MolecularNeurobiology/LOOPER/doc/source/Images/1_Frame/1_rod_holder_ex.png

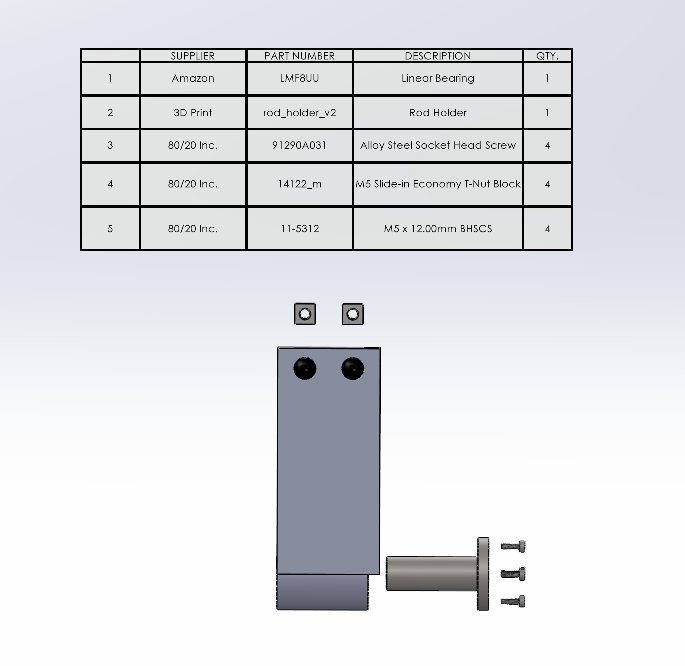
doc/source/Images/1_Frame/1_rod_holder_ex.png
