MolecularNeurobiology/LOOPER/doc/source/Images/1_Frame/2_28IN.png

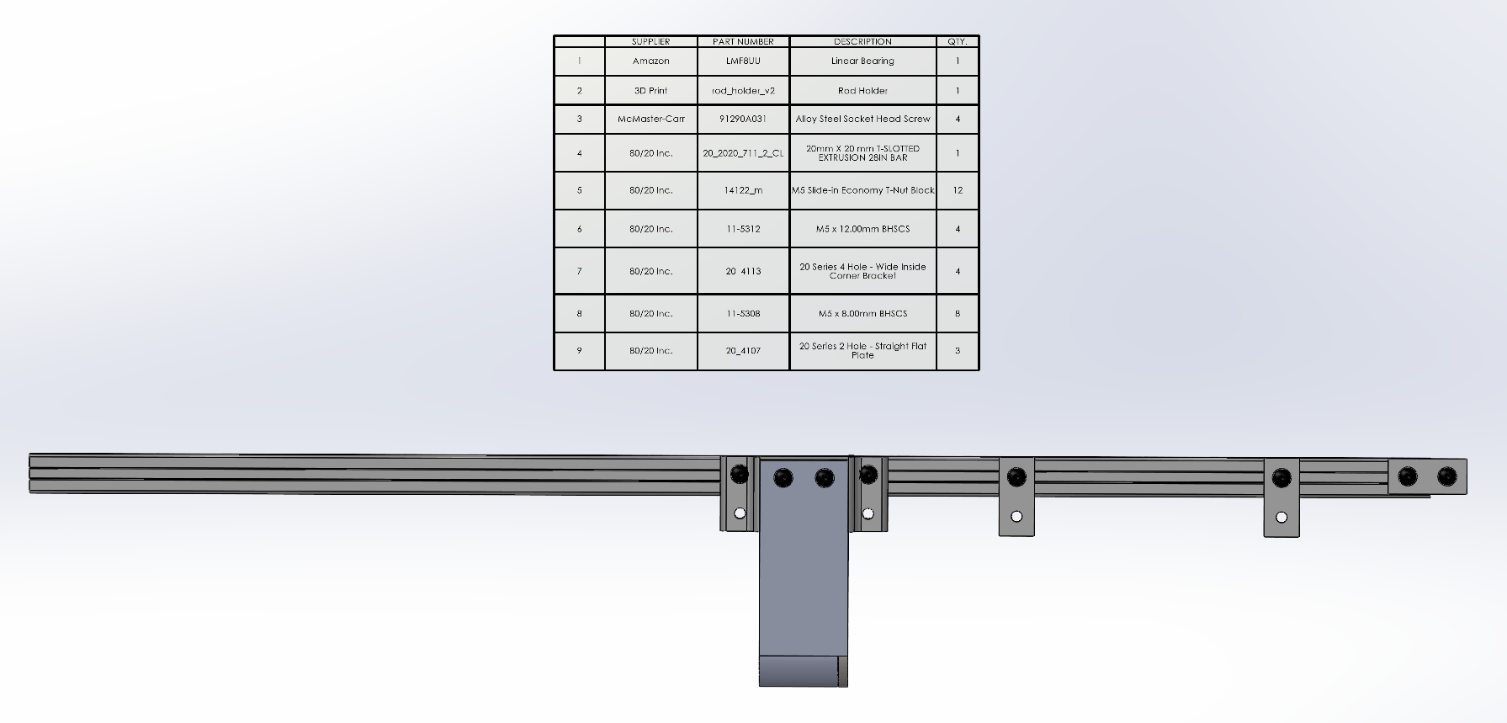
doc/source/Images/1_Frame/2_28IN.png
