MolecularNeurobiology/LOOPER/doc/source/Images/1_Frame/3_Completed_Rig_Technical_Drawing_14IN.PNG

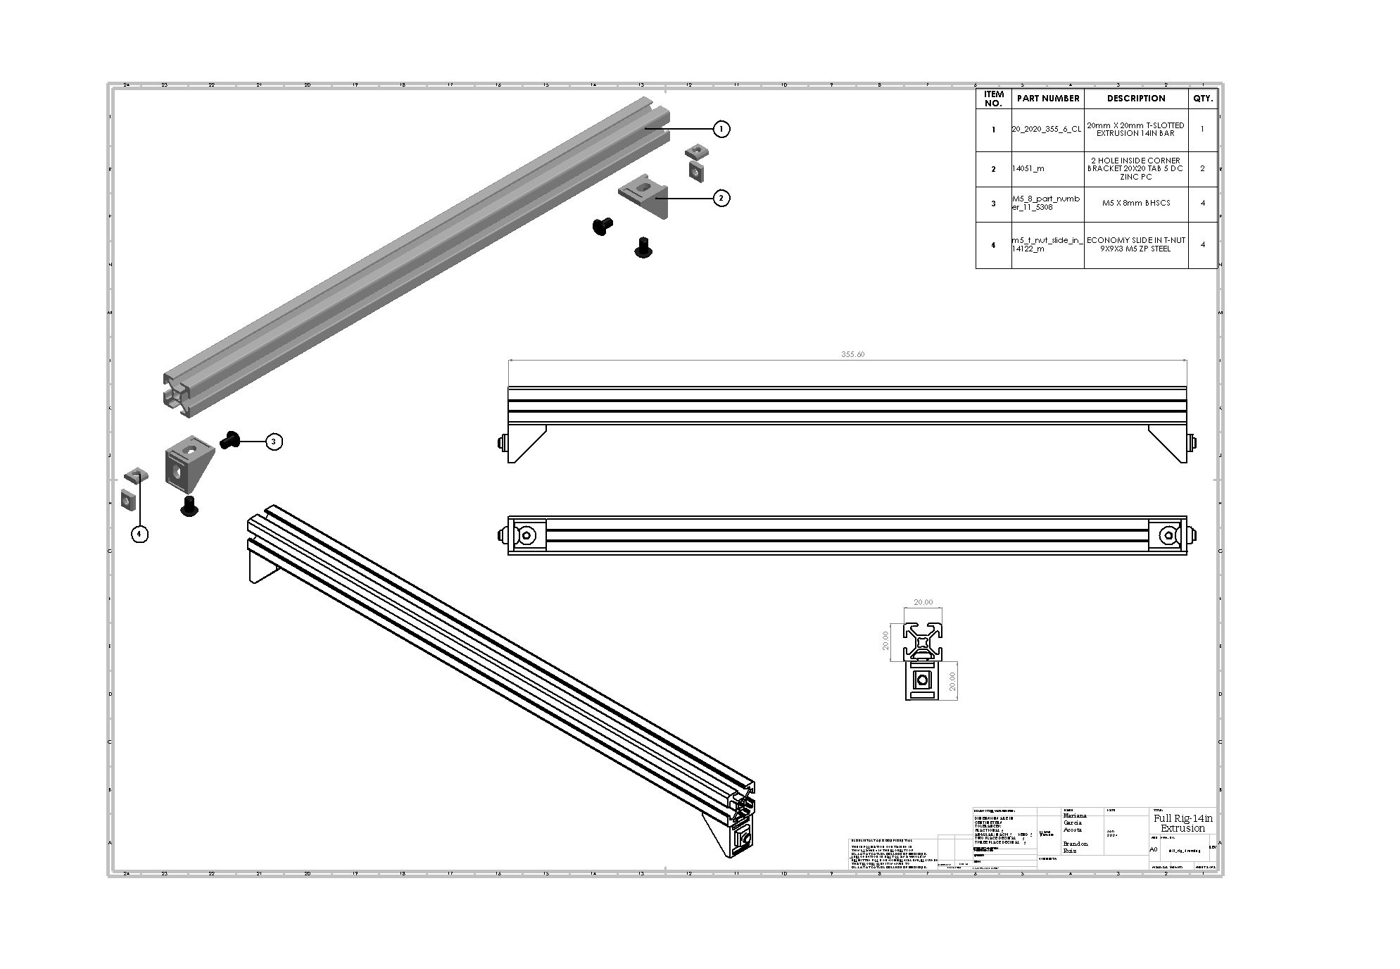
doc/source/Images/1_Frame/3_Completed_Rig_Technical_Drawing_14IN.PNG
