MolecularNeurobiology/LOOPER/doc/source/Images/1_Frame/5_Full_Rig_1_ex.png

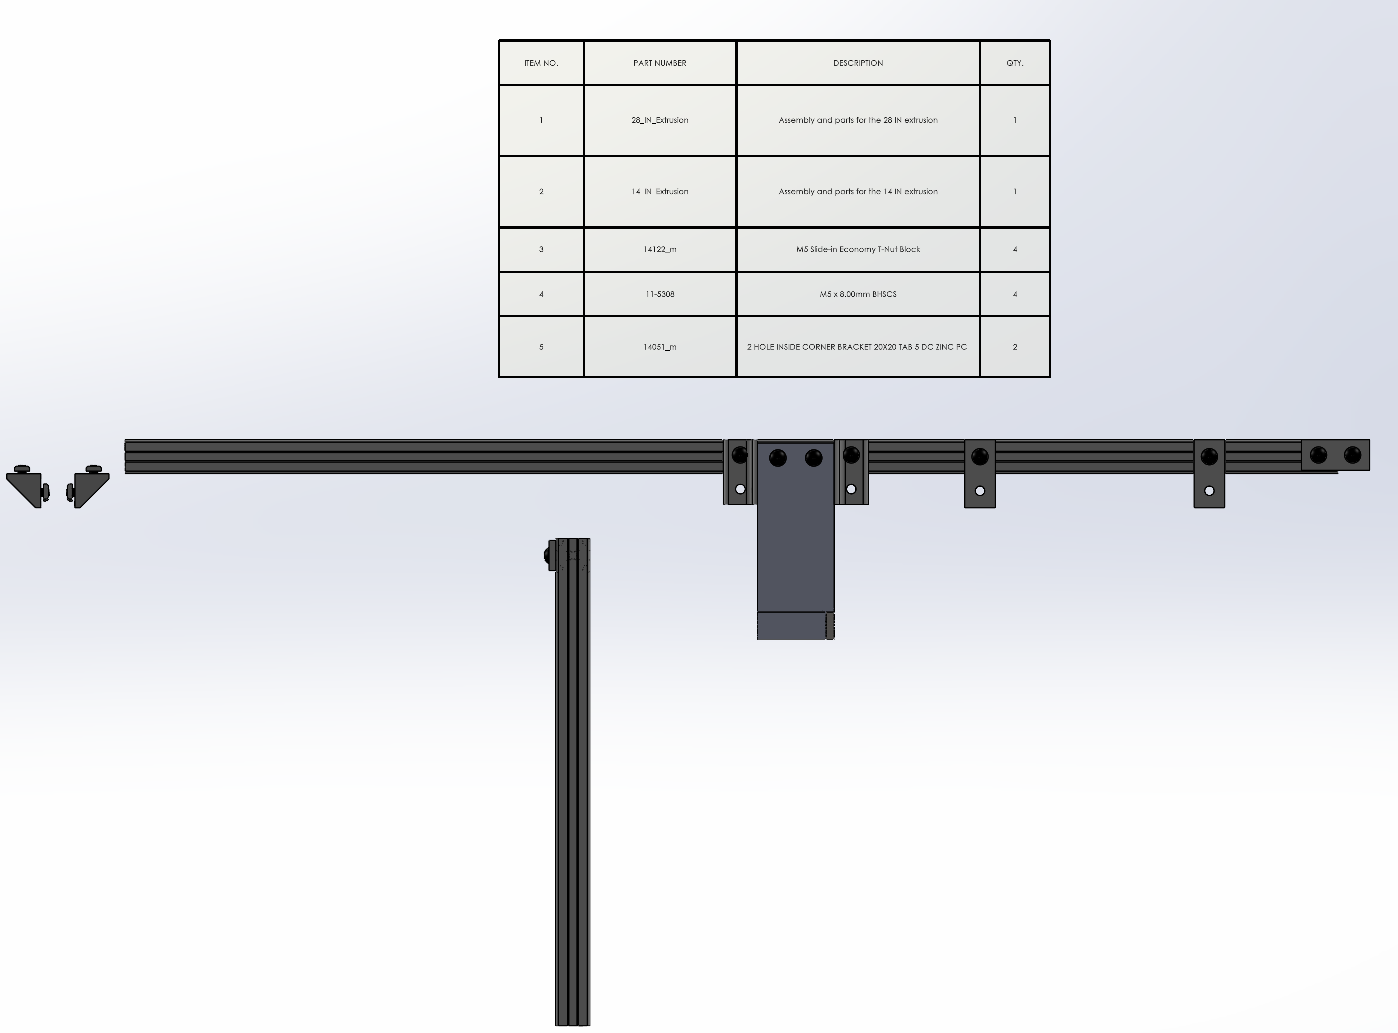
doc/source/Images/1_Frame/5_Full_Rig_1_ex.png
