MolecularNeurobiology/LOOPER/doc/source/Images/1_Frame/6_Full_Rig_2_ex.png

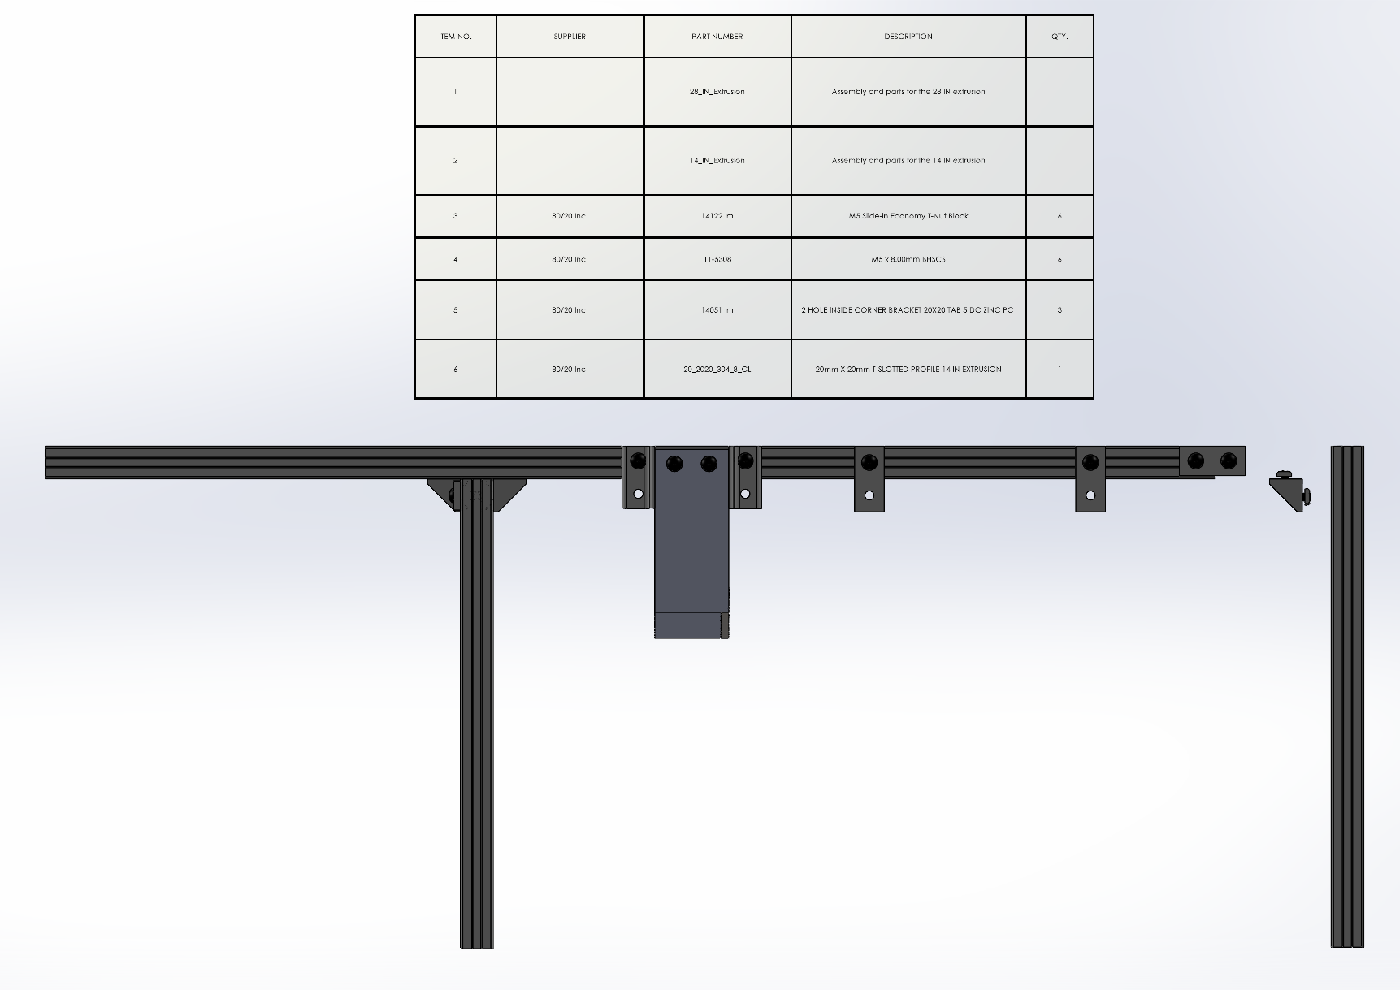
doc/source/Images/1_Frame/6_Full_Rig_2_ex.png
