MolecularNeurobiology/LOOPER/doc/source/Images/1_Full_Rig_2.png

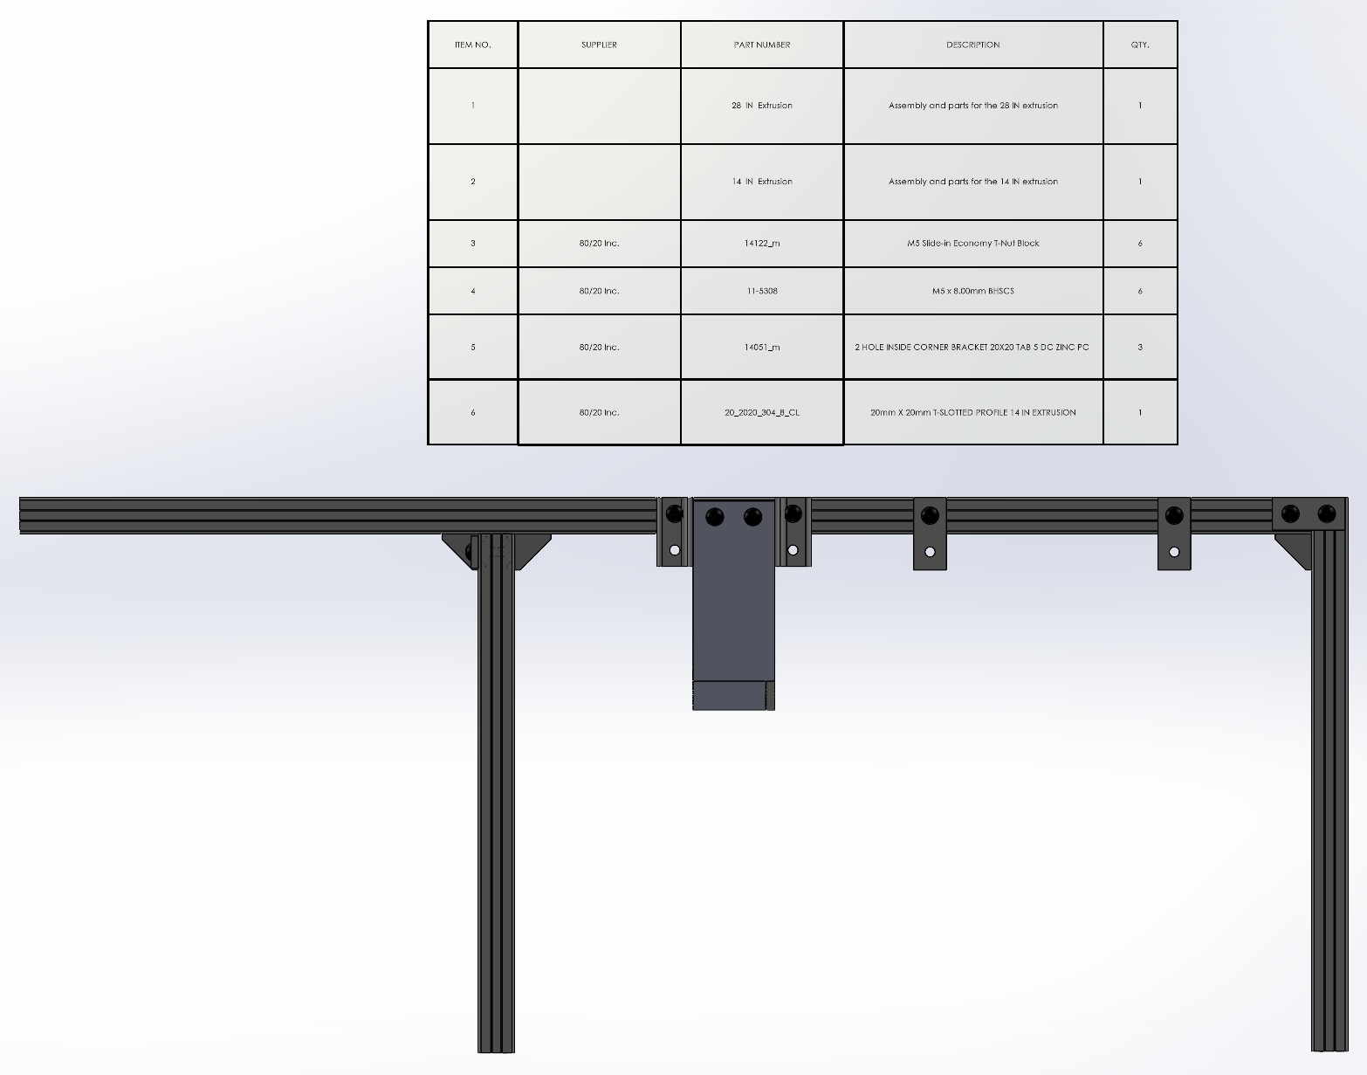
doc/source/Images/1_Full_Rig_2.png
