MolecularNeurobiology/LOOPER/doc/source/Images/2_StepperMotor/1_motor_mount.PNG

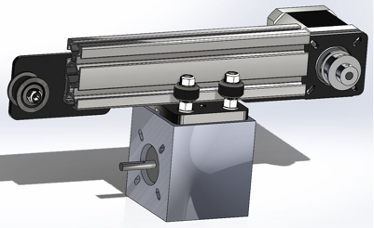
doc/source/Images/2_StepperMotor/1_motor_mount.PNG
