MolecularNeurobiology/LOOPER/doc/source/Images/2Full_Rig_3.png

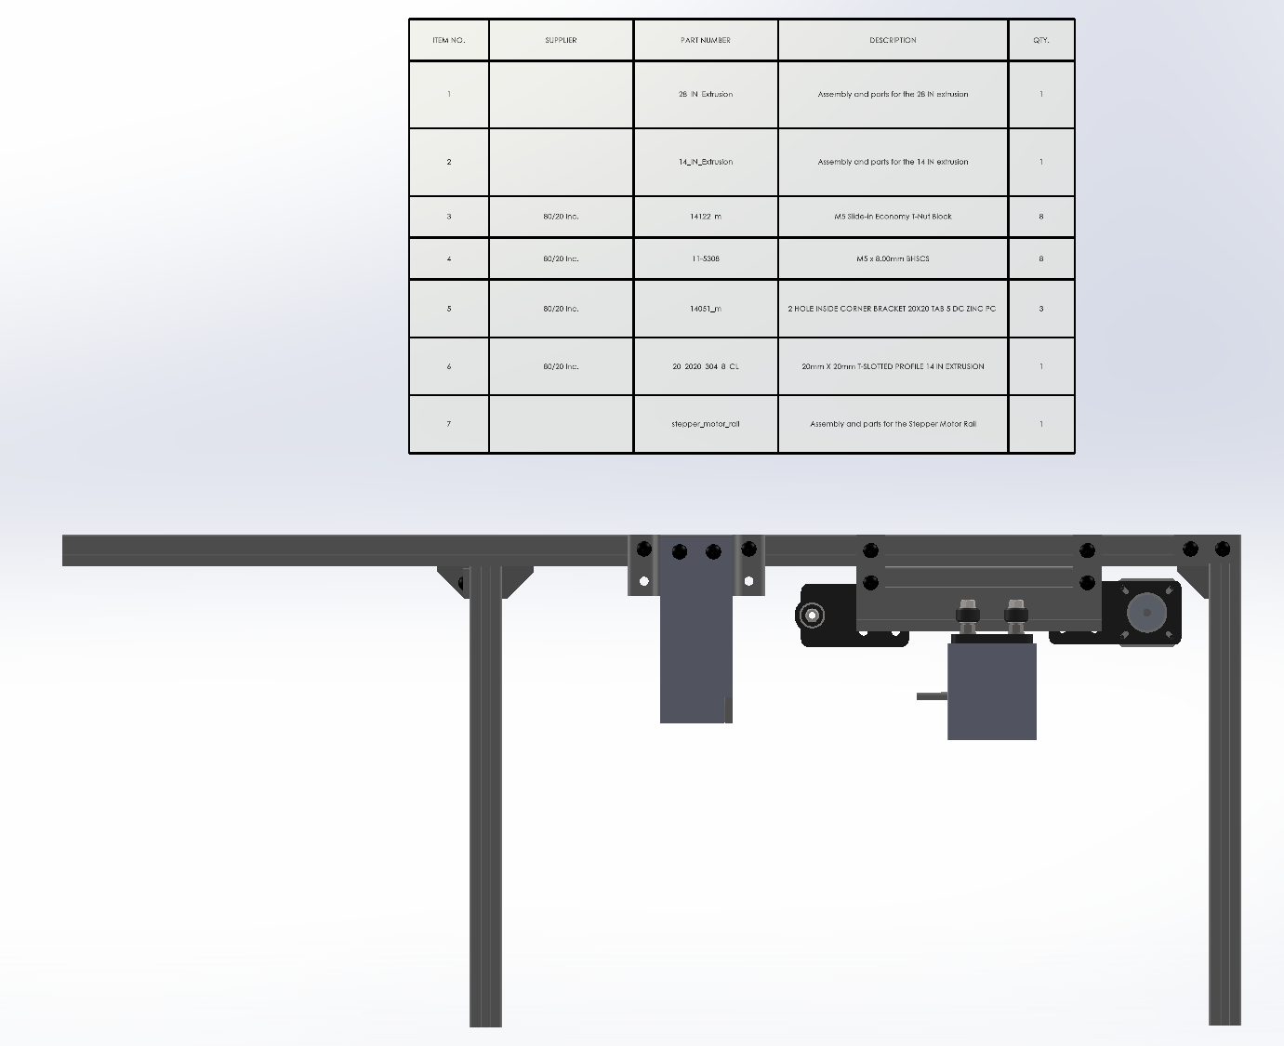
doc/source/Images/2Full_Rig_3.png
