MolecularNeurobiology/LOOPER/doc/source/Images/2Full_Rig_3_ex.png

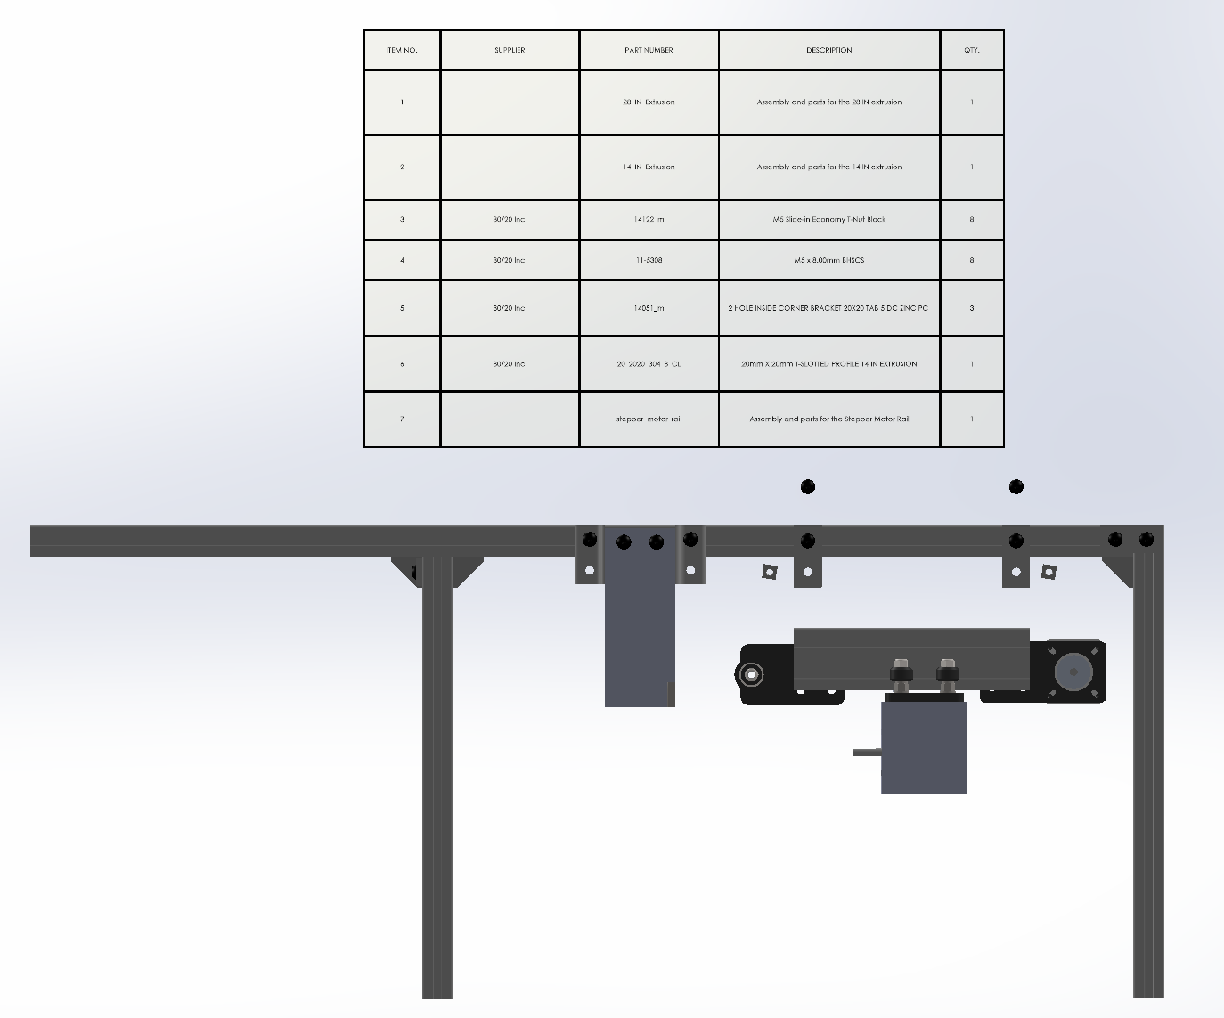
doc/source/Images/2Full_Rig_3_ex.png
