MolecularNeurobiology/LOOPER/doc/source/Images/3_SyringeHolder/1_1_syringe_holder_ex.PNG

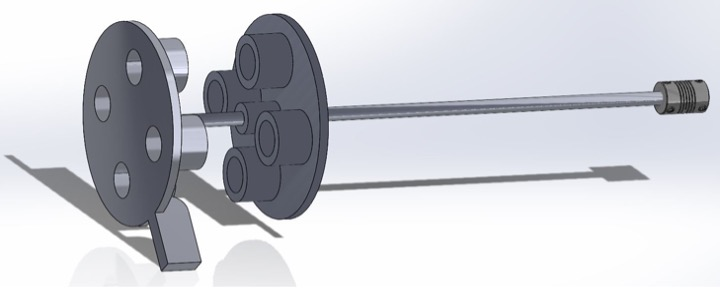
doc/source/Images/3_SyringeHolder/1_1_syringe_holder_ex.PNG
