MolecularNeurobiology/LOOPER/doc/source/Images/3_SyringeHolder/1_syringe_holder_ex.png

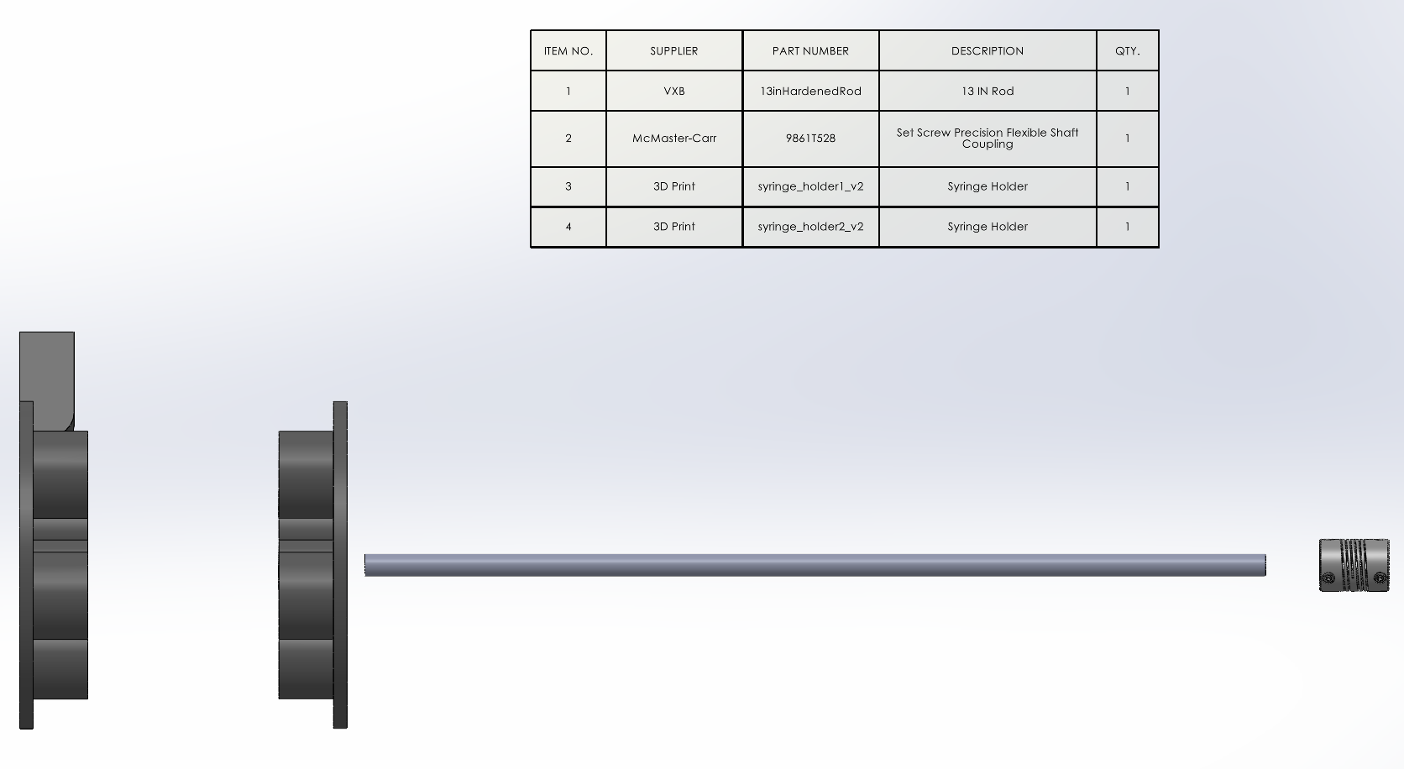
doc/source/Images/3_SyringeHolder/1_syringe_holder_ex.png
