MolecularNeurobiology/LOOPER/doc/source/Images/3_SyringeHolder/2_syringe_holder1_v2_drawing.PNG

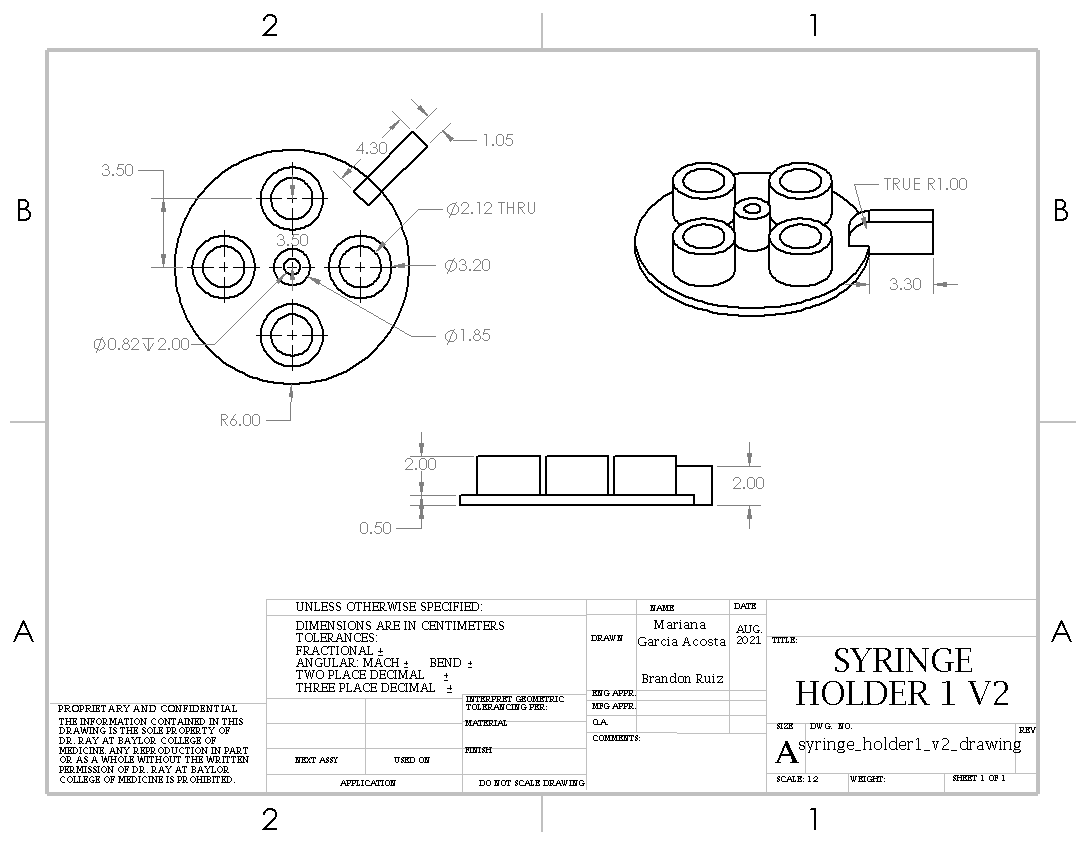
doc/source/Images/3_SyringeHolder/2_syringe_holder1_v2_drawing.PNG
