MolecularNeurobiology/LOOPER/doc/source/Images/3_SyringeHolder/syringe_holder1_drawing.PNG

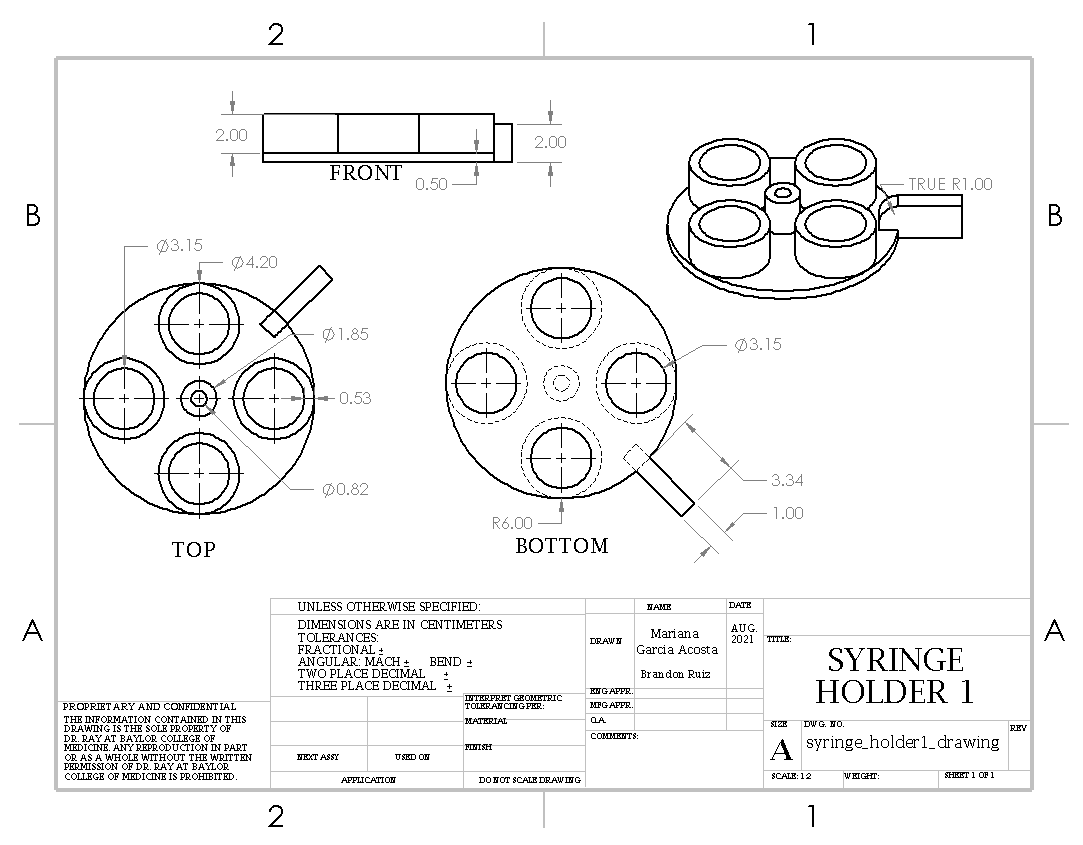
doc/source/Images/3_SyringeHolder/syringe_holder1_drawing.PNG
