MolecularNeurobiology/LOOPER/doc/source/Images/3_SyringeHolder/syringe_holder.png

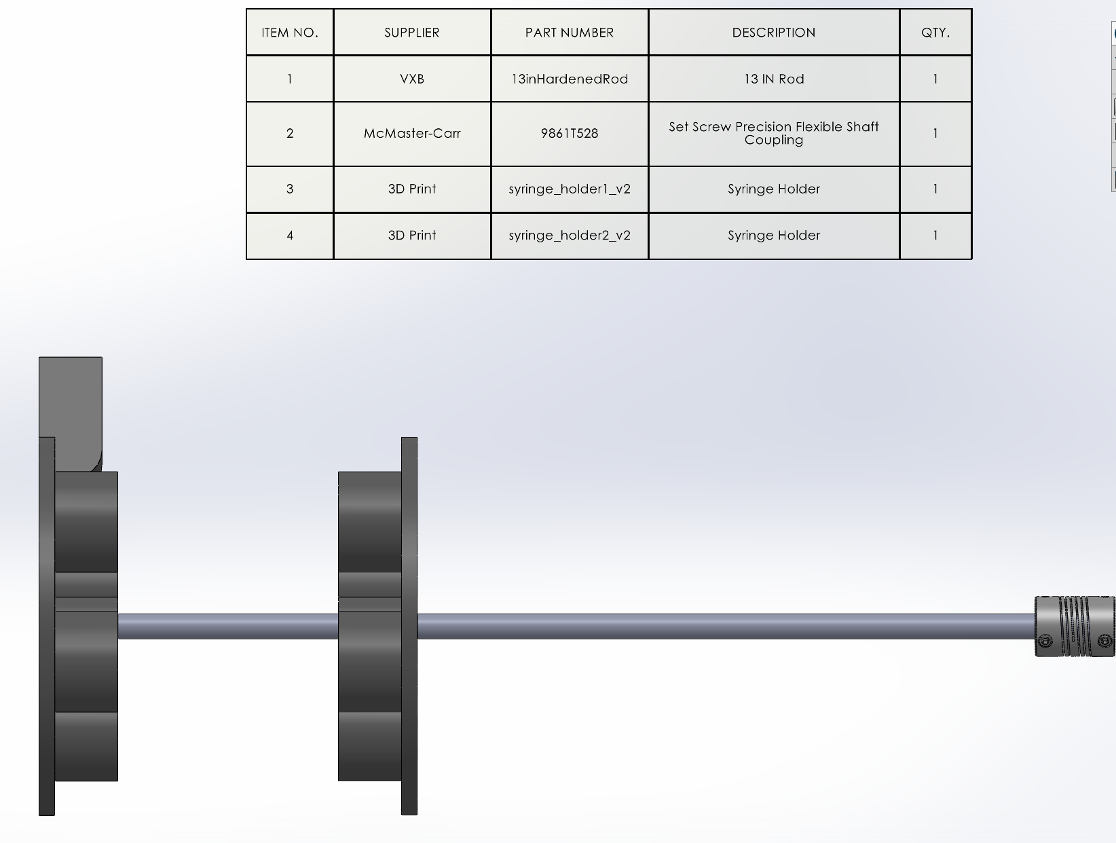
doc/source/Images/3_SyringeHolder/syringe_holder.png
