MolecularNeurobiology/LOOPER/doc/source/Images/3Full_Rig_6.PNG

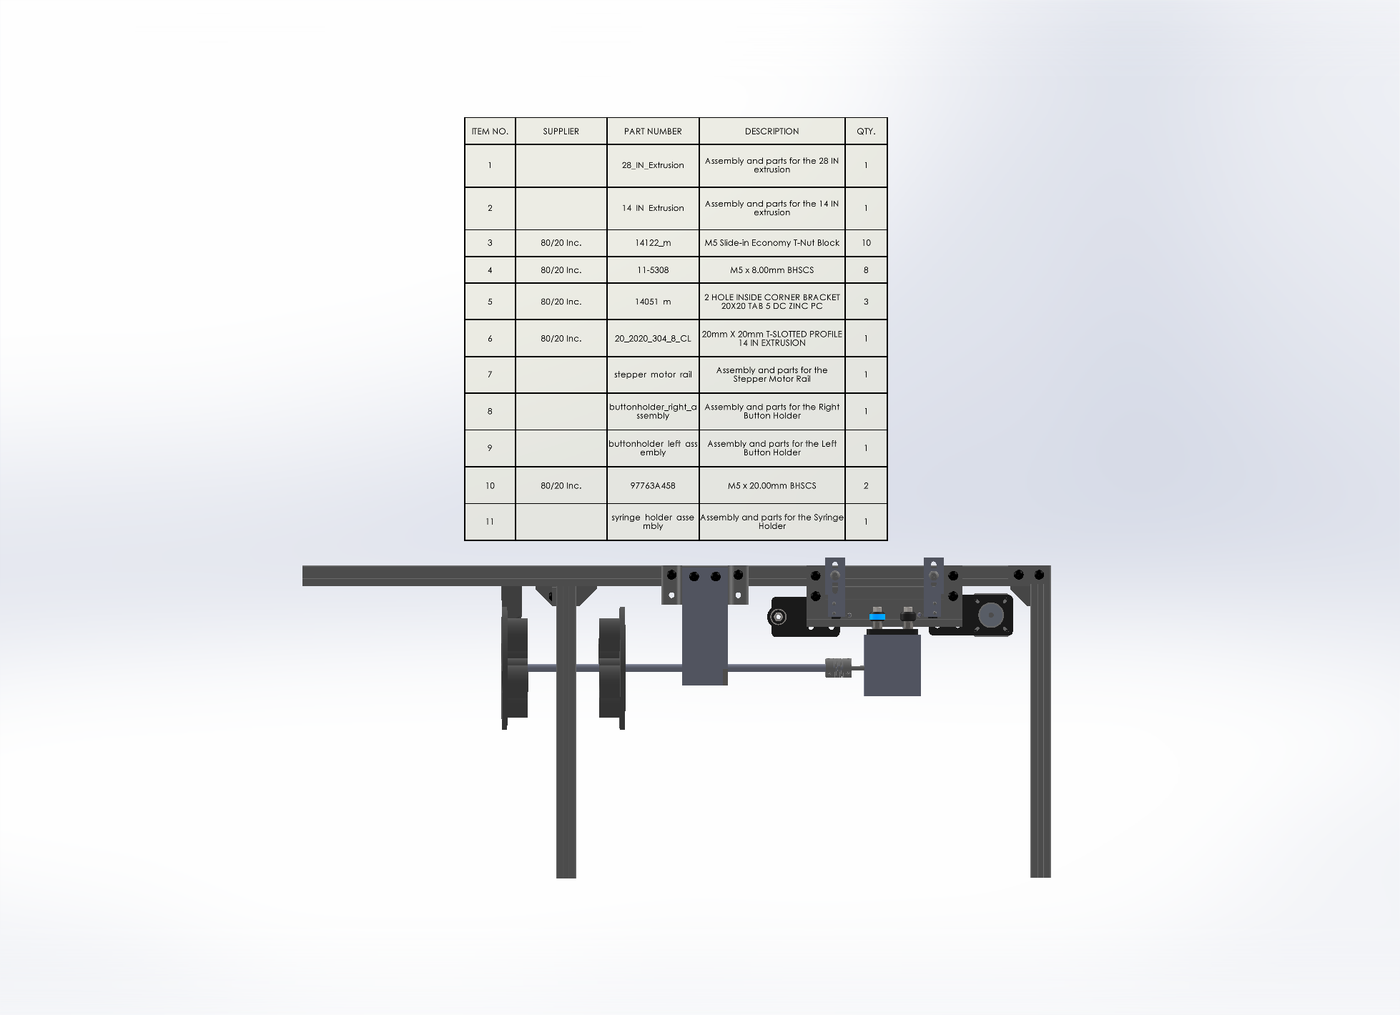
doc/source/Images/3Full_Rig_6.PNG
