MolecularNeurobiology/LOOPER/doc/source/Images/4_Valve_Rack/2_valve_mount_drawing.PNG

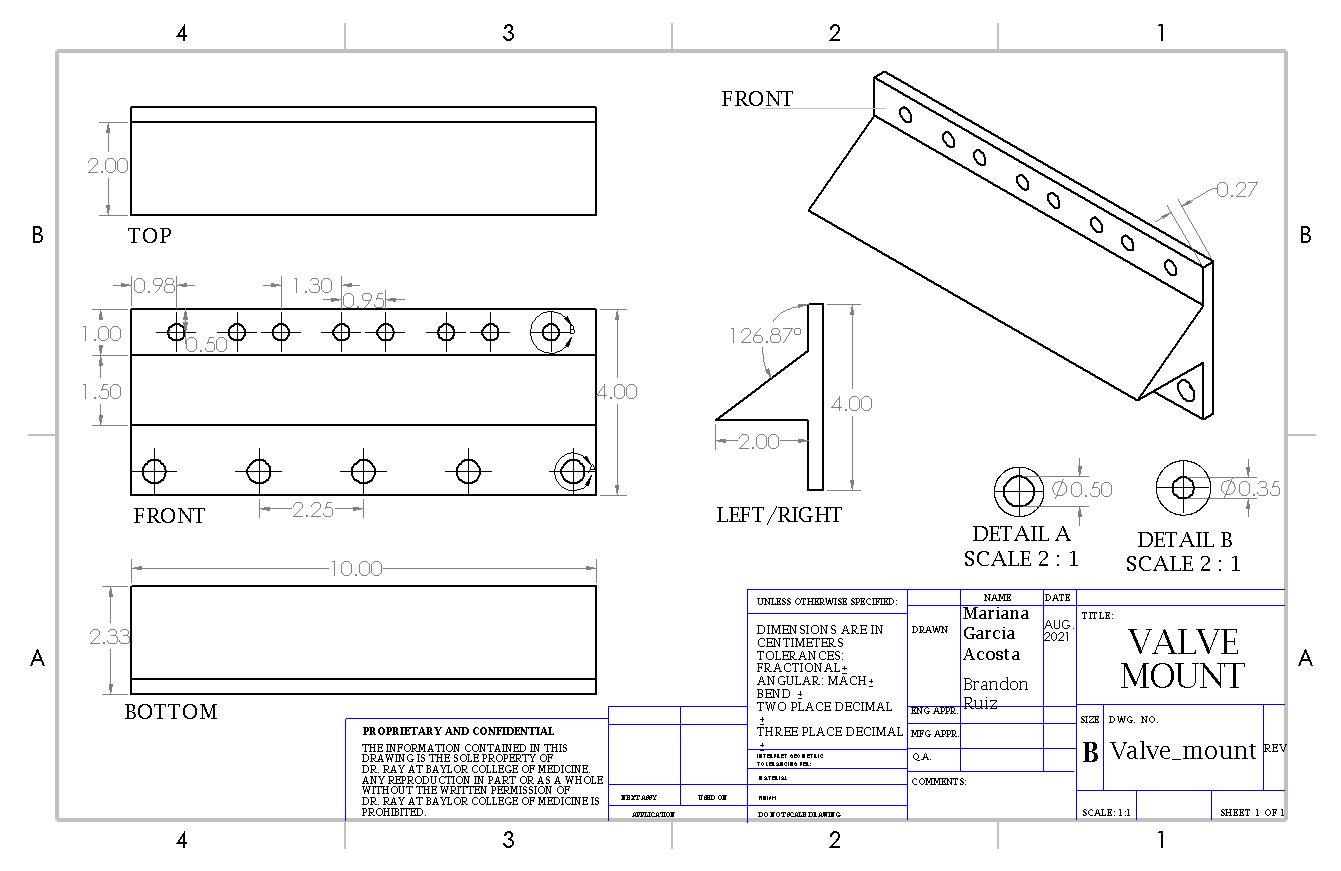
doc/source/Images/4_Valve_Rack/2_valve_mount_drawing.PNG
