MolecularNeurobiology/LOOPER/doc/source/Images/4_Valve_Rack/valve_rack.PNG

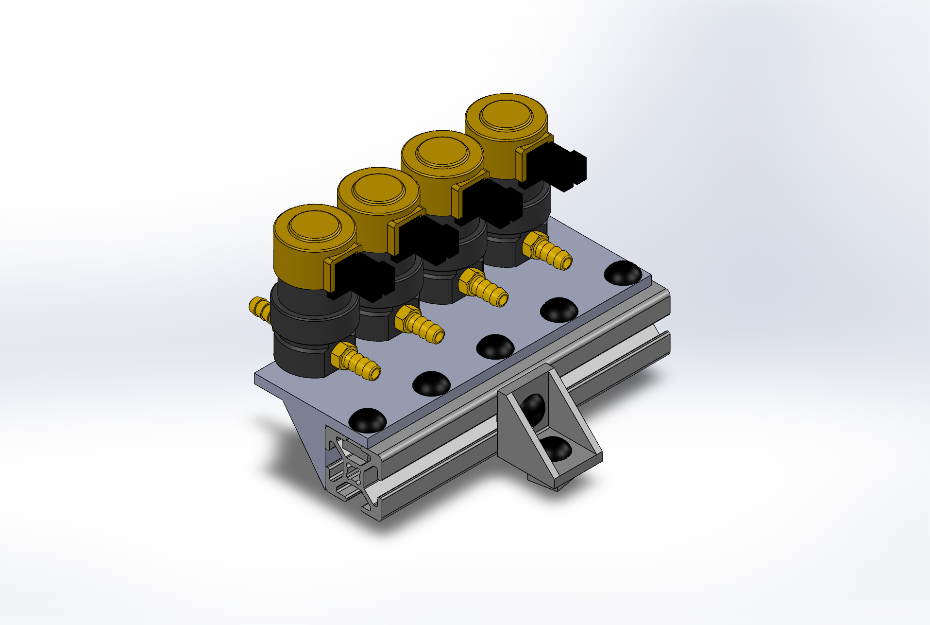
doc/source/Images/4_Valve_Rack/valve_rack.PNG
