MolecularNeurobiology/LOOPER/doc/source/Images/4Full_Rig_7.PNG

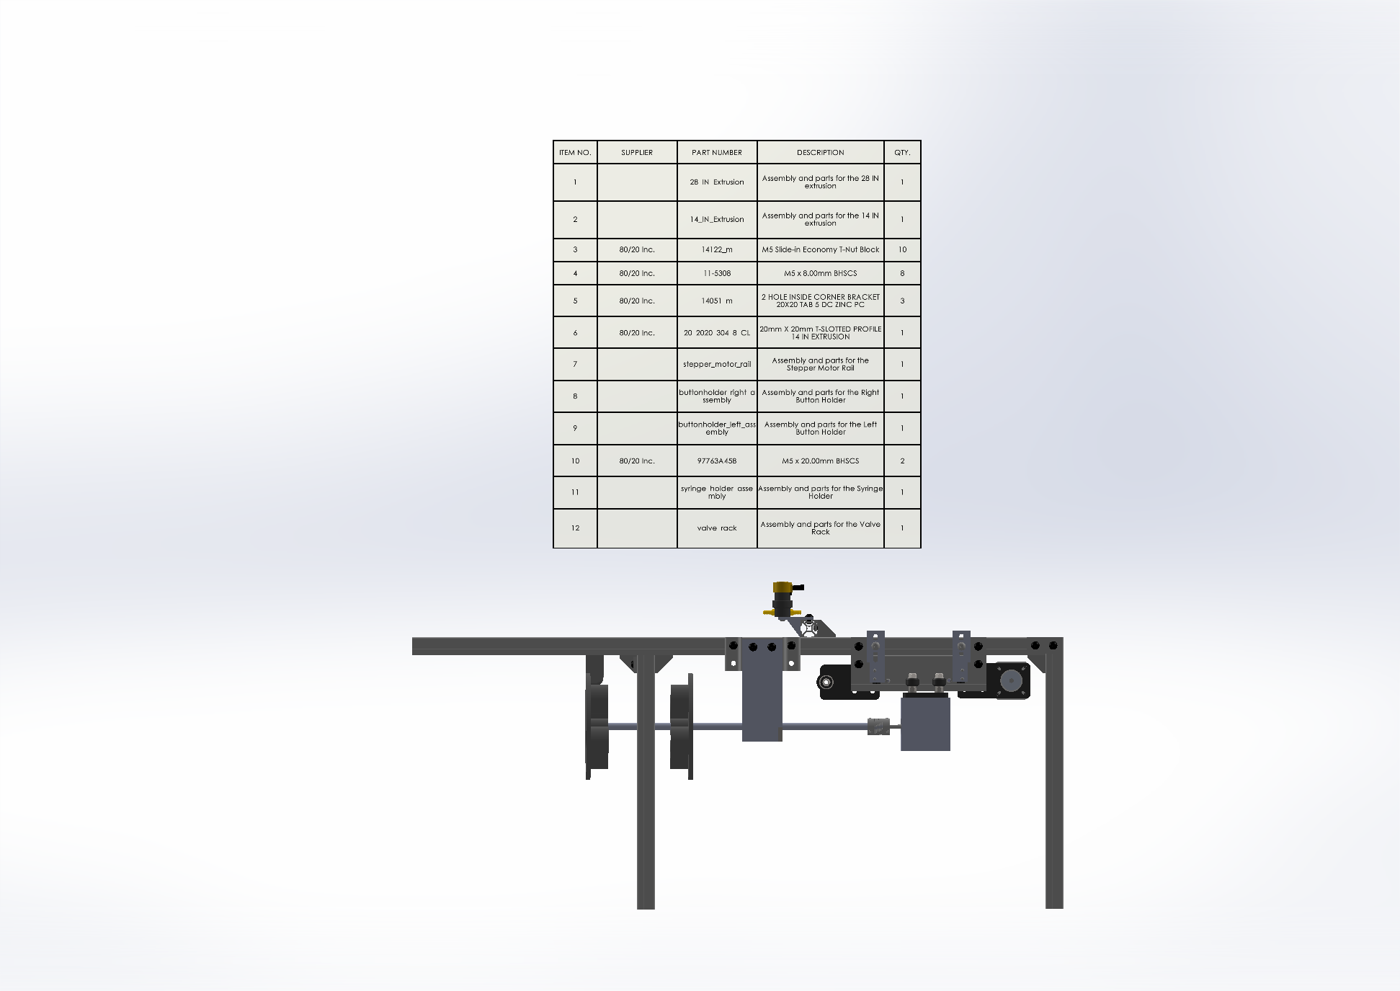
doc/source/Images/4Full_Rig_7.PNG
