MolecularNeurobiology/LOOPER/doc/source/Images/5_MouseHolder/mouseholder1_drawing.PNG

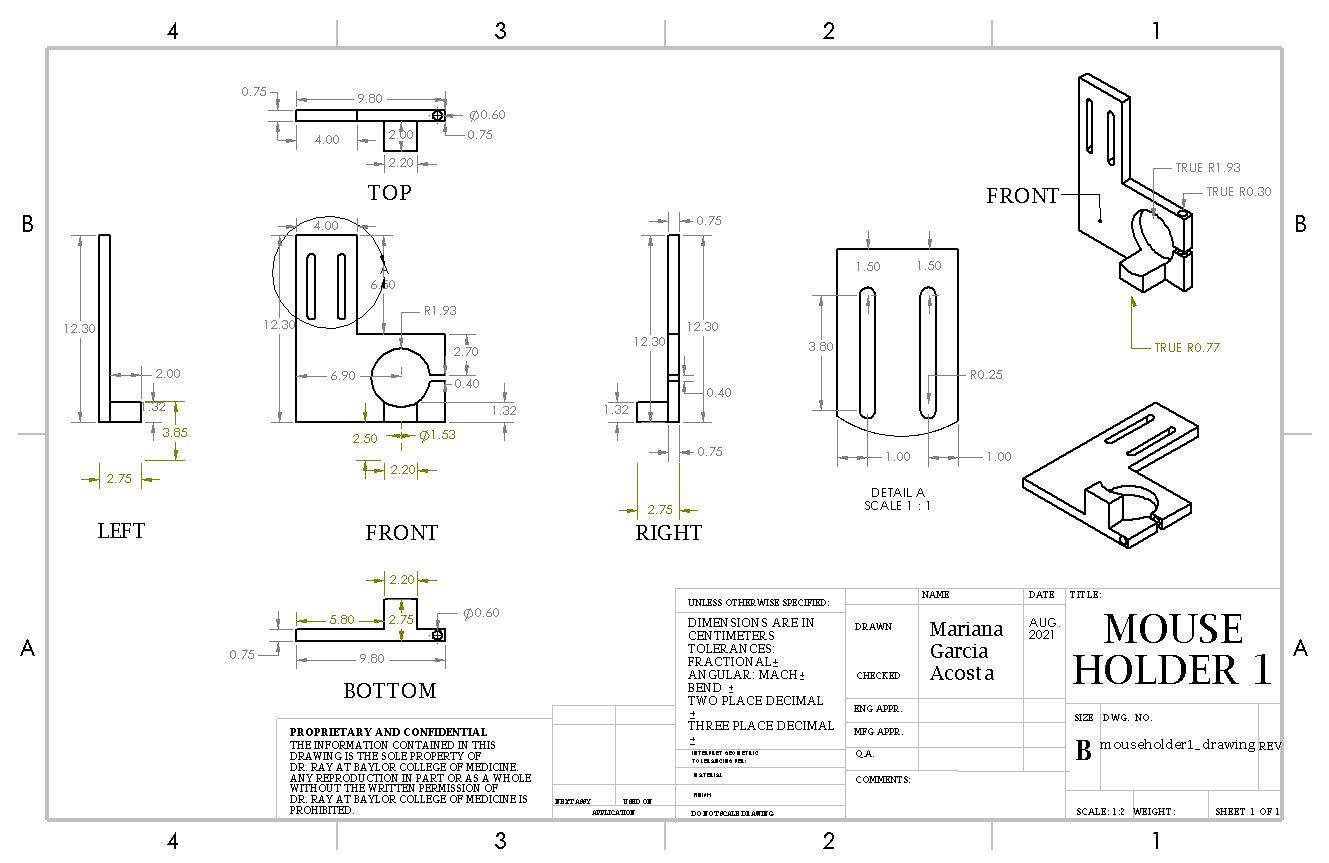
doc/source/Images/5_MouseHolder/mouseholder1_drawing.PNG
