MolecularNeurobiology/LOOPER/doc/source/Images/5_MouseHolder/mouseholder2_drawing.PNG

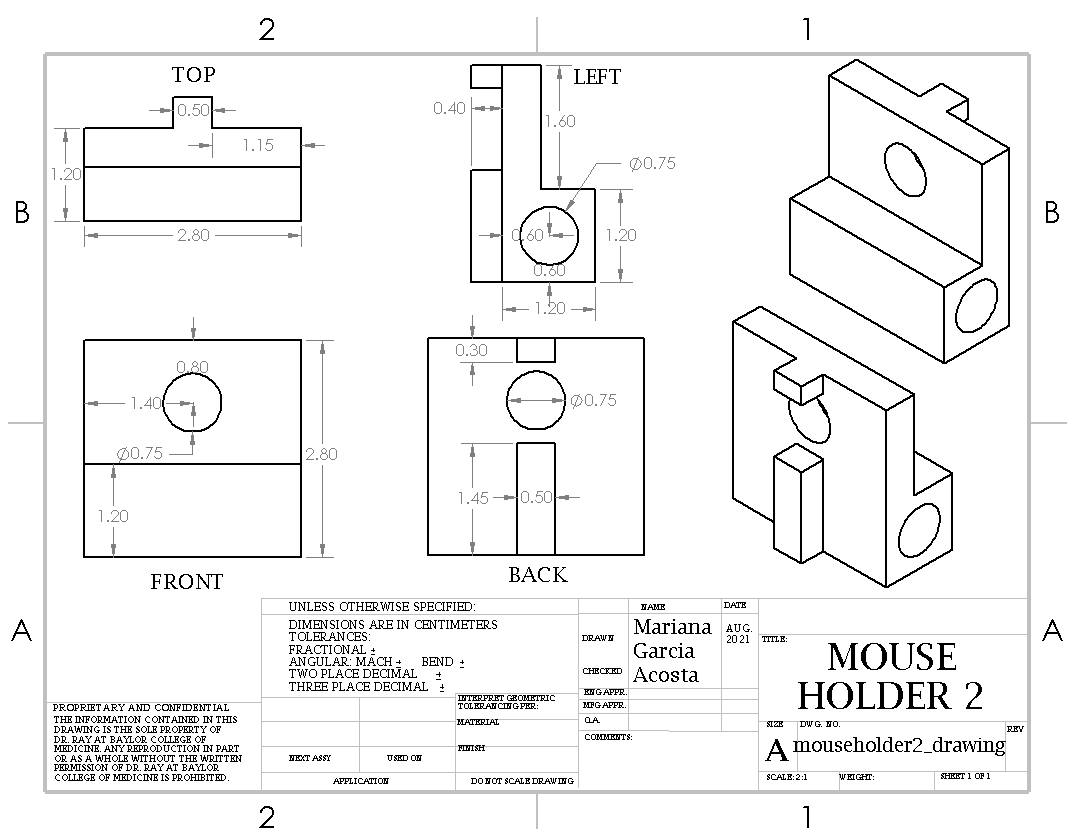
doc/source/Images/5_MouseHolder/mouseholder2_drawing.PNG
