MolecularNeurobiology/LOOPER/doc/source/Images/5_MouseHolder/mouseholder3_drawing.PNG

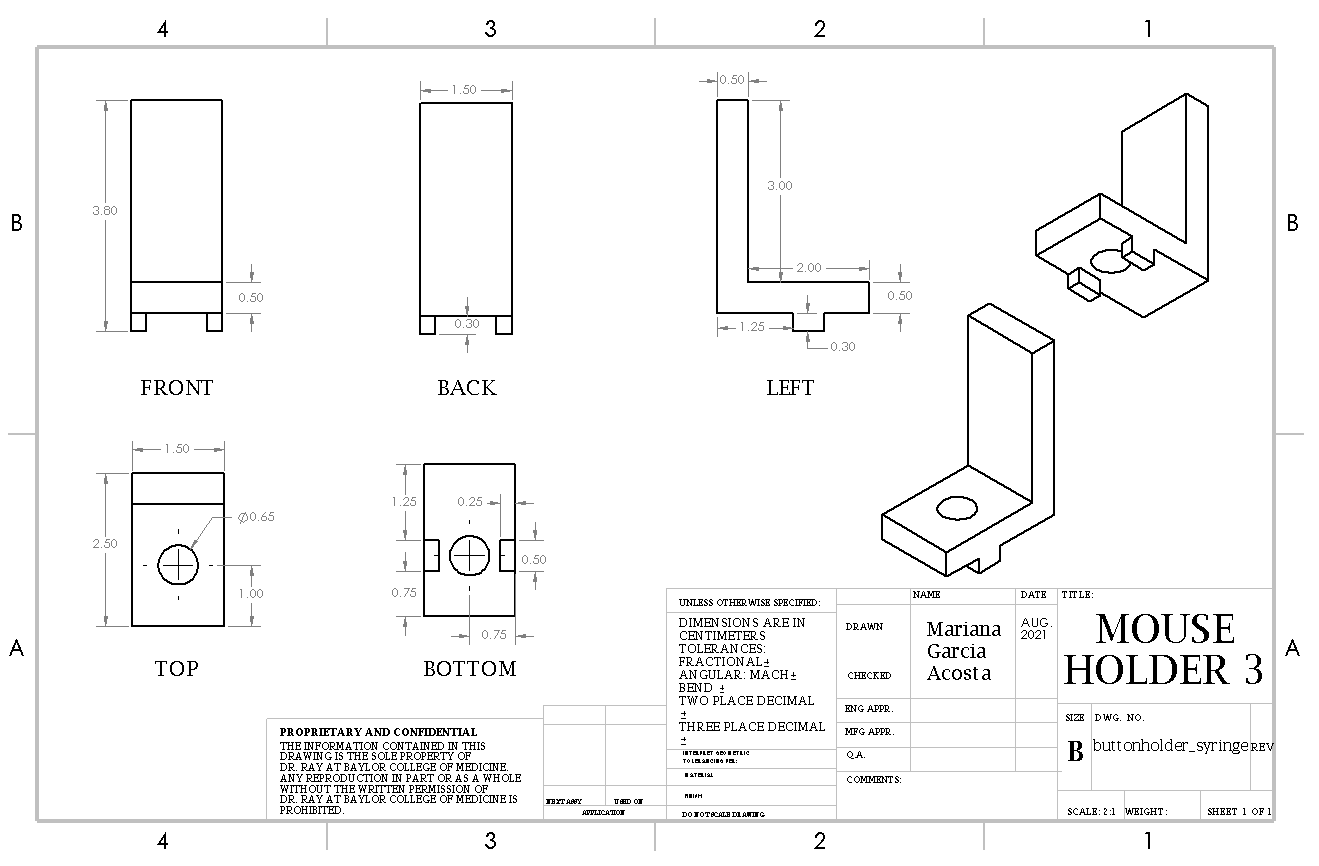
doc/source/Images/5_MouseHolder/mouseholder3_drawing.PNG
