MolecularNeurobiology/LOOPER/doc/source/Images/5_MouseHolder/mouseholder4_drawing.PNG

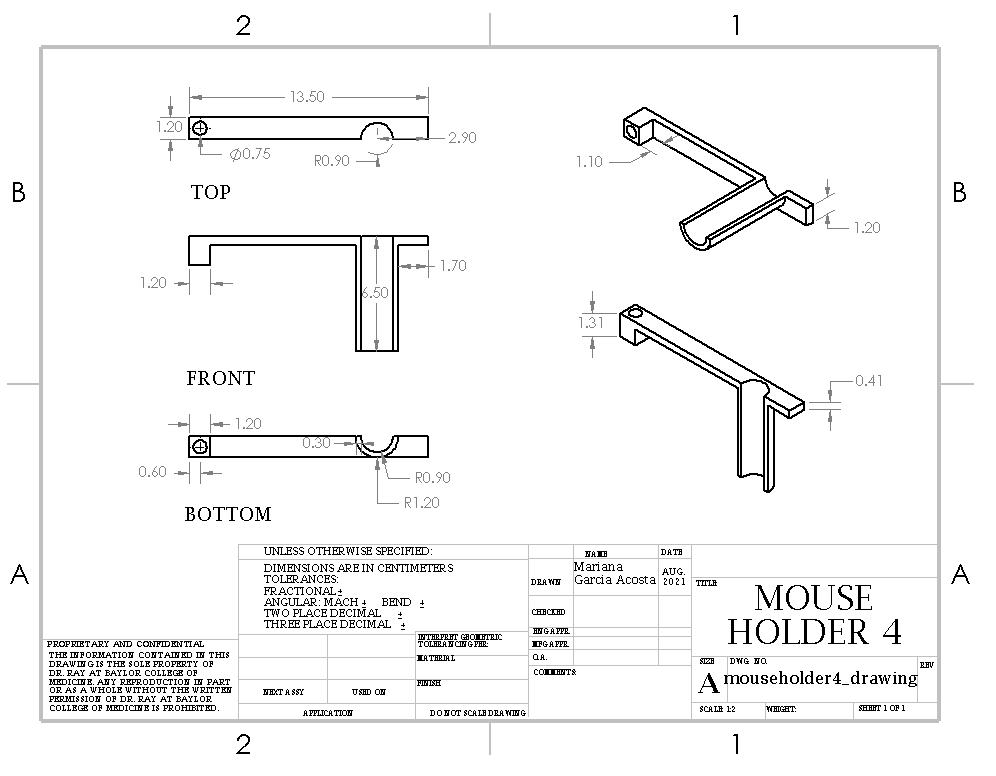
doc/source/Images/5_MouseHolder/mouseholder4_drawing.PNG
