MolecularNeurobiology/LOOPER/doc/source/Images/5_MouseHolder/rod_support_drawing.PNG

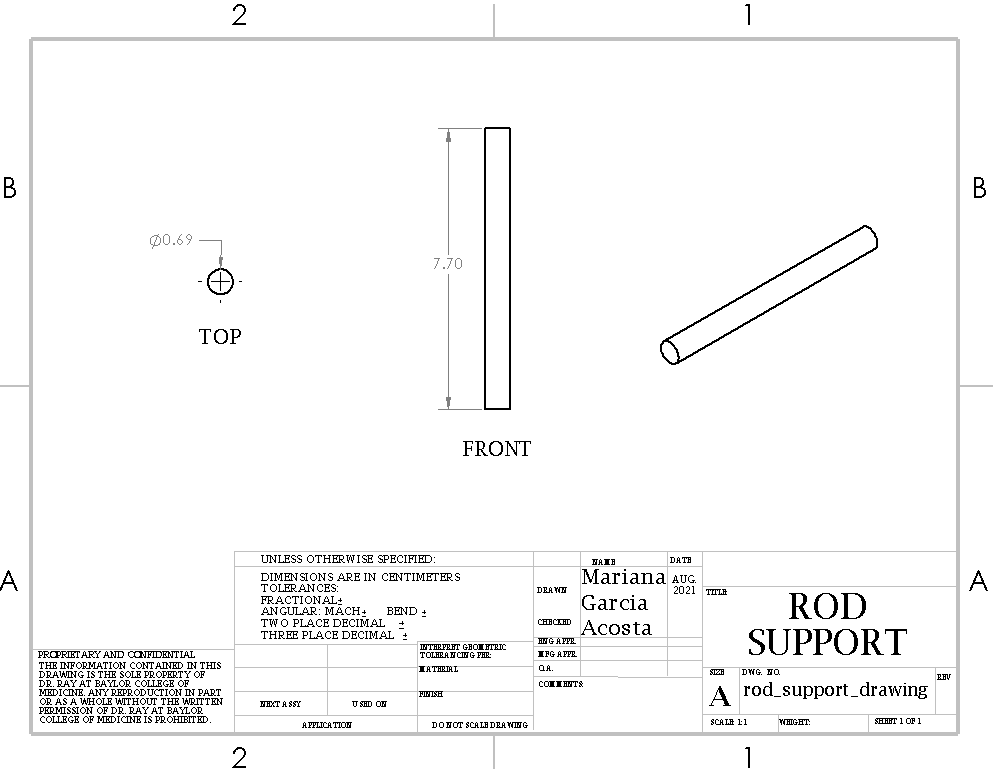
doc/source/Images/5_MouseHolder/rod_support_drawing.PNG
