MolecularNeurobiology/LOOPER/doc/source/Images/7_Button_Holder/2_Button_Holder_Left_ex.png

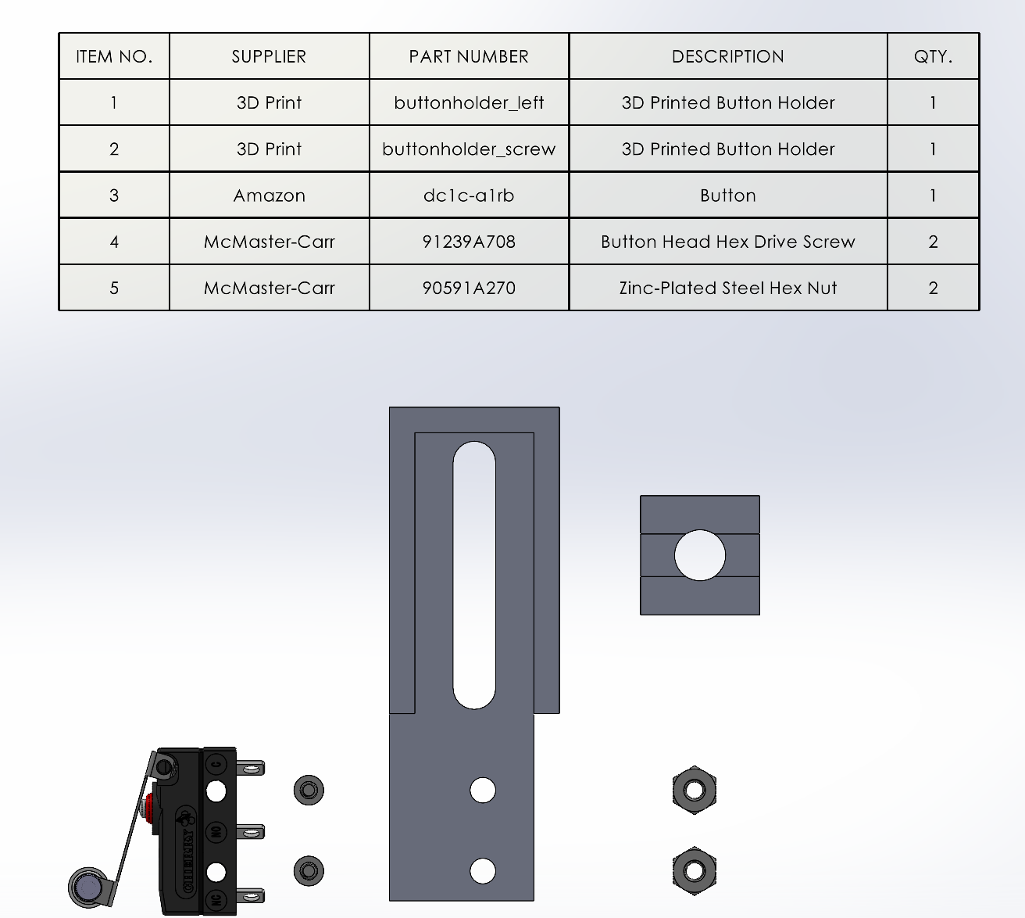
doc/source/Images/7_Button_Holder/2_Button_Holder_Left_ex.png
