MolecularNeurobiology/LOOPER/doc/source/Images/7_Button_Holder/3_Button_Holder_Left.png

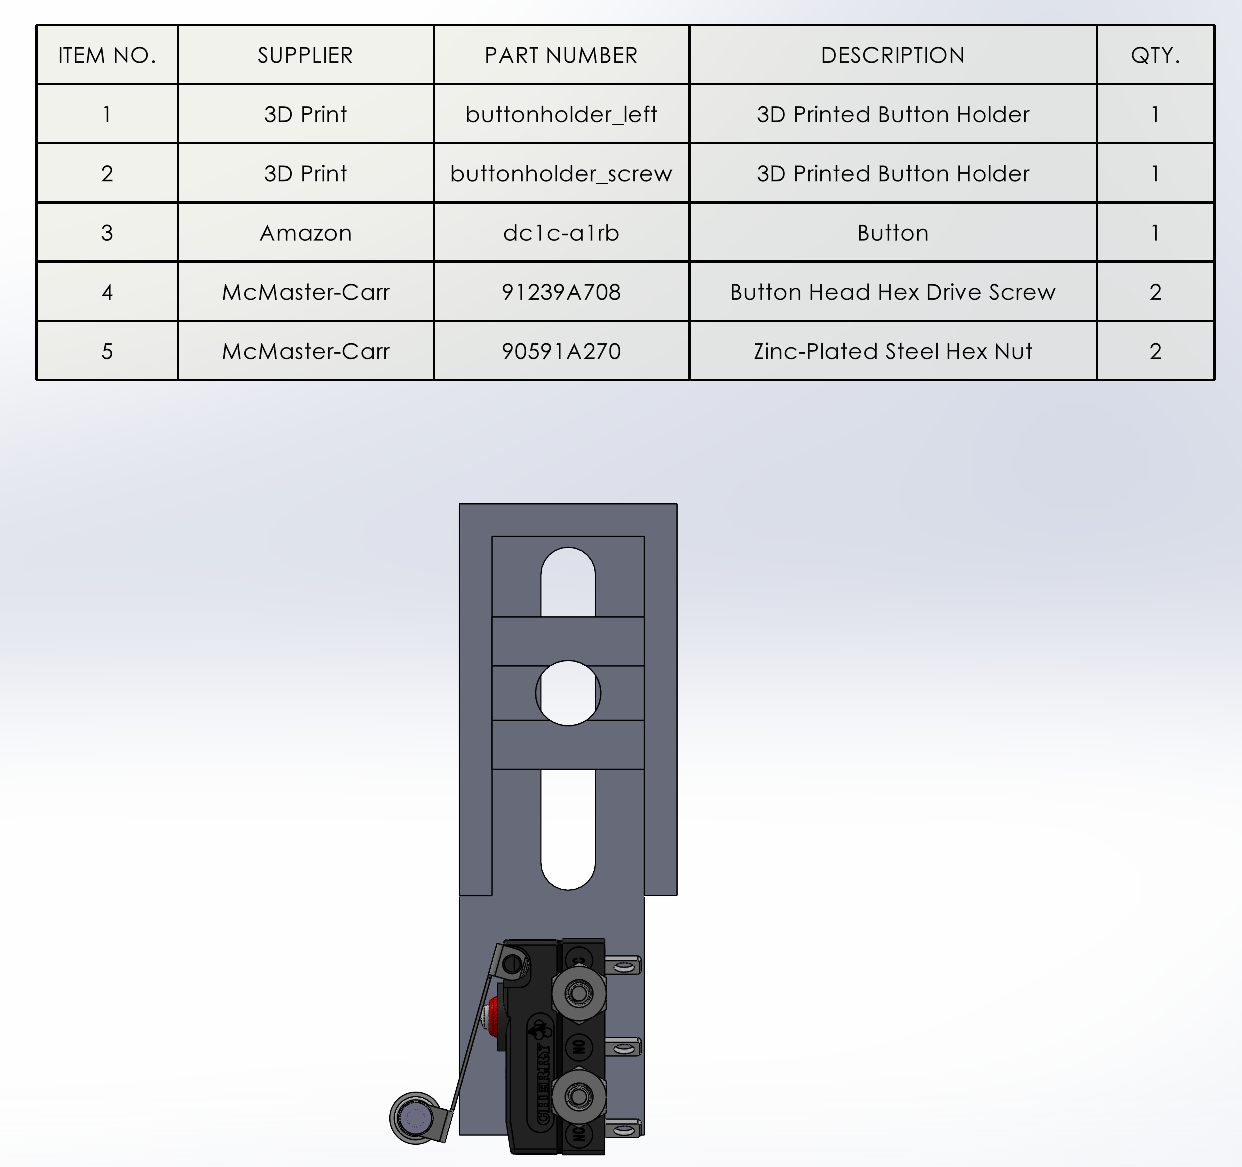
doc/source/Images/7_Button_Holder/3_Button_Holder_Left.png
