MolecularNeurobiology/LOOPER/doc/source/Images/7_Button_Holder/4_buttonholder_left_drawing.PNG

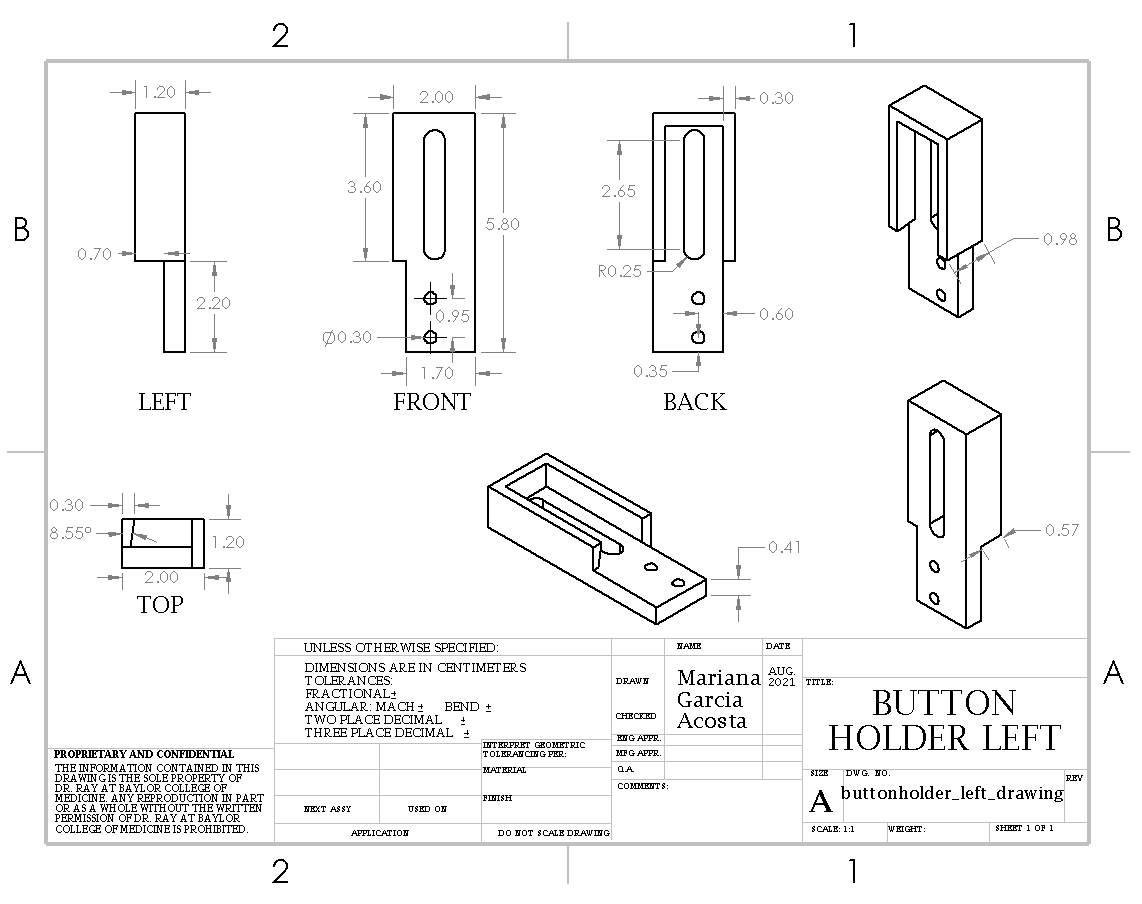
doc/source/Images/7_Button_Holder/4_buttonholder_left_drawing.PNG
