MolecularNeurobiology/LOOPER/doc/source/Images/7_Button_Holder/buttonholder_screw_drawing.PNG

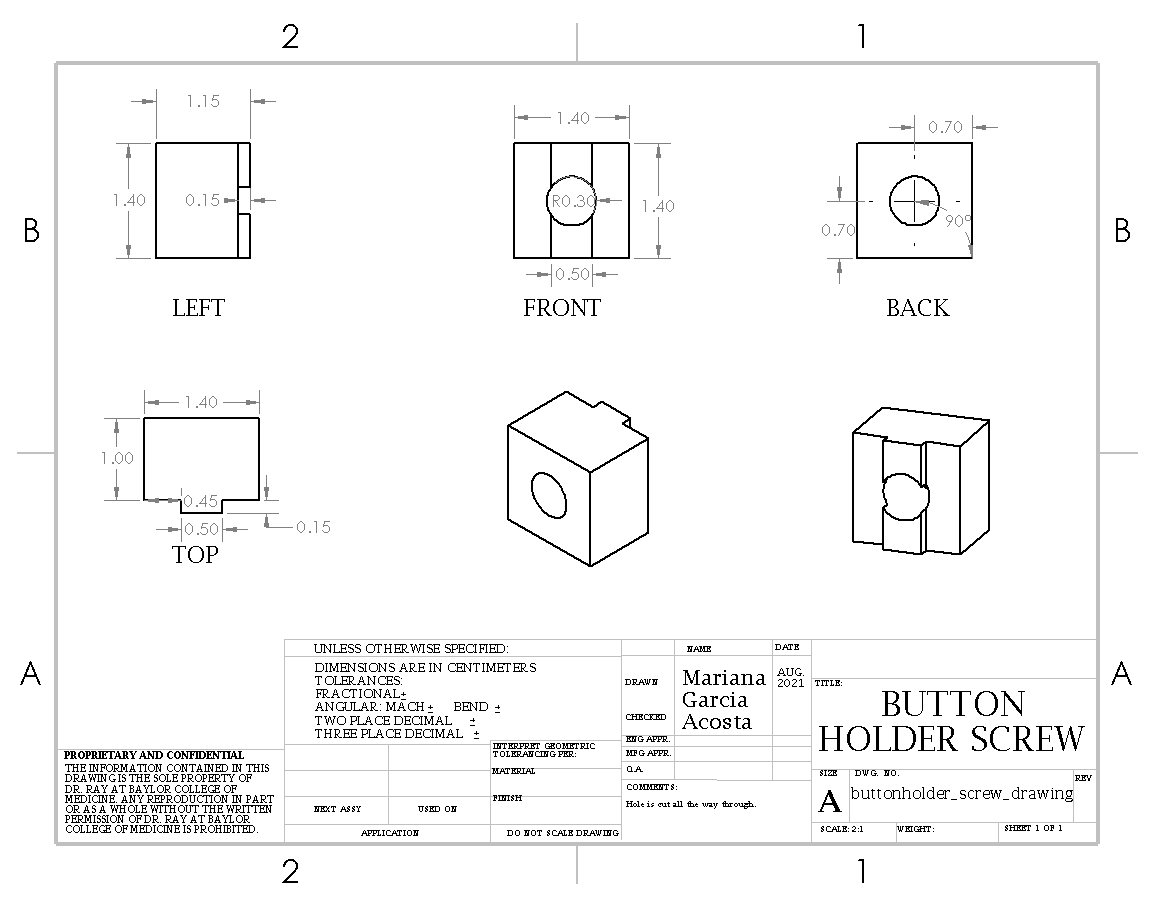
doc/source/Images/7_Button_Holder/buttonholder_screw_drawing.PNG
