MolecularNeurobiology/LOOPER/doc/source/Images/7Full_Rig_4.PNG

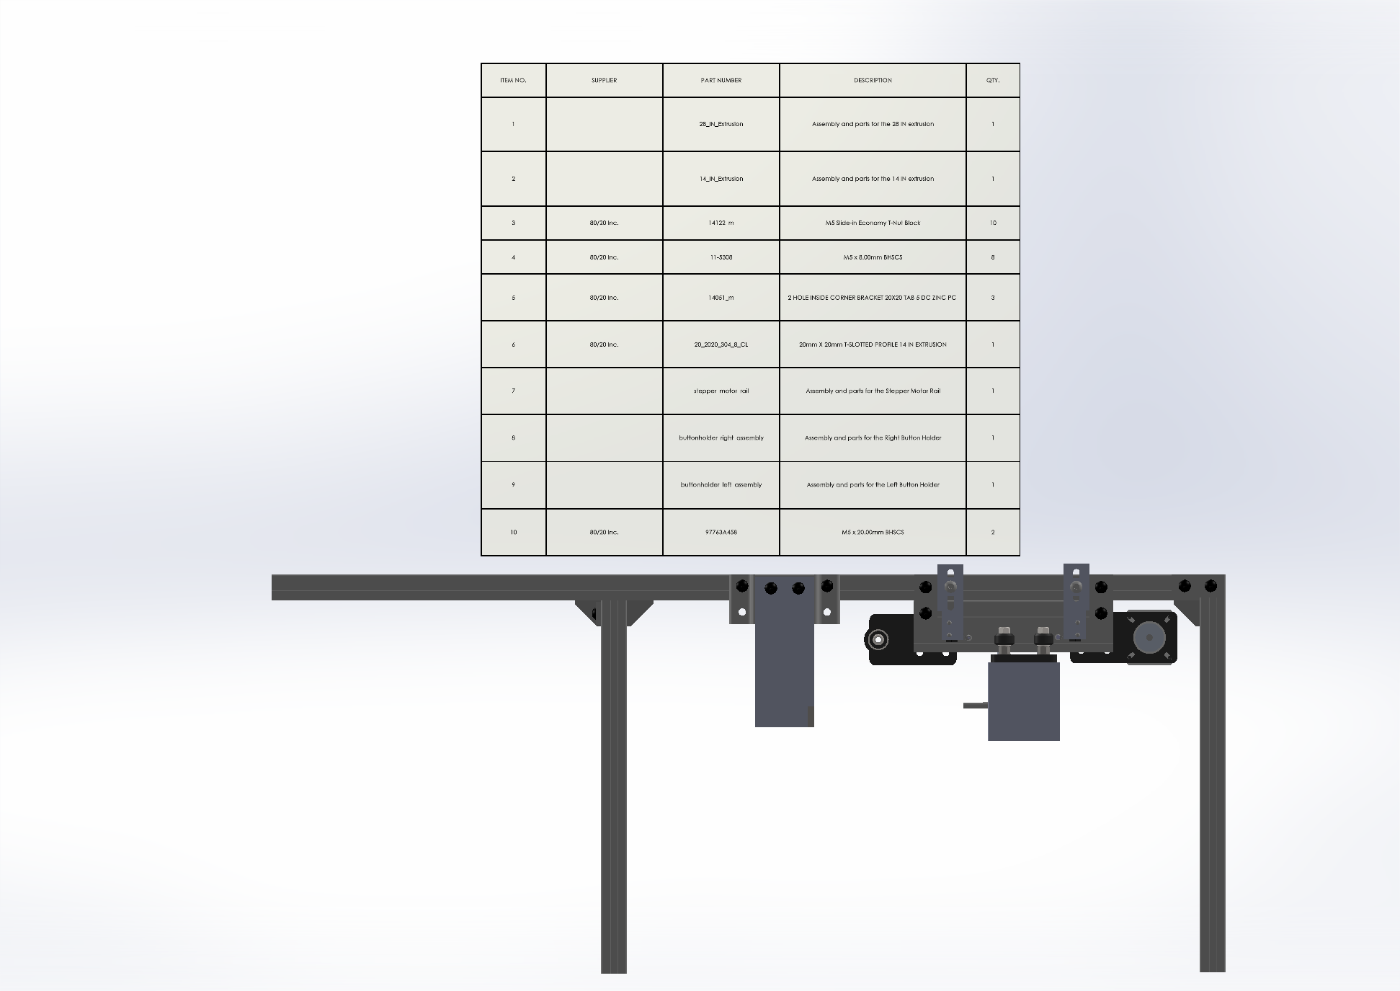
doc/source/Images/7Full_Rig_4.PNG
