MolecularNeurobiology/LOOPER/doc/source/Images/8_Water_Bath_Holder/ecg_clip_document.PNG

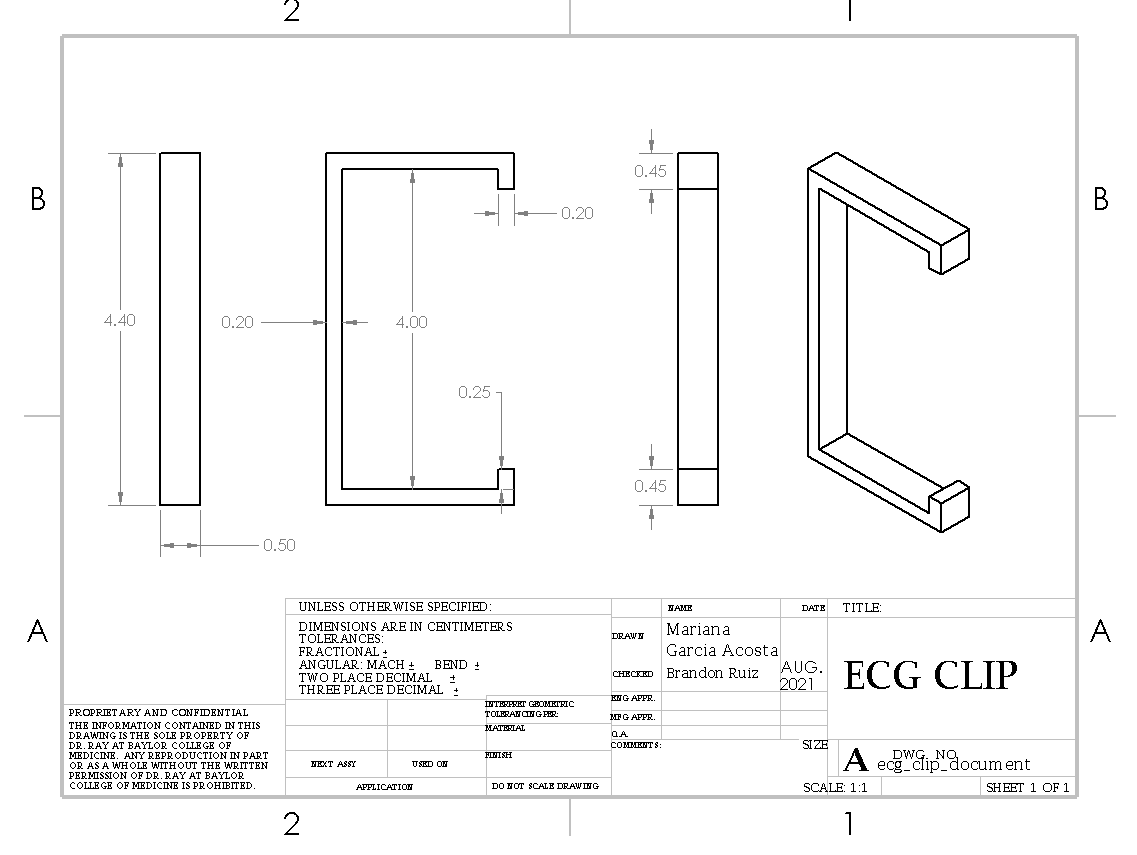
doc/source/Images/8_Water_Bath_Holder/ecg_clip_document.PNG
