MolecularNeurobiology/LOOPER/doc/source/Images/8_Water_Bath_Holder/ECG_holder_drawing.PNG

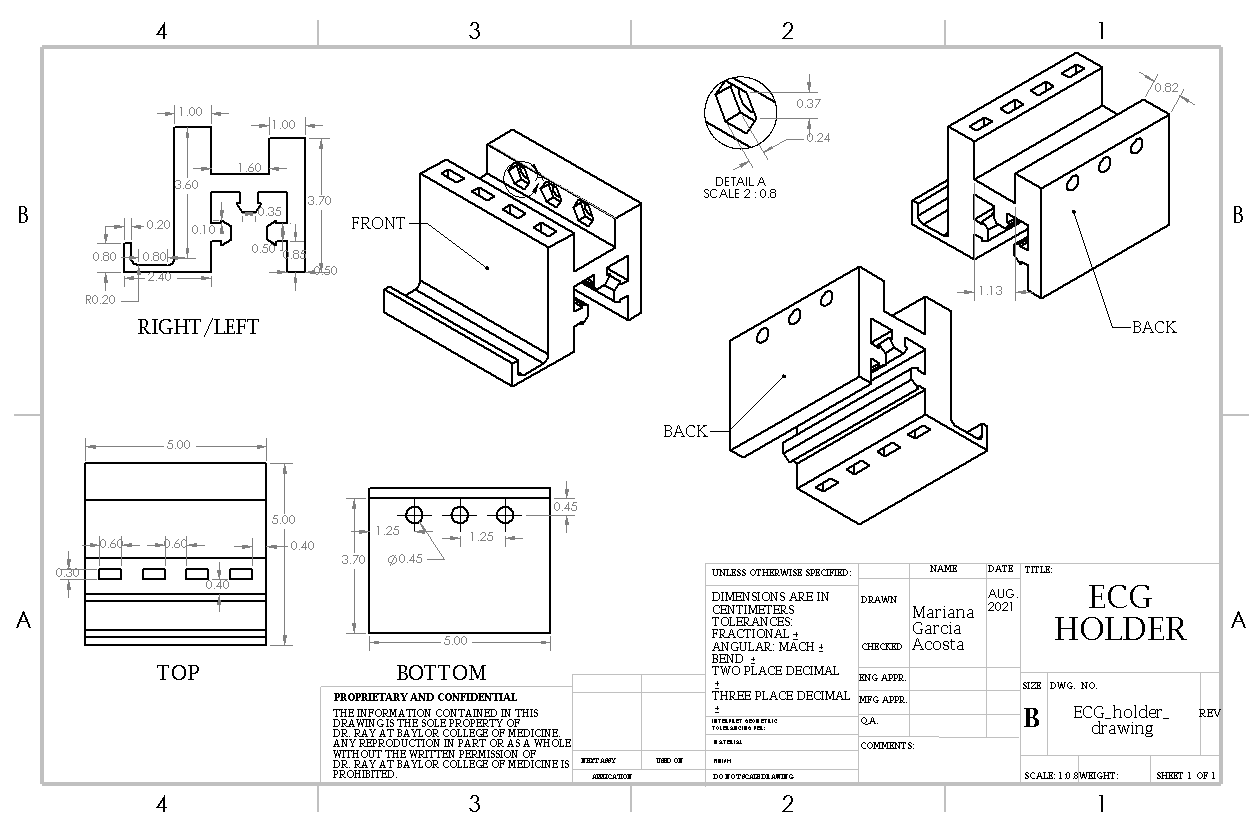
doc/source/Images/8_Water_Bath_Holder/ECG_holder_drawing.PNG
