MolecularNeurobiology/LOOPER/doc/source/Images/8_Water_Bath_Holder/Water_Jacket_Holder_drawing.PNG

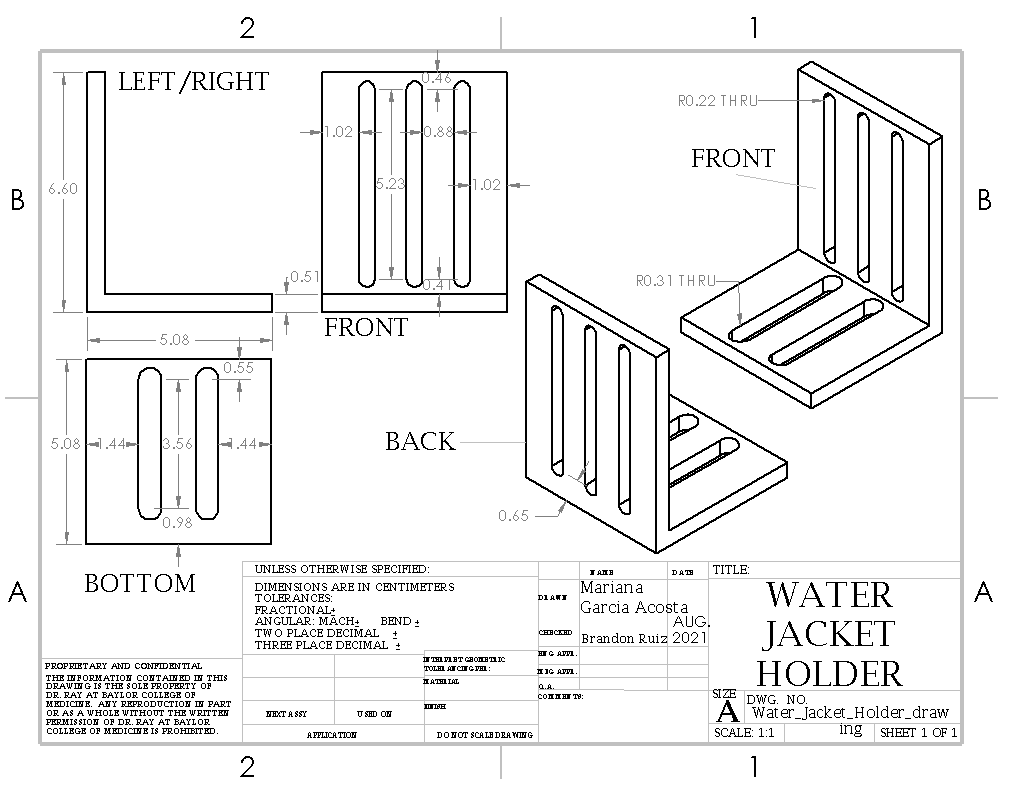
doc/source/Images/8_Water_Bath_Holder/Water_Jacket_Holder_drawing.PNG
