MolecularNeurobiology/LOOPER/doc/source/Images/8Fullrig.png

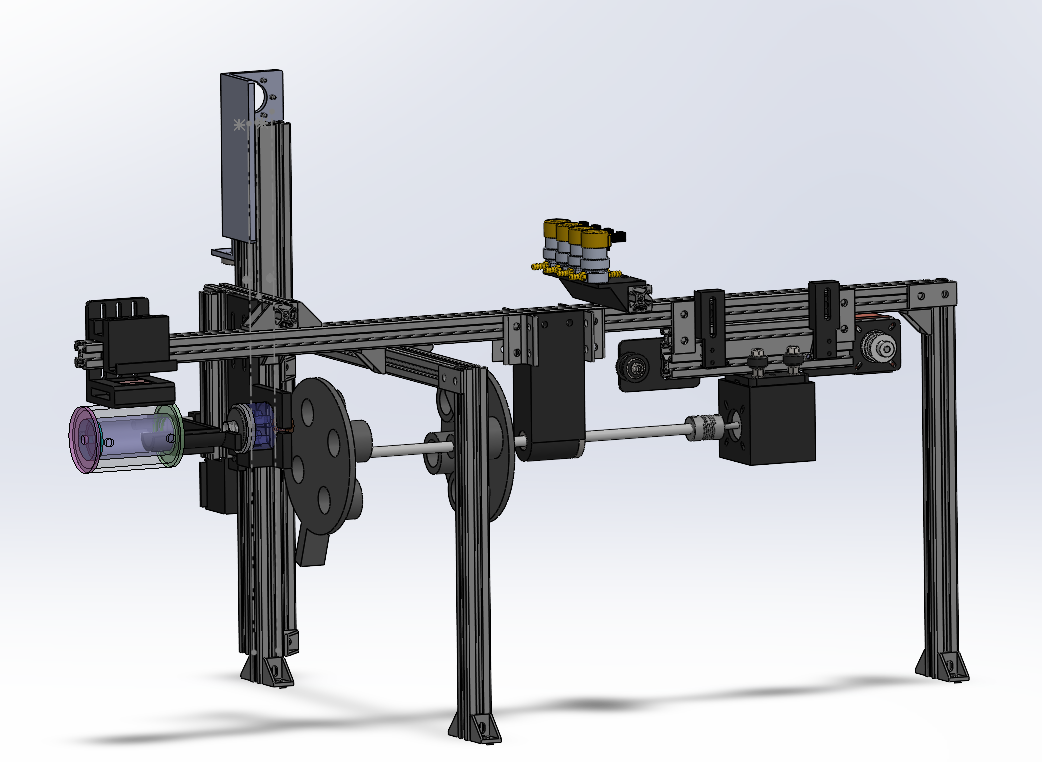
doc/source/Images/8Fullrig.png
