MolecularNeurobiology/LOOPER/doc/source/Images/9_Facemask/Facemask_FrontFace_Drawing.PNG

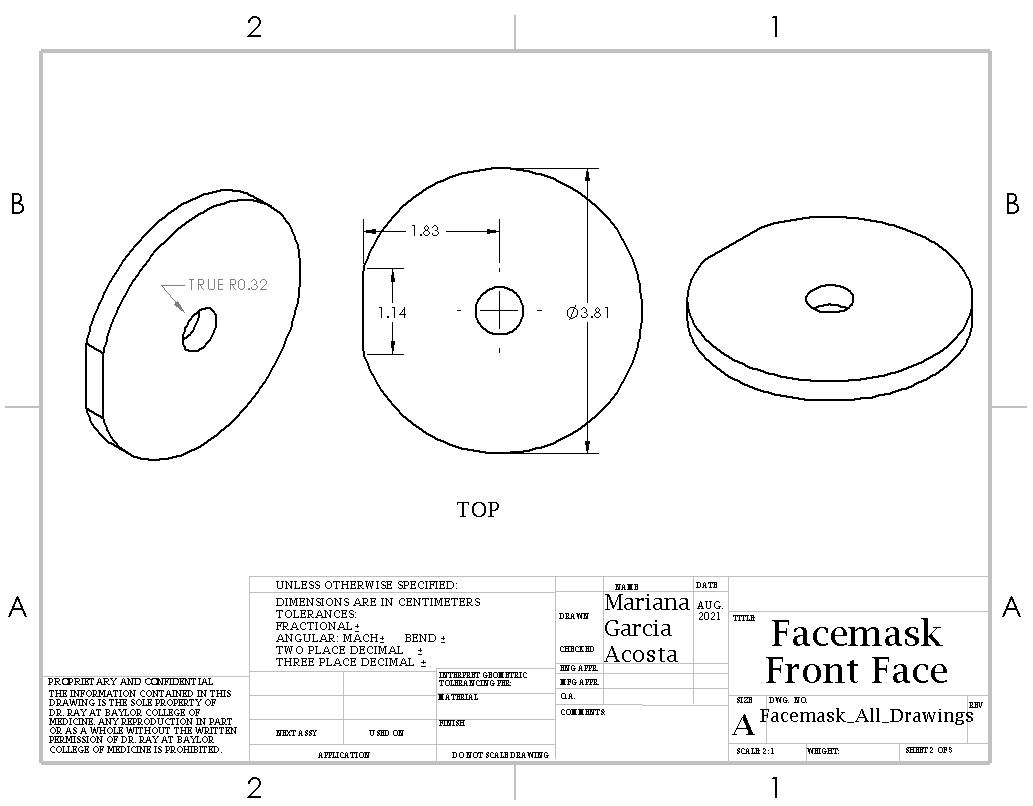
doc/source/Images/9_Facemask/Facemask_FrontFace_Drawing.PNG
