MolecularNeurobiology/LOOPER/doc/source/Images/9_Facemask/Facemask_Snorkel_Drawing.PNG

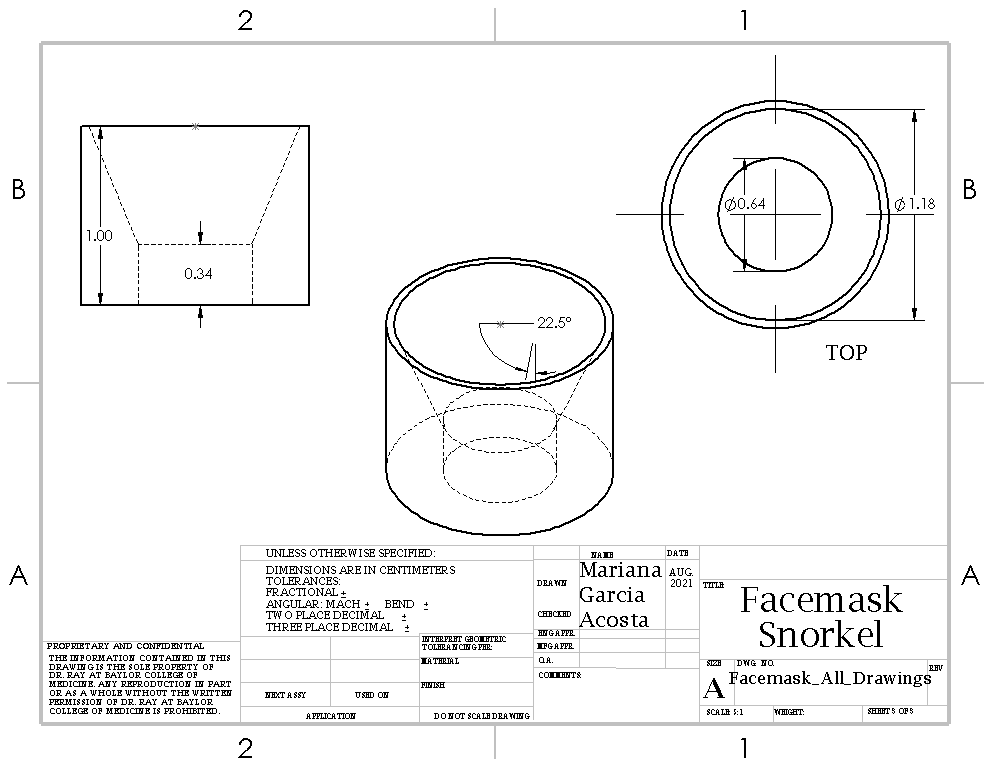
doc/source/Images/9_Facemask/Facemask_Snorkel_Drawing.PNG
