MolecularNeurobiology/LOOPER/doc/source/Images/9_Facemask/Full_Facemask_Drawing.PNG

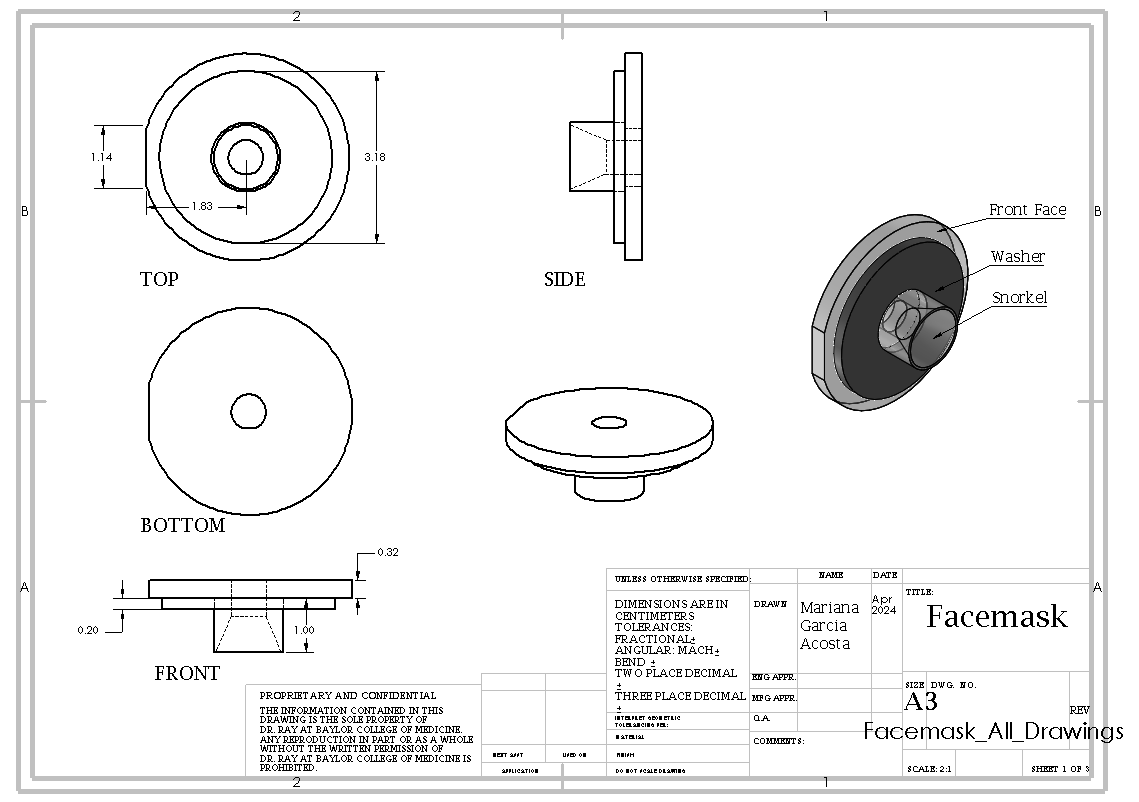
doc/source/Images/9_Facemask/Full_Facemask_Drawing.PNG
