MolecularNeurobiology/LOOPER/doc/source/Images/10_Pneumotach/Built_Pneumotach.png

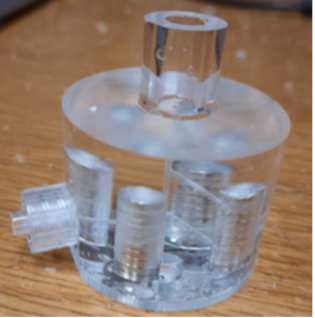
doc/source/Images/10_Pneumotach/Built_Pneumotach.png
