MolecularNeurobiology/LOOPER/doc/source/Images/10_Pneumotach/Full_Pneumotachograph_Drawing.PNG

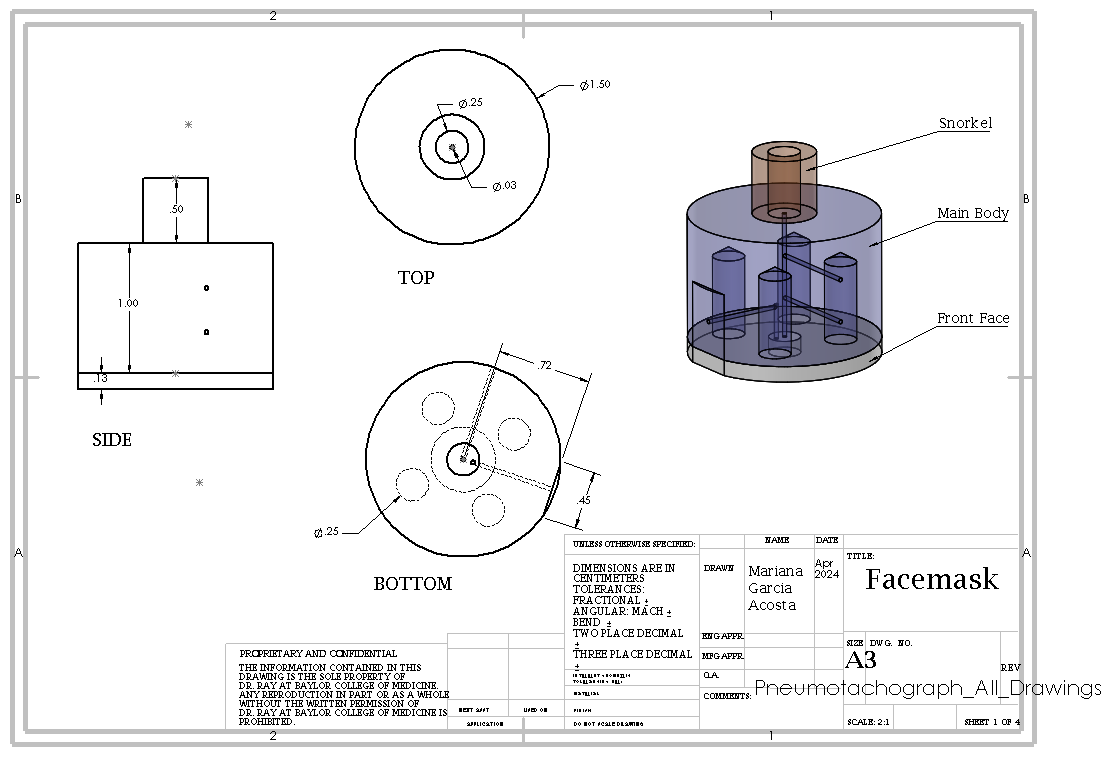
doc/source/Images/10_Pneumotach/Full_Pneumotachograph_Drawing.PNG
