MolecularNeurobiology/LOOPER/doc/source/Images/10_Pneumotach/Pneumotachograph_FrontFace_Drawings.PNG

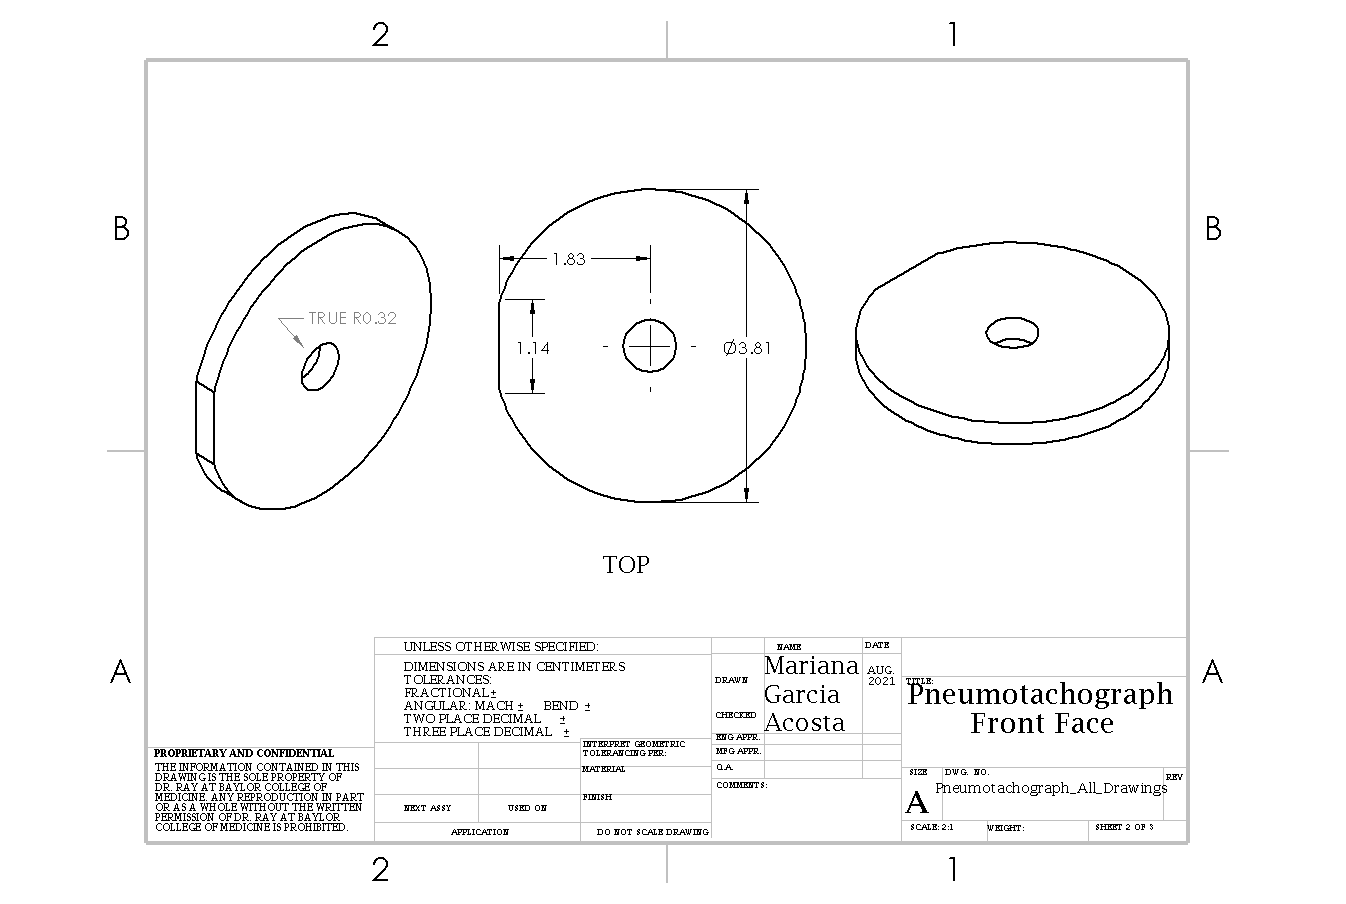
doc/source/Images/10_Pneumotach/Pneumotachograph_FrontFace_Drawings.PNG
