MolecularNeurobiology/LOOPER/doc/source/Images/10_Pneumotach/Pneumotachograph_MainBody_Drawings.PNG

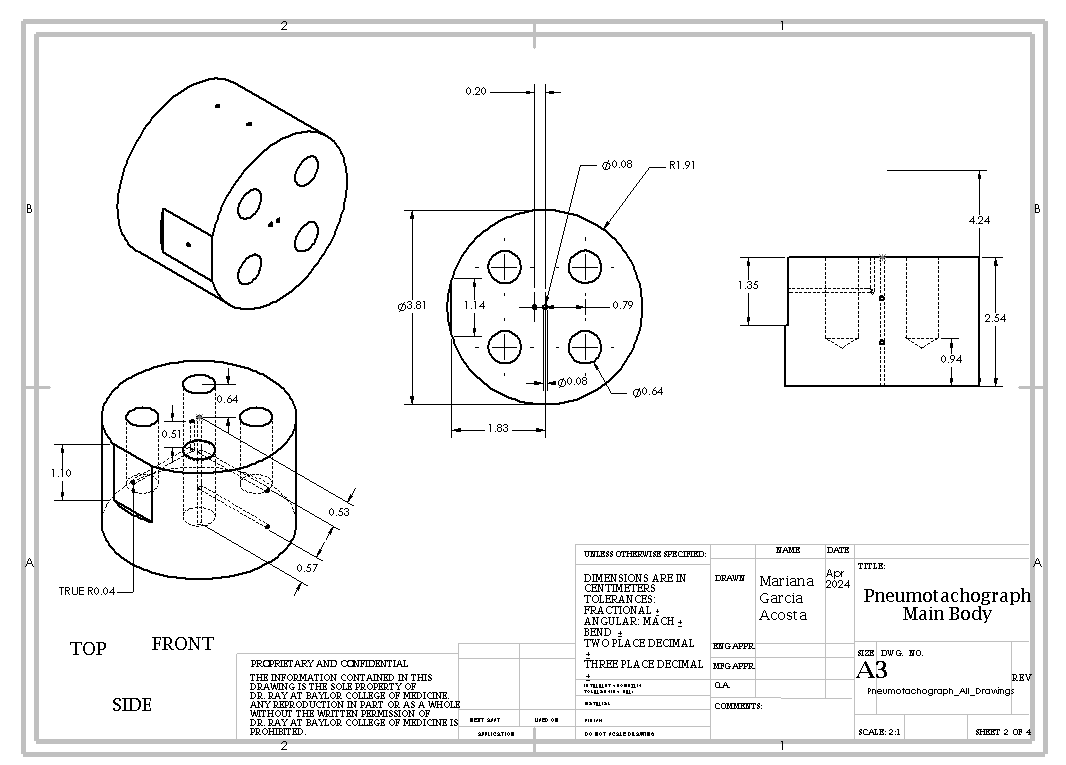
doc/source/Images/10_Pneumotach/Pneumotachograph_MainBody_Drawings.PNG
