MolecularNeurobiology/LOOPER/doc/source/Images/10_Pneumotach/Pneumotachograph_Snorkel_Drawing.PNG

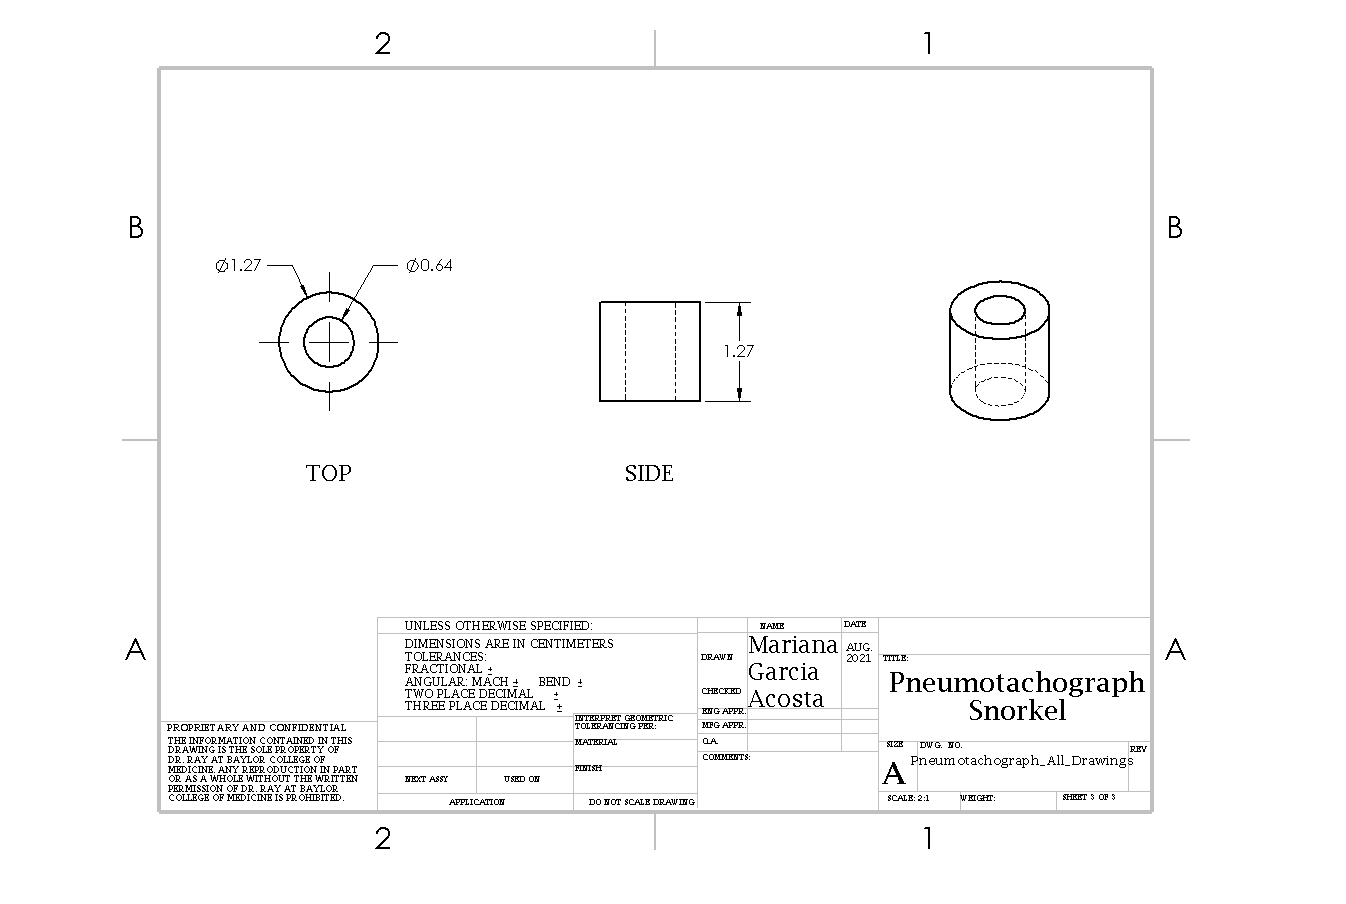
doc/source/Images/10_Pneumotach/Pneumotachograph_Snorkel_Drawing.PNG
