MolecularNeurobiology/LOOPER/doc/source/Images/11_WaterBath/base_0.25in_hole_drawing.PNG

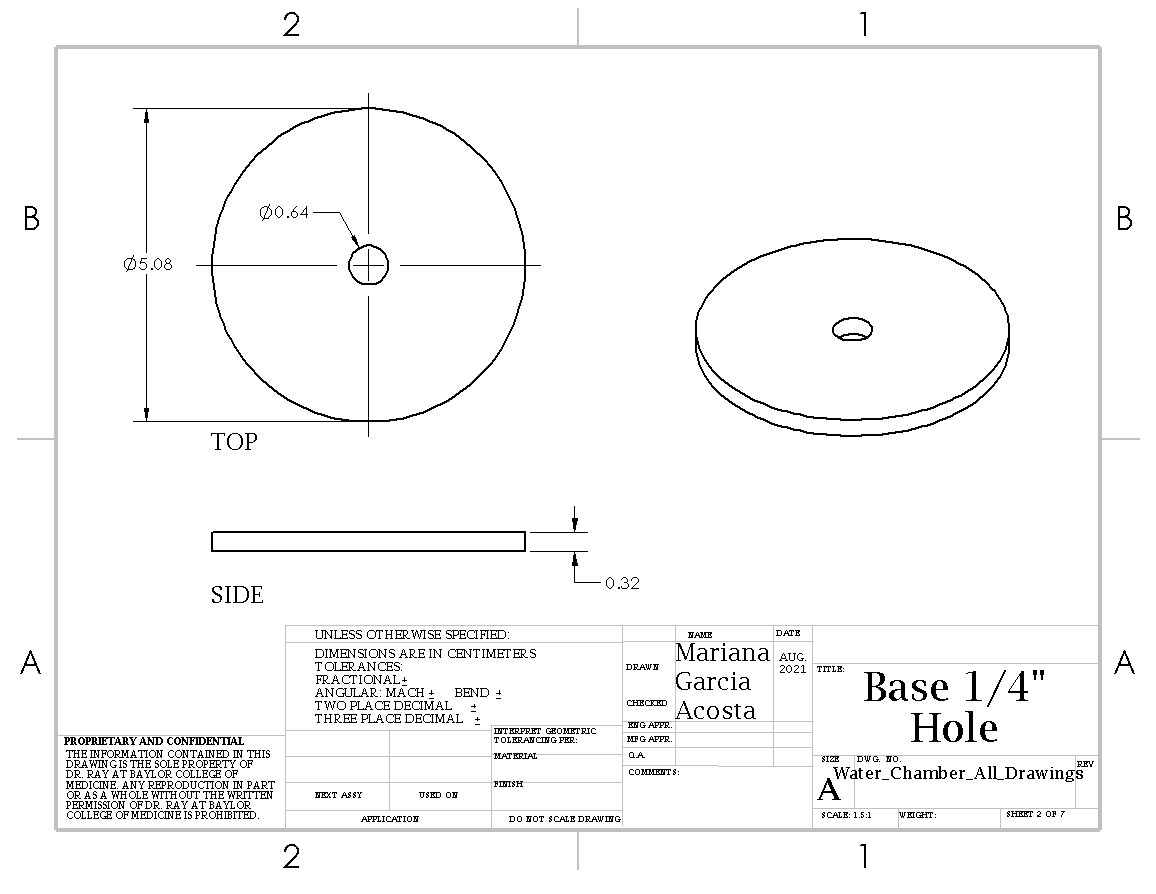
doc/source/Images/11_WaterBath/base_0.25in_hole_drawing.PNG
