MolecularNeurobiology/LOOPER/doc/source/Images/11_WaterBath/base_1in_hole_drawing.PNG

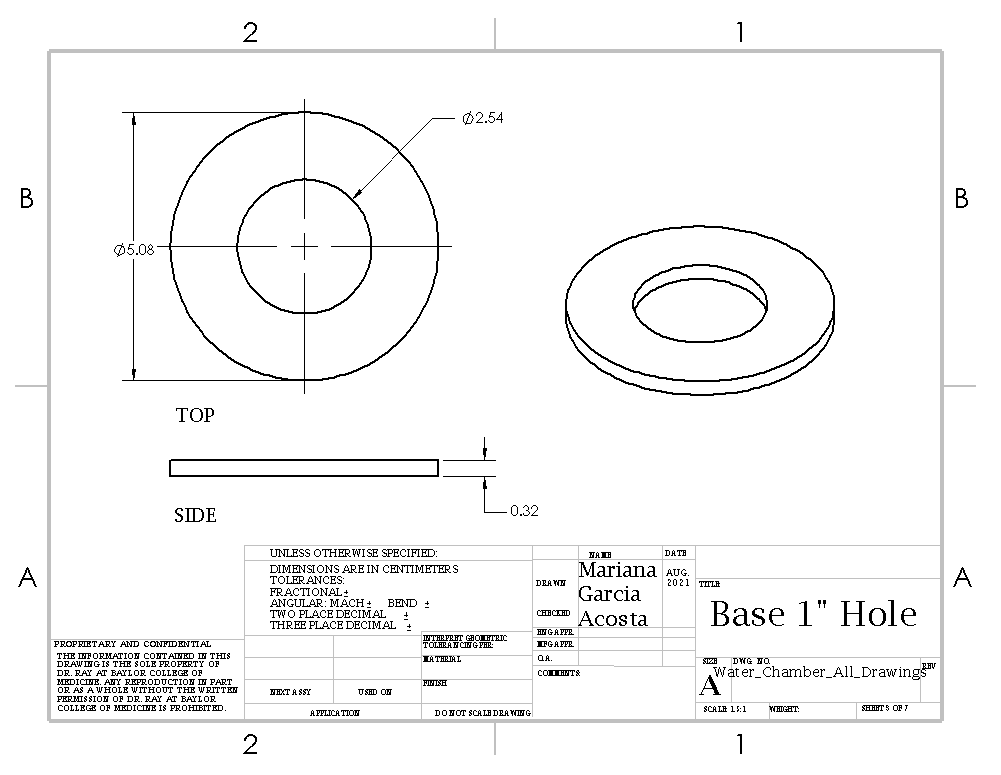
doc/source/Images/11_WaterBath/base_1in_hole_drawing.PNG
