MolecularNeurobiology/LOOPER/doc/source/Images/11_WaterBath/big_tube_drawing.PNG

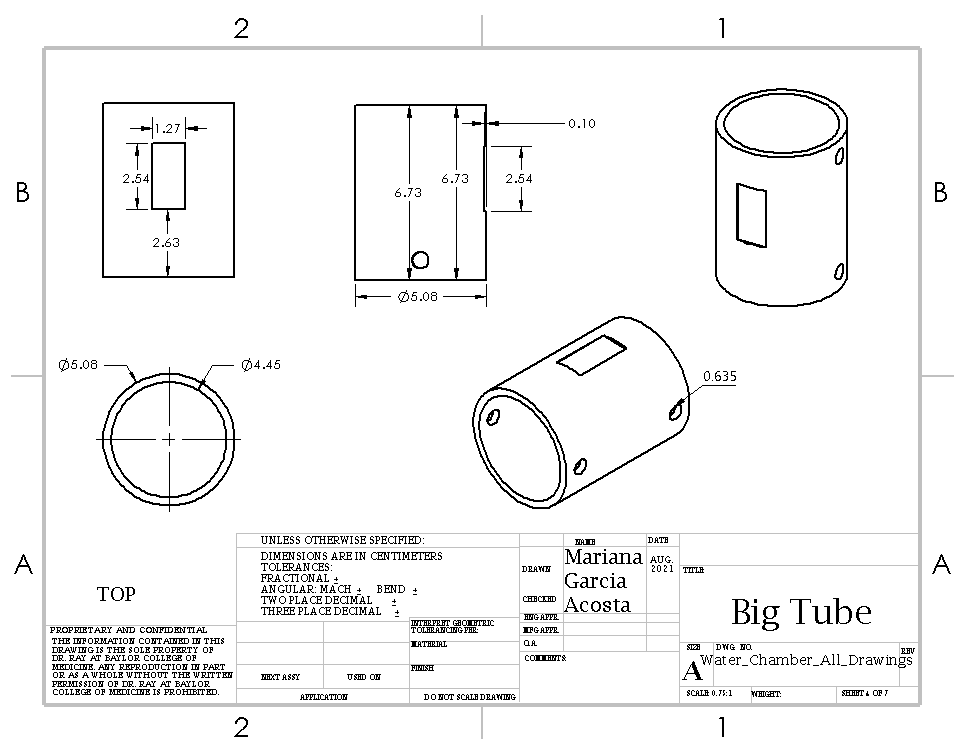
doc/source/Images/11_WaterBath/big_tube_drawing.PNG
