MolecularNeurobiology/LOOPER/doc/source/Images/11_WaterBath/block_drawing.PNG

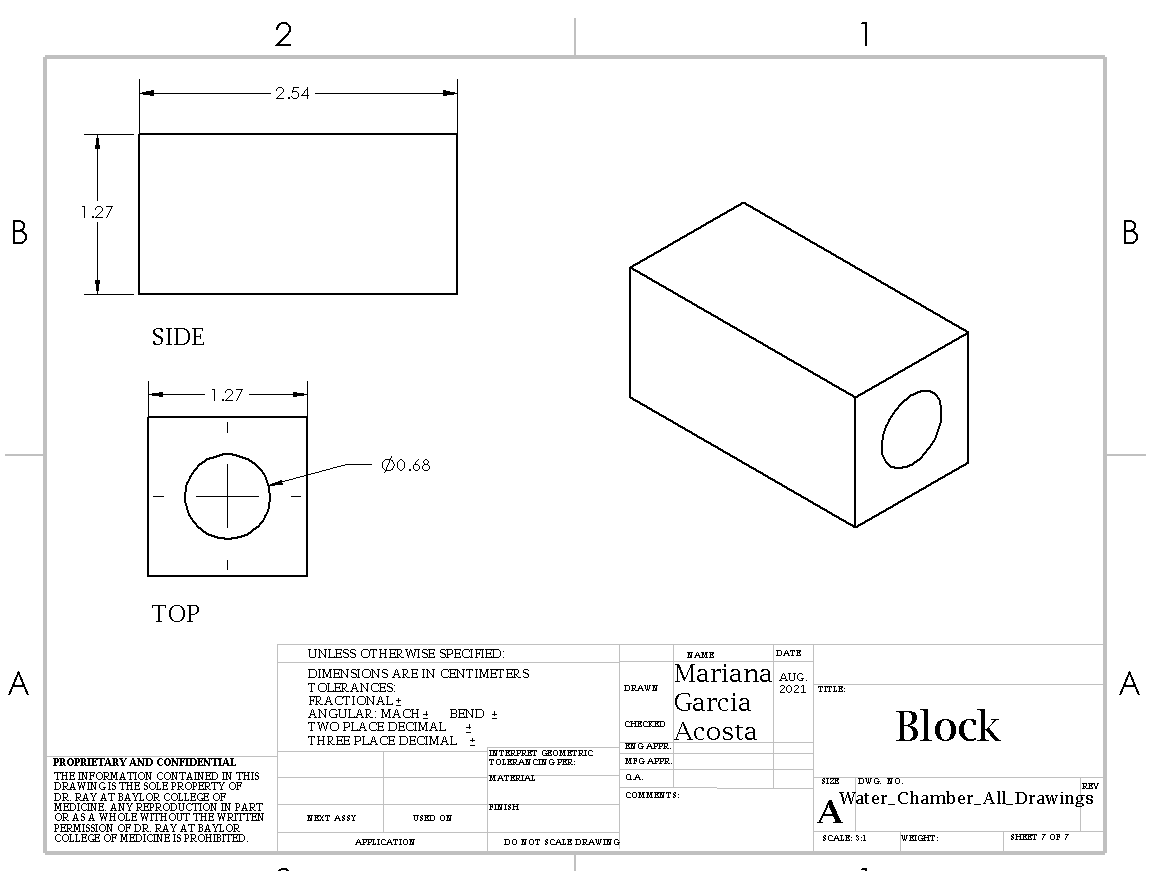
doc/source/Images/11_WaterBath/block_drawing.PNG
