MolecularNeurobiology/LOOPER/doc/source/Images/11_WaterBath/small_tube_base_drawing.PNG

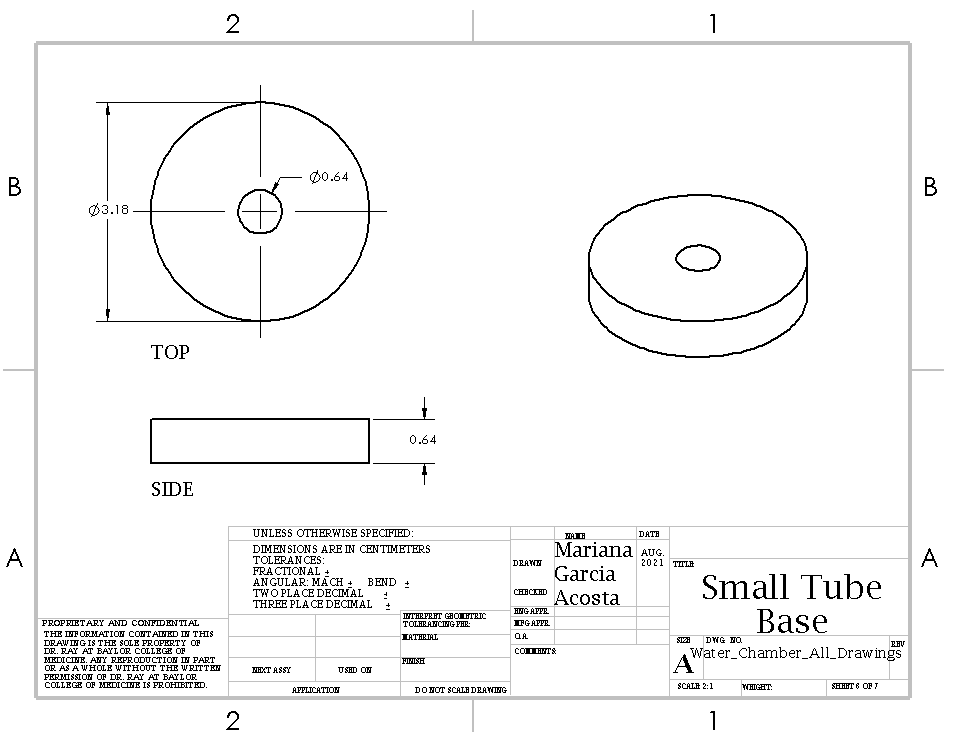
doc/source/Images/11_WaterBath/small_tube_base_drawing.PNG
