MolecularNeurobiology/LOOPER/doc/source/Images/11_WaterBath/small_tube_drawing.PNG

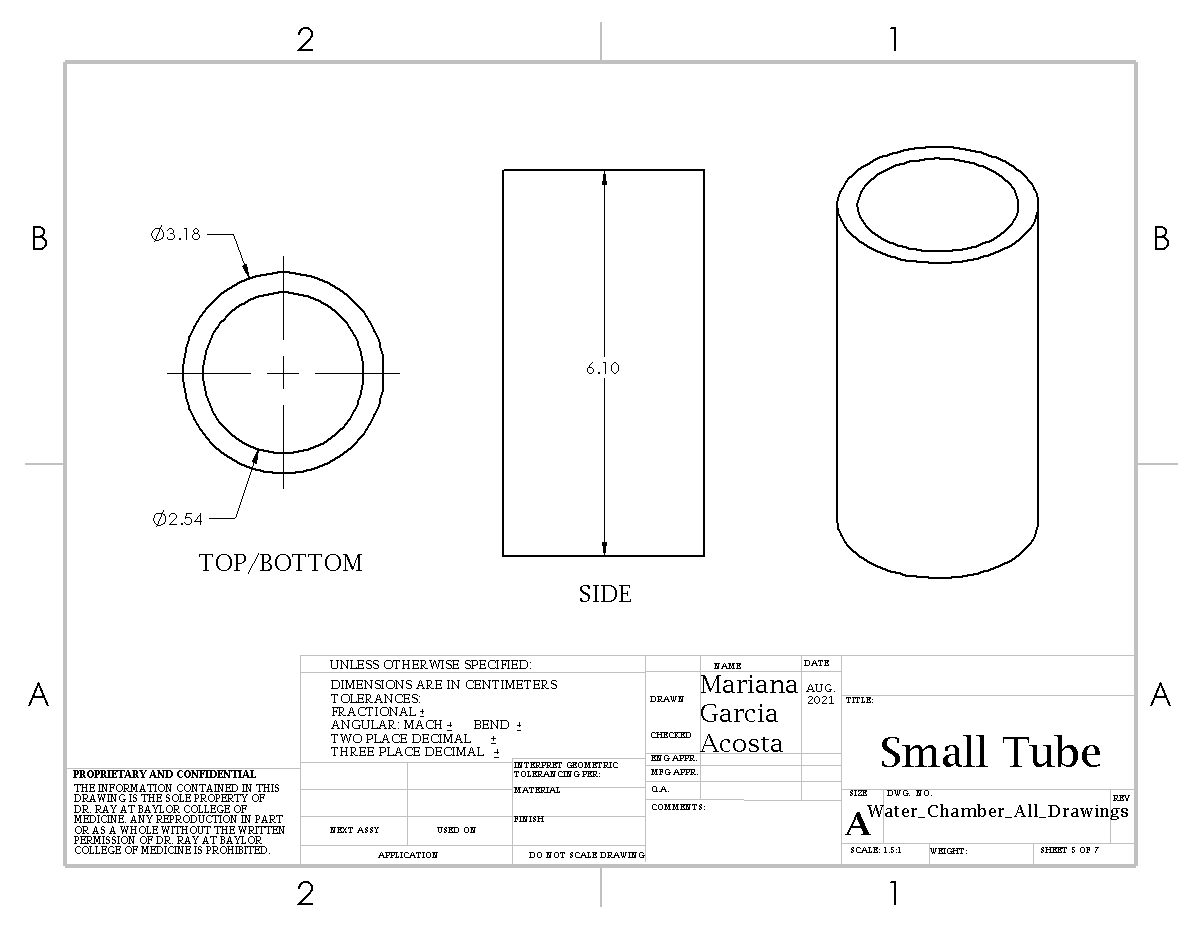
doc/source/Images/11_WaterBath/small_tube_drawing.PNG
