MolecularNeurobiology/LOOPER/doc/source/Images/11_WaterBath/Water_Chamber_Full_Drawings.PNG

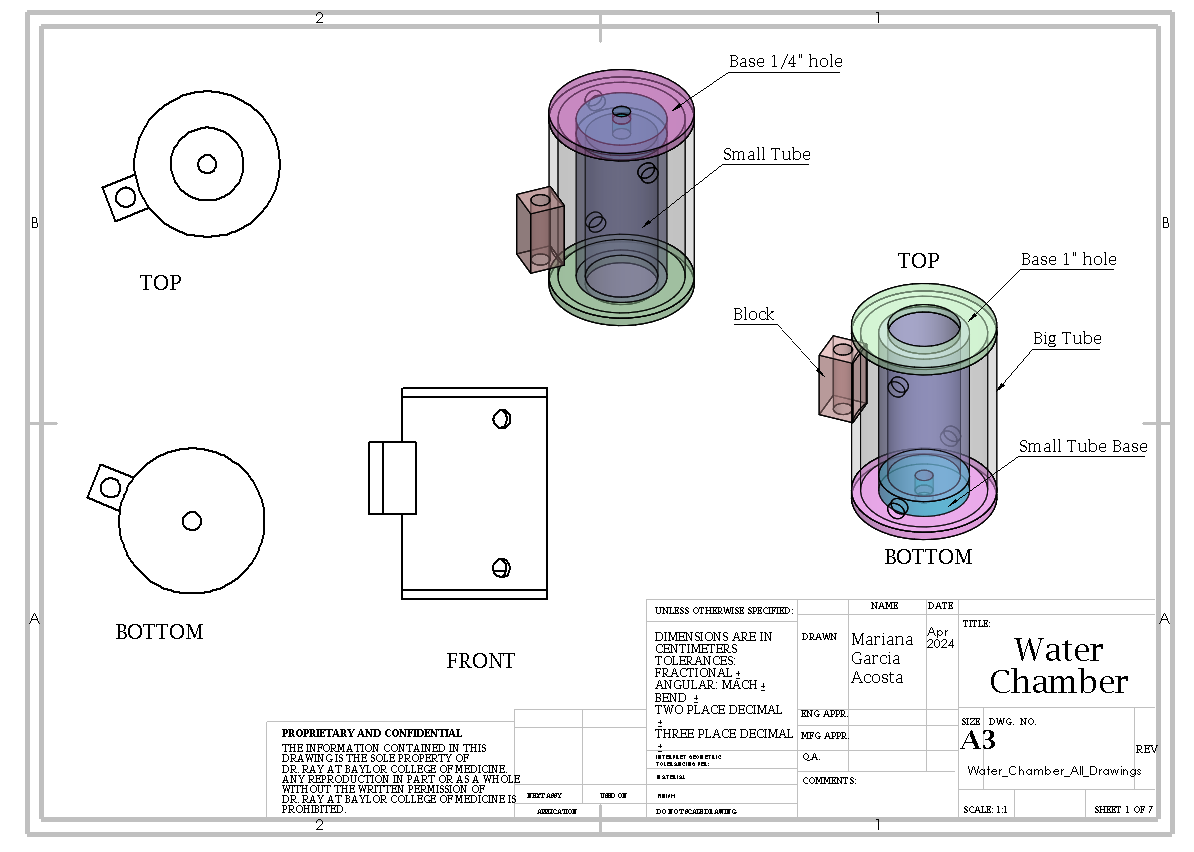
doc/source/Images/11_WaterBath/Water_Chamber_Full_Drawings.PNG
