MolecularNeurobiology/LOOPER/doc/source/Images/12_MainElectricBox/arduino_holder_drawing1.PNG

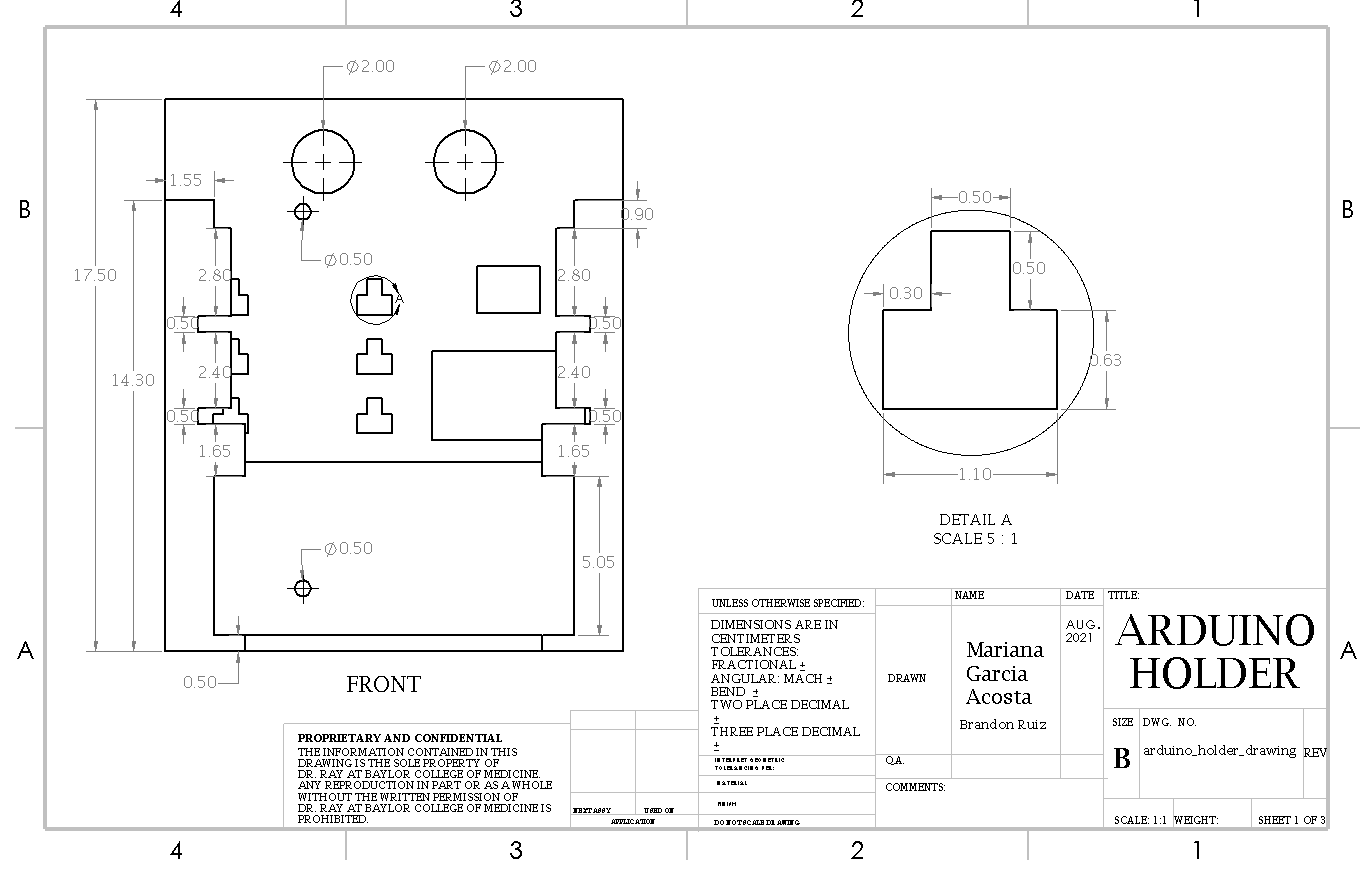
doc/source/Images/12_MainElectricBox/arduino_holder_drawing1.PNG
