MolecularNeurobiology/LOOPER/doc/source/Images/12_MainElectricBox/arduino_holder_drawing2.PNG

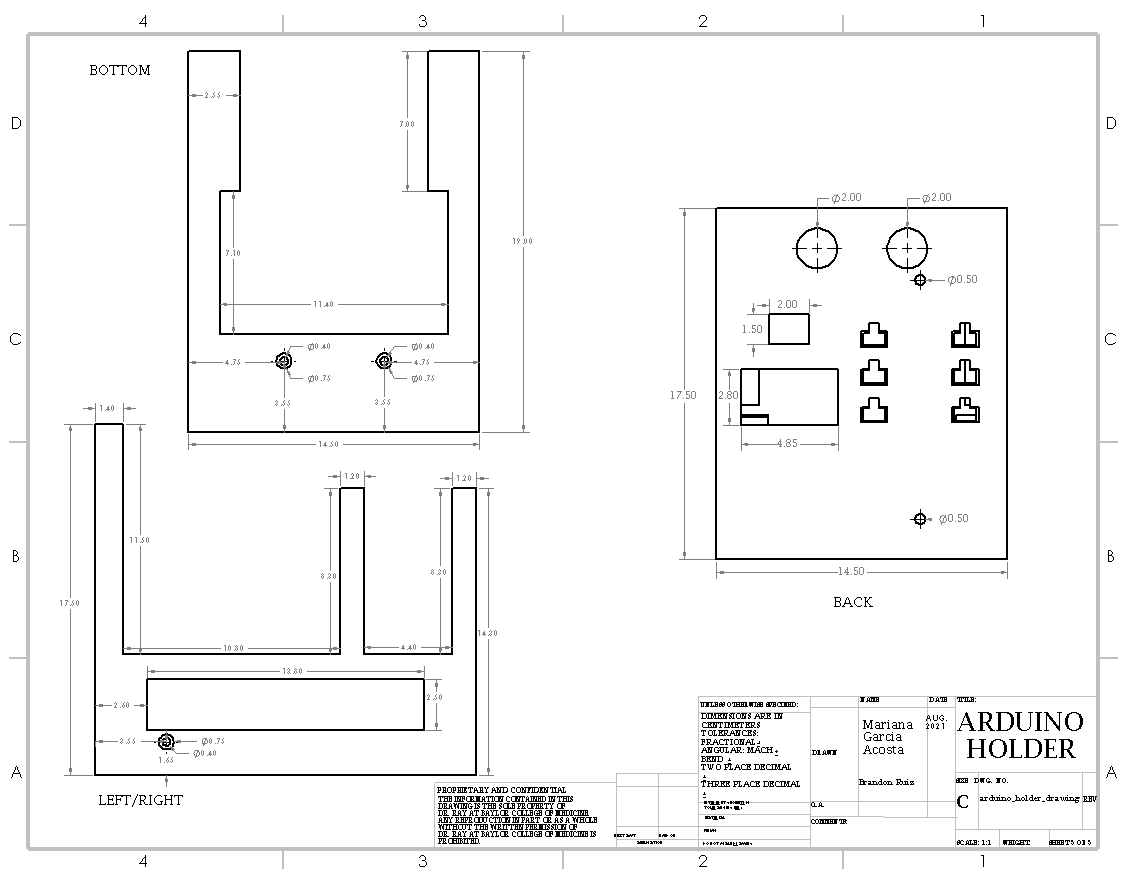
doc/source/Images/12_MainElectricBox/arduino_holder_drawing2.PNG
