MolecularNeurobiology/LOOPER/doc/source/Images/12_MainElectricBox/arduino_holder_drawing3.PNG

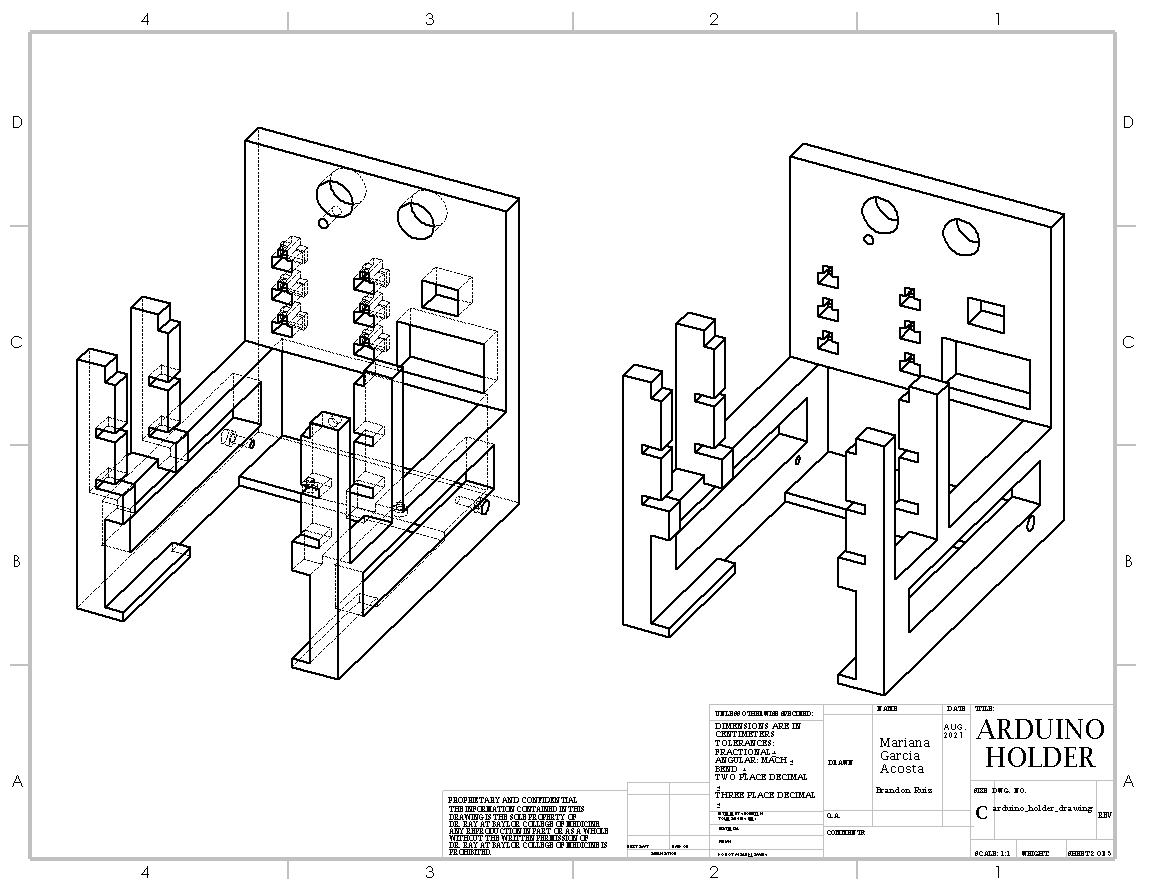
doc/source/Images/12_MainElectricBox/arduino_holder_drawing3.PNG
