MolecularNeurobiology/LOOPER/doc/source/Images/12_MainElectricBox/arduino_MEGA_bumper_drawing.PNG

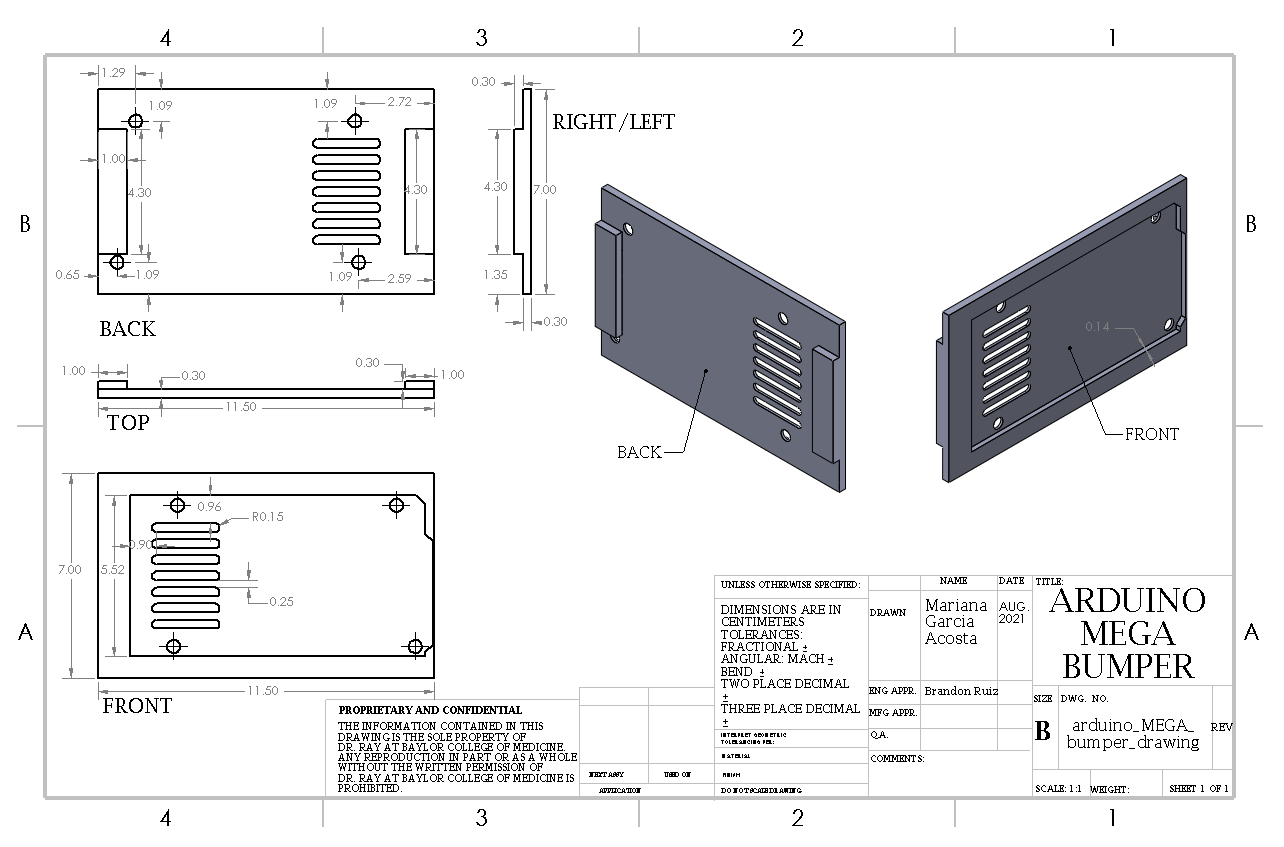
doc/source/Images/12_MainElectricBox/arduino_MEGA_bumper_drawing.PNG
