MolecularNeurobiology/LOOPER/doc/source/Images/Completed_Rig_Technical_Drawing_Full_Rig_2.PNG

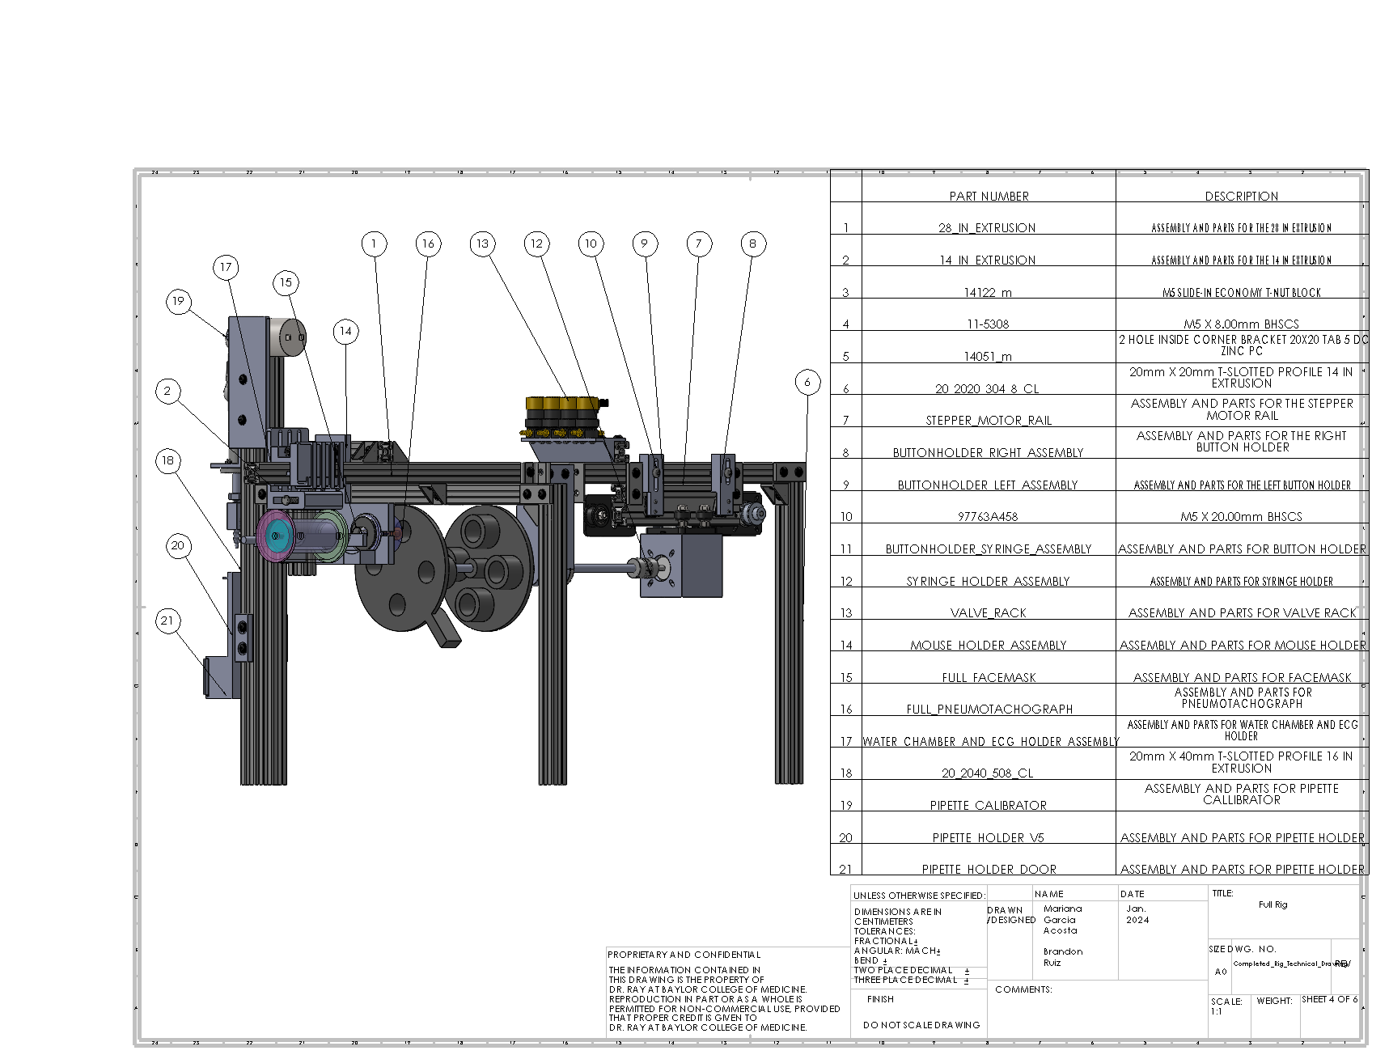
doc/source/Images/Completed_Rig_Technical_Drawing_Full_Rig_2.PNG
