MolecularNeurobiology/LOOPER/doc/source/Images/Completed_Rig_Technical_Drawing_Full_Rig_3.PNG

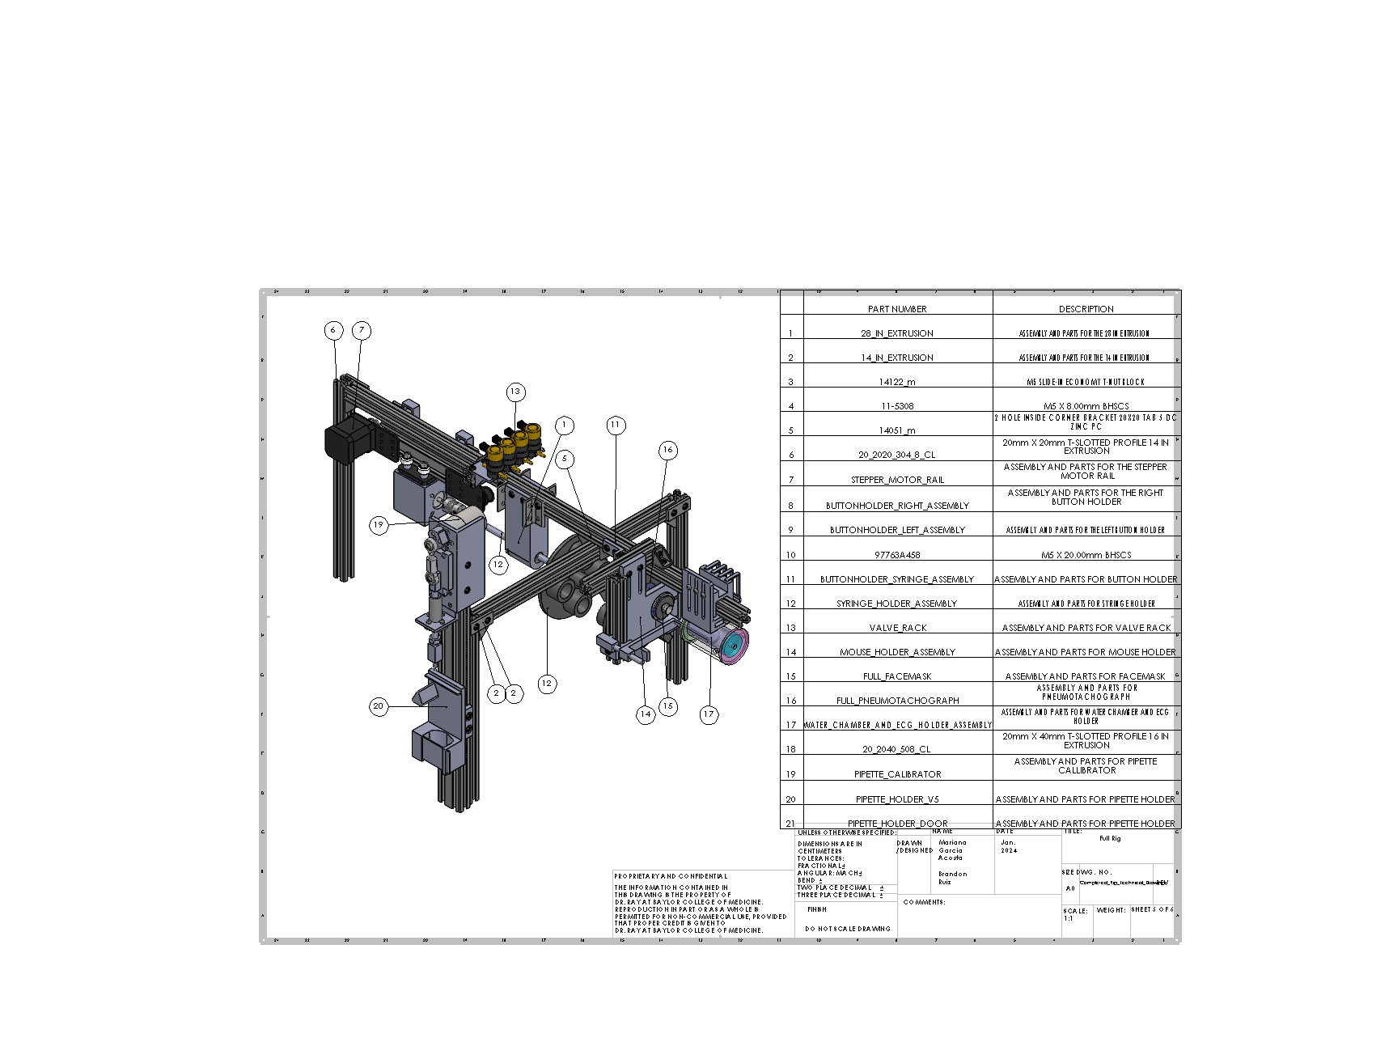
doc/source/Images/Completed_Rig_Technical_Drawing_Full_Rig_3.PNG
