MolecularNeurobiology/LOOPER/doc/source/Images/full_rig.PNG

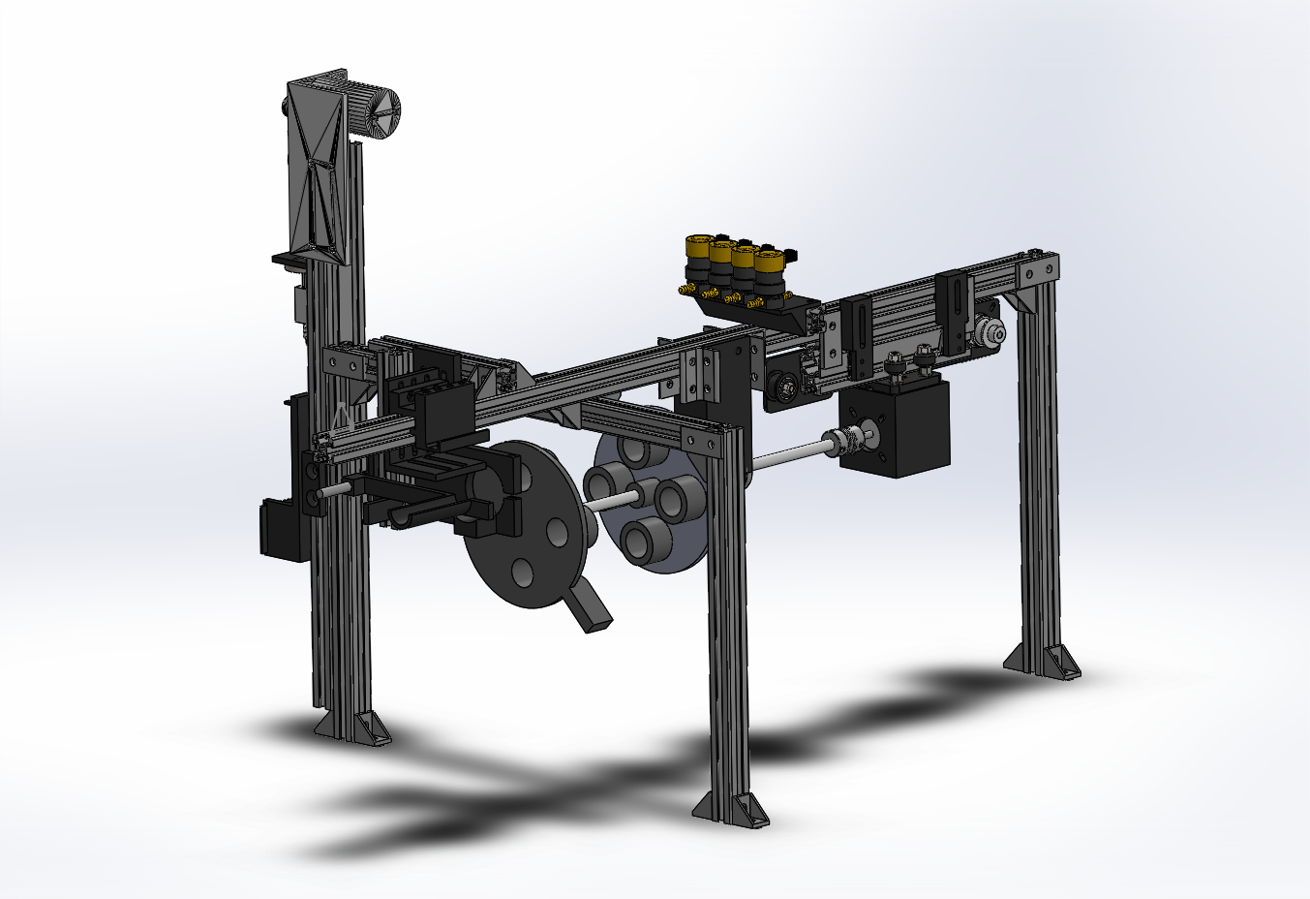
doc/source/Images/full_rig.PNG
