MolecularNeurobiology/LOOPER/doc/source/Images/Full_Rig_9.PNG

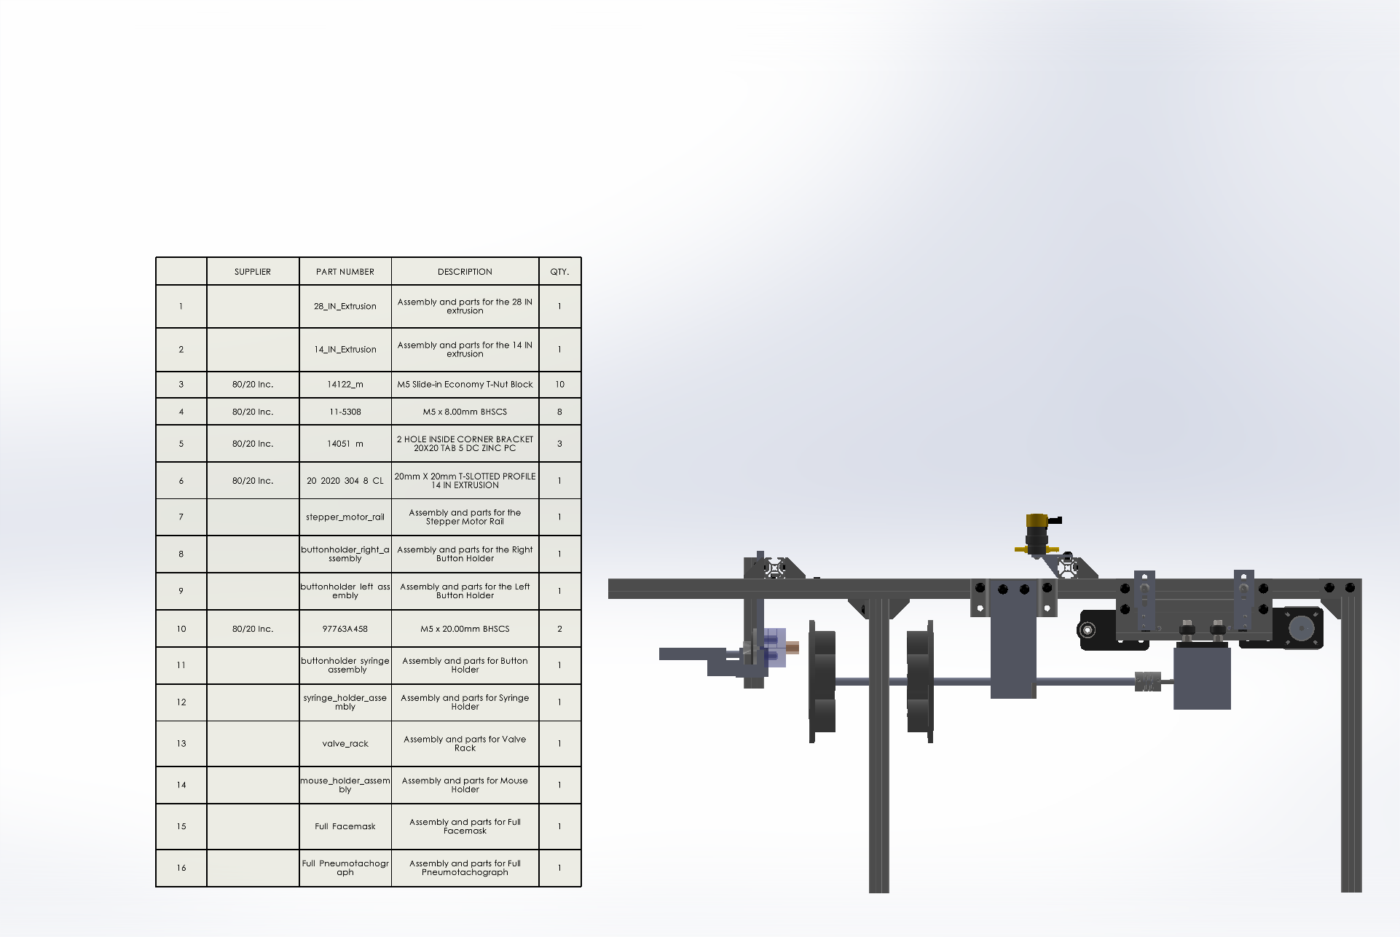
doc/source/Images/Full_Rig_9.PNG
