MolecularNeurobiology/LOOPER/doc/source/Images/Full_Rig_10.PNG

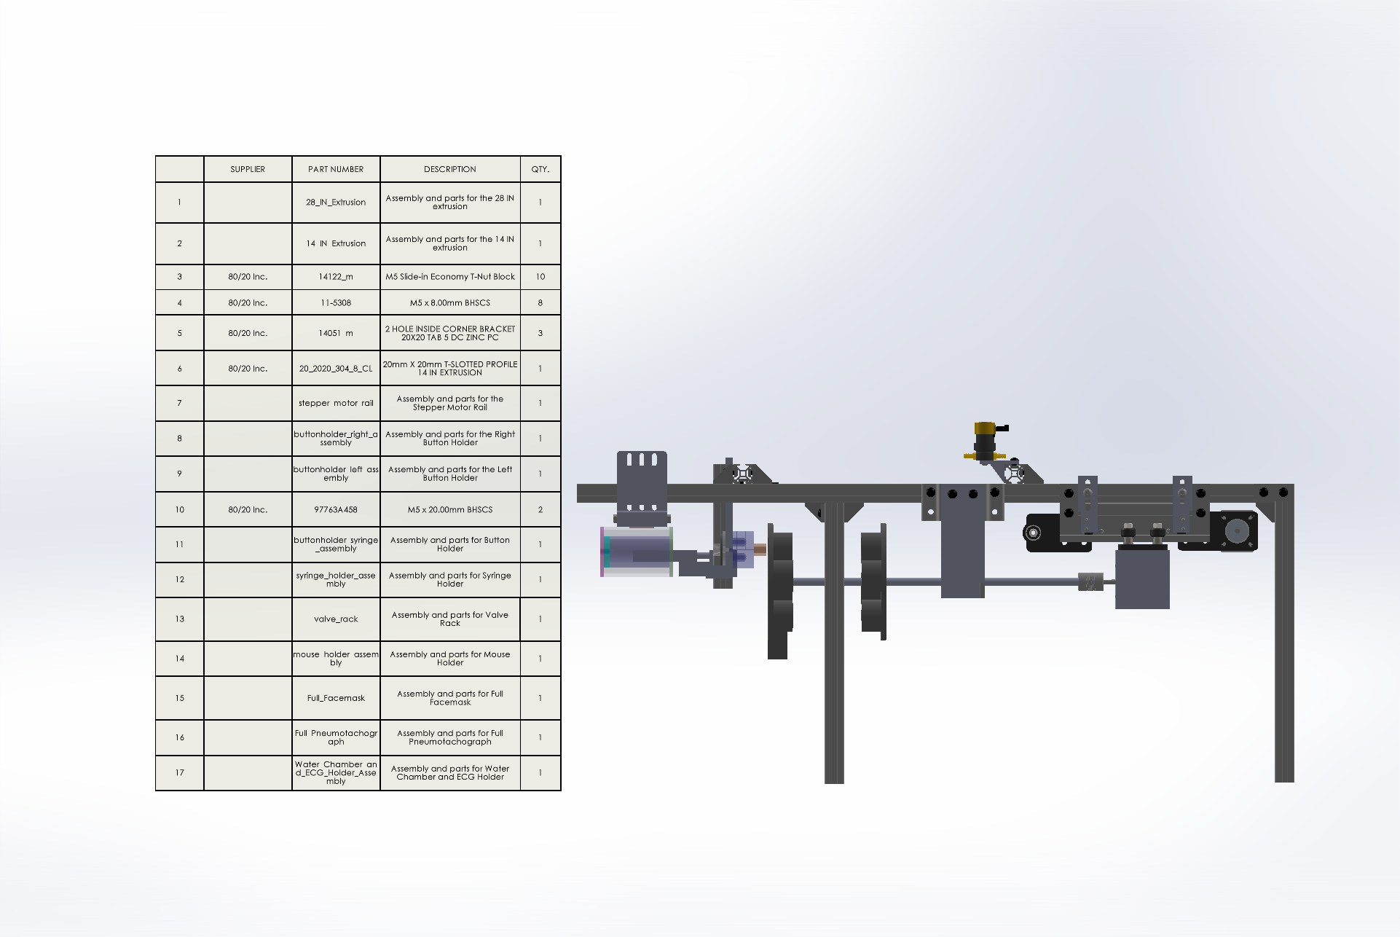
doc/source/Images/Full_Rig_10.PNG
