MolecularNeurobiology/LOOPER/doc/source/Images/Full_Rig_11.PNG

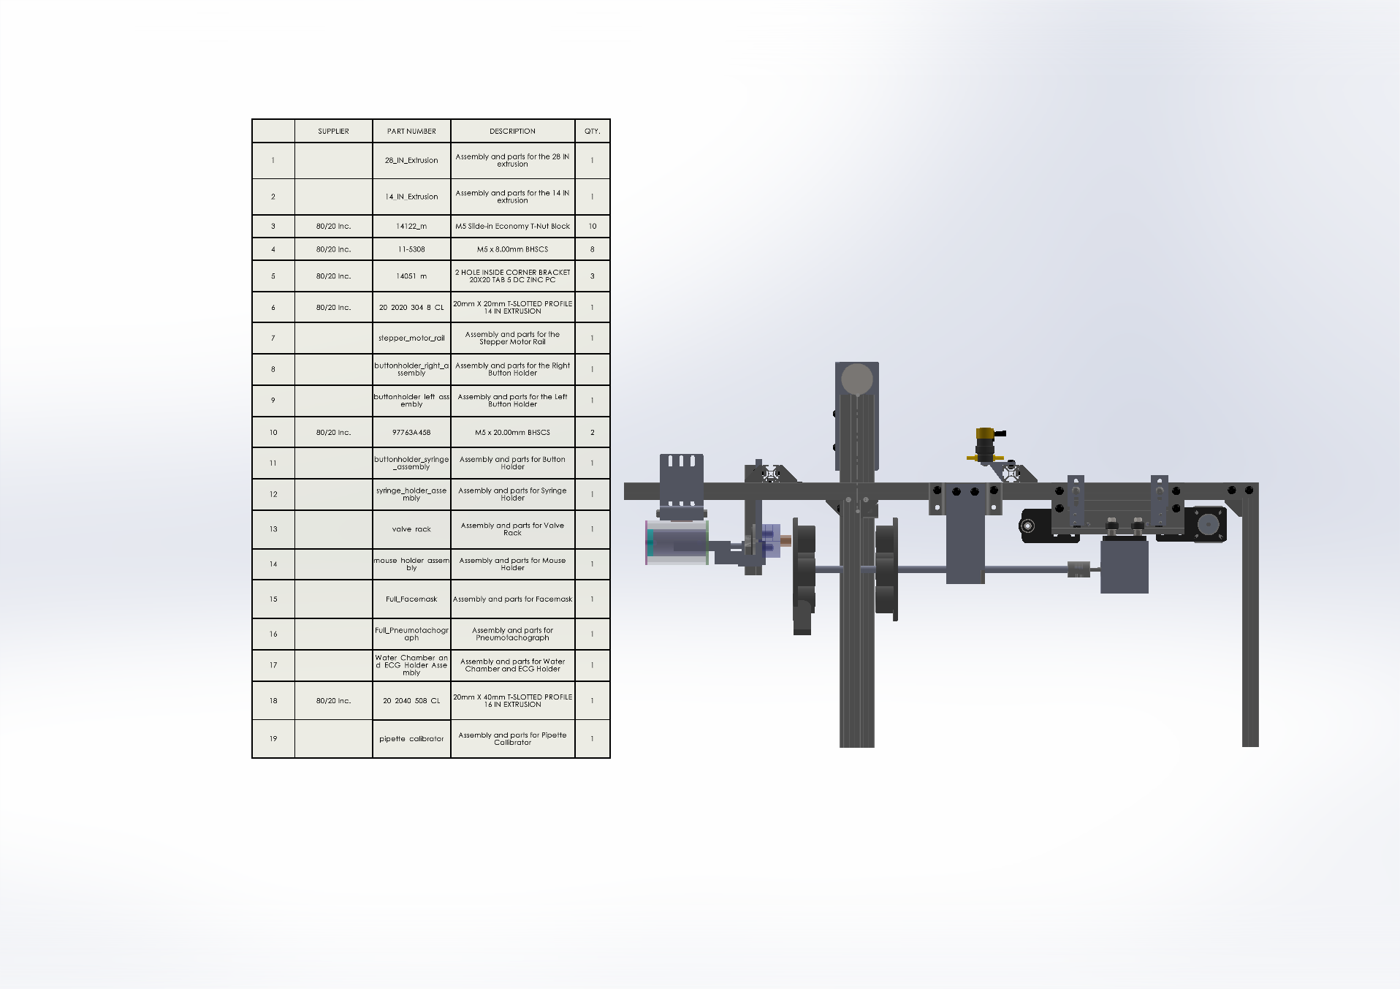
doc/source/Images/Full_Rig_11.PNG
