MolecularNeurobiology/LOOPER/doc/source/Images/Full_Rig_12.PNG

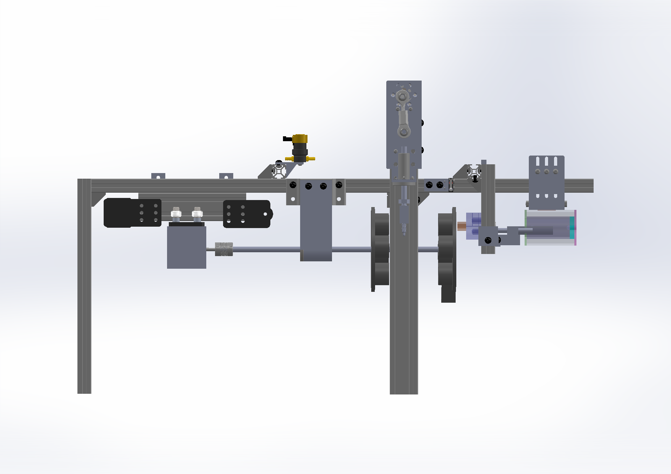
doc/source/Images/Full_Rig_12.PNG
