MolecularNeurobiology/LOOPER/doc/source/Images/Full_Rig_13.PNG

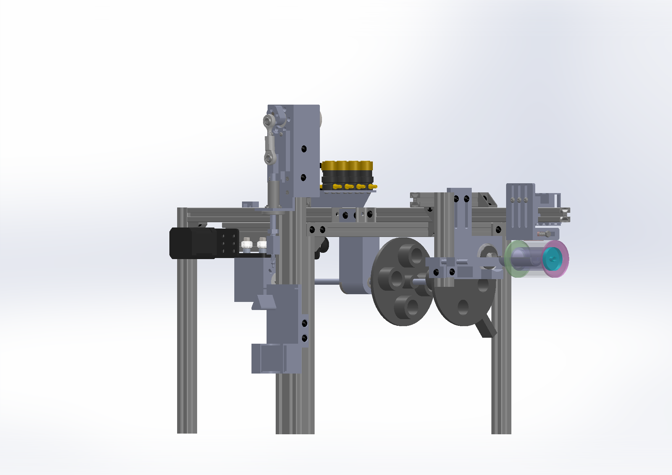
doc/source/Images/Full_Rig_13.PNG
