MolecularNeurobiology/LOOPER/doc/source/Images/Full_Rig_14.PNG

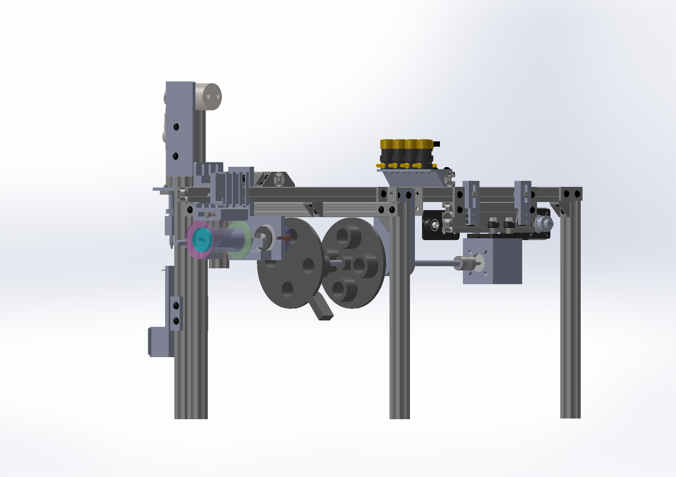
doc/source/Images/Full_Rig_14.PNG
