MolecularNeurobiology/LOOPER/doc/source/Images/Full_Rig_15.PNG

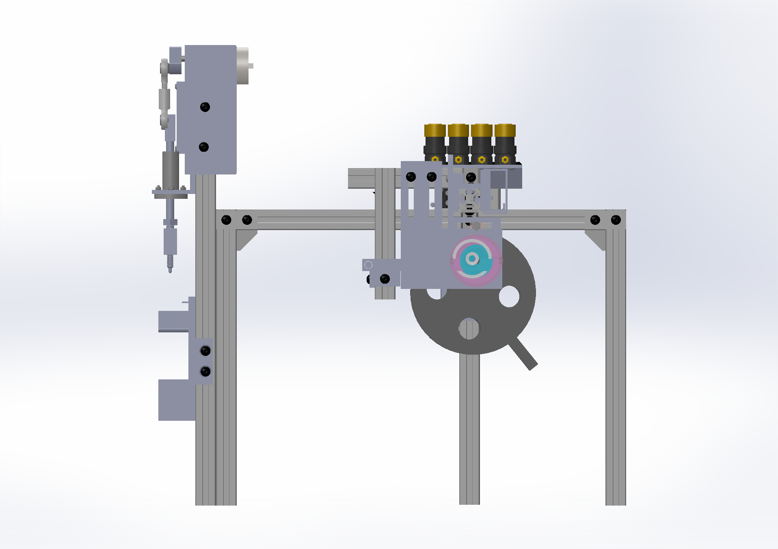
doc/source/Images/Full_Rig_15.PNG
