MolecularNeurobiology/LOOPER/doc/source/Images/full_rig_drawing.png

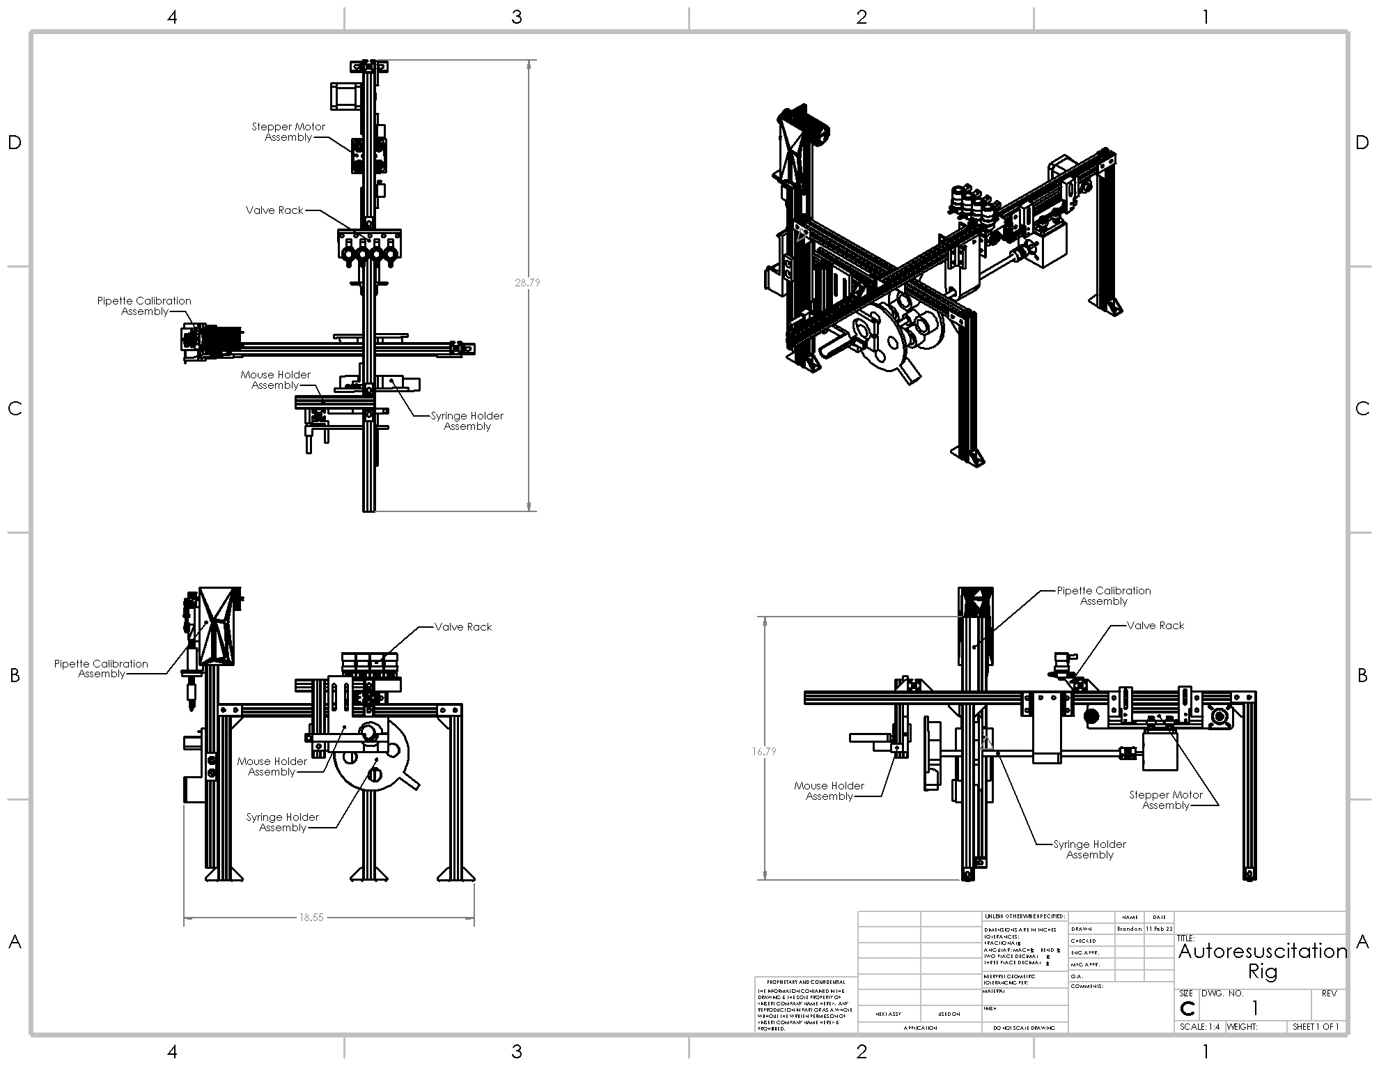
doc/source/Images/full_rig_drawing.png
