MolecularNeurobiology/LOOPER/doc/source/Images/notUsed/11_25IN.png

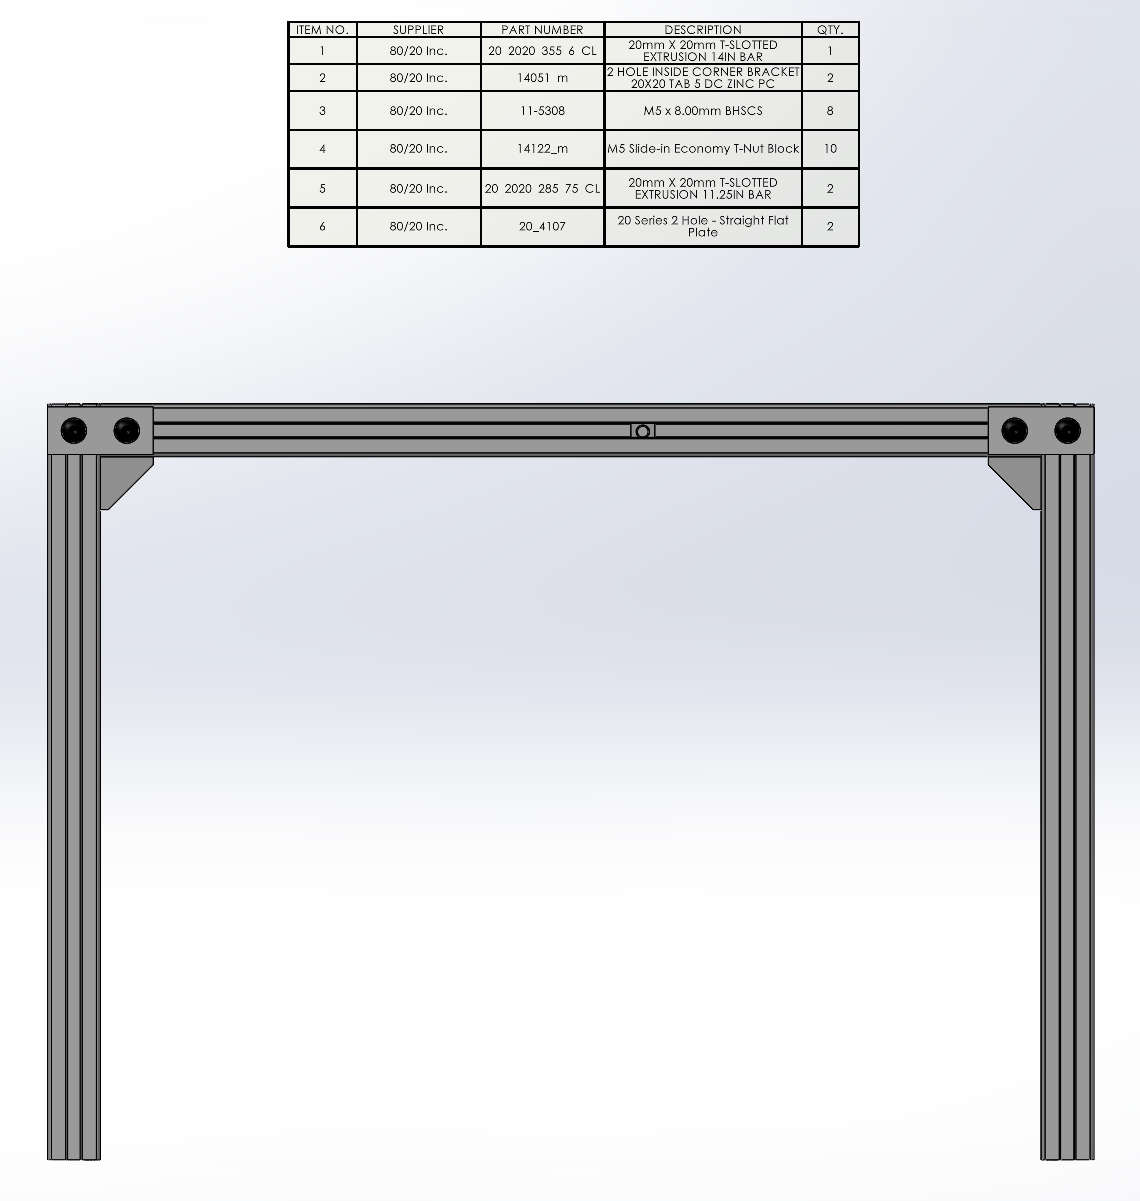
doc/source/Images/notUsed/11_25IN.png
