MolecularNeurobiology/LOOPER/doc/source/Images/notUsed/11_25IN_ex.png

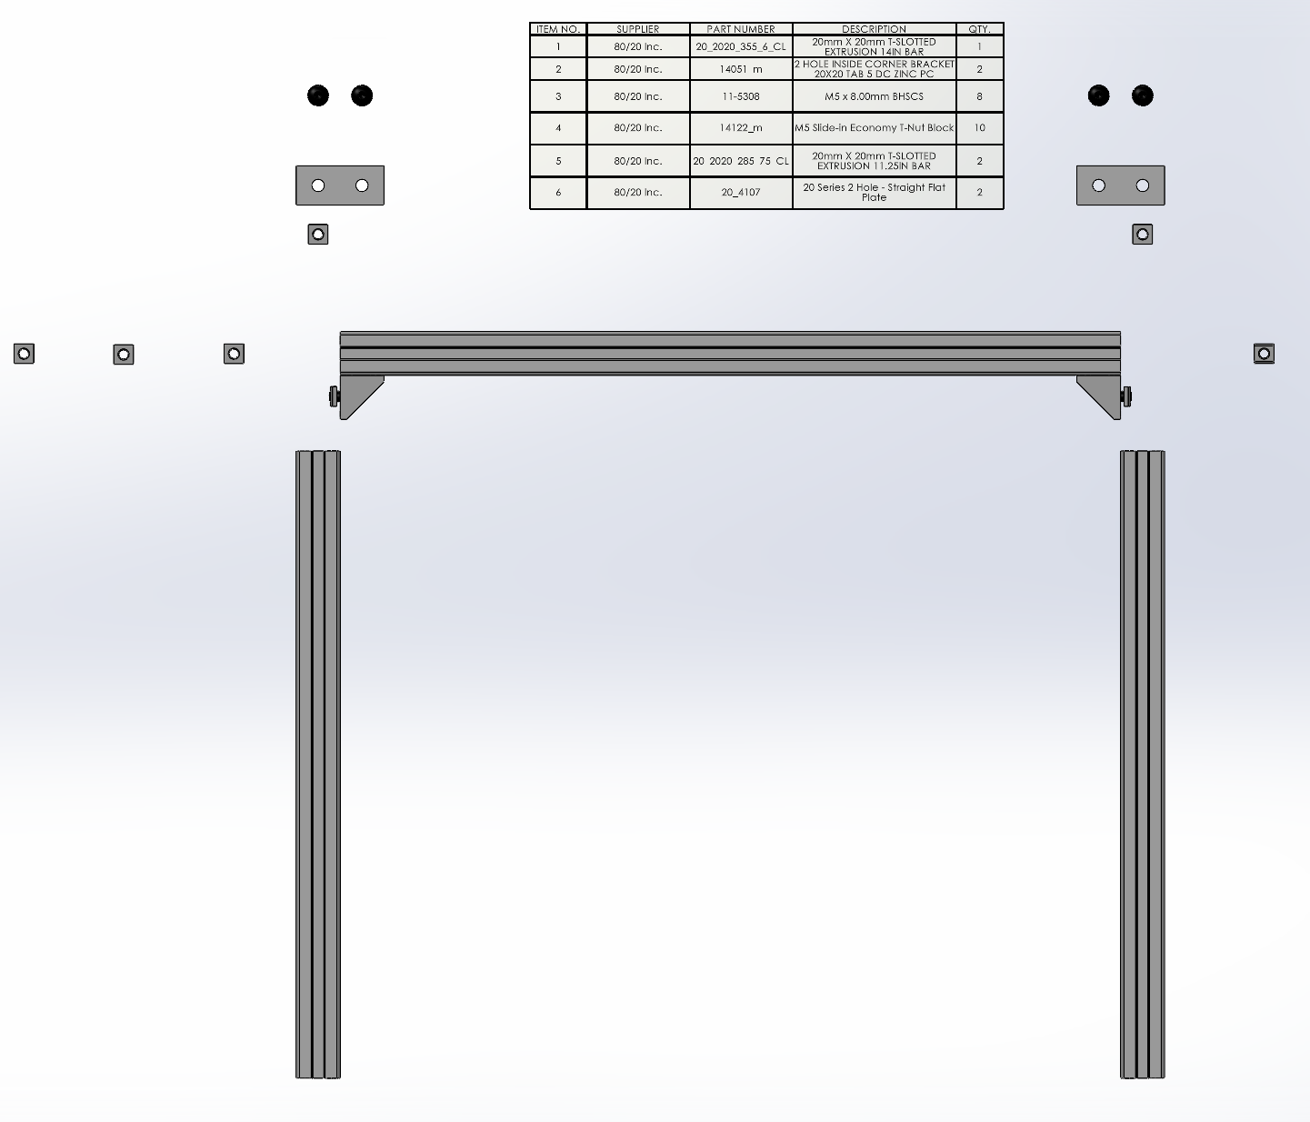
doc/source/Images/notUsed/11_25IN_ex.png
