MolecularNeurobiology/LOOPER/doc/source/Images/notUsed/14IN.png

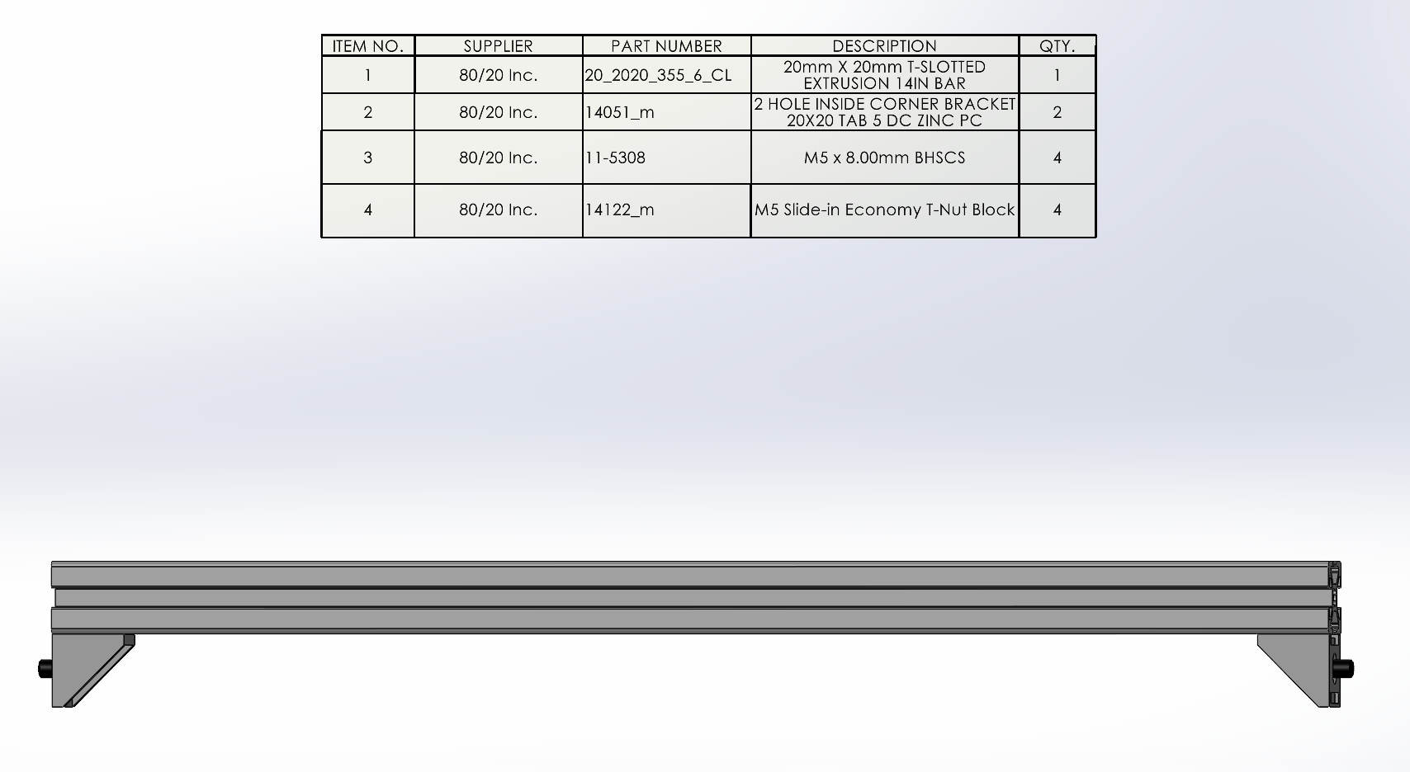
doc/source/Images/notUsed/14IN.png
