MolecularNeurobiology/LOOPER/doc/source/Images/notUsed/14IN_ex.png

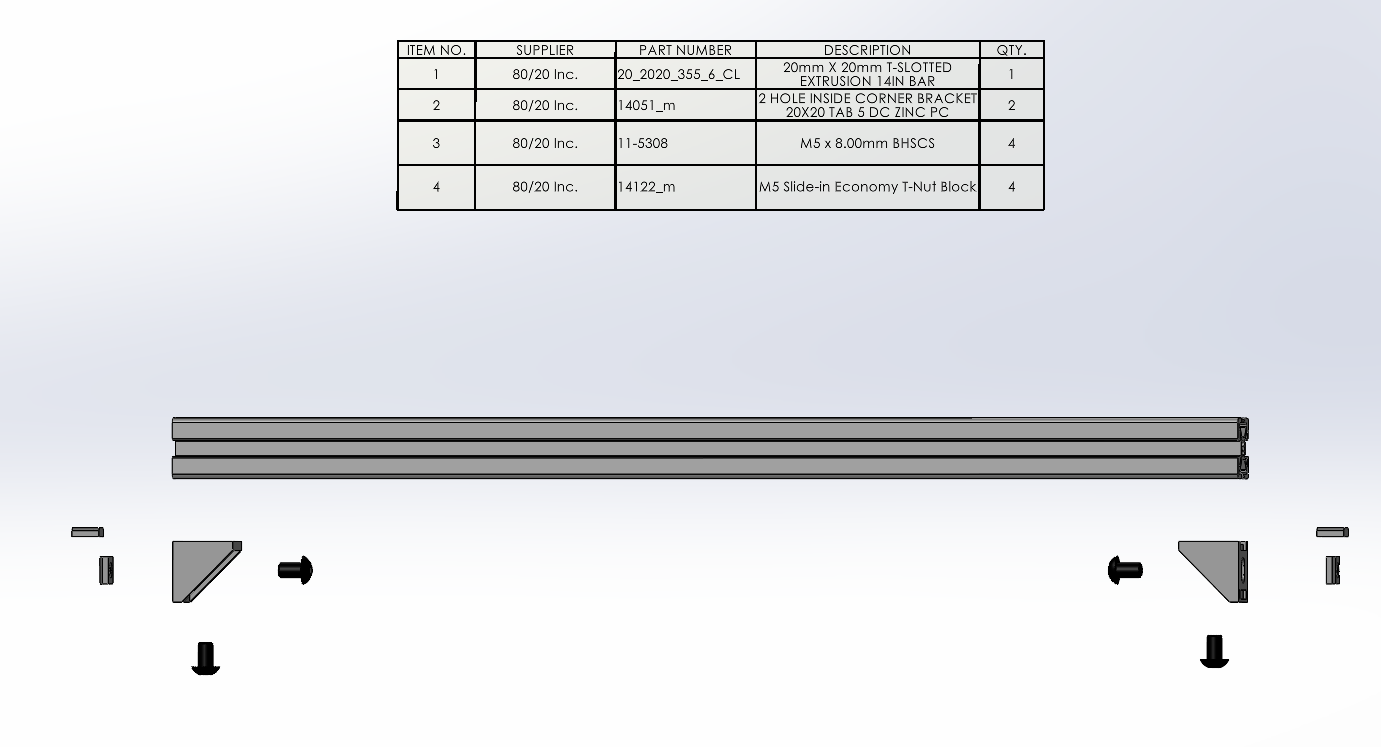
doc/source/Images/notUsed/14IN_ex.png
