MolecularNeurobiology/LOOPER/doc/source/Images/notUsed/Completed_Rig_Technical_Drawing_14IN_3.PNG

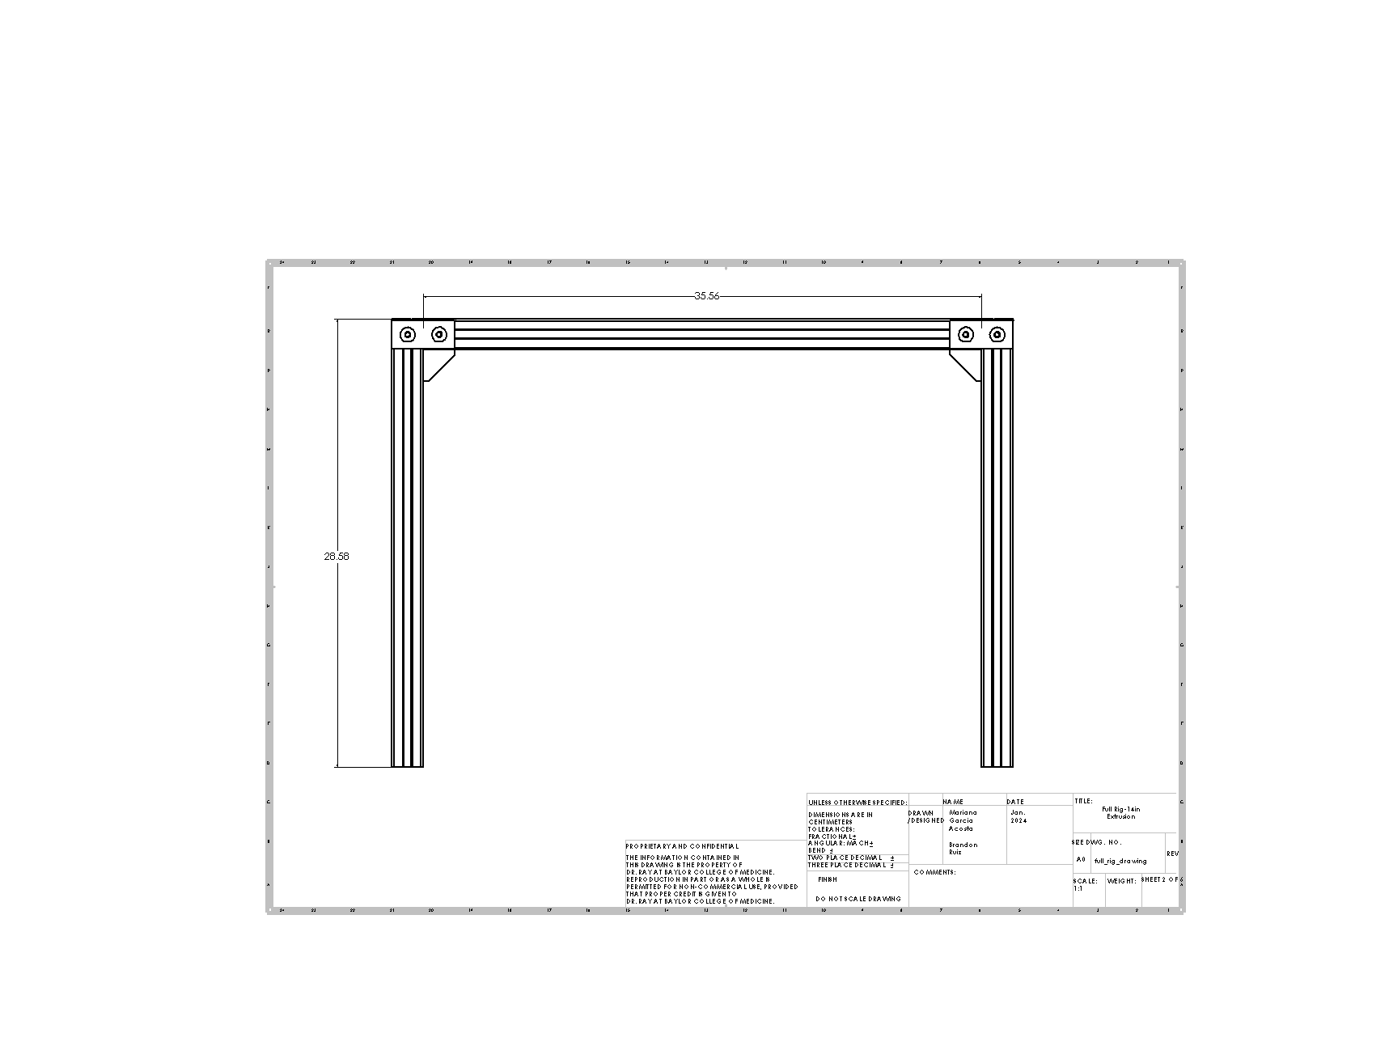
doc/source/Images/notUsed/Completed_Rig_Technical_Drawing_14IN_3.PNG
