MolecularNeurobiology/LOOPER/doc/source/Images/notUsed/Full_Rig_5.PNG

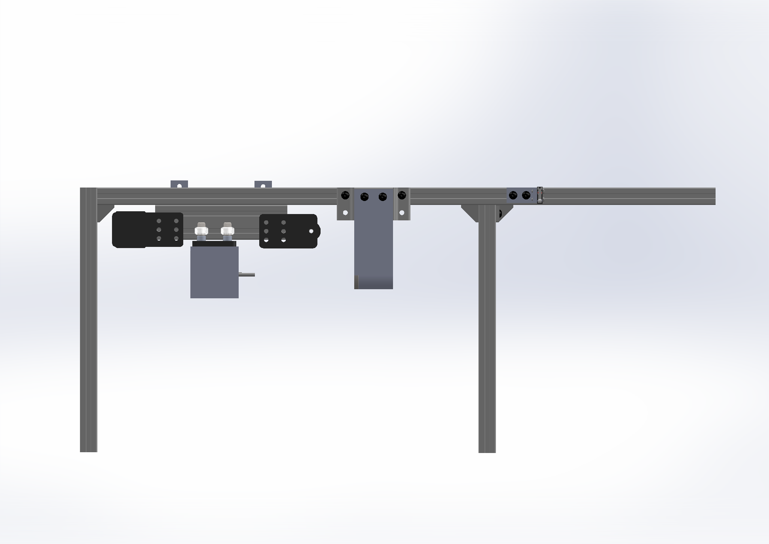
doc/source/Images/notUsed/Full_Rig_5.PNG
