MolecularNeurobiology/LOOPER/User_Manual/Making_ECG_Leads.rst

Making ECG Leads
================

This guide explains how to construct ECG leads for use with the LOOPER system.

Materials Required
------------------
- ECG Pins
- Tape
- Solder with Rosin Core
- Red, White, and Black cooper leads

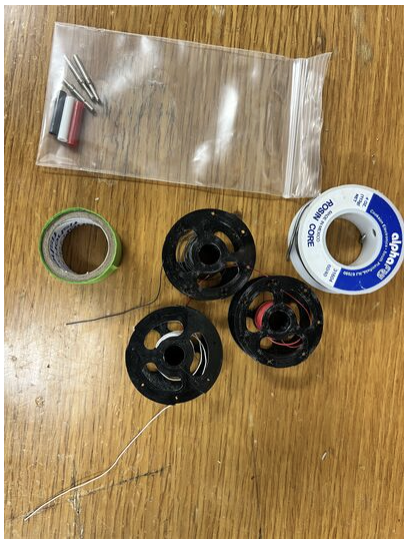
[picture p86: User_Manual/Images/ECG_Leads/Materials_Needed.png]


Equipment Required
------------------
- Soldering Iron
- Solder Flux
- Wire Cutters
- Clamp
- Brass
- Wet Sponge

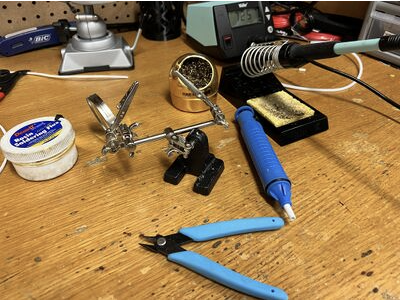
[picture p87: User_Manual/Images/ECG_Leads/Equipment_Needed.png]


Construction Steps
------------------

1. Clean the solder by dipping it into the solder flux and then whipping it off in the brass and the wet sponge.

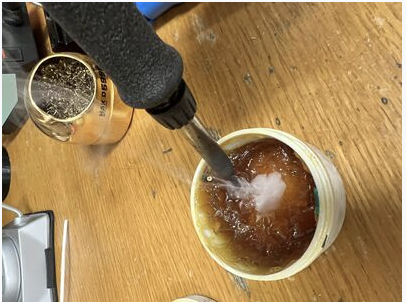
[picture p88: User_Manual/Images/ECG_Leads/Step1.png]
   

2. Apply tape to on side of the holders to cover the teeth. This prevents damage to the wire when it will be help by it.

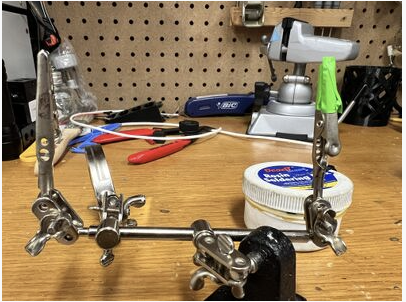
[picture p89: User_Manual/Images/ECG_Leads/Step2.png]
   

3. Place an ECG pin on the other side of the holder with the opening facing up.

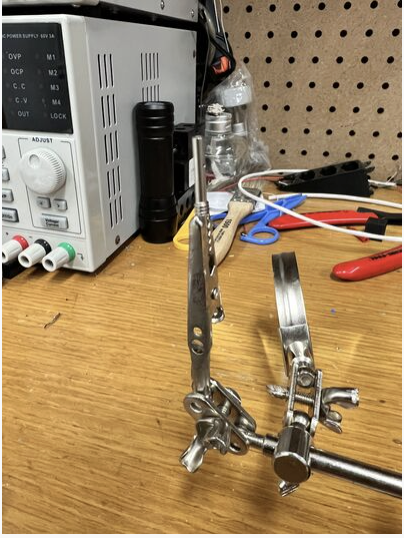
[picture p90: User_Manual/Images/ECG_Leads/Step3.png]
   

4. Using the wire cutters, cut a piece of the copper leads.

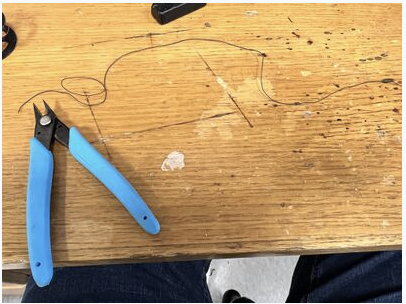
[picture p91: User_Manual/Images/ECG_Leads/Step4.png]
   

5. Strip a small amount of the lead on one side to expose the copper wiring.

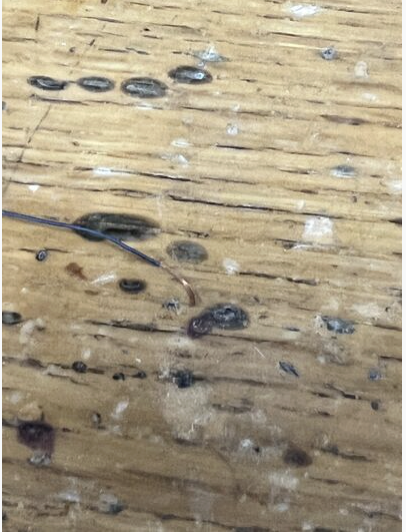
[picture p92: User_Manual/Images/ECG_Leads/Step5.png]
   

6. Use the holder, tape side, to hold the wire upright.

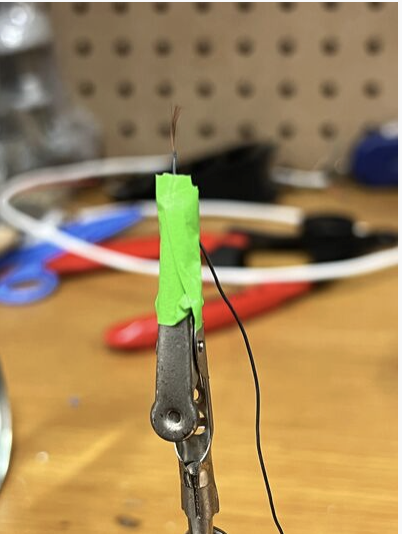
[picture p93: User_Manual/Images/ECG_Leads/Step6.png]
   

7. Use the solder and the soldering iron to coat the exposed copper wire with solder.

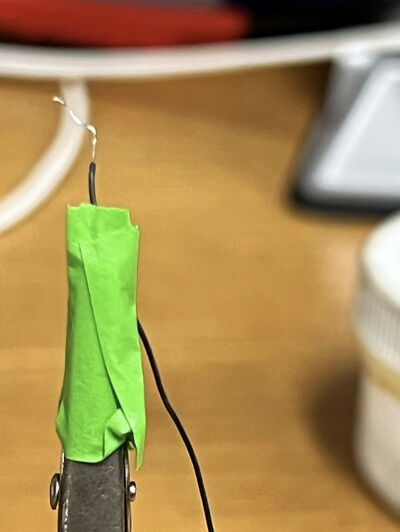
[picture p94: User_Manual/Images/ECG_Leads/Step7.png]
   

8. Add a small amount of solder to the the ECG pin.

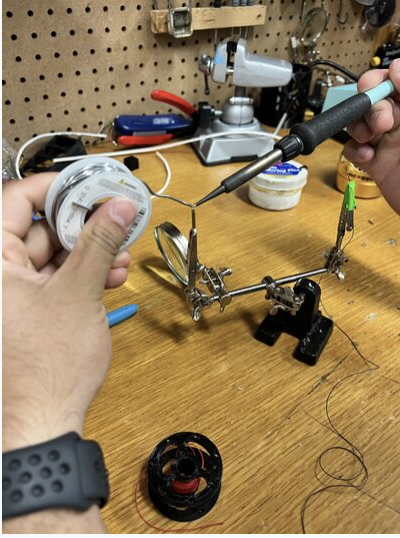
[picture p95: User_Manual/Images/ECG_Leads/Step8.png]
   

9. Melt the solder in the ECG pin and slide the coated wire in.

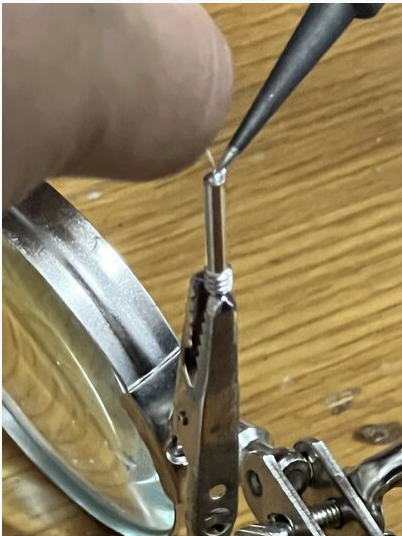
[picture p96: User_Manual/Images/ECG_Leads/Step9.png]
   

10. Strip a small amount of the ECG lead on the exposed side.

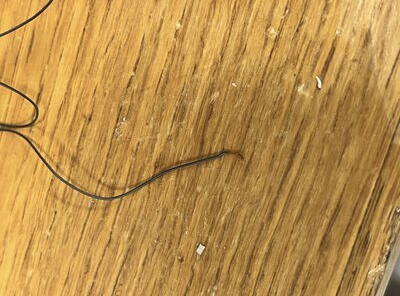
[picture p97: User_Manual/Images/ECG_Leads/Step10.png]
    

11. Use the Multimeter to test for connection.

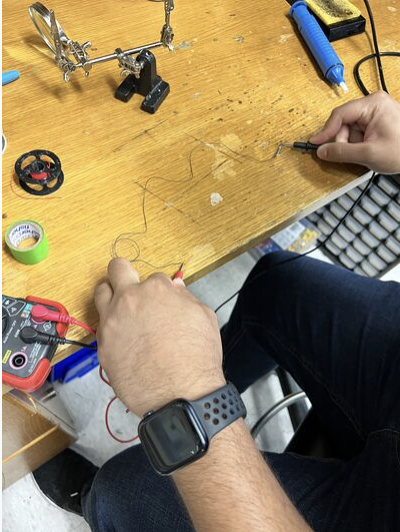
[picture p98: User_Manual/Images/ECG_Leads/Step11.png]
    

12. Apply the respective colored cap to the ECG pin and you are done.

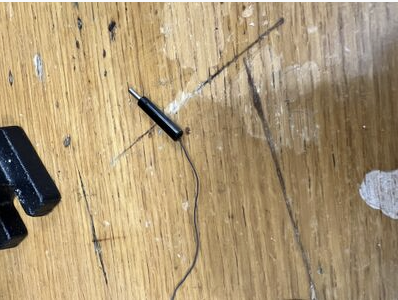
[picture p99: User_Manual/Images/ECG_Leads/Step12.png]
