MolecularNeurobiology/LOOPER/User_Manual/index.rst

LOOPER (Live Observation and Operation of Physiology Experiments with Robotics) User Manual
=============================================================================================

.. toctree::
   :maxdepth: 2
   :caption: Contents:

   User_Manual
   Database
   Making_ECG_Leads

Indices and tables
==================

* :ref:`genindex`
* :ref:`modindex`
* :ref:`search`
