MolecularNeurobiology/LOOPER/doc/build/html/_images/1_mouse_holder_assembly_ex.png

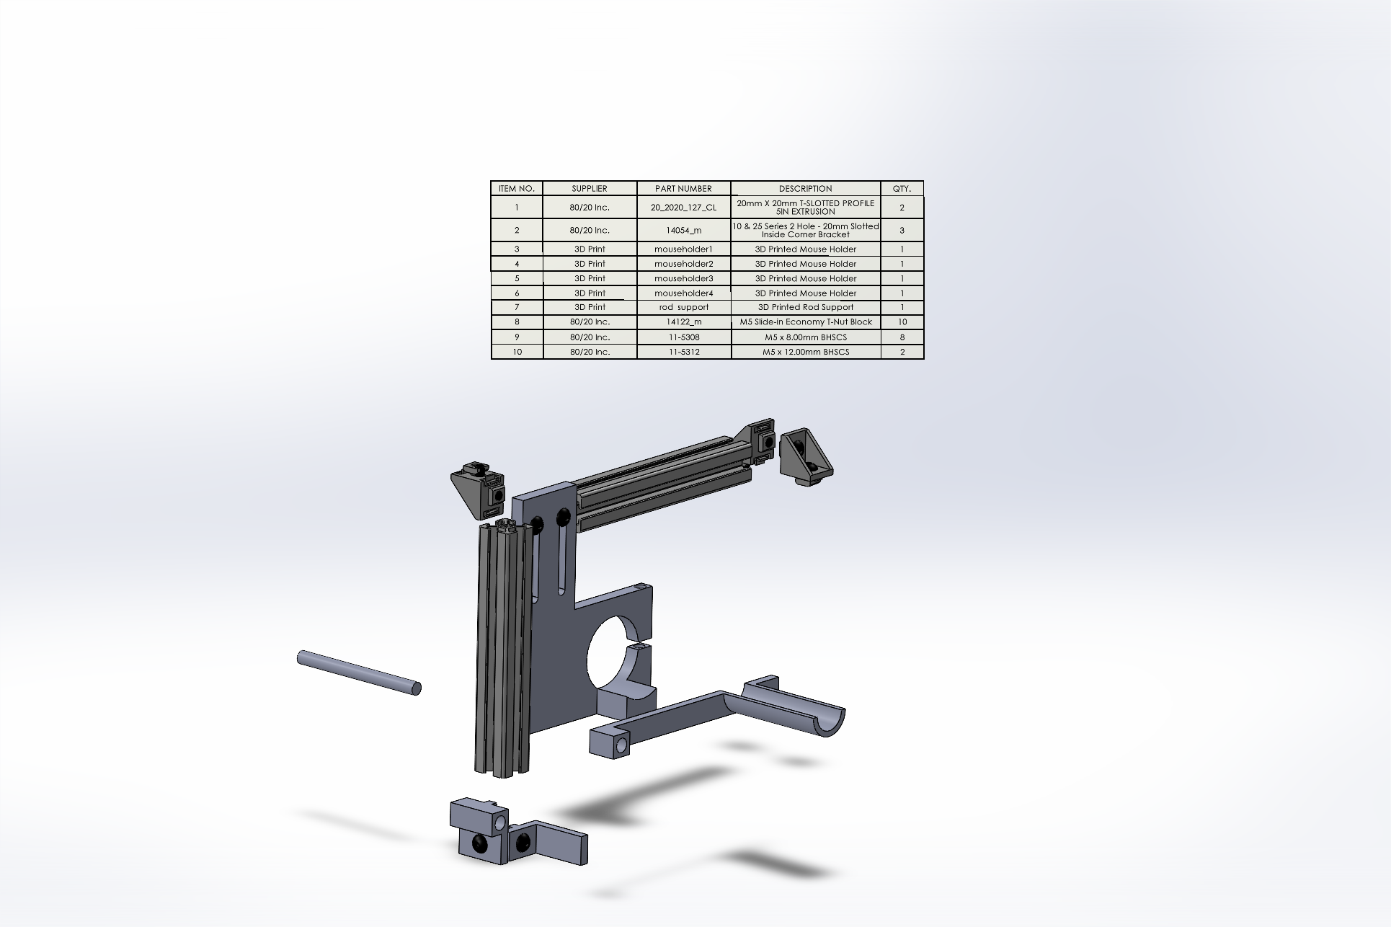
doc/build/html/_images/1_mouse_holder_assembly_ex.png
