MolecularNeurobiology/LOOPER/doc/build/html/_images/1_Water_Chamber_and_ECG_Holder_Assembly_ex.png

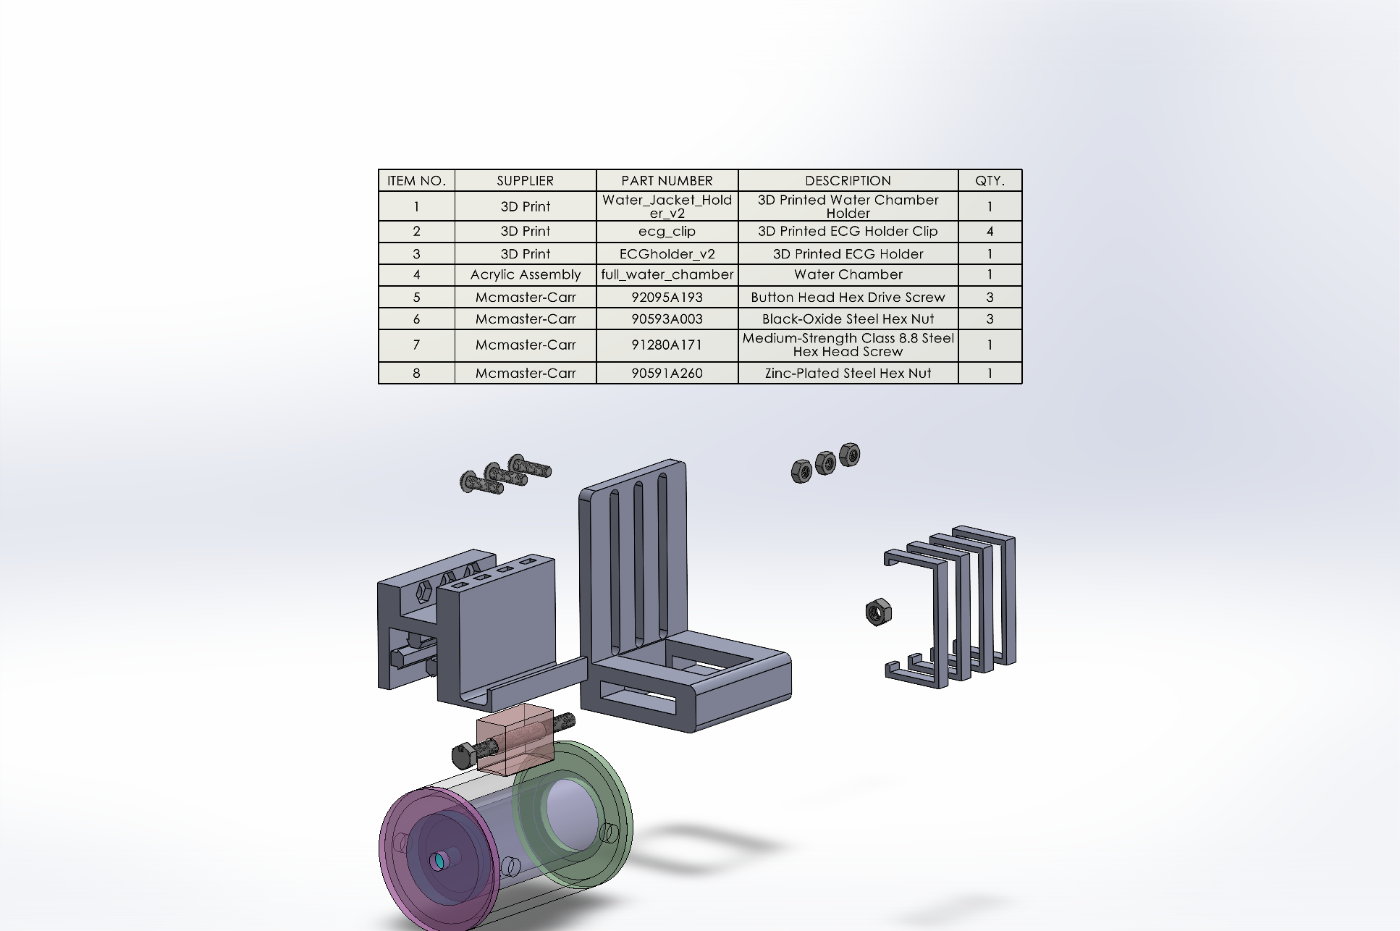
doc/build/html/_images/1_Water_Chamber_and_ECG_Holder_Assembly_ex.png
