MolecularNeurobiology/LOOPER/doc/build/html/_images/2_mouse_holder_assembly.png

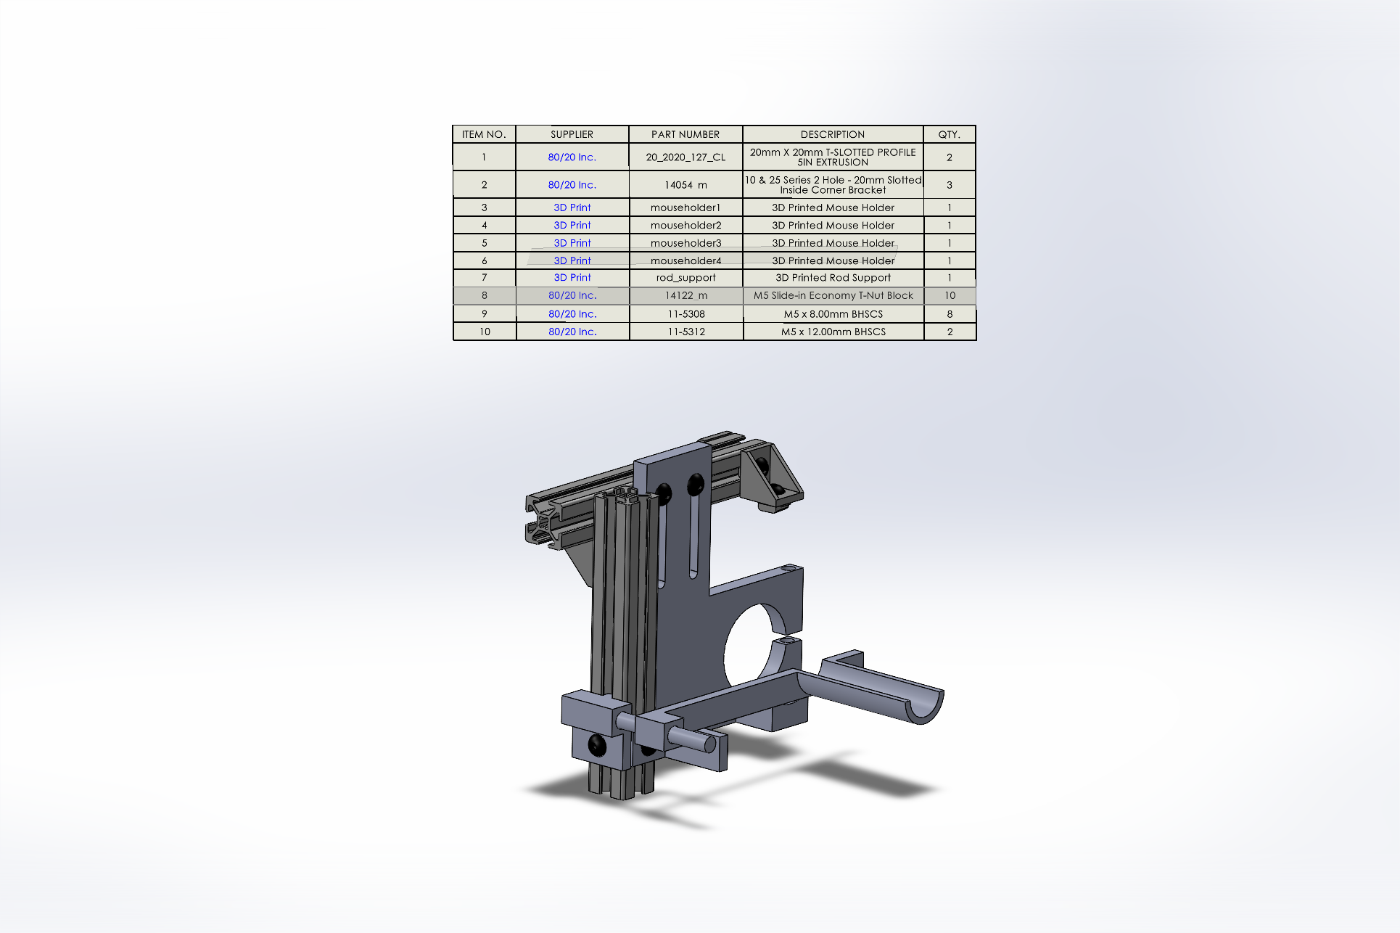
doc/build/html/_images/2_mouse_holder_assembly.png
