MolecularNeurobiology/LOOPER/doc/build/html/_images/2_Water_Chamber_and_ECG_Holder_Assembly.png

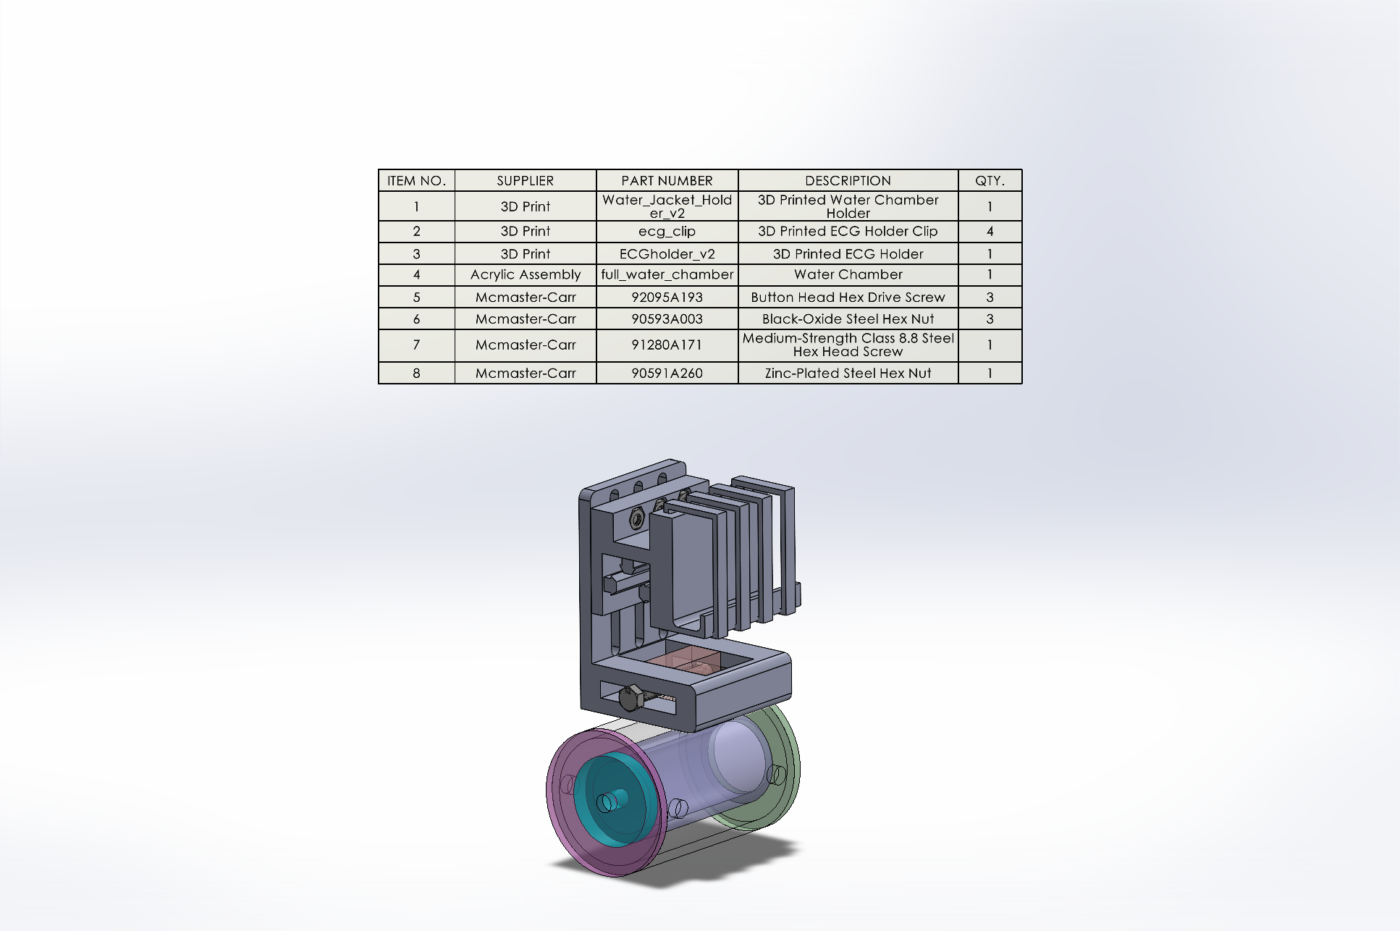
doc/build/html/_images/2_Water_Chamber_and_ECG_Holder_Assembly.png
