MolecularNeurobiology/LOOPER/doc/build/html/_images/6_buttonholder_syringe_assembly_ex.png

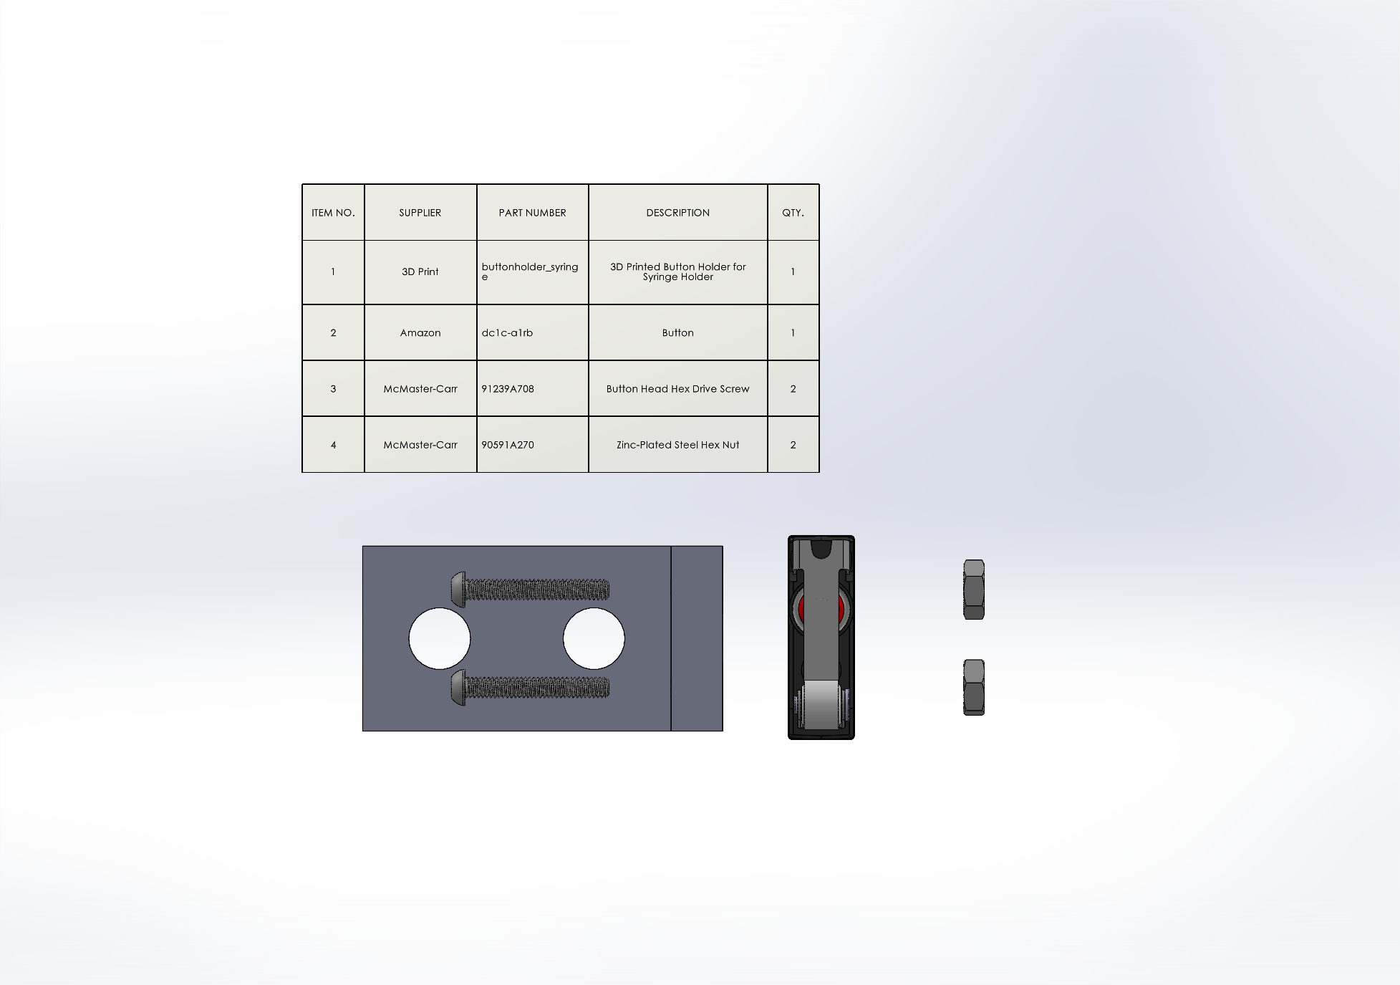
doc/build/html/_images/6_buttonholder_syringe_assembly_ex.png
