MolecularNeurobiology/LOOPER/doc/build/html/_images/7_buttonholder_syringe_assembly.png

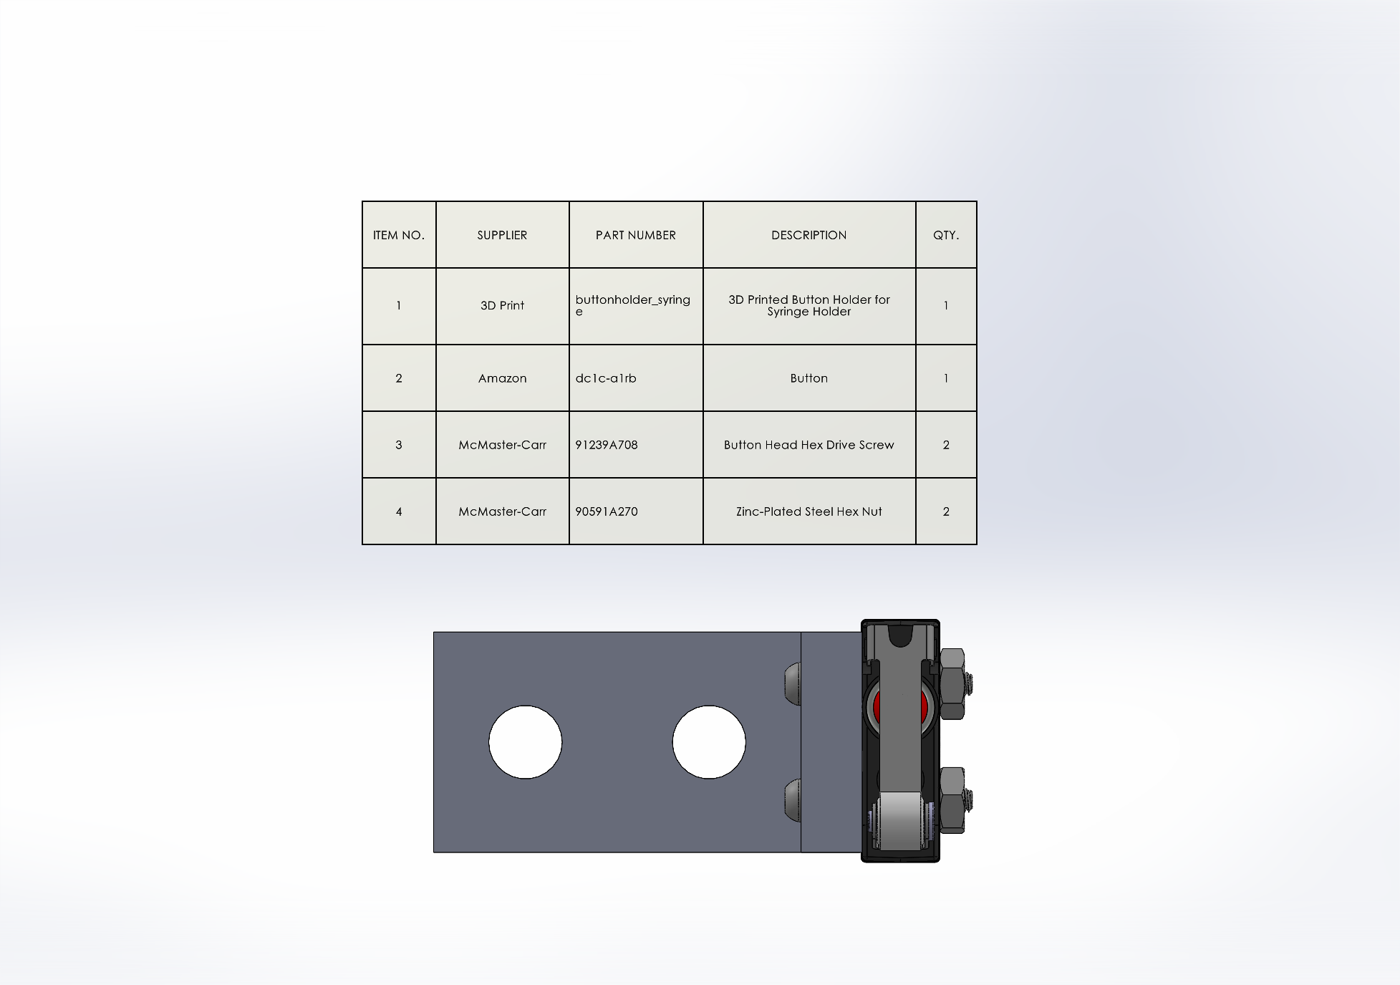
doc/build/html/_images/7_buttonholder_syringe_assembly.png
