MolecularNeurobiology/LOOPER/doc/build/html/_images/full_pipette_holder_drawings.png

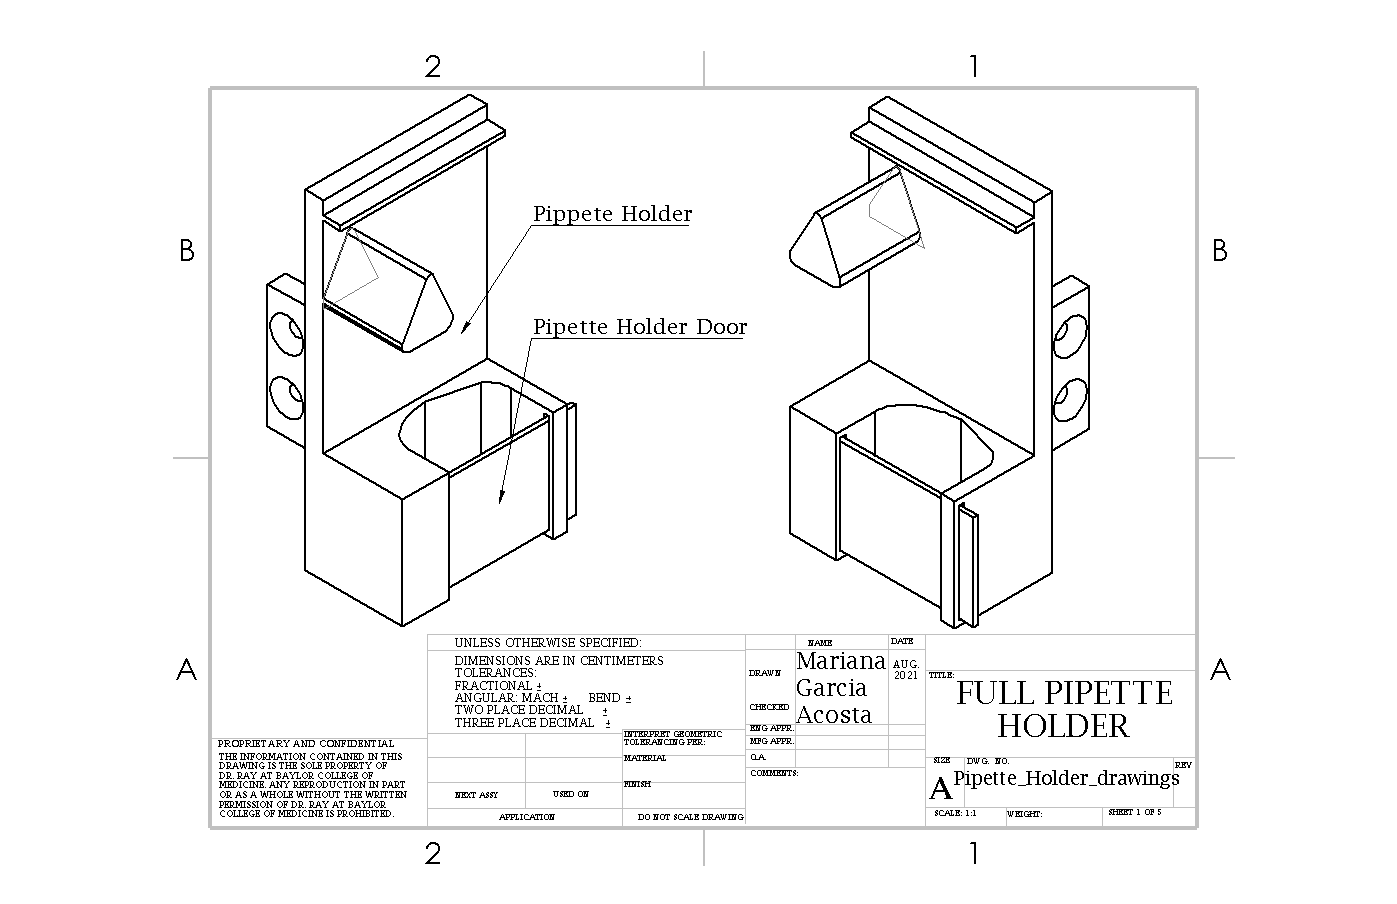
doc/build/html/_images/full_pipette_holder_drawings.png
