MolecularNeurobiology/LOOPER/doc/build/html/_images/Picture3.png

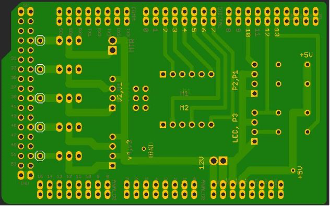
doc/build/html/_images/Picture3.png
