MolecularNeurobiology/LOOPER/doc/build/html/_images/pipette_holder_door_drawing.png

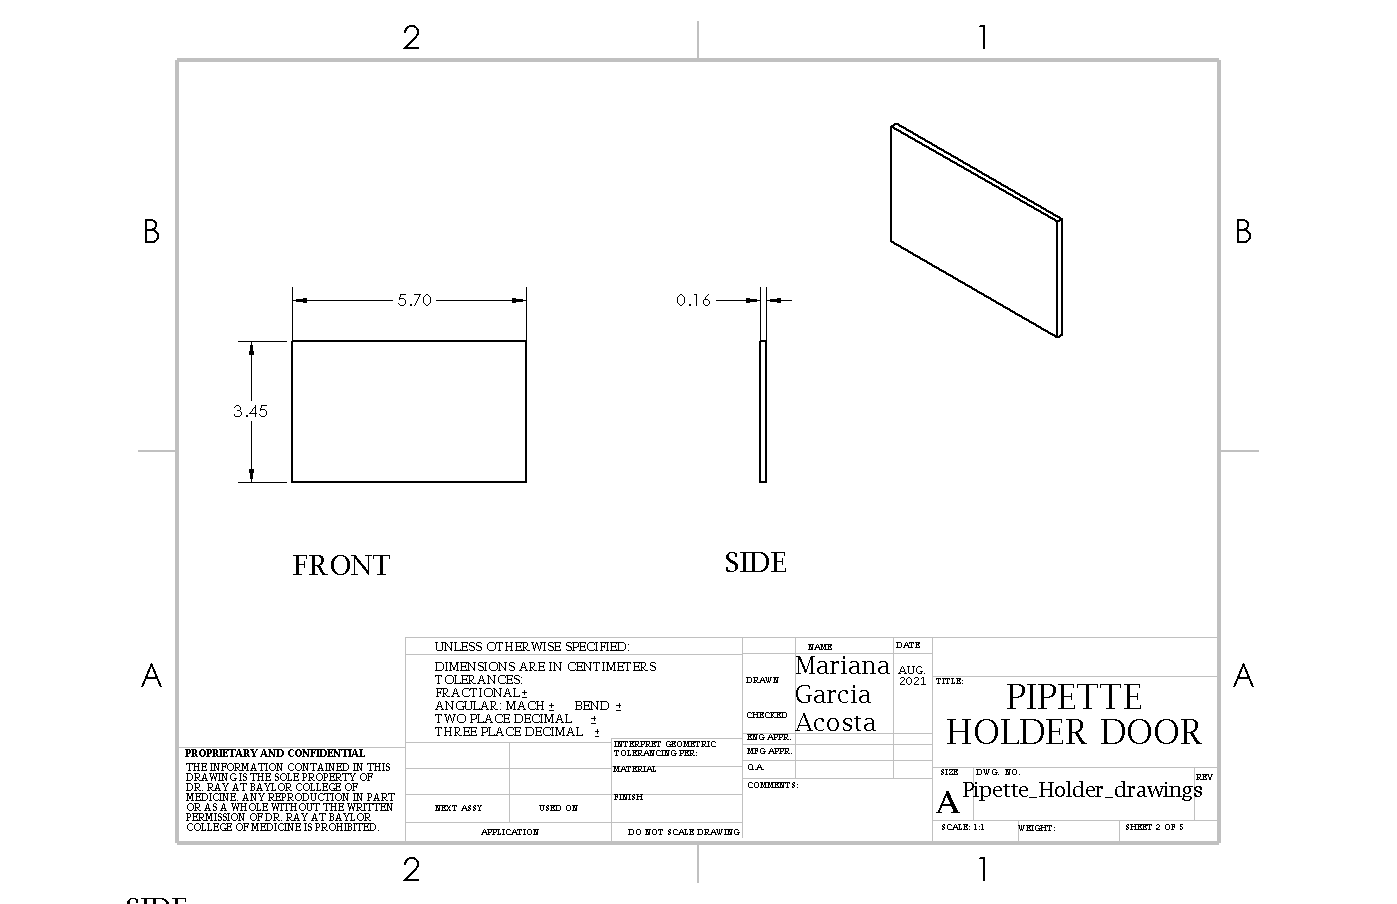
doc/build/html/_images/pipette_holder_door_drawing.png
