MolecularNeurobiology/LOOPER/User_Manual/Images/User_Manual/ECG_Leads.png

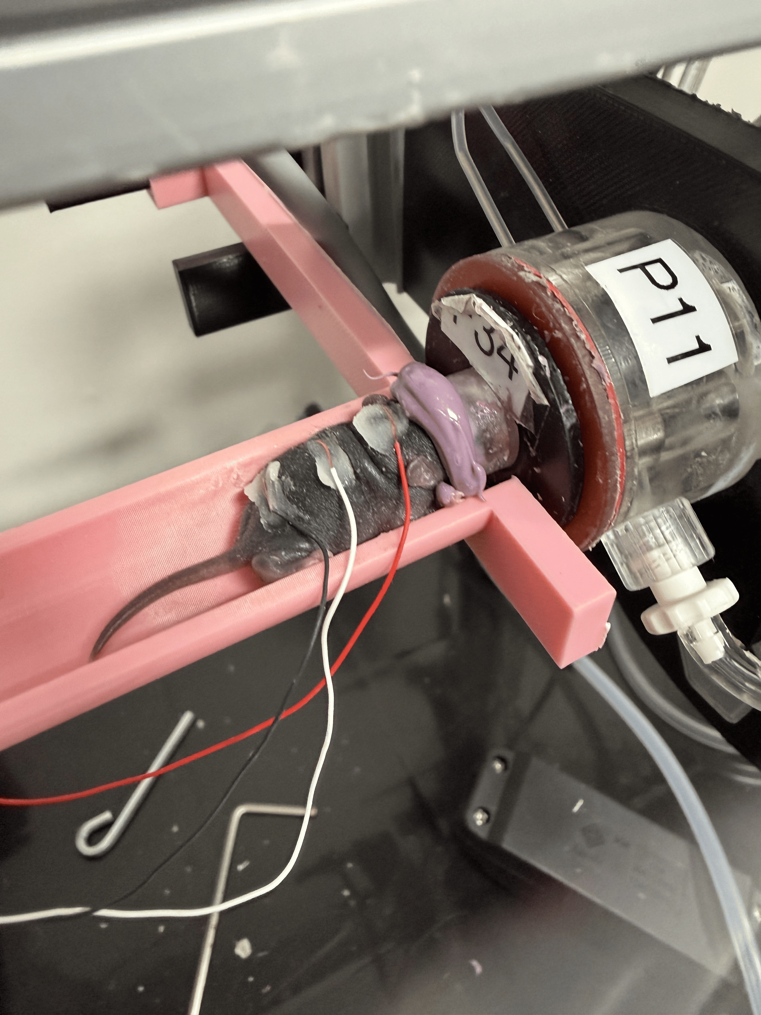
User_Manual/Images/User_Manual/ECG_Leads.png
