MolecularNeurobiology/LOOPER/doc/source/Images/6_PippetteCalibrator/pipette_calibrator_3.PNG

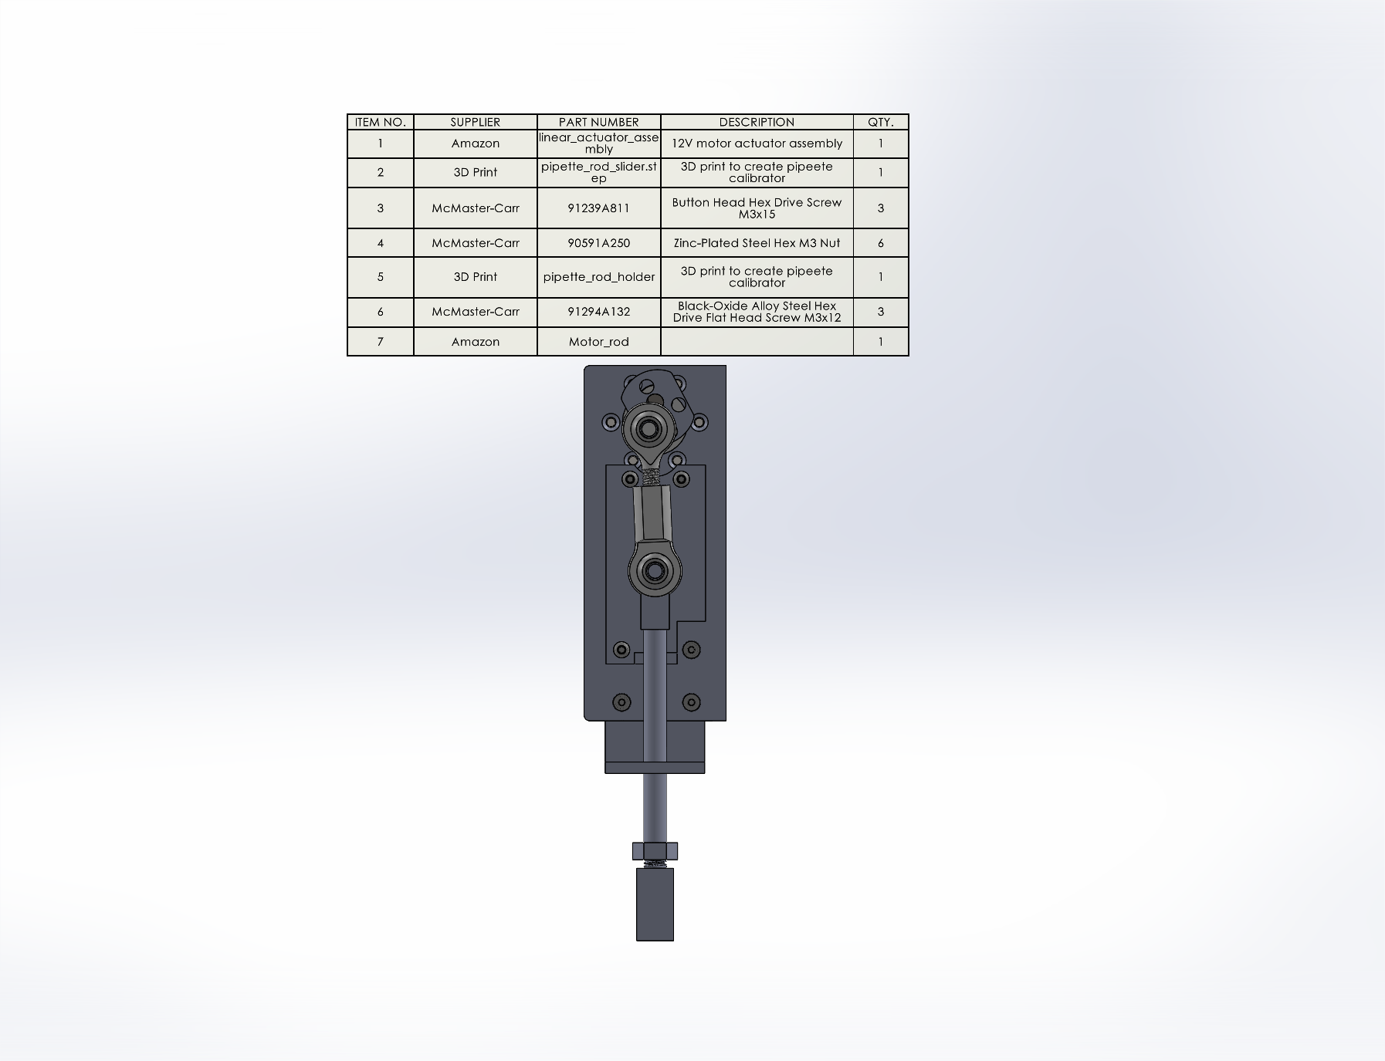
doc/source/Images/6_PippetteCalibrator/pipette_calibrator_3.PNG
