MolecularNeurobiology/LOOPER/PrintedCircuitBoard/RAY_shield_V4.brd

## EAGLE design PrintedCircuitBoard/RAY_shield_V4.brd (2024-01-09)

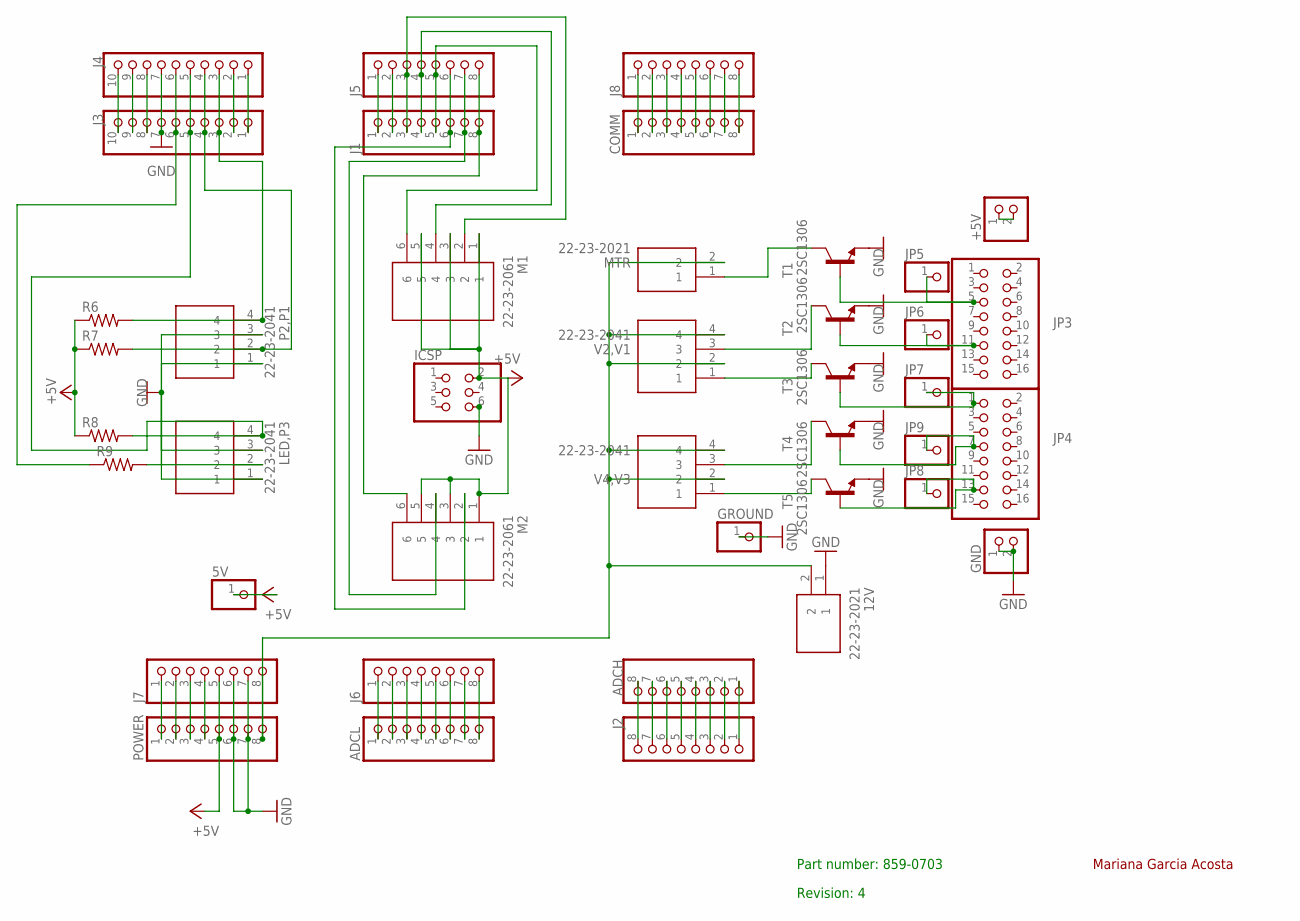
[picture p169: schematic RAY_shield_V4.sch]

Parts:
5V: PINHD-1X1; 1X01
12V: 22-23-2021; SHDR2W87P0X254_1X2_493X635X110
+5V: PINHD-1X2; 1X02
ADCH: PINHD-1X8TH; 1X08-TH
ADCL: PINHD-1X8TH; 1X08-TH
COMM: PINHD-1X8TH; 1X08-TH
GND: PINHD-1X2; 1X02
GROUND: PINHD-1X1; 1X01
ICSP: PINHD-2X3; 2X03
J1, J2, J5, J6, J7, J8: PINHD-1X8TH; 1X08-TH
J3, J4: PINHD-1X10TH; 1X10-TH
JP3, JP4: PINHD-2X8; 2X08
JP5, JP6, JP7, JP8, JP9: PINHD-1X1; 1X01
LED,P3: 22-23-2041; SHDR4W87P0X254_1X4_1001X635X11
M1, M2: 22-23-2061; SHDR6W87P0X254_1X6_1509X635X11
MTR: 22-23-2021; SHDR2W87P0X254_1X2_493X635X110
P2,P1: 22-23-2041; SHDR4W87P0X254_1X4_1001X635X11
POWER: PINHD-1X8TH; 1X08-TH
R6, R7, R8, R9: R-US_0207/7; 0207/7
T1, T2, T3, T4, T5: 2SC1306; TO220BV
V2,V1, V4,V3: 22-23-2041; SHDR4W87P0X254_1X4_1001X635X11

Connections:
+5V: 5V.1, ICSP.2, J7.5, M1.1, M1.3, M1.5, M2.1, M2.3, M2.5, POWER.5, R6.1, R7.1, R8.1
+12V: 12V.2, J7.8, MTR.2, POWER.8, V2,V1.2, V2,V1.4, V4,V3.2, V4,V3.4
GND: 12V.1, GND.1, GND.2, GROUND.1, ICSP.6, J3.7, J4.7, J7.6, J7.7, LED,P3.1, LED,P3.3, P2,P1.1, P2,P1.3, POWER.6, POWER.7, T1.3 (E), T2.3 (E), T3.3 (E), T4.3 (E), T5.3 (E)
unnamed: +5V.1, +5V.2
unnamed: J3.1, J4.1
unnamed: J3.6, J4.6, R9.1
unnamed: JP3.5, JP5.1, T1.1 (B)
unnamed: J3.4, J4.4, P2,P1.2, R7.2
unnamed: J3.2, J4.2
unnamed: J3.3, J4.3, P2,P1.4, R6.2
unnamed: J1.1, J5.1
unnamed: J1.2, J5.2
unnamed: J1.3, J5.3, M1.2
unnamed: J1.4, J5.4, M1.4
unnamed: J1.5, J5.5, M1.6
unnamed: J1.6, J5.6, M2.2
unnamed: J1.7, J5.7, M2.4
unnamed: J1.8, J5.8, M2.6
unnamed: JP3.11, JP6.1, T2.1 (B)
unnamed: JP4.7, JP9.1, T4.1 (B)
unnamed: ADCL.1, J6.1
unnamed: ADCL.2, J6.2
unnamed: ADCL.3, J6.3
unnamed: ADCL.4, J6.4
unnamed: ADCL.5, J6.5
unnamed: ADCL.6, J6.6
unnamed: JP4.1, JP7.1, T3.1 (B)
unnamed: JP4.13, JP8.1, T5.1 (B)
unnamed: MTR.1, T1.2 (C)
unnamed: T2.2 (C), V2,V1.3
unnamed: T3.2 (C), V2,V1.1
unnamed: T4.2 (C), V4,V3.3
unnamed: T5.2 (C), V4,V3.1
unnamed: LED,P3.2, R9.2
unnamed: ADCL.7, J6.7
unnamed: ADCL.8, J6.8
unnamed: ADCH.1, J2.1
unnamed: ADCH.2, J2.2
unnamed: ADCH.3, J2.3
unnamed: ADCH.4, J2.4
unnamed: ADCH.5, J2.5
unnamed: ADCH.6, J2.6
unnamed: J7.4, POWER.4
unnamed: J3.9, J4.9
unnamed: ADCH.7, J2.7
unnamed: ADCH.8, J2.8
unnamed: COMM.1, J8.1
unnamed: COMM.2, J8.2
unnamed: COMM.3, J8.3
unnamed: COMM.4, J8.4
unnamed: COMM.5, J8.5
unnamed: COMM.6, J8.6
unnamed: COMM.7, J8.7
unnamed: COMM.8, J8.8
unnamed: J3.5, J4.5, LED,P3.4, R8.2
unnamed: J7.2, POWER.2
unnamed: J7.1, POWER.1
unnamed: J3.8, J4.8
unnamed: J3.10, J4.10
RESET: J7.3, POWER.3

Notes on the sheet:
Mariana Garcia Acosta
Part number: 859-0703
Revision: 4

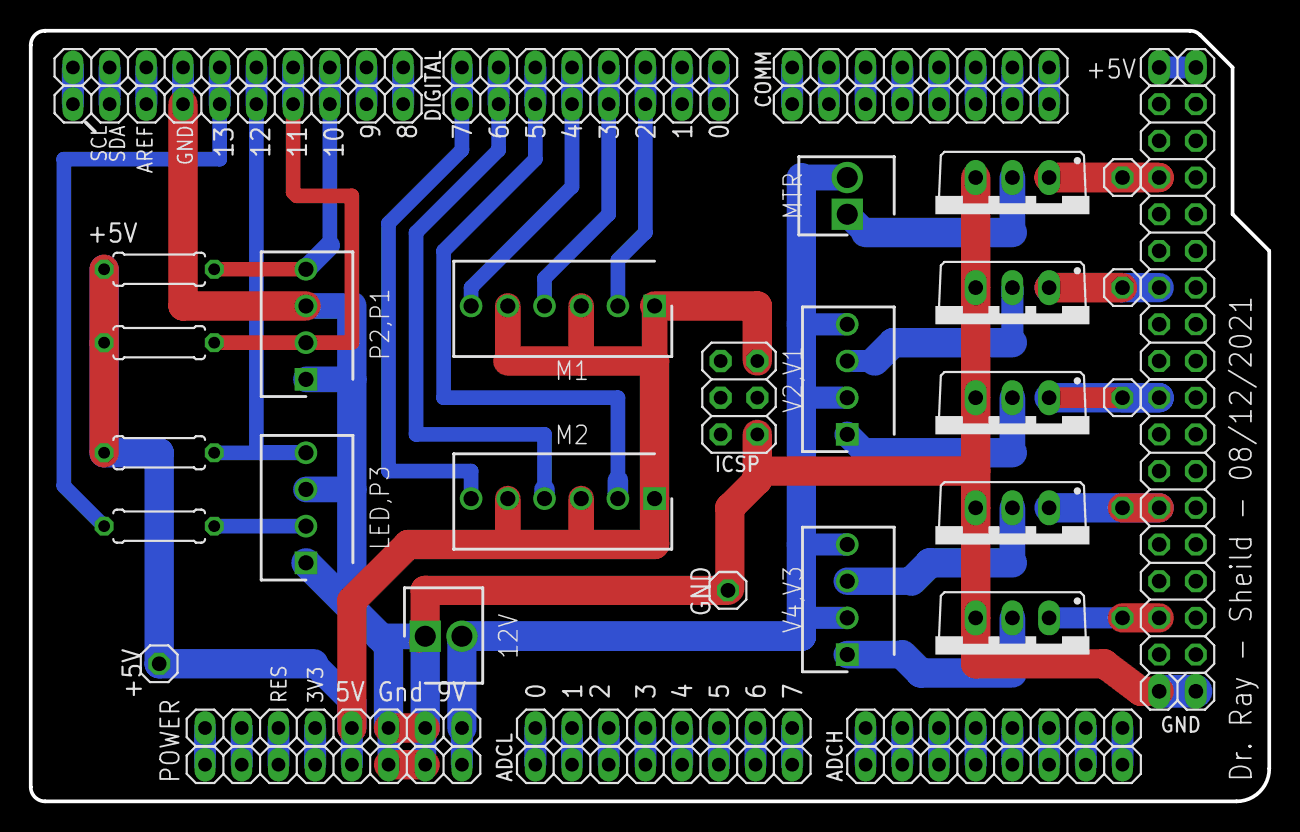
[picture p170: board RAY_shield_V4.brd from above]

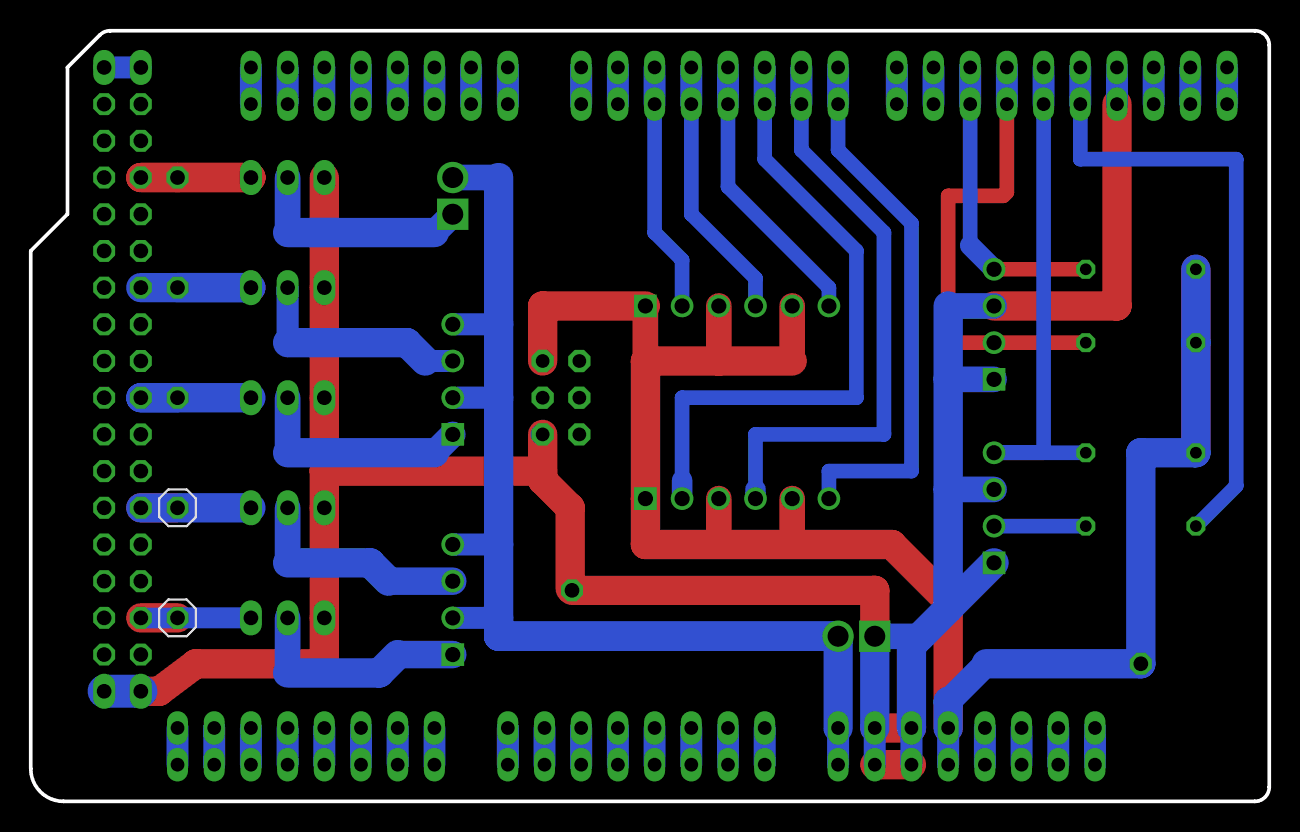
[picture p171: board RAY_shield_V4.brd from below]

Board: 2 copper layers, 85.7 x 53.3 mm, 41 parts (2 on the bottom side), 60 nets.
