MolecularNeurobiology/LOOPER/GEMouse.py

# -*- coding: utf-8 -*-
"""
GEMouse

A basic physiological signal simulator for raspberry pi that
provides a Graphical Interface for adjusting settings.

For use with the Ray Lab automated autoresuscitation system and PCC software.

created by Christopher S Ward (C) 2022

Features include
*customizable settings for duration and rate of simulated signals
*control of RPi pin-out for signal simulations
*listening to RPi pin-in for trigger signal (indicating gas challenge)
*GUI for customizing settings, buttons for hold mode or 'emouse' challenge runs


updates
v1.0.1
* adjust spacing to address font cut off issue of header and labels
* shift button placement to reduce window size
* add indicator of current mode
* add indicator of textedits that have been edited and need set confirmed
* adjust duration timer so that it won't trigger re-entry to cycling (assign to
  variable and use .stop method)

"""

__version__ = "1.1.1"

# %% import libraries
from PySide6 import QtGui, QtWidgets
from PySide6.QtCore import Slot, Qt, QThreadPool, QTimer
from PySide6.QtWidgets import QMainWindow, QApplication, QLabel, QPushButton
from PySide6.QtWidgets import QTextEdit
import sys
import re


try:
    #    import RPi.GPIO as GPIO
    import gpiozero

except:
    print("RPi.GPIO library unavailable - Are you using a Pi?")

    class PIN:
        def __init__(self, pin):
            value = 0
            is_pressed = 0

    class GPIO:
        def __init__(self):
            BOARD = 1
            OUT = 1
            IN = 1
            HIGH = 5
            LOW = 0
            simulated = True

        def LED(self, pin_text):
            return PIN(pin_text)

        def BUTTON(self, pin_text):
            return PIN(pin_text)

        def setmode(a):
            # print(a)
            pass

        def setup(a, b):
            # print(a)
            pass

        def input(a):
            return 0

        def output(a, b):
            # print(a)
            pass

        def cleanup():
            # print('a')
            pass

        def setwarnings(flag):
            # print('False')
            pass


# %% setup Raspberry Pi pins

# GPIO.setmode(GPIO.BOARD)
# GPIO.setup(3, GPIO.OUT)
# GPIO.setup(5, GPIO.OUT)
# GPIO.setup(7, GPIO.IN)
breath_pin = gpiozero.LED(2)
heart_pin = gpiozero.LED(3)
sense_pin = gpiozero.Button(4, pull_up = False)


# %% functions


def cycler_prep(instance, label):
    # print(f'cycler_prep : {label}')
    VF = float(getattr(instance, f"{label}_VF"))
    VF_IS = float(getattr(instance, f"{label}_VF_IS"))
    HR = float(getattr(instance, f"{label}_HR"))
    HR_IS = float(getattr(instance, f"{label}_HR_IS"))

    VF = min(VF, 1000)
    HR = min(HR, 1000)

    VF_IS = min(max(0.33, VF_IS), 3)
    HR_IS = min(max(0.33, HR_IS), 3)

    # convert VF and HR to TT and RR (msec)
    if float(VF) == 0:
        TT = 999999
    else:
        TT = int(60 / float(VF) * 1000)

    if float(HR) == 0:
        RR = 999999
    else:
        RR = int(60 / float(HR) * 1000)

    if float(VF) == 0:
        TT_on = 20
        TT_2 = 0
        TT_2_on = 20
    else:
        TT_on = int(TT / 2)
        TT_2 = int(TT + TT * float(VF_IS))
        TT_2_on = int(TT_2 / 2)

    if float(HR) == 0:
        RR_on = 20
        RR_2 = 0
        RR_2_on = 20
    else:
        RR_on = 20
        RR_2 = int(RR + RR * float(HR_IS))
        RR_2_on = 20

    return {
        "TT": {
            1: {"on_limit": TT_on, "beat_limit": TT},
            0: {"on_limit": TT_2_on, "beat_limit": TT_2},
        },
        "RR": {
            1: {"on_limit": RR_on, "beat_limit": RR},
            0: {"on_limit": RR_2_on, "beat_limit": RR_2},
        },
    }


def pulse(instance, borh, pulse_timer, timings_dict, pulse_toggle, pin=None):
    pulse_timer += 1
    on_limit = timings_dict[pulse_toggle]["on_limit"]
    beat_limit = timings_dict[pulse_toggle]["beat_limit"]

    if pulse_timer == 1:
        getattr(instance, borh).setStyleSheet("background-color: red")
        # GPIO.output(pin, GPIO.HIGH)
        pin.value = 1

    elif pulse_timer == on_limit:
        getattr(instance, borh).setStyleSheet("background-color: black")
        # GPIO.output(pin, GPIO.LOW)
        pin.value = 0
    elif pulse_timer == beat_limit:
        pulse_timer = 0
        pulse_toggle = int(not (bool(pulse_toggle)))

    return pulse_timer, pulse_toggle


def trigger_check(pin=None, text_widget=None):
    gpio_reading = pin.is_pressed
    text_widget.setText(f"input pin: {gpio_reading}")

    if gpio_reading:
        return 1
    else:
        return 0


def pin_reset(pin_list):
    for i in pin_list:
        # GPIO.output(i, GPIO.LOW)
        i.value = 0


def widget_builder(
    instance,
    state,
    metrics,
    size=[(75, 25), (75, 25)],
    row_increment=25,
    start_position=(0, 0),
):

    setattr(instance, f"{state}_label", QLabel(f"<h3>{state}</h3>", parent=instance))
    getattr(instance, f"{state}_label").setFixedSize(
        size[0][0] + size[1][0], size[0][1]
    )
    getattr(instance, f"{state}_label").move(*start_position)
    getattr(instance, f"{state}_label").setAlignment(Qt.AlignCenter)

    setattr(instance, f"{state}_set", QPushButton("Set", parent=instance))
    getattr(instance, f"{state}_set").setFixedSize(25, row_increment * len(metrics))
    getattr(instance, f"{state}_set").move(
        start_position[0] + size[0][0] + size[1][0], start_position[1] + row_increment
    )
    getattr(instance, f"{state}_set").clicked.connect(
        lambda: widget_action(instance, state, metrics)
    )
    row = 0

    for metric in metrics:
        label = f"{state}_{metric}"

        row += 1
        position = (start_position[0], start_position[1] + row * row_increment)

        setattr(instance, f"{label}_label", QLabel(metric, parent=instance))
        setattr(
            instance,
            f"{label}_edit",
            QTextEdit(str(getattr(instance, label)), instance),
        )

        getattr(instance, f"{label}_label").setFixedSize(*size[0])
        getattr(instance, f"{label}_edit").setFixedSize(*size[1])
        getattr(instance, f"{label}_label").move(*position)
        getattr(instance, f"{label}_edit").move(position[0] + size[0][0], position[1])
        getattr(instance, f"{label}_edit").textChanged.connect(
            lambda: widget_flag(instance, state)
        )


def widget_action(instance, state, metrics):

    for metric in metrics:
        label = f"{state}_{metric}"
        print(f"\t{metric}", getattr(instance, label), "->")
        setattr(instance, label, getattr(instance, f"{label}_edit").toPlainText())
        print(getattr(instance, label))
    widget_unflag(instance, state)


def widget_flag(instance, state):
    getattr(instance, f"{state}_set").setStyleSheet("background-color: red")


def widget_unflag(instance, state):
    getattr(instance, f"{state}_set").setStyleSheet("background-color: green")


# %% class for gui
class MainWindow(QMainWindow):
    def __init__(self):
        super(MainWindow, self).__init__()

        self.setWindowTitle("GUI Electronic Mouse - v{}".format(__version__))
        self.setGeometry(10, 10, 675, 750)
        self.move(100, 100)
        self.Label_1 = QLabel(
            "<h1>GUI Electronic Mouse - v{}</h1>".format(__version__), parent=self
        )
        self.Label_1.setFixedSize(675, 90)
        self.Label_1.move(0, 10)
        self.Label_1.setAlignment(Qt.AlignCenter)

        # settings/attributes
        self.running = 0
        self.repeat_challenges = 0

        self.state = "off"
        self.state_label = QLabel(f"<h1>{self.state}</h1>", parent=self)
        self.state_label.setFixedSize(675, 90)
        self.state_label.move(0, 650)
        self.state_label.setAlignment(Qt.AlignCenter)
        self.state_label.setText(f"<h1>{self.state}</h1>")

        self.pin_input_reading = QLabel("input pin: N/A", parent=self)
        self.pin_input_reading.setFixedSize(685, 90)
        self.pin_input_reading.move(0, 675)
        self.pin_input_reading.setAlignment(Qt.AlignCenter)
        self.pin_input_reading.setText("input pin: N/A")

        self.cycle_duration = 0.001
        self.qthreadpool = QThreadPool()
        self.qthreadpool.setMaxThreadCount(1)

        self.looptimer = QTimer(self, interval=1)
        self.looptimer.timeout.connect(self.run)
        self.singleshot_timer = QTimer(self, interval=1000)
        self.singleshot_timer.setSingleShot(True)
        self.singleshot_timer.timeout.connect(self.advance_state)
        self.duration = 0

        self.calibration_VF = 180
        self.calibration_VF_IS = 0
        self.calibration_HR = 240
        self.calibration_HR_IS = 0
        self.calibration_duration = 120
        widget_builder(
            self,
            "calibration",
            ["VF", "VF_IS", "HR", "HR_IS", "duration"],
            start_position=(50, 100),
        )

        self.habituation_VF = 220
        self.habituation_VF_IS = 2
        self.habituation_HR = 600
        self.habituation_HR_IS = 2
        self.habituation_duration = 5
        widget_builder(
            self,
            "habituation",
            ["VF", "VF_IS", "HR", "HR_IS", "duration"],
            start_position=(50, 300),
        )

        self.baseline_VF = 180
        self.baseline_VF_IS = 0
        self.baseline_HR = 500
        self.baseline_HR_IS = 0
        self.baseline_duration = 120
        widget_builder(
            self,
            "baseline",
            ["VF", "VF_IS", "HR", "HR_IS", "duration"],
            start_position=(50, 475),
        )

        self.ready_VF = 180
        self.ready_VF_IS = 0
        self.ready_HR = 500
        self.ready_HR_IS = 0
        self.ready_duration = 5
        widget_builder(
            self,
            "ready",
            ["VF", "VF_IS", "HR", "HR_IS", "duration"],
            start_position=(250, 100),
        )

        self.hypervent_VF = 300
        self.hypervent_VF_IS = 0
        self.hypervent_HR = 400
        self.hypervent_HR_IS = 0
        self.hypervent_delay = -1
        self.hypervent_duration = 15
        widget_builder(
            self,
            "hypervent",
            ["VF", "VF_IS", "HR", "HR_IS", "delay", "duration"],
            start_position=(450, 100),
        )

        self.apnea_VF = 0
        self.apnea_VF_IS = 0
        self.apnea_HR = 0
        self.apnea_HR_IS = 0
        self.apnea_duration = 15
        widget_builder(
            self,
            "apnea",
            ["VF", "VF_IS", "HR", "HR_IS", "duration"],
            start_position=(250, 300),
        )

        self.recovery_VF = 120
        self.recovery_VF_IS = 0
        self.recovery_HR = 300
        self.recovery_HR_IS = 0
        self.recovery_duration = 5
        self.recovery_rounds = 5
        widget_builder(
            self,
            "recovery",
            ["VF", "VF_IS", "HR", "HR_IS", "duration", "rounds"],
            start_position=(450, 300),
        )

        self.delay_for_trigger = 0

        self.delay_VF = self.ready_VF
        self.delay_VF_IS = self.ready_VF_IS
        self.delay_HR = self.ready_HR
        self.delay_HR_IS = self.ready_HR_IS
        self.delay_duration = self.hypervent_delay

        self.Calibration_Hold = QPushButton("Calibration", parent=self)
        self.Habituation_Hold = QPushButton("Habituation", parent=self)
        self.Baseline_Hold = QPushButton("Baseline", parent=self)
        self.Hypervent_Hold = QPushButton("Hypervent", parent=self)
        self.Apnea_Hold = QPushButton("Apnea", parent=self)
        self.Recovery_Hold = QPushButton("Recovery", parent=self)
        self.Ready_Hold = QPushButton("Ready", parent=self)
        self.OFF = QPushButton("OFF", parent=self)
        self.CHB_RHAR_cycle = QPushButton("Cycle [CHB_RHAR]", parent=self)
        self.RHAR_cycle = QPushButton("Cycle [RHAR]", parent=self)
        self.breathing = QPushButton("Breathing", parent=self)
        self.heartbeat = QPushButton("Heart Beat", parent=self)
        self.oride_breathing = QPushButton("O'Ride Breath", parent=self)
        self.oride_heartbeat = QPushButton("O'Ride Heart", parent=self)

        self.Calibration_Hold.setFixedSize(150, 25)
        self.Habituation_Hold.setFixedSize(150, 25)
        self.Baseline_Hold.setFixedSize(150, 25)
        self.Hypervent_Hold.setFixedSize(150, 25)
        self.Apnea_Hold.setFixedSize(150, 25)
        self.Recovery_Hold.setFixedSize(150, 25)
        self.Ready_Hold.setFixedSize(150, 25)
        self.OFF.setFixedSize(150, 25)
        self.CHB_RHAR_cycle.setFixedSize(150, 25)
        self.RHAR_cycle.setFixedSize(150, 25)
        self.breathing.setFixedSize(100, 50)
        self.heartbeat.setFixedSize(100, 50)
        self.oride_breathing.setFixedSize(100, 50)
        self.oride_heartbeat.setFixedSize(100, 50)

        self.Calibration_Hold.move(250, 500)
        self.Habituation_Hold.move(250, 525)
        self.Baseline_Hold.move(250, 550)

        self.Ready_Hold.move(425, 500)
        self.Hypervent_Hold.move(425, 525)
        self.Apnea_Hold.move(425, 550)
        self.Recovery_Hold.move(425, 575)

        self.OFF.move(250, 575)
        self.CHB_RHAR_cycle.move(250, 625)
        self.RHAR_cycle.move(425, 625)

        self.breathing.move(575, 650)
        self.heartbeat.move(575, 700)
        self.oride_breathing.move(0, 650)
        self.oride_heartbeat.move(0, 700)

        self.breathing.setStyleSheet("background-color: black")
        self.heartbeat.setStyleSheet("background-color: black")

        self.Calibration_Hold.clicked.connect(self.Calibration_Hold_action)
        self.Habituation_Hold.clicked.connect(self.Habituation_Hold_action)
        self.Baseline_Hold.clicked.connect(self.Baseline_Hold_action)
        self.Hypervent_Hold.clicked.connect(self.Hypervent_Hold_action)
        self.Apnea_Hold.clicked.connect(self.Apnea_Hold_action)
        self.Recovery_Hold.clicked.connect(self.Recovery_Hold_action)
        self.Ready_Hold.clicked.connect(self.Ready_Hold_action)
        self.CHB_RHAR_cycle.clicked.connect(self.CHB_RHAR_cycle_action)
        self.RHAR_cycle.clicked.connect(self.RHAR_cycle_action)
        self.OFF.clicked.connect(self.OFF_action)
        self.oride_breathing.pressed.connect(self.oride_breathing_clicked)
        self.oride_heartbeat.pressed.connect(self.oride_heartbeat_clicked)
        self.oride_breathing.released.connect(self.oride_breathing_released)
        self.oride_heartbeat.released.connect(self.oride_heartbeat_released)

    @Slot()
    def oride_breathing_clicked(self, breath_pin=breath_pin):
        self.breathing.setStyleSheet("background-color: red")
        breath_pin.value = 1
        # GPIO.output(3, GPIO.HIGH)
        self.OFF_action(reset_pins=False)

    @Slot()
    def oride_heartbeat_clicked(self, heart_pin=heart_pin):
        self.heartbeat.setStyleSheet("background-color: red")
        heart_pin.value = 1
        # GPIO.output(5, GPIO.HIGH)
        self.OFF_action(reset_pins=False)

    @Slot()
    def oride_breathing_released(self, breath_pin=breath_pin):
        self.breathing.setStyleSheet("background-color: black")
        breath_pin.value = 0
        # GPIO.output(3, GPIO.LOW)
        self.OFF_action(reset_pins=False)

    @Slot()
    def oride_heartbeat_released(self, heart_pin=heart_pin):
        self.heartbeat.setStyleSheet("background-color: black")
        heart_pin.value = 0
        # GPIO.output(5, GPIO.LOW)
        self.OFF_action(reset_pins=False)

    def reset_timers(self, label, hold=False):
        self.running = 1

        if hold == True:
            self.duration = -1
        else:
            self.duration = float(getattr(self, f"{label}_duration"))

        self.TT_RR_timings = cycler_prep(self, label)
        self.timer = 0
        self.TT_timer = 0
        self.TT_1v2_toggle = 1
        self.RR_timer = 0
        self.RR_1v2_toggle = 1
        self.looptimer.stop()

    def get_delay_timers(self):
        self.running = 1

    @Slot()
    def increment_duration(self):
        self.duration += 1

    @Slot()
    def Calibration_Hold_action(self):
        self.singleshot_timer.stop()
        # print('Calibration_Hold')
        self.reset_timers("calibration", hold=True)
        self.state = "calibration"
        self.state_label.setText(f"<h1>{self.state}</h1>")
        self.looptimer.start()

    @Slot()
    def Habituation_Hold_action(self):
        self.singleshot_timer.stop()
        # print('Habituation_Hold')
        self.reset_timers("habituation", hold=True)
        self.state = "habituation"
        self.state_label.setText(f"<h1>{self.state}</h1>")
        self.looptimer.start()

    @Slot()
    def Baseline_Hold_action(self):
        self.singleshot_timer.stop()
        # print('Baseline Hold')
        self.reset_timers("baseline", hold=True)
        self.state = "baseline"
        self.state_label.setText(f"<h1>{self.state}</h1>")
        self.looptimer.start()

    @Slot()
    def Hypervent_Hold_action(self):
        self.singleshot_timer.stop()
        # print('Hypervent_Hold')
        self.reset_timers("hypervent", hold=True)
        self.state = "hypervent"
        self.state_label.setText(f"<h1>{self.state}</h1>")
        self.looptimer.start()

    @Slot()
    def Apnea_Hold_action(self):
        self.singleshot_timer.stop()
        # print('Apnea_Hold')
        self.reset_timers("apnea", hold=True)
        self.state = "apnea"
        self.state_label.setText(f"<h1>{self.state}</h1>")
        self.looptimer.start()

    @Slot()
    def Recovery_Hold_action(self):
        self.singleshot_timer.stop()
        # print('Recovery_Hold')
        self.reset_timers("recovery", hold=True)
        self.state = "recovery"
        self.state_label.setText(f"<h1>{self.state}</h1>")
        self.looptimer.start()

    @Slot()
    def Ready_Hold_action(self):
        self.singleshot_timer.stop()
        # print('Ready_Hold')
        self.reset_timers("ready", hold=True)
        self.state = "ready"
        self.state_label.setText(f"<h1>{self.state}</h1>")
        self.looptimer.start()

    @Slot()
    def CHB_RHAR_cycle_action(self):
        self.singleshot_timer.stop()
        print("CHB->(RHAR)")
        self.repeat_challenges = 1
        self.delay_duration = self.hypervent_delay
        if float(self.hypervent_delay) < 0:
            self.delay_for_trigger = 1
            print("wait for trigger a")
        else:
            self.delay_for_trigger = 0
        self.state = "calibration"
        self.state_label.setText(f"<h1>{self.state}</h1>")
        self.timed_run()

    @Slot()
    def RHAR_cycle_action(self):
        self.singleshot_timer.stop()
        print("(RHAR)")
        self.repeat_challenges = 1
        self.delay_duration = self.hypervent_delay
        if float(self.hypervent_delay) < 0:
            self.delay_for_trigger = 1
            print("wait for trigger b")
        else:
            self.delay_for_trigger = 0
        self.state = "ready"
        self.state_label.setText(f"<h1>{self.state}</h1>")
        self.timed_run()

    @Slot()
    def timed_run(self):
        if int(self.repeat_challenges) <= int(self.recovery_rounds):
            # print(self.state)
            # print(self.repeat_challenges,self.recovery_rounds)
            self.reset_timers(self.state)
            self.looptimer.start()

            if self.state == "recovery":
                self.repeat_challenges = int(self.repeat_challenges) + 1

            self.singleshot_timer.setInterval(int(self.duration * 1000))
            self.singleshot_timer.start()

            if self.state in ["ready", "apnea", "recovery"]:
                if float(self.hypervent_delay) < 0:
                    self.delay_for_trigger = 1
                    print("wait for trigger c")
                else:
                    self.delay_for_trigger = 0

        else:
            self.singleshot_timer.stop()
            self.state = "off"
            self.state_label.setText(f"<h1>{self.state}</h1>")
            print("Finished")

    @Slot()
    def advance_state(self):
        self.running = 0

        if self.state == "calibration":
            self.state = "habituation"
        elif self.state == "habituation":
            self.state = "baseline"
        elif self.state == "baseline":
            self.state = "delay"
        elif self.state == "delay":
            self.state = "hypervent"
        elif self.state == "hypervent":
            self.state = "apnea"
        elif self.state == "apnea":
            self.state = "recovery"
        elif self.state == "recovery":
            self.state = "ready"
        elif self.state == "ready":
            self.state = "delay"
        self.state_label.setText(f"<h1>{self.state}</h1>")

        self.timed_run()

    @Slot()
    def run(self):
        if self.running == 0:
            self.looptimer.stop()

        # VF pulse
        self.TT_timer, self.TT_1v2_toggle = pulse(
            self,
            "breathing",
            self.TT_timer,
            self.TT_RR_timings["TT"],
            self.TT_1v2_toggle,
            pin=breath_pin,
        )

        # HR pulse
        self.RR_timer, self.RR_1v2_toggle = pulse(
            self,
            "heartbeat",
            self.RR_timer,
            self.TT_RR_timings["RR"],
            self.RR_1v2_toggle,
            pin=heart_pin,
        )

        # check for trigger
        self.trigger = trigger_check(pin=sense_pin, text_widget=self.pin_input_reading)
        if (
            self.trigger == 1
            and self.state in ["ready", "delay", "hypervent", "recovery"]
            and self.delay_for_trigger == 1
        ):
            print("trigger detected")
            # if trigger detected in a 'challenge state' with breathing
            # reset emouse to begin next challenge round
            self.state = "delay"
            self.delay_for_trigger = 0
            self.advance_state()

    @Slot()
    def OFF_action(self, reset_pins=True):
        self.reset_timers("ready", hold=True)
        self.state = "off"
        self.state_label.setText(f"<h1>{self.state}</h1>")
        self.running = 0
        self.singleshot_timer.stop()
        self.repeat_challenges = int(self.recovery_rounds)
        if reset_pins == True:
            pin_reset([breath_pin, heart_pin])


# %% main


def main():
    defaultfont = QtGui.QFont("Arial", 8)
    QtWidgets.QApplication.setStyle("fusion")
    QtWidgets.QApplication.setFont(defaultfont)
    app = QApplication(sys.argv)
    MW = MainWindow()
    MW.show()
    sys.exit(app.exec())


# %% run main()

if __name__ == "__main__":
    main()
