MolecularNeurobiology/LOOPER/PCC.py

# -*- coding: utf-8 -*-

__version__ = "43.0.3"

"""
Physiology Command Center
(C) 2019
@author: Christopher Ward (christow@bcm.edu, ward.chris.s@gmail.com)
Created as part of the Russell Ray Molecular Neurobiology Group's
Autoresuscitation Project
contributions to this project include code, concepts, or consultation from 
several individuals including Russell Ray, Eunice Aissi, Dipak Patel, 
Mariana Garcia Costa, Savannah Lusk, Brandon Ruiz, and Kevin Jiang
This software provides a graphical interface for I/O between an computer
and 1) Arduino Microcontroller, 2) LabJack Analog to Digital Converter.
Signals from the LabJack undergo signal processing to identify key features
used as triggers to execute programmed control sequences run by the Arduino.
The current implementation utilizes pneumotachography and electrocardiogram 
signals to monitor breathing and heart rate as part of a neonate 
autoresuscitation assay.
Default Workflow (subject to change)
~~~~~~~~~~~~~~~~~~~~~~~~~~~~~~~~~~~
0-signal preview mode (adjust baseline and confirm tunable parameters)
**user confirmation for next step
1-calibration mode (receive calibration signals [20x30uL pulses])
**signal to DC out [trigger auto pipette and LED] upon start
**end upon timer (and confirmation from auto pipett upon complete?)
+++creates save file for calibration values
2-signal preview mode (adjust baseline and confirm tunable parameters)
**user confirmation for next step
3-habituation mode (wait 30 minutes for habituation)
**preview and capture signals for review later - consider updates to interval
4-baseline mode (capture 10 minutes of signal for baseline)
**preview and capture signals - consider criteria of 
    QUANTITY_OF_QUALITY signal...
    Q_O_Q : 10 seconds per interval of 'calm breathing', 
    sum of intervals is at least 1 minute
5-challenge mode (ANOXIA challenge until breath cessation, 
    Room Air until recovery....recovery based on >=X% HR and BPM recovery)
**preview and capture signals - include tags for ANOXIA vs ROOM AIR
**signal to DC/Serial out 
    [trigger to switch between modes (DC on for ANOXIA, DC off for ROOM AIR)]
**move to EXPERIMENT ENDED mode upon failure to recover breathing/hr
6-experiment ended mode 
**terminate preview and capture, send signal to notify user
**signal to DC out, or other Raspberry Pi notification
~~~~~~~~~~~~~~~~~~~~~~~~~~~~~~~~~~~
Inputs: currently none - all settings are coordinated within the GUI
Outputs: timeseries signal datafile 
    [calibration capture, animal signal capture] - this is currently one file 
    with seperate sections
~~~~~~~~~~~~~~~~~~~~~~~~~~~~~~~~~~~~
TODO regarding PCC
*create flexibility for alternate study designs/data collection
*create flexibility to terminate study after variable number of trials
*error checking to prevent inversion of y axis, baseline and threshold values
    (and any other common sources of crashes)
*better handle/close out of labjack 
    (probably try except and closing out connection)
*better handling for arduino connection
*incorporate logging library for improved status and debugging...maybe?
*revisit UX restrictions for tweakables for display and general UX design
related but slightly seperate
*server/client for comms with Supervisor System and Worker Systems 
    (i.e. central workstation communicates to rigs running PCC for set-up and 
     monitoring)
*tools to adapt PCC output for BASSPRO_STAGG pipeline, and Rice D2K pipelines

!!! v43.0.0 !!!
1.  add improved version tracking (including grabbing git status)
2.  populate study settings via query to filemaker

!!! v42.1.0 !!!
1.	Fix baseline establishment criteria to be more lenient [described - awaiting new recommend defaults]
        (and provide a description of the current requirements) -
            'avgBPM':250, - average breathing frequency is less than 250 breaths per minute
            'cvTT':0.5, - average coefficient of variation (SD/mean) for breath cycle duration is less than 0.5
            'avgHR':700, - average heart rate is less than 700 beats per minute
            'avgRR':999, - average R to R interval (time between heart beats) is less than 999ms
            'cvRR':0.5, - average coefficient of variation (SD/mean) for R to R interval is less than 0.5
            'BSD':0.25, - baseline drift (i.e. average of absolute value of voltage signal) is less then 0.25V
            'DVTV':0.75 – disagreement in volume of inhaled vs exhaled tidal volume |iTV-eTV|/avg(iTV,eTV) is less than 0.75

        Each of the above parameters is calculated based on the preceding 5 seconds. And a minimum bout duration of 5 seconds is required for inclusion into the values to use for calculation of baseline.
        
        As the animals accumulate bouts of quiet calm breathing QB_counter and QB_duration values should increase, and an average should be generated if any bouts were observed (but this apparently isn’t reliable working)
        
        The green/red indicator should be green if all criteria are met, and will be red with text indicating criteria that are not being met.

2.	Put a stop in after baseline that if baseline does not establish, 
        the challenge period does not begin and instead cycles back to 
        baseline** - 
            baseline_increment = 5*60
            minimum_cummulative_QB_duration = 60
3.	Permit manual setting of baseline values

4.	With recovery there would be two versions made:
    a.	Standard 5 minutes of recovery no matter what
            -set recovery thresholds to 0
    b.	Recovery met if 30 total seconds meet recovery criteria within the last
        minute of the 5 minutes recovery period (not consecutive 30 seconds)
            -revised implementation of sustained recovery check to permit 
            sustained recovery based on having a maximum of the munimum
            sustained duration within the recovery interval



!!! v42.0.0 goals CW !!!
*migrate settings to external file
*add challenge endpoint based on trial number
*start minor gui improvements

!!! v42.1.2 !!!
* add commenting for extension of baseline
* add detection of gasp event and commenting
* add detection of recovery and commenting
* add alternate sustained recovery (accumulated rather than consecutive)


"""


##
# %% import libraries
import pygame
import numpy
import pandas
from scipy import signal
import sys
import threading
from copy import deepcopy
from datetime import datetime
import fm_tools
import json

from gpiozero import CPUTemperature

import traceback

import queue as Queue
import u6
import tkinter
import tkinter.filedialog
import tkinter.simpledialog
import os
import subprocess

import smtplib
import ssl
import serial
import serial.tools.list_ports

import logging

from pathlib import Path

home_dir = str(Path.home())
print(home_dir)

# Import constants from CONSTANTS.PY
from CONSTANTS import *

# GET GUI classes from GUI.py
from GUI import *

# Import Stream classes fro Strem.py
from Stream import *

##

__git_status__ = (
    subprocess.run(["git", "status"], encoding="utf-8", stdout=subprocess.PIPE)
    .stdout.replace("\n", "; ")
    .strip()
)

# %%
# prep serial connection to arduino
logger = None

try:
    ser = serial.Serial()
    ser.baudrate = 9600

    # search for Arduino on comports
    arduino_list = []
    device_list = [d for d in serial.tools.list_ports.comports()]
    for d in device_list:
        if d.manufacturer is not None and "Arduino" in d.manufacturer:
            arduino_list.append(d)
        elif d.description is not None and "Arduino" in d.description:
            arduino_list.append(d)

    if len(arduino_list) > 1:
        if logger:
            logger.warning("multiple arduinos found, using first")
        ser.port = arduino_list[0].device
    elif len(arduino_list) == 1:
        ser.port = arduino_list[0].device
    else:
        if logger:
            logger.warning("unable to locate arduino")
    ser.timeout = 1
    ser.open()
    Connected_Arduino = True
except Exception as e:
    if logger:
        logger.warning("unable to connect to arduino {}".format(e))
    Connected_Arduino = False

##
# %% define functions
##LOGGING SETUP


def setup_logging(filename, debug=1):
    log_format = logging.Formatter(
        "%(levelname)s - %(asctime)s - %(message)s", datefmt="%d-%b-%y %H:%M:%S"
    )
    logger = logging.getLogger(__name__)
    if debug:
        c_handler = logging.StreamHandler()
        c_handler.setLevel(logging.DEBUG)
    else:
        c_handler = logging.StreamHandler()
        c_handler.setLevel(logger.info)
    f_handler = logging.FileHandler(filename + ".log")
    # f_handler.setLevel(logger.warning)
    c_handler.setFormatter(log_format)
    f_handler.setFormatter(log_format)
    logger.addHandler(c_handler)
    logger.addHandler(f_handler)
    logger.info("PLETHYSMOGRAPHY COMMAND CENTER LOG FILE\n")
    logger.info("file may contain mutliple sessions, session marker : $$$$$\n")
    logger.info(
        "file created {year:04d}-{month:02d}-{day:02d} {hour:02d}:{minute:02d}:{second:02d}\n".format(
            year=now.year,
            month=now.month,
            day=now.day,
            hour=now.hour,
            minute=now.minute,
            second=now.second,
        )
    )
    return logger


def log_to_file(logger, message):
    logger.info(message)


def log_to_console(logger, message):
    logger.debug(message)


def guiSaveFileName(kwargs={}):
    """Returns the path to the filename and location entered in the GUI
    *Function calls on tkFileDialog and uses those arguments
    .....
    (declare as a dictionairy)
    {"defaultextension":"","filetypes":"","initialdir":"",...
    "initialfile":"","multiple":"","message":"","parent":"","title":""}
    .....
    """
    root = tkinter.Tk()
    outputtext = tkinter.filedialog.asksaveasfilename(**kwargs)
    root.destroy()
    return outputtext


def guiOpenFileName(kwargs={}):
    """Returns the path to the filename and location entered in the GUI
    *Function calls on tkFileDialog and uses those arguments
    .....
    (declare as a dictionairy)
    {"defaultextension":"","filetypes":"","initialdir":"",...
    "initialfile":"","multiple":"","message":"","parent":"","title":""}
    .....
    """
    root = tkinter.Tk()
    outputtext = tkinter.filedialog.askopenfilename(**kwargs)
    root.destroy()
    return outputtext


def guiGetFloat(title, text, default_if_canceled):
    """Returns a float based on the users entry
    *Function calls on tkinter.simpledialog and uses those arguments
    .....
    declare as a dictionairy)
    {"title":"","minvalue":"","maxvalue":""}
    .....
    """
    root = tkinter.Tk().withdraw()
    outputfloat = tkinter.simpledialog.askfloat(title, text)
    if outputfloat is None:
        try:
            root.destroy()
        except:
            pass
        return default_if_canceled
    else:
        try:
            root.destroy()
        except:
            pass
        return outputfloat


def guiGetText(title, text, default_if_canceled):
    """Returns text based on the users entry
    *Function calls on tkinter.simpledialog and uses those arguments
    .....
    declare as a dictionairy)
    {"title":"","minvalue":"","maxvalue":""}
    .....
    """
    root = tkinter.Tk().withdraw()
    outputtext = tkinter.simpledialog.askstring(title, text)
    if outputtext is None:
        try:
            root.destroy()
        except:
            pass
        return default_if_canceled
    else:
        try:
            root.destroy()
        except:
            pass
        return outputtext


# %%
def load_rig_config(config_path=None):
    if not config_path:
        config_path = os.path.join(home_dir, "rig.config")
    with open(config_path, "r") as openfile:
        config = json.load(openfile)
    return config


def update_rig_config(field, config_path=None, logger=None):
    if not config_path:
        config_path = os.path.join(home_dir, "rig.config")
    with open(config_path, "r") as openfile:
        config = json.load(openfile)

    new_value = guiGetText(
        f"update entry for {field}",
        f"update entry for {field}\nCurrent Value:{config[field]}",
        "",
    )

    config[field] = new_value

    with open(config_path, "w") as openfile:
        json.dump(config, openfile, indent=4)

    if logger:
        logger.info(f"rig config updated {field} : {new_value}")


def update_rig_log(
    rigconfig, filename, field_dict=None, daily_key=None, daily_index=None, logpath=None
):
    if not logpath:
        logpath = os.path.join(home_dir, "rig_run_log.log")

    with open(logpath, "r") as openfile:
        riglog = json.load(openfile)

    now = datetime.now()
    if not daily_key:
        daily_key = now.strftime("%Y-%m-%d")

    if daily_key in riglog:
        riglog[daily_key].append(
            {
                "rigname": rigconfig["RIGNAME"],
                "filename": os.path.basename(filename),
                "start": now.strftime("%Y-%m-%d %H:%M:%S"),
            }
        )
    if not daily_index:
        daily_index = len(riglog[daily_key]) - 1

    if field_dict:
        for k, v in field_dict.items():
            riglog[daily_key][daily_index][k] = v

    with open(logpath, "w") as openfile:
        json.dump(riglog, openfile, indent=4)

    return daily_key, daily_index


# %%
def emailnotification(emailsettingslocation, dev):
    with open(emailsettingslocation, "r") as oif:
        settings = oif.read()
    settings_list = settings.split("\n")

    port = 587  # port for starttls
    smtp_server = "smtp.gmail.com"
    sender_email = settings_list[0]
    receiver_email = settings_list[2]
    password = settings_list[1]
    now = datetime.now()
    message = """\
    Subject: NOTIFICATION FROM LABJACK - RPi station {device} - {serial}
    
    
    Message: Program has ended at {YYYY}-{MM:02d}-{DD:02d} {hh:02d}:{mm:02d}:{ss:02d}""".format(
        device=dev.deviceName,
        serial=dev.serialNumber,
        YYYY=now.year,
        MM=now.month,
        DD=now.day,
        hh=now.hour,
        mm=now.minute,
        ss=now.second,
    )

    context = ssl.create_default_context()
    with smtplib.SMTP(smtp_server, port) as server:
        server.starttls(context=context)
        server.login(sender_email, password)
        server.sendmail(sender_email, receiver_email, message)
    print("message sent to {}".format(receiver_email))
    print(message)


def saveCapturedData(filename, TEXTBLOCK):
    now = datetime.now()
    with open(filename, "a") as f:
        f.write("$$$$$ DATA SESSION -----\n")
        f.write(
            "SESSION STARTED {year:04d}-{month:02d}-{day:02d} {hour:02d}:{minute:02d}:{second:02d}:{microsecond:06d}\n".format(
                year=now.year,
                month=now.month,
                day=now.day,
                hour=now.hour,
                minute=now.minute,
                second=now.second,
                microsecond=now.microsecond,
            )
        )
        f.write("\n".join(TEXTBLOCK) + "\n")


def appendCapturedData(filename, TEXTBLOCK):
    with open(filename, "a") as f:
        for r in TEXTBLOCK:
            f.write("\n".join(r) + "\n")


def graphScaler(topleft, xy_size, x_minmax, y_minmax, x_vals, y_vals):
    x_size = xy_size[0]
    y_size = xy_size[1]
    bottomright = (topleft[0] + x_size, topleft[1] + y_size)
    x_range = x_minmax[1] - x_minmax[0]
    y_range = y_minmax[1] - y_minmax[0]
    x_pg_offset = topleft[0]
    y_pg_offset = topleft[1]
    x_scale = x_size / x_range
    y_scale = y_size / y_range
    corr_x = [(i - x_minmax[0]) * x_scale + x_pg_offset for i in x_vals]
    corr_y = [
        (y_minmax[1] + i * -1) * y_scale + y_pg_offset for i in y_vals
    ]  # also inverts y value to match pygame coordinte system
    xy_list = [
        (
            max(min(corr_x[i], bottomright[0]), topleft[0]),
            max(min(corr_y[i], bottomright[1]), topleft[1]),
        )
        for i in range(len(corr_x))
    ]
    return xy_list


def toggle(state):
    if state == 0:
        return 1
    else:
        return 0


def pulse_ender(device, pin, start, duration):
    pulse_status = 1
    duration_timer = datetime.now() - start
    cur_dur_sec = duration_timer.seconds

    if cur_dur_sec >= duration:
        device.setDIOState(pin, 0)
        pulse_status = 0
    else:
        pass
    return pulse_status


def advance(state, minstate, maxstate):
    state += 1
    if state > maxstate:
        state = minstate
    return state


def old_save_button():
    print("save")
    try:
        outputfile = guiSaveFileName(
            {"title": "Save Signal Data", "defaultextension": ".txt"}
        )
        fm_record_dict = {}

        if not os.path.exists(os.path.dirname(outputfile)):
            os.makedirs(os.path.dirname(outputfile))
            print(f"making new directory - {os.path.dirname(outputfile)}")

        readytosave = 1
        now = datetime.now()
        ##
        if outputfile is not None and outputfile != "":
            with open(outputfile, "w") as f:
                f.write("PLETHYSMOGRAPHY COMMAND CENTER DATA FILE\n")
                f.write("file may contain mutliple sessions, session marker : $$$$$\n")
                f.write(
                    "file created {year:04d}-{month:02d}-{day:02d} {hour:02d}:{minute:02d}:{second:02d}\n".format(
                        year=now.year,
                        month=now.month,
                        day=now.day,
                        hour=now.hour,
                        minute=now.minute,
                        second=now.second,
                    )
                )
        else:
            outputfile = None
            readytosave = 0

    except Exception as e:
        print(e)
        outputfile = None
        readytosave = 0

    return outputfile, readytosave, fm_record_dict


def save_button():
    print("save")
    try:
        outputfile, fm_record_dict = fm_tools.generate_rig_save_path(
            guiGetText("Scan Filename Barcode", "Scan Filename Barcode", "")
        )

        # fm_record_dict initially populated for keys 'PlyUID','RUID','Project Number'

        if os.path.isfile(outputfile):
            raise ValueError("Desired output name already exists")

        if not os.path.exists(os.path.dirname(outputfile)):
            os.makedirs(os.path.dirname(outputfile))
            print(f"making new directory - {os.path.dirname(outputfile)}")

        readytosave = 1
        now = datetime.now()
        ##
        if outputfile is not None and outputfile != "":
            with open(outputfile, "w") as f:
                f.write("PLETHYSMOGRAPHY COMMAND CENTER DATA FILE\n")
                f.write("file may contain mutliple sessions, session marker : $$$$$\n")
                f.write(
                    "file created {year:04d}-{month:02d}-{day:02d} {hour:02d}:{minute:02d}:{second:02d}\n".format(
                        year=now.year,
                        month=now.month,
                        day=now.day,
                        hour=now.hour,
                        minute=now.minute,
                        second=now.second,
                    )
                )
        else:
            outputfile = None
            readytosave = 0

    except Exception as e:
        print(e)
        outputfile = None
        readytosave = 0

    return outputfile, readytosave, fm_record_dict


def beat_caller(CT, TS, absthresh=0.74, minRR=0.10):
    """
    Extract R-R intervals and calculate heart rate from an ECG signal.
    This version uses scipy.signal.find_peaks function.
    Function and settings based on code from SLusk.

    Parameters:
    - CT (array-like): The raw ECG data.
    - TS (array-like): Timestamps corresponding to the ECG data points.
    - absthresh (float): Absolute Voltage Threshold for beat detection.
    - minRR (float): Minimum RR interval in seconds to consider for heart rate calculation.

    Returns:
    - DataFrame: DataFrame containing
        timestamps ['ts']
        RR intervals ['rr']
        heart rates ['hr']
    """

    # Convert CT to a numpy array if it isn't one already
    CT = numpy.array(CT)
    TS = numpy.array(TS)
    sampling_time = TS[1] - TS[0]

    peak_finding_distance = int(minRR / sampling_time)

    # Identify peaks in the ECG signal; adjust parameters as necessary for your data
    peaks, _ = signal.find_peaks(
        CT, height=absthresh_ecg, distance=peak_finding_distance
    )  # Adjust 'distance' as needed

    # Extract timestamps for the detected peaks
    timestamps_peaks = numpy.take(TS, peaks, axis=0)

    # Calculate RR intervals in seconds
    rr_intervals = numpy.diff(timestamps_peaks)

    # Calculate heart rate from rr intervals
    heart_rates = [60 / ri for ri in rr_intervals]

    # Prepare dataframe to return
    beat_df = pandas.DataFrame(
        {
            "ts": timestamps_peaks[:-1],  # Exclude the last timestamp
            "rr": rr_intervals,
            "hr": heart_rates,
        }
    )

    return beat_df


def basicRR(CT, TS, noisecutoff, threshfactor, absthresh, minRR):
    """
    This is a deprecated function - superceded by beat_caller

    simple RR peak caller based on relative signal to noise thresholding
    CT = signal
    noisecutoff = perrcentile within signal to consider as noise
    threshfactor = multiple of the noisecutoff to use for beat detaction
    minRR = minimum RR in samples (1000BPM ~ 60 ms RR, minRR ~60 @1000Hz)
    **CV and Rvolt to thresh ratios may help for QC
    signal filtering is helpful (recommend butter highpass and notch filters)
    """

    # get above thresh
    noise_level = numpy.percentile(CT, noisecutoff)
    thresh = max(noise_level * threshfactor, absthresh)
    beats = {}
    index_crosses = []
    for i in range(len(CT) - 1):
        if CT[i + 1] >= thresh and CT[i] < thresh:
            index_crosses.append(i + 1)

    if len(index_crosses) == 0:

        return beats  # pass #no beats

    prevJ = 0
    # prevRR=0
    for i in index_crosses[:-1]:
        maxR = CT[i]
        # indexR=i
        TS_R = TS[i]
        for j in range(i, len(CT), 1):
            if CT[j] < thresh:
                break
            if j >= index_crosses[-1]:
                break
            elif CT[j] > maxR:
                maxR = CT[j]
        #        indexR=j
        if j - prevJ >= minRR:
            # beats[TS_R]={'Rvolt':maxR,'indexR':indexR,'RR':TS[j]-TS[prevJ], 'CV': ((j-prevJ)-prevRR)/(((j-prevJ)+prevRR)/2),'thresh':thresh}
            beats[TS_R] = {"RR": TS[j] - TS[prevJ]}
            if prevJ == 0:
                beats[TS_R]["first"] = True
            else:
                beats[TS_R]["first"] = False
            prevJ = j
            # prevRR=TS[j]-TS[prevJ]

    return beats


# %%
def basic_breathcall(
    CT, ts, base, thresh
):  # needs debugging for collisions between breaths
    #
    # note - the anticipated signal input duration is ~10sec with sliding repeat performed every 0.1 sec
    # performance can be improved with mdest loss of precision by downsampling input signal (minimum~50Hz)
    # find thresh crossing
    ##
    logic_AT = [1 if i > thresh else 0 for i in CT]
    logic_BB = [1 if i < base else 0 for i in CT]
    logic_Ins = [logic_AT[i + 1] - logic_AT[i] for i in range(len(CT) - 1)]
    index_i = [
        i + 1 for i in range(len(logic_Ins)) if logic_Ins[i] == 1
    ]  # index of inspiration threshold crosses
    BC = {}
    ##
    if len(index_i) == 0:
        return BC
    ##
    BC_list = []
    ##
    if sum(logic_BB) == 0:
        return BC
    ##
    index_b = [
        i for i in range(len(logic_BB)) if logic_BB[i] == 1
    ]  # index of below baseline values
    # check for closest baseline cross preceding, skip if prior baseline belongs to prev crossing
    #
    FIRST_BREATH_FOUND = False
    for i in range(len(index_i)):
        validbreath = False
        # skip until first base crossing is available
        if index_i[i] < index_b[0]:
            continue  # no baseline crossing found before current thresh crossing
        if FIRST_BREATH_FOUND == False:
            # scan back until baseline cross (CT[index_b[0]])
            for j in range(index_i[i], index_b[0], -1):
                if CT[j] > base:
                    continue
                else:
                    FIRST_BREATH_FOUND = True
                    validbreath = True
                    break
        else:
            for j in range(
                index_i[i], index_i[i - 1], -1
            ):  # skip if prior baseline belongs to prev crossing
                if j <= index_i[i - 1] + 1:
                    break  # skip segment - belongs to prior breath exp phase
                if CT[j] > base:
                    pass
                else:
                    validbreath = True
                    break
        if validbreath == False:
            continue

        BC[ts[j]] = {"TS-I": ts[j]}
        BC_list.append(ts[j])
        #
        # check for closest baseline cross following
        if index_i[i] != index_i[-1]:  # check if special case dealing with last breath
            for k in range(index_i[i], index_i[i + 1], 1):
                if CT[k] >= base:  # consider if should be >=
                    BC[ts[j]]["TS-E"] = ts[k]
                else:
                    break
        else:
            for k in range(index_i[i], len(CT), 1):
                if CT[k] >= base:  # consider if should be >=
                    BC[ts[j]]["TS-E"] = ts[k]
                else:
                    break
        BC[ts[j]]["j"] = j
        BC[ts[j]]["k"] = k
        # fill in BC measures TI PIF iTV
        BC[ts[j]]["TI"] = ts[k] - ts[j]
        # BC[ts[j]]['PIF']=max(CT[j:k])
        BC[ts[j]]["iTV"] = (
            sum(CT[j:k]) - len(CT[j:k]) * base
        )  # updated to reflect volume if baseline !=0
    # fill in BC measures TE PEF eTV
    for i in range(len(BC_list) - 1):
        BC[BC_list[i]]["TE"] = BC[BC_list[i + 1]]["TS-I"] - BC[BC_list[i]]["TS-E"]
        # BC[ts[BC_list[i]]]['PEF']=min(CT[BC[BC_list[i]]['k']:BC[BC_list[i+1]]['j']])
        BC[BC_list[i]]["eTV"] = (
            sum(CT[BC[BC_list[i]]["k"] : BC[BC_list[i + 1]]["j"]]) * -1
        ) + len(
            CT[BC[BC_list[i]]["k"] : BC[BC_list[i + 1]]["j"]]
        ) * base  # updated to reflect volume if baseline !=0
        BC[BC_list[i]]["DVTV"] = (
            abs(BC[BC_list[i]]["iTV"] - BC[BC_list[i]]["eTV"]) / BC[BC_list[i]]["iTV"]
        )
    ##
    return BC


# %%


def basicFilt(CT, sampleHz, f0, Q):
    b, a = signal.iirnotch(f0 / (sampleHz / 2), Q)

    notched = signal.lfilter(b, a, CT)
    # notched=CT
    b, a = signal.butter(1, 1 / (sampleHz / 2), btype="highpass")
    buttered = signal.lfilter(b, a, notched)
    return buttered


def notchFilt(CT, sampleHz, f0, Q):
    b, a = signal.iirnotch(f0 / (sampleHz / 2), Q)

    notched = signal.lfilter(b, a, CT)
    return notched


def butterFilt(CT, sampleHz):
    b, a = signal.butter(1, 1 / (sampleHz / 2), btype="highpass")
    buttered = signal.lfilter(b, a, CT)
    return buttered


def processStatus(status, device, serial_connection, ADC, logger=None):
    device.setDIOState(0, 0)
    device.setDIOState(1, 0)
    device.setDIOState(2, 0)
    device.setDIOState(3, 0)
    now = datetime.now()
    print(status)
    serialtext = ""

    if status["standby"] == 1:
        serialtext = "<S,0,0>"

    if status["startup"] == 1 and status["startup_ready"] < 1:
        serialtext = "<U,0,0>"
        try:
            ser.write(serialtext.encode())
            log_to_file(logger, "{} - sent".format(serialtext))
            print("{} - sent".format(serialtext))
            status["startup_ready"] = 1
        except:
            print('unable to transmit "{}"via serial io'.format(serialtext))
            status["startup_ready"] = 1
        return status

    if status["streaming"] == 1:
        device.setDIOState(0, 1)

    if status["ready to save"] == 1:
        pass
    if status["calibration"] == 1:
        device.setDIOState(1, 1)
        serialtext = "<C,{},0>".format(ADC["Duration_Cal"])
        status["pulse"]["calibration"]["state"] = 1
        status["pulse"]["calibration"]["start"] = now
    if status["challenge air"] == 1:
        device.setDIOState(3, 1)
        serialtext = "<R,{},0>".format(ADC["Position_RA"])
        status["pulse"]["challenge air"]["state"] = 1
        status["pulse"]["challenge air"]["start"] = now
    if status["challenge gas"] == 1:
        device.setDIOState(2, 1)
        serialtext = "<A,{},{}>".format(ADC["Position_Gas"], ADC["Duration_Prefill"])
        status["pulse"]["challenge gas"]["state"] = 1
        status["pulse"]["challenge gas"]["start"] = now
    else:
        pass

    if serialtext != "":

        try:
            ser.write(serialtext.encode())
            log_to_file(logger, "{} - sent".format(serialtext))
            if logger:
                logger.info("{} - sent".format(serialtext))
        except:
            if logger:
                logger.warning(
                    'unable to transmit "{}" via serial io'.format(serialtext)
                )

    return status


# %% define classes


# %% set-up class for streaming data
## try streaming arduino data

##


# %%
now = datetime.now()
cur_STATUS_Dict = {
    "standby": 0,
    "startup": 0,
    "streaming": 0,
    "ready to save": 0,
    "calibration": 0,
    "challenge air": 0,
    "challenge gas": 0,
    "pulse": {
        "calibration": {"state": 0, "start": now, "pin": 1},
        "challenge air": {"state": 0, "start": now, "pin": 3},
        "challenge gas": {"state": 0, "start": now, "pin": 2},
    },
    "startup_ready": 0,
}
old_STATUS_Dict = {
    "standby": 0,
    "startup": 0,
    "streaming": 0,
    "ready to save": 0,
    "calibration": 0,
    "challenge air": 0,
    "challenge gas": 0,
    "pulse": {
        "calibration": {"state": 0, "start": now, "pin": 1},
        "challenge air": {"state": 0, "start": now, "pin": 3},
        "challenge gas": {"state": 0, "start": now, "pin": 2},
    },
    "startup_ready": 0,
}

##


# %% setup labjack

# %% prepare labjack interface
CHANNEL_LIST = [0, 1, 2, 3, 4, 5]
CHANNEL_KEY = ["FLOW", "ECG", "BT", "RH", "O2", "CO2"]
CHANNEL_DICT = dict(zip(CHANNEL_KEY, CHANNEL_LIST))
# NUMBER_CHANNELS is the number of signal channels to scan
NUMBER_CHANNELS = len(CHANNEL_LIST)

# SCAN_FREQUENCY is the scan frequency of stream mode in Hz. (freq per channel * # channels)
SCAN_FREQUENCY = 1000
SAMPLE_FREQUENCY = SCAN_FREQUENCY * NUMBER_CHANNELS
UPDATE_INTERVAL_SEC = 0.1
SAMPLES_PER_INTERVAL = int(UPDATE_INTERVAL_SEC * SAMPLE_FREQUENCY)


Requests = 0
# At high frequencies ( >5 kHz), the number of samples will be ...#of requests made...
# times 48 (packets per request) times 25 (samples per packet)
d = u6.U6()
# For applying the proper calibration to readings.
d.getCalibrationData()

try:
    d.streamStop()
    print("stream found running - now stopped")
except:
    print("labjack pre-stream checked")
##

# """
# 2.6.4 - Internal Temperature Sensor [U6 Datasheet]
# The U6 has an internal temperature sensor.  The sensor is physically located near the AIN3 screw-terminal.  It is labeled U17 on the PCB, and can be seen through the gap between the AIN3 terminal and adjacent VS terminal.
#
# The U6 enclosure typically makes a 1 °C difference in the temperature at the internal sensor.  With the enclosure on the temperature at the sensor is typically 3 °C higher than ambient, while with the enclosure off the temperature at the sensor is typically 2 °C higher than ambient.  The calibration constants have an offset of -3 °C, so returned calibrated readings are nominally the same as ambient with the enclosure installed, and 1 °C below ambient with the PCB in free air.
#
# The sensor has a specified accuracy of ±2.1 °C across the entire device operating range of -40 to +85 °C.  Allowing for a slight difference between the sensor temperature and the temperature of the screw-terminals, expect the returned value minus 3 °C to reflect the temperature of the built-in screw-terminals with an accuracy of ±2.5 °C.
#
# With the UD driver, the internal temperature sensor is read by acquiring analog input channel 14 and returns °K.
#
# The internal temperature sensor does not work in stream mode.  It takes too long to settle, thus if you stream it you will typically get totally wrong readings.
#
# Note on thermocouples
# If thermocouples are connected to the CB37, you want to know the temperature of the screw-terminals on the CB37.  The CB37 is typically at the same temperature as ambient air, so use the direct value from a read of AIN14.  Better yet, add a sensor such as the LM34CAZ to an unused analog input on the CB37 to measure the actual temperature of the CB37.
#
# The built-in screw-terminals AIN0-AIN3 on the U6 are typically 3 °C above ambient with the enclosure installed, so when the internal temperature sensor is used for CJC for thermocouples connected to the built-in screw-terminals, it is recommended to add 3 °C to its value as you want the actual temperature of the screw-terminals, not necessarily ambient temperature.
#
# ***DON'T READ U6 INTERNAL TEMP THROUGH STREAM, CALL THROUGH getTemperature() -273.15 for C, (x-273.15)*9/5+32 for F***
# ***caution regarding use and accuracy***
# """

# %%
## get initial temperature
CT_value = d.getTemperature() - 273.15

print("Configuring U6 stream")
# settling and resolution index may need adjustment - these values are among those suggested by labjack
d.streamConfig(
    NumChannels=NUMBER_CHANNELS,
    ChannelNumbers=CHANNEL_LIST,
    ChannelOptions=[0 for i in CHANNEL_LIST],
    SettlingFactor=1,
    ResolutionIndex=1,
    ScanFrequency=SCAN_FREQUENCY,
)

# set packets per datastream call - maybe this is not neccessary - just go with default rate?
d.packetsPerRequest = int(SAMPLES_PER_INTERVAL / 25)

d.setDIOState(0, 0)
d.setDIOState(1, 0)
d.setDIOState(2, 0)
d.setDIOState(3, 0)


# %% start the labjack datastream
sdr = StreamDataReader(d)

sdrThread = threading.Thread(target=sdr.readStreamData)
sdrThread.start()


##%% start the arduino stream
arduino_stream = StreamArduino(ser)
ardThread = threading.Thread(target=arduino_stream.readStreamData)
ardThread.start()


# %%
# % main loop

Arduino_Dump_Toggle = 0
Challenge_Toggle = 0
Challenge_phrase = "Finished: On Anoxic"
Challenge_Timer = datetime.now()
Challenge_Delay = 5
challenge_history = {}

rig_config = load_rig_config()
credentials = {
    "ip": rig_config.get("SERVER_IP"),
    "user": rig_config.get("USER"),
    "password": rig_config.get("PASSWORD"),
}
database = rig_config.get("DATABASE")
layout = rig_config.get("LAYOUT")

logger = None

record_id = None

title_version_box.update(WHITE, BLACK, f"PCC {__version__} [{rig_config['RIGNAME']}]")
tank_box.update(VIOLET, BLACK, f"TANK:{rig_config.get('Tank_Number','unk')}")
mask_box.update(WHITE, VIOLET, f"MASK:{rig_config.get('Facemask_ID','unk')}")
##
try:
    while running == True:  # the main game loop
        # read serial i/o from arduino

        # !!! removed code for Arduino Reconnect - need to test if fine removed
        serial_list = serial_list[-9:]
        Arduino_Dump_Toggle = 0
        if arduino_stream.data.empty() == False:
            Arduino_Dump_Toggle = 1
            arduino_out = arduino_stream.data.get_nowait()
            arduino_list = [
                i.decode() for i in arduino_out.split(b"\r\n") if i != b" " and i != b""
            ]
            if len(arduino_list) > 0:
                serial_list += [str(cur_time)] + arduino_list
                serial_list = serial_list[-9:]
                print(serial_list)
            for i in arduino_list:
                if Challenge_phrase in i:
                    if Challenge_Toggle == 0:
                        Challenge_Timer = datetime.now()
                    Challenge_Toggle = 1
        # %% update state of program
        if sdr.finished == False:
            cur_STATUS_Dict["streaming"] = 1
        if sdr.finished == True:
            cur_STATUS_Dict["streaming"] = 0

        if Mode_dict[Current_Mode] == "calibration":
            cur_STATUS_Dict["calibration"] = 1
        else:
            cur_STATUS_Dict["calibration"] = 0

        if Mode_dict[Current_Mode] == "standby":
            cur_STATUS_Dict["standby"] = 1
        else:
            cur_STATUS_Dict["standby"] = 0

        if Mode_dict[Current_Mode] == "startup":
            cur_STATUS_Dict["startup"] = 1
        else:
            cur_STATUS_Dict["startup"] = 0
            cur_STATUS_Dict["startup_ready"] = 0
        ##
        # %% $$$$ scoreboard additions
        if Mode_dict[Current_Mode] == "Challenge":
            try:
                if (
                    cur_STATUS_Dict["challenge air"] == 0
                    and cur_STATUS_Dict["challenge gas"] == 0
                ):
                    cur_STATUS_Dict["challenge gas"] = 1
                    slb_COLOR2 = BLACK
                    value_Challenge_Counter = 1
                    value_CurrentChallengeCO2_Start = datetime.now()
                    # print('first challenge')
                    if logger:
                        logger.info("first challenge")

                elif (
                    SinceLastBreath >= SLB_Trigger or Abort_Toggle == 1
                ) and cur_STATUS_Dict["challenge gas"] == 1:
                    cur_STATUS_Dict["challenge air"] = 1
                    cur_STATUS_Dict["challenge gas"] = 0
                    Abort_Toggle = 0
                    slb_COLOR2 = YELLOW
                    value_CurrentChallengeRecovery_Start = datetime.now()
                    gasp_detected = 0
                    recovery_detected = 0
                    # print('{:#.2F} sec apnea detected'.format(SinceLastBreath))
                    serial_list.append("apnea detected")
                    if logger:
                        logger.info("apnea detected")
                    Challenge_Toggle = 0

                    # update last and longest CO2 values
                    value_LastCO2 = value_CurrentChallengeCO2_Timer
                    challenge_history[value_Challenge_Counter] = (
                        value_CurrentChallengeCO2_Timer
                    )
                    print("Challenge Duration History:")
                    for k, v in challenge_history.items():
                        print(f"{k}:{v:.0F}")
                    serial_list.append("Challenge Duration History:")

                    serial_list.append(
                        "|".join(
                            f"{i}:{challenge_history.get(i,-1):.0F}"
                            for i in range(1, 6)
                        )
                    )
                    if value_Challenge_Counter > 5:
                        serial_list.append(
                            "|".join(
                                f"{i}:{challenge_history.get(i,-1):.0F}"
                                for i in range(6, 11)
                            )
                        )
                    if value_Challenge_Counter > 10:
                        serial_list.append(
                            "|".join(
                                f"{i}:{challenge_history.get(i,-1):.0F}"
                                for i in range(11, 16)
                            )
                        )
                    if value_Challenge_Counter > 15:
                        serial_list.append(
                            "|".join(
                                f"{i}:{challenge_history.get(i,-1):.0F}"
                                for i in range(16, 21)
                            )
                        )

                    if value_LongestCO2_challenge == "NA":
                        value_LongestCO2_duration = value_CurrentChallengeCO2_Timer
                        value_LongestCO2_challenge = value_Challenge_Counter
                    else:
                        if value_LongestCO2_duration <= value_CurrentChallengeCO2_Timer:
                            value_LongestCO2_duration = value_CurrentChallengeCO2_Timer
                            value_LongestCO2_challenge = value_Challenge_Counter

                    # if value_CurrentChallenge_Timer<1+SLB_Trigger+Challenge_Delay:
                    # #print('Recommend Update to Challenge Thresh!')
                    # serial_list+=['!!!','Warning - False Apnea Likely',
                    # 'Recommend Update to Threshold2',
                    # '!!!']
                    # logger.warning('Warning - False Apnea Likely. Recommend Update to Threshold2',)
                    # WarningColor=RED
                    # WarningText='[CLEAR]!!Check Threshold2!!'

                # test for overly long challenge induction
                if (
                    value_CurrentChallengeCO2_Timer
                    >= long_challenge_induction_threshold
                ):
                    if logger:
                        logger.info(
                            f"OVERLY LONG INDUCTION ({value_CurrentChallengeCO2_Timer}>{long_challenge_induction_threshold}sec)"
                        )
                    serial_list.append(
                        f"OVERLY LONG INDUCTION ({value_CurrentChallengeCO2_Timer}>{long_challenge_induction_threshold}sec)"
                    )
                    Current_Mode = advance(Current_Mode, 0, len(Mode_dict) - 1)
                    sdr.stopStreamData()

                    sdrThread.join()
                    while sdr.data.empty() != True:
                        try:
                            q = (
                                sdr.data.get()
                            )  # this may toss the lagged data when switching modes...should be ok if lag is <1sec...may want to consider a better clean up function that puts in in the output file
                        except:
                            pass
                    print("resetting stream")
                    CT_value = d.getTemperature() - 273.15
                    REL_TIMER = 0
                    missed = 0
                    sdrThread = threading.Thread(target=sdr.readStreamData)
                    sdrThread.start()
                    box_MODE.update(BLACK, WHITE, Mode_dict[Current_Mode])

                    serialtext = "<Z,0,0>"
                    try:
                        ser.write(serialtext.encode())
                        log_to_file(logger, "{} - sent".format(serialtext))
                        if logger:
                            logger.info("{} - sent".format(serialtext))
                    except:
                        if logger:
                            logger.warning(
                                'unable to transmit "{} "via serial io'.format(
                                    serialtext
                                )
                            )

                    serialtext = "<D,0,0>"
                    try:
                        ser.write(serialtext.encode())
                        log_to_file(logger, "{} - sent".format(serialtext))
                        if logger:
                            logger.info("{} - sent".format(serialtext))
                    except:
                        if logger:
                            logger.warning(
                                'unable to transmit "{} "via serial io'.format(
                                    serialtext
                                )
                            )

                # test for animal being recovered
                # !!! added condition for sustained recovery and use of incrementable recovery timer
                elif (
                    SinceLastBreath <= SLB_Trigger
                    and 60 / avgTT >= baseBPM * BPM_recovery_thresh / 100
                    and current_recovery >= current_minimum_resus_time
                    and cur_STATUS_Dict["challenge air"] == 1
                    and (
                        (
                            current_maximum_sustained_recovery_bout
                            >= minimum_sustained_recovery
                            and recovery_mode == "consecutive"
                        )
                        or (
                            accumulated_recovery >= minimum_sustained_recovery
                            and recovery_mode == "accumulated"
                        )
                    )
                    and (
                        60 / avgRR >= baseHR * HR_recovery_thresh / 100
                        or HR_recovery_thresh == 0
                    )
                ):
                    cur_STATUS_Dict["challenge air"] = 0
                    cur_STATUS_Dict["challenge gas"] = 1
                    slb_COLOR2 = BLACK
                    value_Challenge_Counter += 1
                    value_CurrentChallengeCO2_Start = datetime.now()

                    print("gas mode")
                    print(
                        "{} SLB, {} RR {} baseHR {} current recovery".format(
                            SinceLastBreath, avgRR, baseHR, current_recovery
                        )
                    )
            except Exception as e:
                print("challenge mode parsing error - {}".format(e))

            if SinceLastBreath >= CALL_DEATH_trigger:
                if logger:
                    logger.info("DEATH CALLED")
                serial_list.append("DEATH CALLED")
                Current_Mode = advance(Current_Mode, 0, len(Mode_dict) - 1)
                sdr.stopStreamData()

                sdrThread.join()
                while sdr.data.empty() != True:
                    try:
                        q = (
                            sdr.data.get()
                        )  # this may toss the lagged data when switching modes...should be ok if lag is <1sec...may want to consider a better clean up function that puts in in the output file
                    except:
                        pass
                print("resetting stream")
                CT_value = d.getTemperature() - 273.15
                REL_TIMER = 0
                missed = 0
                sdrThread = threading.Thread(target=sdr.readStreamData)
                sdrThread.start()
                box_MODE.update(BLACK, WHITE, Mode_dict[Current_Mode])

        ## $$$$

        # %%
        # process status changes
        if cur_STATUS_Dict != old_STATUS_Dict:
            old_STATUS_Dict = dict(
                processStatus(
                    cur_STATUS_Dict, d, ser, Arduino_Function_Constants, logger=logger
                )
            )
            if logger:
                logger.warning(
                    f"change in status - {Current_Mode} - {Mode_dict[Current_Mode]}"
                )

        # %%

        if old_STATUS_Dict["startup_ready"] == 1:
            finish_startup.update(BLUE, WHITE, "Finish Startup")
            sprite_list.add(finish_startup)
            cur_STATUS_Dict["startup_ready"] == 1

        # TODO is pulse processing not needed with transition to serial i/o
        # process pulses
        for i in cur_STATUS_Dict["pulse"]:
            if cur_STATUS_Dict["pulse"][i]["state"] == 1:
                cur_STATUS_Dict["pulse"][i]["state"] = pulse_ender(
                    d,
                    cur_STATUS_Dict["pulse"][i]["pin"],
                    cur_STATUS_Dict["pulse"][i]["start"],
                    pulse_duration,
                )

        # %% adjust Current_Mode timer if more baseline is needed - added for v42.1.0
        if (
            Mode_dict.get(Current_Mode + 1, "n/a") == "Challenge"
            and Mode_timing[Current_Mode] <= REL_TIMER
        ):
            current_QB_duration = float(QB_duration)
            if quality_test == 1 and REL_TIMER - QB_TIMER >= QB_minimum_duration:
                current_QB_duration += REL_TIMER - QB_TIMER
            if minimum_cummulative_QB_duration > current_QB_duration:
                Mode_timing[Current_Mode] += baseline_increment
                serial_list.append(
                    f"insufficient baseline {current_QB_duration} of {minimum_cummulative_QB_duration} - {baseline_increment} sec added"
                )
                if logger:
                    logger.warning(
                        f"insufficient baseline {current_QB_duration} of {minimum_cummulative_QB_duration} - {baseline_increment} sec added"
                    )

        # check for auto advance

        if (
            cur_STATUS_Dict["ready to save"] == 1 or Current_Mode < 2
        ):  # !!! update needed when shift to config file addressing 'save lock'
            if Mode_timing[Current_Mode] < 0:
                pass
            elif Mode_timing[Current_Mode] <= REL_TIMER:
                print("auto advance")
                Current_Mode = advance(Current_Mode, 0, len(Mode_dict) - 1)
                sdr.stopStreamData()

                sdrThread.join()
                while sdr.data.empty() != True:
                    try:
                        q = (
                            sdr.data.get()
                        )  # this may toss the lagged data when switching modes...should be ok if lag is <1sec...may want to consider a better clean up function that puts in in the output file
                    except:
                        pass
                print("resetting stream")
                CT_value = d.getTemperature() - 273.15
                REL_TIMER = 0
                missed = 0
                sdrThread = threading.Thread(target=sdr.readStreamData)
                sdrThread.start()
                box_MODE.update(BLACK, WHITE, Mode_dict[Current_Mode])

        # update from prior button clicks
        for event in pygame.event.get():
            if event.type == pygame.MOUSEBUTTONDOWN:
                if event.button == 1:
                    print("left clicked")
                    print(event.pos)
                for i in box_mode_select:
                    if box_mode_select[i].rect.collidepoint(event.pos) and (
                        cur_STATUS_Dict["ready to save"] == 1
                        or (i < 3 and Current_Mode < 3)
                    ):  # !!! will need update when updated to config file version addressing 'save lock'
                        Current_Mode = i
                        sdr.stopStreamData()

                        sdrThread.join()
                        while sdr.data.empty() != True:
                            try:
                                q = (
                                    sdr.data.get()
                                )  # this will toss the lagged data when switching modes...should be ok if lag is <1sec...may want to consider a better clean up function that puts in in the output file
                            except:
                                pass
                        print("resetting stream")
                        CT_value = d.getTemperature() - 273.15
                        REL_TIMER = 0
                        missed = 0
                        sdrThread = threading.Thread(target=sdr.readStreamData)
                        sdrThread.start()
                        box_MODE.update(BLACK, WHITE, Mode_dict[Current_Mode])
                    if (
                        box_mode_times[i].rect.collidepoint(event.pos)
                        and "Signal Preview" in Mode_dict[Current_Mode]
                    ):
                        Mode_timing[i] = 60 * guiGetFloat(
                            "enter duration",
                            "enter duration in minutes for \n{}\n(enter a negative number to hold until user advances)".format(
                                Mode_dict[i]
                            ),
                            Mode_timing[i],
                        )
                        box_mode_select[i].update(
                            DGREY,
                            WHITE,
                            "{}:{:#.2F}".format(Mode_dict[i], Mode_timing[i] / 60),
                        )
                if (
                    box_Synch.rect.collidepoint(event.pos)
                    and "Signal Preview" in Mode_dict[Current_Mode]
                ):

                    sdr.stopStreamData()

                    sdrThread.join()
                    while sdr.data.empty() != True:
                        try:
                            q = (
                                sdr.data.get()
                            )  # this will toss the lagged data when switching modes...should be ok if lag is <1sec...may want to consider a better clean up function that puts in in the output file
                        except:
                            pass
                    print("resetting stream")
                    CT_value = d.getTemperature() - 273.15
                    REL_TIMER = 0
                    missed = 0
                    sdrThread = threading.Thread(target=sdr.readStreamData)
                    sdrThread.start()
                    box_MODE.update(BLACK, WHITE, Mode_dict[Current_Mode])
                # elif box_NEXT.rect.collidepoint(event.pos) and cur_STATUS_Dict['ready to save']==1:
                elif box_NEXT.rect.collidepoint(event.pos) and (
                    cur_STATUS_Dict["ready to save"] == 1 or Current_Mode < 2
                ):  # !!! need to fix this with config update for 'save lock'
                    print("user advance")
                    Current_Mode = advance(Current_Mode, 0, len(Mode_dict) - 1)
                    sdr.stopStreamData()

                    sdrThread.join()
                    while sdr.data.empty() != True:
                        try:
                            q = (
                                sdr.data.get()
                            )  # this will toss the lagged data when switching modes...should be ok if lag is <1sec...may want to consider a better clean up function that puts in in the output file
                        except:
                            pass
                    print("resetting stream")
                    CT_value = d.getTemperature() - 273.15
                    REL_TIMER = 0
                    missed = 0
                    sdrThread = threading.Thread(target=sdr.readStreamData)
                    sdrThread.start()
                    box_MODE.update(BLACK, WHITE, Mode_dict[Current_Mode])

                # elif box_SAVE.rect.collidepoint(event.pos) and Current_Mode==0:
                elif (
                    box_SAVE.rect.collidepoint(event.pos) and Current_Mode < 3
                ):  # !!! this will need to be changed when shifted to config file setup - set this so that save is expected before first 'savable' mode

                    new_OUTPUTFILE, new_rts, fm_record_dict = save_button()
                    if fm_record_dict:
                        fm_tools.update_record(
                            credentials,
                            database,
                            layout,
                            fm_record_dict["recordId"],
                            {
                                "Rig": rig_config["RIGNAME"],
                                "Acquisition_Software_Version": f"{__version__} - {__git_status__}",
                            },
                        )
                    if new_rts == 0:
                        pass
                    else:
                        cur_STATUS_Dict["ready to save"] = new_rts
                        OUTPUTFILE = str(new_OUTPUTFILE)
                        box_SAVE.update(WHITE, BLUE, os.path.basename(OUTPUTFILE))
                        logger = setup_logging(OUTPUTFILE[:-4])
                        print("Logging file setup done")

                elif (
                    box_oldSave.rect.collidepoint(event.pos) and Current_Mode < 3
                ):  # !!! this will need to be changed when shifted to config file setup - set this so that save is expected before first 'savable' mode

                    new_OUTPUTFILE, new_rts, fm_record_dict = old_save_button()
                    if new_rts == 0:
                        pass
                    else:
                        cur_STATUS_Dict["ready to save"] = new_rts
                        OUTPUTFILE = str(new_OUTPUTFILE)
                        box_SAVE.update(WHITE, BLUE, os.path.basename(OUTPUTFILE))
                        logger = setup_logging(OUTPUTFILE[:-4])
                        print("Logging file setup done")

                elif (
                    box_NOTIFICATION.rect.collidepoint(event.pos) and Current_Mode == 0
                ):
                    EMAIL_SETTINGS = guiOpenFileName(
                        {"title": "select file with email notification settings"}
                    )
                    box_NOTIFICATION.update(WHITE, BLUE, "NOTIFICATIONS-ON")

                elif Position_RA.rect.collidepoint(event.pos):
                    Arduino_Function_Constants["Position_RA"] = guiGetFloat(
                        "Room Air Position",
                        "Room Air Position",
                        Arduino_Function_Constants["Position_RA"],
                    )
                    Position_RA.update(
                        BLACK,
                        WHITE,
                        "RA position: {}".format(
                            Arduino_Function_Constants["Position_RA"]
                        ),
                    )
                elif Position_Gas.rect.collidepoint(event.pos):
                    Arduino_Function_Constants["Position_Gas"] = guiGetFloat(
                        "Gas Position",
                        "Gas Position",
                        Arduino_Function_Constants["Position_Gas"],
                    )
                    Position_Gas.update(
                        BLACK,
                        WHITE,
                        "Gas position: {}".format(
                            Arduino_Function_Constants["Position_Gas"]
                        ),
                    )
                elif Duration_Cal.rect.collidepoint(event.pos):
                    Arduino_Function_Constants["Duration_Cal"] = guiGetFloat(
                        "Calibration Duration",
                        "Calibration Duration",
                        Arduino_Function_Constants["Duration_Cal"],
                    )
                    Duration_Cal.update(
                        BLACK,
                        WHITE,
                        "Cal dur: {}".format(
                            Arduino_Function_Constants["Duration_Cal"]
                        ),
                    )
                elif Duration_Prefill.rect.collidepoint(event.pos):
                    Arduino_Function_Constants["Duration_Prefill"] = guiGetFloat(
                        "Prefill Duration",
                        "Prefill Duration",
                        Arduino_Function_Constants["Duration_Prefill"],
                    )
                    Duration_Prefill.update(
                        BLACK,
                        WHITE,
                        "Prefill dur {}".format(
                            Arduino_Function_Constants["Duration_Prefill"]
                        ),
                    )
                elif Duration_Challenge_Delay.rect.collidepoint(event.pos):
                    Challenge_Delay = guiGetFloat(
                        "Challenge Delay", "Challenge Delay", Challenge_Delay
                    )
                    Duration_Challenge_Delay.update(
                        BLACK, WHITE, "Challenge Delay: {}".format(Challenge_Delay)
                    )
                elif Text_Challenge_Phrase.rect.collidepoint(event.pos):
                    Challenge_Delay = guiGetText(
                        "Challenge Signal Phrase",
                        "Challenge Signal Phrase",
                        Challenge_phrase,
                    )

                    Text_Challenge_Phrase.update(
                        BLACK, WHITE, "Phrase: {}".format(Challenge_phrase)
                    )
                elif Serial_Abort.rect.collidepoint(event.pos):
                    serialtext = "<Z,0,0>"
                    try:
                        ser.write(serialtext.encode())
                        log_to_file(logger, "{} - sent".format(serialtext))
                        if logger:
                            logger.info("{} - sent".format(serialtext))
                    except:
                        if logger:
                            logger.warning(
                                'unable to transmit "{} "via serial io'.format(
                                    serialtext
                                )
                            )
                elif box_arduino_quick_1.rect.collidepoint(event.pos):
                    serialtext = box_arduino_quick_1.label
                    try:
                        ser.write(serialtext.encode())
                        log_to_file(logger, "{} - sent".format(serialtext))
                        if logger:
                            logger.warning(
                                "{} - sent - rig override !!!".format(serialtext)
                            )
                    except:
                        if logger:
                            logger.warning(
                                'unable to transmit "{} "via serial io - rig override attemped but failed !!!'.format(
                                    serialtext
                                )
                            )
                elif box_arduino_quick_2.rect.collidepoint(event.pos):
                    serialtext = box_arduino_quick_2.label
                    try:
                        ser.write(serialtext.encode())
                        log_to_file(logger, "{} - sent".format(serialtext))
                        if logger:
                            logger.warning(
                                "{} - sent - rig override !!!".format(serialtext)
                            )
                    except:
                        if logger:
                            logger.warning(
                                'unable to transmit "{} "via serial io - rig override attemped but failed !!!'.format(
                                    serialtext
                                )
                            )
                elif box_arduino_quick_3.rect.collidepoint(event.pos):
                    serialtext = box_arduino_quick_3.label
                    try:
                        ser.write(serialtext.encode())
                        log_to_file(logger, "{} - sent".format(serialtext))
                        if logger:
                            logger.warning(
                                "{} - sent - rig override !!!".format(serialtext)
                            )
                    except:
                        if logger:
                            logger.warning(
                                'unable to transmit "{} "via serial io - rig override attemped but failed !!!'.format(
                                    serialtext
                                )
                            )
                elif box_arduino_quick_4.rect.collidepoint(event.pos):
                    serialtext = box_arduino_quick_4.label
                    try:
                        ser.write(serialtext.encode())
                        log_to_file(logger, "{} - sent".format(serialtext))
                        if logger:
                            logger.warning(
                                "{} - sent - rig override !!!".format(serialtext)
                            )
                    except:
                        if logger:
                            logger.warning(
                                'unable to transmit "{} "via serial io - rig override attemped but failed !!!'.format(
                                    serialtext
                                )
                            )
                elif box_arduino_quick_5.rect.collidepoint(event.pos):
                    serialtext = box_arduino_quick_5.label
                    try:
                        ser.write(serialtext.encode())
                        log_to_file(logger, "{} - sent".format(serialtext))
                        if logger:
                            logger.warning(
                                "{} - sent - rig override !!!".format(serialtext)
                            )
                    except:
                        if logger:
                            logger.warning(
                                'unable to transmit "{} "via serial io - rig override attemped but failed !!!'.format(
                                    serialtext
                                )
                            )
                elif box_arduino_quick_6.rect.collidepoint(event.pos):
                    serialtext = box_arduino_quick_6.label
                    try:
                        ser.write(serialtext.encode())
                        log_to_file(logger, "{} - sent".format(serialtext))
                        if logger:
                            logger.warning(
                                "{} - sent - rig override !!!".format(serialtext)
                            )
                    except:
                        if logger:
                            logger.warning(
                                'unable to transmit "{} "via serial io - rig override attemped but failed !!!'.format(
                                    serialtext
                                )
                            )

                elif Serial_Rec_OR.rect.collidepoint(event.pos):
                    Recovery_Override_Toggle = 1
                    print("override")
                elif Serial_ShutDown.rect.collidepoint(event.pos):
                    serialtext = "<D,0,0>"
                    try:
                        ser.write(serialtext.encode())
                        log_to_file(logger, "{} - sent".format(serialtext))
                        if logger:
                            logger.info("{} - sent".format(serialtext))
                    except:
                        if logger:
                            logger.warning(
                                'unable to transmit "{} "via serial io'.format(
                                    serialtext
                                )
                            )

                elif (
                    finish_startup.rect.collidepoint(event.pos)
                    and cur_STATUS_Dict["startup_ready"] == 1
                ):
                    serialtext = "<E,0,0>"
                    try:
                        ser.write(serialtext.encode())
                        log_to_file(logger, "{} - sent".format(serialtext))
                        if logger:
                            logger.info("{} - sent".format(serialtext))
                    except:
                        if logger:
                            logger.warning(
                                'unable to transmit "{} "via serial io'.format(
                                    serialtext
                                )
                            )
                    cur_STATUS_Dict["startup_ready"] = 2
                    finish_startup.update(BLACK, BLACK, "")

                elif SerialOutTester.rect.collidepoint(
                    event.pos
                ):  # and Current_Mode==0:
                    serialtext = guiGetText("serial output", "serial output", "")
                    try:
                        ser.write(serialtext.encode())
                        log_to_file(logger, "{} - sent".format(serialtext))
                        print("{} - sent".format(serialtext))
                    except:
                        print(
                            'unable to transmit "{} "via serial io'.format(serialtext)
                        )

                elif g1_ymax_inc.rect.collidepoint(event.pos):
                    g1_y_minmax[1] += increment
                elif g1_ymax_dec.rect.collidepoint(event.pos):
                    g1_y_minmax[1] -= increment
                elif g1_ymax_reset.rect.collidepoint(event.pos):
                    g1_y_minmax[1] = 2  # need dict for default values
                elif g1_ymax_float.rect.collidepoint(event.pos):
                    g1_y_minmax[1] = guiGetFloat(
                        "Maximum for Graph 1", "Maximum for Graph 1", g1_y_minmax[1]
                    )
                elif g1_ymin_inc.rect.collidepoint(event.pos):
                    g1_y_minmax[0] += increment
                elif g1_ymin_dec.rect.collidepoint(event.pos):
                    g1_y_minmax[0] -= increment
                elif g1_ymin_reset.rect.collidepoint(event.pos):
                    g1_y_minmax[0] = -2  # need dict for default values
                elif g1_ymin_float.rect.collidepoint(event.pos):
                    g1_y_minmax[0] = guiGetFloat(
                        "Minimum for Graph 1", "Minimum for Graph 1", g1_y_minmax[0]
                    )

                elif g2_ymax_inc.rect.collidepoint(event.pos):
                    g2_y_minmax[1] += increment
                elif g2_ymax_dec.rect.collidepoint(event.pos):
                    g2_y_minmax[1] -= increment
                elif g2_ymax_reset.rect.collidepoint(event.pos):
                    g2_y_minmax[1] = 5  # need dict for default values
                elif g2_ymax_float.rect.collidepoint(event.pos):
                    g2_y_minmax[1] = guiGetFloat(
                        "Maximum for Graph 2", "Maximum for Graph 2", g2_y_minmax[1]
                    )
                elif g2_ymin_inc.rect.collidepoint(event.pos):
                    g2_y_minmax[0] += increment
                elif g2_ymin_dec.rect.collidepoint(event.pos):
                    g2_y_minmax[0] -= increment
                elif g2_ymin_reset.rect.collidepoint(event.pos):
                    g2_y_minmax[0] = -1  # need dict for default values
                elif g2_ymin_float.rect.collidepoint(event.pos):
                    g2_y_minmax[0] = guiGetFloat(
                        "Minimum for Graph 2", "Minimum for Graph 2", g2_y_minmax[0]
                    )

                elif g3_ymax_inc.rect.collidepoint(event.pos):
                    g3_y_minmax[1] += increment
                elif g3_ymax_dec.rect.collidepoint(event.pos):
                    g3_y_minmax[1] -= increment
                elif g3_ymax_reset.rect.collidepoint(event.pos):
                    g3_y_minmax[1] = 5  # need dict for default values
                elif g3_ymax_float.rect.collidepoint(event.pos):
                    g3_y_minmax[1] = guiGetFloat(
                        "Maximum for Graph 3", "Maximum for Graph 3", g3_y_minmax[1]
                    )
                elif g3_ymin_inc.rect.collidepoint(event.pos):
                    g3_y_minmax[0] += increment
                elif g3_ymin_dec.rect.collidepoint(event.pos):
                    g3_y_minmax[0] -= increment
                elif g3_ymin_reset.rect.collidepoint(event.pos):
                    g3_y_minmax[0] = -1  # need dict for default values
                elif g3_ymin_float.rect.collidepoint(event.pos):
                    g3_y_minmax[0] = guiGetFloat(
                        "Minimum for Graph 3", "Minimum for Graph 3", g3_y_minmax[0]
                    )

                elif baseline_flow_inc.rect.collidepoint(event.pos):
                    baseline_flow += increment
                elif baseline_flow_dec.rect.collidepoint(event.pos):
                    baseline_flow -= increment
                elif baseline_flow_reset.rect.collidepoint(event.pos):
                    baseline_flow = 0
                elif baseline_flow_float.rect.collidepoint(event.pos):
                    baseline_flow = guiGetFloat(
                        "Baseline for Graph 1", "Baseline for Graph 1", baseline_flow
                    )

                elif thresh_flow_inc.rect.collidepoint(event.pos):
                    thresh_flow += increment
                elif thresh_flow_dec.rect.collidepoint(event.pos):
                    thresh_flow -= increment
                elif thresh_flow_reset.rect.collidepoint(event.pos):
                    thresh_flow = 0.25
                elif thresh_flow_float.rect.collidepoint(event.pos):
                    thresh_flow = guiGetFloat(
                        "Threshold for Flow", "Threshold for Flow", thresh_flow
                    )

                elif thresh2_flow_inc.rect.collidepoint(event.pos):
                    thresh2_flow += increment
                elif thresh2_flow_dec.rect.collidepoint(event.pos):
                    thresh2_flow -= increment
                elif thresh2_flow_reset.rect.collidepoint(event.pos):
                    thresh2_flow = 0.5
                elif thresh2_flow_float.rect.collidepoint(event.pos):
                    thresh2_flow = guiGetFloat(
                        "Threshold 2 for Flow", "Threshold 2 for Flow", thresh2_flow
                    )

                elif baseline_vol_inc.rect.collidepoint(event.pos):
                    baseline_vol += increment
                elif baseline_vol_dec.rect.collidepoint(event.pos):
                    baseline_vol -= increment
                elif baseline_vol_reset.rect.collidepoint(event.pos):
                    baseline_vol = 0
                elif baseline_vol_float.rect.collidepoint(event.pos):
                    baseline_vol = guiGetFloat(
                        "Baseline for Graph 2", "Baseline for Graph 2", baseline_vol
                    )

                elif thresh_vol_inc.rect.collidepoint(event.pos):
                    thresh_vol += increment
                elif thresh_vol_dec.rect.collidepoint(event.pos):
                    thresh_vol -= increment
                elif thresh_vol_reset.rect.collidepoint(event.pos):
                    thresh_vol = 0.25
                elif thresh_vol_float.rect.collidepoint(event.pos):
                    thresh_vol = guiGetFloat(
                        "Threshold for Volume", "Threshold for Volume", thresh_vol
                    )

                elif baseline_ecg_inc.rect.collidepoint(event.pos):
                    baseline_ecg += increment
                elif baseline_ecg_dec.rect.collidepoint(event.pos):
                    baseline_ecg -= increment
                elif baseline_ecg_reset.rect.collidepoint(event.pos):
                    baseline_ecg = 0
                elif baseline_ecg_float.rect.collidepoint(event.pos):
                    baseline_ecg = guiGetFloat(
                        "Baseline for Graph 2", "Baseline for Graph 2", baseline_ecg
                    )

                elif thresh_ecg1_inc.rect.collidepoint(event.pos):
                    thresh_ecg1 += increment
                elif thresh_ecg1_dec.rect.collidepoint(event.pos):
                    thresh_ecg1 -= increment
                elif thresh_ecg1_reset.rect.collidepoint(event.pos):
                    thresh_ecg1 = 4
                elif thresh_ecg1_float.rect.collidepoint(event.pos):
                    thresh_ecg1 = guiGetFloat(
                        "Threshold 1 for ECG", "Threshold 1 for ECG", thresh_ecg1
                    )

                elif thresh_ecg2_inc.rect.collidepoint(event.pos):
                    thresh_ecg2 += increment
                elif thresh_ecg2_dec.rect.collidepoint(event.pos):
                    thresh_ecg2 -= increment
                elif thresh_ecg2_reset.rect.collidepoint(event.pos):
                    thresh_ecg2 = 2.5
                elif thresh_ecg2_float.rect.collidepoint(event.pos):
                    thresh_ecg2 = guiGetFloat(
                        "Threshold 2 for ECG", "Threshold 2 for ECG", thresh_ecg2
                    )

                elif noise_ecg_inc.rect.collidepoint(event.pos):
                    noise_ecg += increment
                elif noise_ecg_dec.rect.collidepoint(event.pos):
                    noise_ecg -= increment
                elif noise_ecg_reset.rect.collidepoint(event.pos):
                    noise_ecg = 75
                elif noise_ecg_float.rect.collidepoint(event.pos):
                    noise_ecg = guiGetFloat(
                        "noise cutoff for Graph 3",
                        "noise cutoff for Graph 3",
                        noise_ecg,
                    )

                elif absthresh_ecg_inc.rect.collidepoint(event.pos):
                    absthresh_ecg += increment
                elif absthresh_ecg_dec.rect.collidepoint(event.pos):
                    absthresh_ecg -= increment
                elif absthresh_ecg_reset.rect.collidepoint(event.pos):
                    absthresh_ecg = 0.3
                elif absthresh_ecg_float.rect.collidepoint(event.pos):
                    absthresh_ecg = guiGetFloat(
                        "absolute thresh cutoff for Graph 3",
                        "absolute thresh cutoff for Graph 3",
                        absthresh_ecg,
                    )

                elif inc_inc.rect.collidepoint(event.pos):
                    increment *= 10
                elif inc_dec.rect.collidepoint(event.pos):
                    increment /= 10
                elif inc_reset.rect.collidepoint(event.pos):
                    increment = 0.1
                elif inc_float.rect.collidepoint(event.pos):
                    increment = guiGetFloat(
                        "Adjust Increment Value", "Adjust Increment Value", increment
                    )

                # restrict actions on tweakables to signal preview periods
                # remove restrictions on mode for filter toggles and signal invert
                # elif ECGFILT_TOGGLE.rect.collidepoint(event.pos) and 'Signal Preview' in Mode_dict[Current_Mode]:
                elif ECGFILT_TOGGLE.rect.collidepoint(event.pos):
                    ecg_filt_state = toggle(ecg_filt_state)
                elif PLETHFILT_TOGGLE.rect.collidepoint(event.pos):
                    pleth_filt_state = toggle(pleth_filt_state)
                elif INVERT_FLOW_TOGGLE.rect.collidepoint(event.pos):
                    INVERT_FLOW = toggle(INVERT_FLOW)
                    if INVERT_FLOW == 1:
                        INVERT_FLOW_TOGGLE.update(
                            BLACK, WHITE, "Invert Flow:{}".format(INVERT_FLOW)
                        )
                    else:
                        INVERT_FLOW_TOGGLE.update(
                            WHITE, BLACK, "Invert Flow:{}".format(INVERT_FLOW)
                        )
                elif INVERT_ECG_TOGGLE.rect.collidepoint(event.pos):
                    INVERT_ECG = toggle(INVERT_ECG)
                    if INVERT_ECG == 1:
                        INVERT_ECG_TOGGLE.update(
                            BLACK, WHITE, "Invert ECG:{}".format(INVERT_ECG)
                        )
                    else:
                        INVERT_ECG_TOGGLE.update(
                            WHITE, BLACK, "Invert ECG:{}".format(INVERT_ECG)
                        )

                elif (
                    box_SLB_trigger.rect.collidepoint(event.pos)
                    and "Signal Preview" in Mode_dict[Current_Mode]
                ):
                    SLB_Trigger = guiGetFloat(
                        "SLB trigger time", "SLB trigger time", SLB_Trigger
                    )
                    SLB_Trigger_Setter.update(
                        WHITE, BLACK, "SLB: {:#.2F} sec".format(SLB_Trigger)
                    )
                    box_SLB_trigger.update(
                        YELLOW, BLACK, "SLB: {:#.2F} sec".format(SLB_Trigger)
                    )

                elif (
                    box_minimum_resus_time.rect.collidepoint(event.pos)
                    and "Signal Preview" in Mode_dict[Current_Mode]
                ):
                    minimum_resus_time = guiGetFloat(
                        "minimum resus time (sec)",
                        "minimum resus time (sec)",
                        minimum_resus_time,
                    )

                elif (
                    box_CALL_DEATH_trigger.rect.collidepoint(event.pos)
                    and "Signal Preview" in Mode_dict[Current_Mode]
                ):
                    CALL_DEATH_trigger = 60 * guiGetFloat(
                        "CALL DEATH trigger time (min)",
                        "CALL DEATH trigger time (min)",
                        CALL_DEATH_trigger,
                    )
                    box_CALL_DEATH_trigger.update(
                        YELLOW,
                        BLACK,
                        "CALL DEATH: {:#.2F} min".format(CALL_DEATH_trigger / 60),
                    )
                elif (
                    box_HR_recovery_thresh.rect.collidepoint(event.pos)
                    and "Signal Preview" in Mode_dict[Current_Mode]
                ):
                    HR_recovery_thresh = guiGetFloat(
                        "HR recovery thresh", "HR recovery thresh", HR_recovery_thresh
                    )
                elif (
                    box_BPM_recovery_thresh.rect.collidepoint(event.pos)
                    and "Signal Preview" in Mode_dict[Current_Mode]
                ):
                    BPM_recovery_thresh = guiGetFloat(
                        "BPM recovery thresh",
                        "BPM recovery thresh",
                        BPM_recovery_thresh,
                    )
                elif (
                    box_avgBPM_thresh.rect.collidepoint(event.pos)
                    and "Signal Preview" in Mode_dict[Current_Mode]
                ):
                    filt_crit_Dict["avgBPM"] = guiGetFloat(
                        "avg BPM threshold",
                        "avg BPM threshold",
                        filt_crit_Dict["avgBPM"],
                    )
                elif (
                    box_cvTT_thresh.rect.collidepoint(event.pos)
                    and "Signal Preview" in Mode_dict[Current_Mode]
                ):
                    filt_crit_Dict["cvTT"] = guiGetFloat(
                        "CV TT threshold", "CV TT threshold", filt_crit_Dict["cvTT"]
                    )
                elif (
                    box_avgHR_thresh.rect.collidepoint(event.pos)
                    and "Signal Preview" in Mode_dict[Current_Mode]
                ):
                    filt_crit_Dict["avgHR"] = guiGetFloat(
                        "avg HR threshold", "avg HR threshold", filt_crit_Dict["avgHR"]
                    )
                elif (
                    box_avgRR_thresh.rect.collidepoint(event.pos)
                    and "Signal Preview" in Mode_dict[Current_Mode]
                ):
                    filt_crit_Dict["avgRR"] = guiGetFloat(
                        "avg RR threshold", "avg RR threshold", filt_crit_Dict["avgRR"]
                    )
                elif (
                    box_cvRR_thresh.rect.collidepoint(event.pos)
                    and "Signal Preview" in Mode_dict[Current_Mode]
                ):
                    filt_crit_Dict["cvRR"] = guiGetFloat(
                        "CV RR threshold", "CV RR threshold", filt_crit_Dict["cvRR"]
                    )
                elif (
                    box_BSD_thresh.rect.collidepoint(event.pos)
                    and "Signal Preview" in Mode_dict[Current_Mode]
                ):
                    filt_crit_Dict["BSD"] = guiGetFloat(
                        "BSD threshold", "BSD threshold", filt_crit_Dict["BSD"]
                    )
                elif (
                    box_DVTV_thresh.rect.collidepoint(event.pos)
                    and "Signal Preview" in Mode_dict[Current_Mode]
                ):
                    filt_crit_Dict["DVTV"] = guiGetFloat(
                        "DVTV threshold", "DVTV threshold", filt_crit_Dict["DVTV"]
                    )
                elif (
                    box_QB_duration.rect.collidepoint(event.pos)
                    and "Signal Preview" in Mode_dict[Current_Mode]
                ):
                    QB_minimum_duration = guiGetFloat(
                        "Quality Bout minimum duration",
                        "Quality Bout minimum duration",
                        QB_minimum_duration,
                    )

                elif box_baseBPM.rect.collidepoint(event.pos):
                    baseBPM = guiGetFloat(
                        "Manually Set Baseline BPM",
                        "Manually Set Baseline BPM",
                        baseBPM,
                    )
                    box_baseBPM.update(GREEN, BLACK, "base BPM:{:#.1F}".format(baseBPM))
                elif box_baseHR.rect.collidepoint(event.pos):
                    baseHR = guiGetFloat(
                        "Manually Set Baseline HR", "Manually Set Baseline HR", baseHR
                    )
                    box_baseHR.update(GREEN, BLACK, "base HR:{:#.1F}".format(baseHR))

                else:
                    pass

            if event.type == pygame.QUIT:
                running = False
                if logger:
                    logger.info("exit")
        if running == False:

            sdr.stopStreamData()
            continue
        # update sprites
        g1_ymax_float.update(BLACK, WHITE, "{:#.3F}".format(g1_y_minmax[1]))
        g1_ymin_float.update(BLACK, WHITE, "{:#.3F}".format(g1_y_minmax[0]))
        g2_ymax_float.update(BLACK, WHITE, "{:#.3F}".format(g2_y_minmax[1]))
        g2_ymin_float.update(BLACK, WHITE, "{:#.3F}".format(g2_y_minmax[0]))
        g3_ymax_float.update(BLACK, WHITE, "{:#.3F}".format(g3_y_minmax[1]))
        g3_ymin_float.update(BLACK, WHITE, "{:#.3F}".format(g3_y_minmax[0]))
        inc_float.update(BLACK, WHITE, "{:#.3F}".format(increment))
        baseline_flow_float.update(BLACK, WHITE, "{:#.3F}".format(baseline_flow))
        thresh_flow_float.update(BLACK, WHITE, "{:#.3F}".format(thresh_flow))
        thresh2_flow_float.update(BLACK, WHITE, "{:#.3F}".format(thresh2_flow))
        baseline_vol_float.update(BLACK, WHITE, "{:#.3F}".format(baseline_vol))
        thresh_vol_float.update(BLACK, WHITE, "{:#.3F}".format(thresh_vol))
        baseline_ecg_float.update(BLACK, WHITE, "{:#.3F}".format(baseline_ecg))
        noise_ecg_float.update(BLACK, WHITE, "{:#.1F}".format(noise_ecg))
        absthresh_ecg_float.update(BLACK, WHITE, "{:#.3F}".format(absthresh_ecg))
        thresh_ecg1_float.update(BLACK, WHITE, "{:#.1F}".format(thresh_ecg1))
        thresh_ecg2_float.update(BLACK, WHITE, "{:#.1F}".format(thresh_ecg2))
        # $$$$ scoreboard

        SO1.update_left(DGREY, WHITE, serial_list[0])
        SO2.update_left(DGREY, WHITE, serial_list[1])
        SO3.update_left(DGREY, WHITE, serial_list[2])
        SO4.update_left(DGREY, WHITE, serial_list[3])
        SO5.update_left(DGREY, WHITE, serial_list[4])
        SO6.update_left(DGREY, WHITE, serial_list[5])
        SO7.update_left(DGREY, WHITE, serial_list[6])
        SO8.update_left(DGREY, WHITE, serial_list[7])
        SO9.update_left(DGREY, WHITE, serial_list[8])

        # collect important timestamps
        if Mode_dict[Current_Mode] == "Habituation-1" and Current_Mode != prev_Mode:
            fm_record_dict["time started"] = datetime.now().strftime("%H:%M")

        if Mode_dict[Current_Mode] == "Habituation-2" and Current_Mode != prev_Mode:
            fm_record_dict["Time of Injection"] = datetime.now().strftime("%H:%M")

        if cur_STATUS_Dict["challenge gas"] == 1:
            Challenge_Counter.update(
                WHITE, BLACK, "Challenge #: {}".format(value_Challenge_Counter)
            )
            value_CurrentChallengeCO2_Timer_uncorrected = (
                cur_time - value_CurrentChallengeCO2_Start
            )
            if Challenge_Toggle == 0:
                value_CurrentChallengeCO2_Timer = (
                    value_CurrentChallengeCO2_Timer_uncorrected.days * 24 * 60 * 60
                    + value_CurrentChallengeCO2_Timer_uncorrected.seconds
                    - Arduino_Function_Constants["Duration_Prefill"]
                )
            else:
                value_CurrentChallengeCO2_Timer = (
                    cur_time - Challenge_Timer
                ).days * 24 * 60 * 60 + (cur_time - Challenge_Timer).seconds

            CurrentChallengeCO2_Timer.update(
                WHITE, BLACK, "CO2: {} sec".format(value_CurrentChallengeCO2_Timer)
            )

        elif cur_STATUS_Dict["challenge air"] == 1:
            value_CurrentChallengeRecovery_Timer = (
                cur_time - value_CurrentChallengeRecovery_Start
            )
            CurrentChallengeRecovery_Timer.update(
                WHITE,
                BLACK,
                "Rec: {} sec".format(
                    value_CurrentChallengeRecovery_Timer.days * 24 * 60 * 60
                    + value_CurrentChallengeRecovery_Timer.seconds
                ),
            )
            LastCO2.update(YELLOW, BLACK, "Last CO2: {}s".format(value_LastCO2))
            LongestCO2.update(
                YELLOW,
                BLACK,
                "Long CO2: Ch{}, {}s".format(
                    value_LongestCO2_challenge, value_LongestCO2_duration
                ),
            )

        box_HR_recovery_thresh.update(
            YELLOW, BLACK, "HR recover: {:#.2F} %".format(HR_recovery_thresh)
        )
        box_BPM_recovery_thresh.update(
            YELLOW, BLACK, "BPM recover: {:#.2F} %".format(BPM_recovery_thresh)
        )
        box_avgBPM_thresh.update(
            YELLOW, BLACK, "avg BPM: {:#.1F} bpm".format(filt_crit_Dict["avgBPM"])
        )
        box_cvTT_thresh.update(
            YELLOW, BLACK, "CV TT: {:#.2F} ratio".format(filt_crit_Dict["cvTT"])
        )
        box_avgHR_thresh.update(
            YELLOW, BLACK, "avg HR: {:#.1F} bpm".format(filt_crit_Dict["avgHR"])
        )
        box_avgRR_thresh.update(
            YELLOW, BLACK, "avg RR: {:#.1F} ms".format(filt_crit_Dict["avgRR"])
        )
        box_cvRR_thresh.update(
            YELLOW, BLACK, "CV RR: {:#.2F} ratio".format(filt_crit_Dict["cvRR"])
        )
        box_BSD_thresh.update(
            YELLOW, BLACK, "Base Drift: {:#.2F} V".format(filt_crit_Dict["BSD"])
        )
        box_DVTV_thresh.update(
            YELLOW, BLACK, "DVTV: {:#.2F} ratio".format(filt_crit_Dict["DVTV"])
        )
        box_QB_duration.update(
            YELLOW, BLACK, "min QB: {:#.1F} sec".format(QB_minimum_duration)
        )

        box_stream_lag.update(BACKGROUND_COLOR, RED, "{:#.3F}".format(stream_lag))
        box_duration.update(BLACK, RED, "{:#.3F} sec".format(REL_TIMER))

        sprite_list.draw(DISPLAYSURF)
        # update from stream
        # get data
        try:
            cur_time = datetime.now()
            elapsed_time = cur_time - sdr.start
            elapsed_time_sec = (
                elapsed_time.days * 24 * 60 * 60
                + elapsed_time.seconds
                + elapsed_time.microseconds / 1000000
            )
            stream_lag = elapsed_time_sec - REL_TIMER - missed / 1000
            if prev_Mode != Current_Mode:
                elapsed_time_sec = 0  # used to catch lag of sdr.start update for autoadvance of segment - should prevent accidental premature 'finish' unless lag from thread is more than 1 loop iteration
        except:
            print("no lag")
            elapsed_time_sec = 0  # added to deal with startup error - sdr seems to not start on first loop?
            stream_lag = 0

        try:

            # Pull results out of the Queue in a blocking manner.
            result = sdr.data.get(True, 1)

            # If there were errors, print that.
            if result["errors"] != 0:
                errors += result["errors"]
                errlist.append(result["errors"])
                missed += result["missed"]
                print(
                    "+++++ Total Errors: %s, Total Missed: %s +++++" % (errors, missed)
                )

            # Convert the raw bytes (result['result']) to voltage data.
            r = d.processStreamData(result["result"])

            ## save the data
            if Mode_dict[Current_Mode] in savable_modes:
                if Current_Mode != prev_Mode:

                    header = [
                        "baseline flow:{}".format(baseline_flow),
                        "thresh flow:{}".format(thresh_flow),
                        "baseline_ecg:{}".format(baseline_ecg),
                        "absthresh_ecg:{}".format(absthresh_ecg),
                        "thresh_ecg1:{}".format(thresh_ecg1),
                        "thresh_ecg2:{}".format(thresh_ecg2),
                        "noise_ecg:{}".format(noise_ecg),
                        "HR_recovery_thresh:{}".format(HR_recovery_thresh),
                        "minimum_resus_time:{}".format(minimum_resus_time),
                        "recovery_increment:{}".format(recovery_increment),
                        "SLB_Trigger:{}".format(SLB_Trigger),
                        "CALL_DEATH_Trigger:{}".format(CALL_DEATH_trigger),
                        "QB_minimum_duration:{}".format(QB_minimum_duration),
                        "filt_crit_Dict:{}".format(filt_crit_Dict),
                        "version_info:{} - {}".format(__version__, __git_status__),
                    ]
                    colheader = "\t".join(
                        ["time"] + CHANNEL_KEY + ["labjack_temp", "mode", "statuscodes"]
                    )
                    header.append(colheader)

                    saveCapturedData(OUTPUTFILE, header)
                # %%
                # writingblock=[]
                with open(OUTPUTFILE, "a") as oof:
                    for j in range(len(r["AIN{}".format(CHANNEL_LIST[0])])):

                        wb_row = [REL_TIMER]
                        REL_TIMER = round(REL_TIMER + 1 / SCAN_FREQUENCY, 3)
                        for i in ["AIN{}".format(i) for i in CHANNEL_LIST]:
                            wb_row.append(round(r[i][j], 6))
                        wb_row.append(round(CT_value, 6))
                        wb_row.append(Mode_dict[Current_Mode])
                        wb_row.append(cur_STATUS_Dict)
                        if Arduino_Dump_Toggle == 1:
                            wb_row.append(",".join(arduino_list))
                            Arduino_Dump_Toggle = 0
                        oof.write("\t".join([str(i) for i in wb_row]) + "\n")
                # %%
            else:
                for j in range(len(r["AIN{}".format(CHANNEL_LIST[0])])):
                    REL_TIMER = round(REL_TIMER + 1 / SCAN_FREQUENCY, 3)

            # prep data for graphing
            g1_app_ctr = 0
            downsample_rate1 = 20
            g3_app_ctr = 0
            downsample_rate3 = 1

            # for i in r['AIN{}'.format(CHANNEL_LIST[CHANNEL_DICT['FLOW']])]:
            #     g1_app_ctr+=1
            #     if g1_app_ctr%downsample_rate1==0:
            #         PreFilt_data1.append(i)
            #     else: continue
            Raw_data1 += r["AIN{}".format(CHANNEL_LIST[CHANNEL_DICT["FLOW"]])]
            Raw_data1 = Raw_data1[-10000:]
            PreFilt_data1 = Raw_data1[-7500::downsample_rate1]

            Raw_data3 += r["AIN{}".format(CHANNEL_LIST[CHANNEL_DICT["ECG"]])]
            Raw_data3 = Raw_data3[-10000:]
            PreFilt_data3 = Raw_data3[-5000::downsample_rate3]

            # for i in r['AIN{}'.format(CHANNEL_LIST[CHANNEL_DICT['ECG']])]:
            #     g3_app_ctr+=1
            #     if g3_app_ctr%downsample_rate3==0:
            #         PreFilt_data3.append(i)
            ##crop the data (7.5 seconds)
            # PreFilt_data1=PreFilt_data1[-375:] #50Hz * 7.5s
            # PreFilt_data3=PreFilt_data3[-1500:] #500Hz * 3s#minimize buffer of prefilt data to help with lag

            ##filter data and sample for calling
            if pleth_filt_state == 0:
                if INVERT_FLOW == 0:
                    data1 = list(PreFilt_data1)[-250:]
                else:
                    data1 = [i * -1 for i in list(PreFilt_data1)[-250:]]
                PLETHFILT_TOGGLE.update(RED, BLACK, "PLETH FILTER OFF")
            else:
                if INVERT_FLOW == 0:
                    data1 = list(butterFilt(PreFilt_data1, 50))[-250:]
                else:
                    data1 = list(butterFilt([i * -1 for i in list(PreFilt_data1)], 50))[
                        -250:
                    ]

                PLETHFILT_TOGGLE.update(GREEN, BLACK, "PLETH FILTER ON")

            if ecg_filt_state == 1:
                ECGFILT_TOGGLE.update(GREEN, BLACK, "ECG FILTER ON")
                if INVERT_ECG == 0:
                    data3 = list(basicFilt(PreFilt_data3, 1000, 60, 30))[-2501:-1:1]  #
                else:
                    data3 = [
                        i * -1
                        for i in list(basicFilt(PreFilt_data3, 1000, 60, 30))[
                            -2501:-1:1
                        ]
                    ]
            else:
                ECGFILT_TOGGLE.update(RED, BLACK, "ECG FILTER OFF")
                if INVERT_ECG == 0:
                    data3 = PreFilt_data3[-2501:-1:1]
                else:
                    data3 = [i * -1 for i in PreFilt_data3[-2501:-1:1]]

            # 5 second ts window
            ts1 = [
                i / 1000 + 20 / 1000
                for i in range(
                    int(round((REL_TIMER - 5) * 1000, 3)),
                    int(REL_TIMER * 1000),
                    downsample_rate1,
                )
            ]  # this may need adjusting if frequency is changed
            ts3 = [
                i / 1000 + 1 / 1000
                for i in range(
                    int(round((REL_TIMER - 2.5) * 1000, 3)),
                    int(REL_TIMER * 1000),
                    downsample_rate3,
                )
            ]

            # reset annotation marks to green
            Annot_Color = GREEN

            if Challenge_Toggle == 1:
                Annot_Color = VIOLET
                # depreciated requirement for thresh2 to have been crossed to utilize - too likely to have error of missing apnea
                # if max(data1)>=thresh2_flow and (datetime.now()-Challenge_Timer).seconds>=Challenge_Delay:

                # check if transition to thresh2 is needed
                if (datetime.now() - Challenge_Timer).seconds >= Challenge_Delay:
                    Challenge_Toggle = 2
                    print("violet stopped")
                    print((datetime.now() - Challenge_Timer).seconds)

            if (
                cur_STATUS_Dict["challenge gas"] == 1 and Challenge_Toggle == 2
            ):  # !!! this will need to be replaced with gas verify variable from serial io
                BreathCalls = basic_breathcall(data1, ts1, baseline_flow, thresh2_flow)
                # change marks to red when thresh 2 in use
                Annot_Color = RED
            elif (
                cur_STATUS_Dict["challenge air"] == 1
                and gasp_detected == 0
                and current_recovery > SLB_Trigger
            ):
                BreathCalls = basic_breathcall(data1, ts1, baseline_flow, thresh2_flow)
                # change marks to red when thresh 2 in use
                Annot_Color = RED
                if len(BreathCalls) >= 1:
                    gasp_detected = 1
                    if logger:
                        logger.info("gasp detected")
                    serial_list.append("gasp detected")
            else:
                BreathCalls = basic_breathcall(data1, ts1, baseline_flow, thresh_flow)
                # Annot_Color=GREEN
            if BreathCalls is None or len(BreathCalls) < 2:
                avgBPM = "<12"
                # avgPIF='-----'
                avgTV = "-----"
                avgTT = 999
                CV_TT = 999
                avgDVTV = 999

            else:
                avgTT = numpy.average(
                    [
                        BreathCalls[i]["TI"] + BreathCalls[i]["TE"]
                        for i in BreathCalls
                        if "TE" in BreathCalls[i].keys()
                    ]
                )  # note this needs to be scaled from index to time (1000Hz/20[downscale value])
                CV_TT = (
                    numpy.std(
                        [
                            BreathCalls[i]["TI"] + BreathCalls[i]["TE"]
                            for i in BreathCalls
                            if "TE" in BreathCalls[i].keys()
                        ]
                    )
                    / avgTT
                )
                avgTV = "{:#.3F}V/s".format(
                    numpy.average(
                        [
                            BreathCalls[i]["iTV"]
                            for i in BreathCalls
                            if "TE" in BreathCalls[i].keys()
                        ]
                    )
                )
                avgBPM = "{:#.1F}".format(
                    60 / avgTT
                )  # this creates a 'less' transformed BPM (division transform) - relationship between TT and BPM modified by Irregularity
                # avgPIF='{:#.2F}V/s'.format(numpy.average([BreathCalls[i]['PIF'] for i in BreathCalls if 'TE' in BreathCalls[i].keys()]))
                avgDVTV = numpy.average(
                    [
                        BreathCalls[i]["DVTV"]
                        for i in BreathCalls
                        if "TE" in BreathCalls[i].keys()
                    ]
                )

            BL = list(BreathCalls.keys())
            BL.sort()
            vol_lines = {}
            for i in range(len(BL[:-1])):
                vol_lines[i] = {
                    "ts": [
                        BreathCalls[BL[i]]["TS-I"],
                        BreathCalls[BL[i]]["TS-E"],
                        BreathCalls[BL[i + 1]]["TS-I"],
                    ],
                    "vol": [
                        0,
                        BreathCalls[BL[i]]["iTV"],
                        BreathCalls[BL[i]]["iTV"] - BreathCalls[BL[i]]["eTV"],
                    ],
                }

            if len(vol_lines) != 0:
                vol_lines_graphed = []
            for l in vol_lines:
                vol_scaled = graphScaler(
                    g2_TL,
                    g2_xySize,
                    (ts1[0], ts1[-1]),
                    g2_y_minmax,
                    vol_lines[l]["ts"],
                    vol_lines[l]["vol"],
                )
                vol_lines_graphed.append(
                    pygame.draw.lines(
                        DISPLAYSURF,
                        BLUE,
                        False,
                        [(int(p[0]), int(p[1])) for p in vol_scaled],
                    )
                )

            # BeatCalls=basicRR(data3,ts3,noise_ecg,thresh_ecg1,absthresh_ecg,3)
            # if BeatCalls is None or len(BeatCalls)<5 :
            #     BeatCalls=basicRR(data3,ts3,noise_ecg,thresh_ecg2,absthresh_ecg,3)

            BeatCalls = beat_caller(
                data3, ts3, absthresh=absthresh_ecg, minRR=minRR_ecg
            )

            if BeatCalls is None or len(BeatCalls) < 5:
                avgHR = "<60"
                avgRR = 999
                CV_RR = 999
            else:
                # avgRR=numpy.average([BeatCalls[i]['RR'] for i in BeatCalls])
                # avgHR='{:#.1F}'.format(60/avgRR)
                # CV_RR=numpy.std([BeatCalls[i]['RR'] for i in BeatCalls])/avgRR
                avgRR = BeatCalls["rr"].mean()
                avgHR = "{:#.1F}".format(60 / avgRR)
                CV_RR = BeatCalls["rr"].std() / avgRR

            BL = list(BreathCalls.keys())
            BL.sort()

            # HL=list(BeatCalls.keys())
            # HL.sort()
            HL = list(BeatCalls["ts"])

            if len(BreathCalls) > 0:
                LastBreath = BL[-1]
            if prev_Mode != Current_Mode:
                LastBreath = 0

            SinceLastBreath = elapsed_time_sec - LastBreath
            if SinceLastBreath >= CALL_DEATH_trigger:

                if logger:
                    logger.info("Since Last Breath  >= Call_Death")

            if (
                Mode_dict[Current_Mode] == "Challenge"
                and SinceLastBreath <= SLB_Trigger
            ):
                slb_COLOR = GREEN

            elif (
                Mode_dict[Current_Mode] == "Challenge" and SinceLastBreath > SLB_Trigger
            ):
                slb_COLOR = RED

            else:
                slb_COLOR = BLACK
                slb_COLOR2 = WHITE
            BSD = abs(numpy.average(data1[::10]) - baseline_flow)

            # check if in 'good recording section'
            filt_test_Dict = {
                "avgBPM": 60 / avgTT,
                "cvTT": CV_TT,
                "avgHR": 60 / avgRR,
                "avgRR": avgRR,
                "cvRR": CV_RR,
                "BSD": BSD,
                "DVTV": avgDVTV,
            }

            exclude = []
            for i in filt_crit_Dict:
                if filt_crit_Dict[i] < filt_test_Dict[i]:
                    exclude.append(i)
            if len(exclude) >= 1:
                quality_test = 0
                QualColor = RED
            else:
                quality_test = 1
                QualColor = GREEN

            box_qual_test.update(QualColor, BLACK, " ".join(exclude))
            # !!! for multi baseline experiment - this section may need to be addressed
            # !!! can this information be addressed in a config file
            if Mode_dict[Current_Mode] == "Baseline" and prev_Mode != Current_Mode:
                RunningBreaths = []
                RunningBeats = {"ts": [], "rr": []}
                quality_seg_list = []
            if Mode_dict[Current_Mode] == "Baseline":
                # populate quality segment list
                if quality_test == 1 and prev_qual_test == 0:
                    QB_TIMER = REL_TIMER
                    quality_seg_list.append([QB_TIMER, REL_TIMER])
                if quality_test == 1 and prev_qual_test == 1:
                    if len(quality_seg_list) == 0:
                        quality_seg_list.append([QB_TIMER, REL_TIMER])
                    quality_seg_list[-1][1] = REL_TIMER
                if quality_test == 0 and prev_qual_test == 1:
                    if REL_TIMER - QB_TIMER >= QB_minimum_duration:
                        QB_Counter += 1
                        QB_duration += REL_TIMER - QB_TIMER

                for i in BL:
                    if "TE" in BreathCalls[i].keys():

                        if len(RunningBreaths) == 0:
                            RunningBreaths.append(BreathCalls[i])

                        elif i > RunningBreaths[-1]["TS-I"]:
                            RunningBreaths.append(BreathCalls[i])

                if len(RunningBeats["ts"]) == 0:
                    RunningBeats["ts"] += list(BeatCalls["ts"])
                    RunningBeats["rr"] += list(BeatCalls["rr"])

                else:
                    ts_last_update = RunningBeats["ts"][-1]
                    RunningBeats["ts"] += list(
                        BeatCalls[BeatCalls["ts"] > ts_last_update]["ts"]
                    )
                    RunningBeats["rr"] += list(
                        BeatCalls[BeatCalls["ts"] > ts_last_update]["rr"]
                    )

                # for i in HL:
                #     if len(RunningBeats)==0:
                #         RunningBeats.append({'ts':i,'BC':BeatCalls[i]})

                #     elif i>RunningBeats[-1]['ts']:
                #         RunningBeats.append({'ts':i,'BC':BeatCalls[i]})

            prev_qual_test = int(quality_test)
            # filter to the good breaths and summarize stats
            # %%
            if Mode_dict[Current_Mode] == "Challenge" and prev_Mode != Current_Mode:
                Q_breaths = []
                Q_beats = {"rr": []}
                QB_Counter = 0
                QB_duration = 0
                for i, j in quality_seg_list:
                    if j - i < QB_minimum_duration:
                        continue
                    QB_Counter += 1
                    QB_duration += j - i
                    for k in RunningBreaths:
                        if k["TS-I"] > i and k["TS-I"] < j:
                            Q_breaths.append(k)

                    for k, v in enumerate(RunningBeats["ts"]):
                        # if k['ts']>i and k['ts']<j:
                        if v > i and v < j:
                            Q_beats["rr"].append(RunningBeats["rr"][k])

                baseTT = numpy.average(
                    [i["TI"] + i["TE"] for i in Q_breaths if "TE" in i.keys()]
                )
                baseBPM = 60 / baseTT
                baseTV = numpy.average([i["iTV"] for i in Q_breaths])
                # baseRR=numpy.average([i['BC']['RR'] for i in Q_beats])
                baseRR = numpy.average(Q_beats["rr"])
                baseHR = 60 / baseRR

                box_baseBPM.update(GREEN, BLACK, "base BPM:{:#.1F}".format(baseBPM))
                box_baseTV.update(GREEN, BLACK, "base TV:{:#.2F}".format(baseTV))
                box_baseHR.update(GREEN, BLACK, "base HR:{:#.1F}".format(baseHR))
            # %% reset voltages if no longer in challenge mode
            if Mode_dict[Current_Mode] != "Challenge":
                cur_STATUS_Dict["challenge air"] = 0
                cur_STATUS_Dict["challenge gas"] = 0

            # %% add timer for minimum resus time
            if Mode_dict[Current_Mode] == "Challenge":

                if cur_STATUS_Dict["challenge air"] == 1:
                    rec_duration = (
                        cur_time - cur_STATUS_Dict["pulse"]["challenge air"]["start"]
                    )
                    current_recovery = rec_duration.seconds

                    # !!! check for sustained recovery !!!
                    if (
                        SinceLastBreath <= SLB_Trigger
                        and 60 / avgTT >= baseBPM * BPM_recovery_thresh / 100
                        and (
                            60 / avgRR >= baseHR * HR_recovery_thresh / 100
                            or HR_recovery_thresh == 0
                        )
                    ):
                        if sustained_recovery_flag == 0:
                            sustained_recovery_flag = 1
                            sustained_recovery_start = datetime.now()
                        sustained_recovery = (
                            datetime.now() - sustained_recovery_start
                        ).seconds

                        accumulated_recovery = (
                            sustained_recovery + prev_accumulated_recovery
                        )
                        if current_maximum_sustained_recovery_bout < sustained_recovery:
                            current_maximum_sustained_recovery_bout = sustained_recovery

                        if (
                            current_maximum_sustained_recovery_bout
                            >= minimum_sustained_recovery
                            and consecutive_sustained_recovery_toggle == 0
                        ):
                            if logger:
                                logger.info("sustained recovery detected")
                            serial_list.append("sustained recovery detected")
                            consecutive_sustained_recovery_toggle = 1
                        if (
                            accumulated_recovery >= minimum_sustained_recovery
                            and accumulated_sustained_recovery_toggle == 0
                        ):
                            if logger:
                                logger.info("accumulated recovery detected")
                            serial_list.append("accumulated recovery detected")
                            accumulated_sustained_recovery_toggle = 1
                    else:
                        sustained_recovery_flag = 0
                        prev_accumulated_recovery += sustained_recovery
                        sustained_recovery = 0
                    # !!! increment minimum recovery if mouse not in sustained recovery
                    if (
                        current_recovery >= current_minimum_resus_time
                        and current_maximum_sustained_recovery_bout
                        <= minimum_sustained_recovery
                    ):
                        current_minimum_resus_time += recovery_increment
                        serial_list.append(
                            "animal not in sustained recovery. {} seconds added.".format(
                                recovery_increment
                            )
                        )
                        if logger:
                            logger.info(
                                "animal not yet reached sustained recovery. {} seconds added.".format(
                                    recovery_increment
                                )
                            )
                elif cur_STATUS_Dict["challenge gas"] == 1:
                    current_recovery = float(minimum_resus_time)
                    current_minimum_resus_time = float(minimum_resus_time)
                    sustained_recovery = 0
                    current_maximum_sustained_recovery_bout = 0
                    accumulated_recovery = 0
                    prev_accumulated_recovery = 0
                    accumulated_sustained_recovery_toggle = 0
                    consecutive_sustained_recovery_toggle = 0

            else:
                current_recovery = float(minimum_resus_time)
                current_minimum_resus_time = float(minimum_resus_time)
                sustained_recovery = float(minimum_sustained_recovery)

            if current_recovery >= current_minimum_resus_time:
                MRT_color = GREEN
            elif current_recovery >= current_minimum_resus_time - 10:
                MRT_color = YELLOW
            else:
                MRT_color = RED

            box_minimum_resus_time.update(
                MRT_color,
                BLACK,
                "RECOVERY:{:#d}/{:#d})".format(
                    int(current_recovery), int(current_minimum_resus_time)
                ),
            )

            box_qual_bouts.update(YELLOW, BLACK, "bouts:{}".format(QB_Counter))
            box_qual_dur.update(YELLOW, BLACK, "duration:{:#.1F}".format(QB_duration))
            # updated unused boxes for demo video
            try:
                box_CT.update(
                    WHITE,
                    BLUE,
                    "RT:{:#.1F}C|Pi:{:#.1F}C".format(
                        CT_value, CPUTemperature().temperature
                    ),
                )  # see note abot regarding labjack internal temp
            except:
                box_CT.update(
                    WHITE, BLUE, "RT:{:#.1F}C|Pi:{}".format(CT_value, "unk")
                )  # see note abot regarding labjack internal temp
            box_BT.update(
                RED,
                BLACK,
                "CT: {:#.1F}C".format(
                    1000 * numpy.average(r["AIN{}".format(CHANNEL_DICT["BT"])])
                ),
            )
            box_RH.update(
                BLACK,
                BLACK,
                "RH: {:#.2F}V".format(
                    numpy.average(r["AIN{}".format(CHANNEL_DICT["RH"])])
                ),
            )
            box_O2.update(
                BLACK,
                BLACK,
                "O2: {:#.2F}V".format(
                    numpy.average(r["AIN{}".format(CHANNEL_DICT["O2"])])
                ),
            )
            box_CO2.update(
                BLACK,
                BLACK,
                "CO2: {:#.2F}V".format(
                    numpy.average(r["AIN{}".format(CHANNEL_DICT["CO2"])])
                ),
            )
            box_BPM.update(BLUE, WHITE, "BPM: {}".format(avgBPM))
            if Mode_dict[Current_Mode] == "Challenge":
                if 60 / avgRR >= baseHR * HR_recovery_thresh / 100:
                    box_HR_color = GREEN
                else:
                    box_HR_color = RED

                if 60 / avgTT >= baseBPM * BPM_recovery_thresh / 100:
                    box_BPM_color = GREEN
                else:
                    box_BPM_color = RED
            else:
                box_HR_color = BLUE
                box_BPM_color = BLUE

            box_HR.update(box_HR_color, WHITE, "HR: {}".format(avgHR))
            box_BPM.update(box_BPM_color, WHITE, "BPM: {}".format(avgBPM))

            box_TV.update(BLUE, WHITE, "TV: {}".format(avgTV))
            box_sincelastbreath.update(
                slb_COLOR2, slb_COLOR, "SLB: {:#.2F}sec".format(SinceLastBreath)
            )

        # % stream errors and exiting
        except Queue.Empty:
            if logger:
                logger.warning("empty Q")
            pass

        data1_graphed = graphScaler(
            g1_TL, g1_xySize, (ts1[0], ts1[-1]), g1_y_minmax, ts1[:], data1[:]
        )  # resolution re-upscaled formerly [::2]
        baseline1_graphed = graphScaler(
            g1_TL,
            g1_xySize,
            (0, 1),
            g1_y_minmax,
            [0, 1],
            [baseline_flow, baseline_flow],
        )  # update to baseline variable
        thresh1_graphed = graphScaler(
            g1_TL, g1_xySize, (0, 1), g1_y_minmax, [0, 1], [thresh_flow, thresh_flow]
        )  # update to thresh variable
        thresh2flow_graphed = graphScaler(
            g1_TL, g1_xySize, (0, 1), g1_y_minmax, [0, 1], [thresh2_flow, thresh2_flow]
        )

        baseline2_graphed = graphScaler(
            g2_TL, g2_xySize, (0, 1), g2_y_minmax, [0, 1], [baseline_vol, baseline_vol]
        )  # update to baseline variable
        thresh2_graphed = graphScaler(
            g2_TL, g2_xySize, (0, 1), g2_y_minmax, [0, 1], [thresh_vol, thresh_vol]
        )  # update to thresh variable

        data3_graphed = graphScaler(
            g3_TL, g3_xySize, (ts3[0], ts3[-1]), g3_y_minmax, ts3[::2], data3[::2]
        )  # update this

        baseline3_graphed = graphScaler(
            g3_TL, g3_xySize, (0, 1), g3_y_minmax, [0, 1], [baseline_ecg, baseline_ecg]
        )  # update to baseline variable
        thresh3_graphed = graphScaler(
            g3_TL,
            g3_xySize,
            (0, 1),
            g3_y_minmax,
            [0, 1],
            [absthresh_ecg, absthresh_ecg],
        )  # update to thresh variable
        ##

        d_graph1 = pygame.draw.lines(
            DISPLAYSURF, BLUE, False, [(int(p[0]), int(p[1])) for p in data1_graphed]
        )
        base1 = pygame.draw.lines(
            DISPLAYSURF,
            BLACK,
            False,
            [(int(p[0]), int(p[1])) for p in baseline1_graphed],
        )
        thresh1 = pygame.draw.lines(
            DISPLAYSURF, RED, False, [(int(p[0]), int(p[1])) for p in thresh1_graphed]
        )
        thresh2flow = pygame.draw.lines(
            DISPLAYSURF,
            GREEN,
            False,
            [(int(p[0]), int(p[1])) for p in thresh2flow_graphed],
        )

        base2 = pygame.draw.lines(
            DISPLAYSURF,
            BLACK,
            False,
            [(int(p[0]), int(p[1])) for p in baseline2_graphed],
        )
        thresh2 = pygame.draw.lines(
            DISPLAYSURF, RED, False, [(int(p[0]), int(p[1])) for p in thresh2_graphed]
        )
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
