MolecularNeurobiology/LOOPER/(commit log)

2022-01-31 Add files via upload
    original and updated Arduino code
2022-02-02 added arduino search, hardcoded new modes for prechallenge injection, added comments for some candidate sections for extraction to config file
2022-02-02 fixed typo in setting default Mode_Dict
    [PCC.py]
2022-02-02 relaxed 'save lock'
    [PCC_Config.xlsx]
2022-02-02 removed old version of Arduino code (already backed up in release-001
2022-02-11 labjack reset added, gpio workaround for no RPi testing
    added code to test if labjack stream left running due to bad exit and reset if needed, added try/excpt to handle gpiozero error when testing code on non-RPi system
    [PCC.py]
2022-02-11 added second habituation
    added additional mode/block, minor edit to GUI to permit view of current mode/blocks, moved invert and filt toggles
    [PCC.py]
2022-02-12 updates for co2 timer and challenge delay etc
    co2 timer, challenge delay, challenge phrase, and updates from "old v45" that were missed in the update to v42.0.0
    [PCC.py]
2022-02-15 fix for co2 timer
    [PCC.py]
2022-02-19 revert to prior release-001 version
    release-001 was accidentally updated - this should revert back to the release-001 version
    [PCC.py]
2022-02-23 logging and constants removed - might be broke
    [CONSTANTS.py, PCC.py]
2022-02-23 mqtt test and gui fix
    [CONSTANTS.py, GUI.py, PCC.py]
2022-02-24 fix for files unable to process due to disrupted row - likely timing conflict with arduino and labjack comms
2022-02-25 Add files via upload
    updated arduino code with condensed serial.print commands
2022-08-25 updates to PCC re issue #33
    [CONSTANTS.py, GEMouse.py, PCC.py]
2022-08-25 quick bugfixes
    removed problematic whitespace following line return. update for baseHR display added
    [CONSTANTS.py, PCC.py]
2022-08-26 updated GEMouse v1.0.1 QOL and bugfixes applied
    [GEMouse.py]
2022-08-27 bugfixes from on rig testing
    extended baseline seems to work (though gui not sure if gui counter of QB duration is accurate or overcounting?)
    alternative recovery detection appears to work
    expanded logging of gasp and recovery seem to work
    GEMouse troubleshooting for Raspberry Pi QT (color response and RPi pin in/out), main features appear complete. additional feature to skip and revert state in a cycle program would be a good future addition along with an option to load settings from a file.
    [CONSTANTS.py, GEMouse.py, PCC.py]
2022-09-27 draft version of SHAM functional
    ready for feedback and additional testing. current limit appears to be the HR detection, revision to ECG analyzer likely needed - redo file add
2022-09-29 added example metadata and settings for analysis
    [automated metadata.csv, basic_pneumo.csv]
2022-10-04 added subset of time and annotations
    added ability to shift time of region plotted, markers for atores timestamps, derived filters from basspro output
2022-10-17 added HR and ISHR ISRR to python module output, updated Trace_Viewer header
2023-03-10 Ccac gui2 (#54)
    * added toolbar functionality
    * gui console logging, and threading implemented
2024-01-08 purge deprecated files
    [automated metadata.csv, basic_pneumo.csv]
2024-01-09 Updated arduino code and added PCB code.
    [RAY_shield_V4.brd, RAY_shield_V4.sch]
2024-02-15 bugfix, find_peaks needed reference to signal module
    [PCC.py]
2024-02-15 added pin reading display feature to troubleshoot gemouse
2024-02-15 bugfixes for GEMouse and PCC
    GEMouse updated round counter to better match round of death (prior code had animal die 1 round earlier than the current challenge number). PCC updated for bugfixes to incorporate new beat caller logic, fixes to indexing into RunningBeats and accumulation of RunningBeats. Also fixed warnings for pygame plotting of float values, and reduced noise from print messages
    [GEMouse.py, PCC.py]
2024-02-15 update to default settings of beat_caller to match those currently implemented in the 3.12 compatible SASSI with the new beatcaller
2024-02-21 Update PCC.py
    bugfix in beatcaller minrr instead on minrr_ecg
    [PCC.py]
2024-03-04 prototype ready for pi testing
2024-03-06 Rsync.sh
    Code that is currently on the Rig's
2024-04-18 bugfixes for fm writing
    [PCC.py]
2024-05-07 bugfix for number on rig, added rig_clean_up script
    [PCC.py, fm_tools.py, rig_clean_up.py]
2024-06-04 bugfix datetime in rig_clean_up
    [rig_clean_up.py]
2024-07-30 bugfix to avoid searching 'hidden folders'
    [rig_clean_up.py]
2024-10-04 added module for loading and saving settings
    [template_settings.csv]
2024-12-06 bugfix for rig_clean_up.py. filter fm returns by delete status
    [rig_clean_up.py]
2024-12-15 labjack sim stream and plotting flow+ecg
2024-12-17 add kill command line argument and other things
    also added folders to stage development on docker and ansible development, updated STREAMS to include arduino finding feature
2025-01-24 serial i/o sim and placeholders for stage selection
2025-01-25 starting implementation of STAGES progression
2025-01-30 bugfix stage automation, added time in stage to gui
2025-02-11 bugfix for deleterecord using lowercase yes
    [rig_clean_up.py]
2025-03-28 wip black formatting and stages update
2025-04-07 added basic event loop for calibration
2025-04-09 wip updating remaining stages
2025-05-02 raspi arduino comtest
2025-06-06 bugfix for arduino byte string parsing, tweaks to stage end detection, bugfix for baseline calm detection
2025-06-11 fm related script testing
    [fm_auto_dump.csv]
2025-06-27 seperated lj and arduino sim settings
2025-06-27 arduino integration testing
2025-06-30 quick buttons for arduino troubleshooting
2025-06-30 bugfix, case sensitive arduino commands
2025-07-02 added 4 arduino quick command buttons
2025-07-07 bugfix arduino commands
2025-07-23 disabled, commented out some debug printing/logging
2025-07-23 added quick arduino calibration buttons
2025-07-28 tweak colors for arduino quick cal buttons
2025-07-29 Filters None values in timestamp data
    Ensures only valid numeric timestamp values are used
    when generating timestamp signal data.
    This prevents potential errors and unexpected behavior
    caused by None or non-numeric values during data
    processing.
2025-08-07 bugfix beat_caller index out of range due to bad downsample still present in TS variable
    [PCC.py]
2025-08-07 bugfix GEMouse, delay_for_trigger logic value used before declared if testing hypervent
    [GEMouse.py]
2025-08-07 remove print call in beat_caller
2025-08-07 pin sensing pullup false bugfix
    [GEMouse.py]
2025-08-11 updated stages content
2025-08-14 button fixes for arduino testing
2025-08-18 implementation of challenge stage...some debugging still needed
2025-08-18 bugfix for challenge recovery detect, and baseline quality timer starting negative
2025-08-18 bugfix, dio pulse timer
2025-08-19 implemented stage declaration of payload data
2025-08-19 Adds duration signal type
    Adds a duration signal type with duration and severity levels to the Minerva plugin.
    This enhancement allows the simulation to send duration-based signals with associated severity, providing more detailed information on the state of the simulated system. Includes example duration signals with countdown timers in the simulation.
2025-08-19 reload from new settings/stages
2025-08-28 Fix payload generation
    Adds dynamic rate control to the streaming system based on client performance metrics. This helps to optimize the streaming experience by adjusting the streaming rate in response to client-side rendering time, memory usage, frame rate, and dropped frames. The system increases the rate when performance is good and decreases it when performance degrades. This implementation replaces the previous single-rate streaming approach with an adaptive system that provides a better user experience.
    Also includes enhancements to time series data handling in the data payload, incorporating dynamic time window calculations with padding for improved visualization. A fallback mechanis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
2025-09-17 Improves plugin performance and stability
    Addresses performance bottlenecks and stability issues within the plugin.
    - Implements adaptive streaming rate control based on command
    processing time to prevent resource exhaustion. Adjusts the
    streaming rate dynamically, reducing it when commands take longer
    to process and increasing it when commands are processed quickly.
    - Introduces a dedicated command consumer with a separate connection
    for priority handling of critical commands, preventing blocking
    during streaming.
    - Optimizes RabbitMQ client by declaring queues only once per
    connection instead of for every message, reducing overhead. Switches
    to non-blocking message consump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
2025-10-01 latest code with ball housing fixed
    [Rig_ballhounsing_main.ino, Rig_ballhounsing_switch_test.ino, Rig_ballhounsing_test.ino]
2025-10-21 Revert "Dev"
    [fm_auto_dump.csv, template_settings.csv]
2025-12-19 prep for pub release
    [PCC_Config.xlsx]
2025-12-19 prune arduino code
2026-01-27 fix ballhousing bellhousing type
    [Rig_ballhounsing_main.ino, Rig_ballhounsing_switch_test.ino, Rig_ballhounsing_test.ino]
